johonkanen/efinix_soc_board/README.md

# efinix_soc_board

Linux-capable control card for an AC in/out lab power supply, based on the **Efinix Titanium Ti135N484I3** FPGA. The
FPGA's hardened quad-core RISC-V runs Linux, with 1 GB LPDDR4, Gigabit Ethernet and eMMC. The card plugs into the
power supply baseboard ([ac_psu_kicad](https://github.com/johonkanen/ac_psu_kicad)) in place of the earlier Ti60F225
and Agilex 5 cards.

Status: schematic in progress. See **[STATUS.md](STATUS.md)** for where the work stands and what comes next.

| | |
|---|---|
| [MIGRATION_PLAN.md](MIGRATION_PLAN.md) | plan and decisions |
| [TI135_PCB_NOTES.md](TI135_PCB_NOTES.md) | Ti135 PCB design rules (banks, sequencing, configuration, LPDDR4) |
| [MECHANICAL.md](MECHANICAL.md) | outline and baseboard connector positions |
| [POWER_BUDGET.md](POWER_BUDGET.md) | power estimate and regulators |

The KiCad 10 project in `kicad/` is generated by scripts (`tools/build_schematic.sh`), using
[proteus2kicad](https://github.com/johonkanen/proteus2kicad) as a submodule in `tools/p2k`.

## Board

<!-- board-plots:start -->
<!-- Generated by kicad-board-plots; edits between these markers are overwritten. -->

3D renders and copper layers of `kicad/ti135_card.kicad_pcb`, the layers in stack order without silkscreen. Plotted by [kicad-board-plots](https://github.com/johonkanen/kicad-board-plots) on each board change; the images live on the `renders` branch.

<table>
<tr>
<td align="center"><br><b>3D, top</b></td>
<td align="center"><br><b>3D, bottom (seen from below)</b></td>
</tr>
<tr>
<td align="center"><br><b>F.Cu: signal (top)</b></td>
<td align="center"><br><b>In1.Cu: GND plane</b></td>
</tr>
<tr>
<td align="center"><br><b>In2.Cu: signal, phy_avdd33 pour</b></td>
<td align="center"><br><b>In3.Cu: 1V1, VCORE, 3V3, GND planes</b></td>
</tr>
<tr>
<td align="center"><br><b>In4.Cu: 1V8, 0V85 planes</b></td>
<td align="center"><br><b>In5.Cu: signal</b></td>
</tr>
<tr>
<td align="center"><br><b>In6.Cu: GND plane</b></td>
<td align="center"><br><b>B.Cu: signal, 1V1, GND, Net-(U201-SW), 5V0, 1V8 and 9 more pours (bottom, seen from the top)</b></td>
</tr>
</table>

<!-- board-plots:end -->
