johonkanen/efinix_soc_board/NEXT_SESSION.md

# Next session plan (phases, 2026-10-27; phases 1–3 done)

**2026-11-01:** placement was since copied from the Agilex card and the planes reshaped; the current open list is
in `STATUS.md`, "Where we left off (2026-11-01)". The phase plan below predates that.

Written for an agent starting with a fresh context. Work **one phase at a time**: finish it, commit, push, update
this file and `STATUS.md`, then stop and report to the user, who reviews each phase before the next starts.

## Read first

- `STATUS.md`: what the card is, where everything stands, how to build.
- `HW_CHECKLIST_REVIEW.md`: Efinix's hardware checklist for this exact part (Ti135 N484, SPI x4) against the card.
- `TI135_PCB_NOTES.md`: device and layout rules (§6 LPDDR4: §6.3 routing rules, §6.5 stack-up, §6.7 BGA fan-out
  and decaps, §6.10 the 40 Ω routing and width fit).
- `KRT_LEARNING.md`: how to drive KiCadRoutingTools, its gotchas and possible bugs. Read before any routing.

## Rules (from the user; do not break)

- **Never modify `~/dev/agilex3_soc_control_card`** (another session owns it). Reading is fine. `tools/board_setup.py`
  copies the LPDDR4 rules from it; that is intended.
- **KiCad must be closed** before writing any file under `kicad/`. Check for `kicad/~ti135_card.kicad_pro.lck` and
  for board/schematic files newer than the last commit; if either, stop and ask.
- The user now edits the schematic **by hand** in KiCad: do NOT run `tools/build_schematic.sh` (it would overwrite
  the hand edits).
  A footprint change reaches the board with `tools/swap_footprint.py` (keeps nets, fields, schematic link).
- Efinix files (copyright) live in `reference/efinix/` (gitignored; only its README is in git).
- No silkscreen on this card beyond a few custom markings: ignore silkscreen DRC.
- Commit trailer (always):
  ```
  Co-Authored-By: Claude Opus 5.5 <noreply@anthropic.com>
  ```
  Push with plain `git push`. Ask the user before anything outward beyond that (orders, upstream bug reports).
- Keep `STATUS.md` and this file current at every stopping point.

## Decisions taken (user, 2026-10-27)

1. **LPDDR4 acceptance = the checklist's skew limits** (HW_CHECKLIST_REVIEW.md item 6): DQ/DM–DQS ≤ 75 ps,
   CK–DQS ≤ 350 ps, A/CKE/CS–CK ≤ 100 ps, die to die (package delays included). DQS P/N skew: aim ≤ 1.8 ps
   (user guide), report what is reached. Base: the routing on branch **`ddr-option2`** (DQ–DQS −24…+60 ps).
2. **U801 stays where it is.**
3. **Decoupling follows Efinix's table in full** (HW_CHECKLIST_REVIEW.md, "Decoupling").
4. One phase at a time, the user reviews each. The user may route parts of the memory by hand later.

## Tools (all in the repo)

| Task | Command |
|---|---|
| Build schematic / PCB checks | `tools/build_schematic.sh`; `tools/build_pcb.sh` (no `--rebuild`: that drops routing) |
| KiCad Python / CLI | `tools/p2k/bin/kipy script.py`; `tools/p2k/bin/kicad-cli`; `source tools/p2k/bin/kicad_env.sh` for `$KICAD_MOUNT` |
| KRT (router) | `~/dev/KiCadRoutingTools/.venv/bin/python -X utf8 ~/dev/KiCadRoutingTools/py_router/route.py ...`; always `KICAD_RIP_PREEXISTING=0` |
| DDR grade (refill, DRC, per-byte) | `tools/ddr/grade.sh NAME BOARD` → `work/grade/NAME/drc.rpt` |
| DDR timing / plan | `tools/p2k/bin/kipy tools/ddr/ddr_timing.py BOARD [--nets] [--plan FILE]` |
| Width fit, clearance repair | `tools/p2k/bin/kipy tools/ddr/widen.py IN OUT [--why]` (also nudges, splits at courtyards) |
| Meander top-up | `tools/ddr/polish.sh IN OUT` (`ONLY="ddr_dq9 ..."`); `tools/ddr/tune_meander.py` + `tune_apply.py` |
| Re-route a few DDR nets | `tools/ddr/reroute_nets.sh IN WORKDIR dq9 dm1` (`PAIR=1` for DQS pairs, `EXTRA="--rip-existing-nets ..."`) |
| Re-route bytes | `tools/ddr/byte_seq.sh` (`MODE=net NET_ORDER=far RIP_BYTES=..`); CA/CK: `tools/ddr/ca_tb_chain.sh` |
| Decaps on BGA via pairs | `tools/p2k/bin/kipy tools/place_bga_decaps.py IN OUT REF...` (smallest caps first) |
| Nearest free B.Cu spot | `tools/p2k/bin/kipy tools/place_free.py IN OUT REF[@X,Y[,ROT]]...` (bare REF: near its rail's U501 balls; used in phase 3) |
| Schematic → routed board | `tools/p2k/bin/kipy tools/add_parts.py IN OUT` (adds missing parts, syncs values/fields/pad nets; no copper touched) |
| Pictures | `tools/render_ddr.py BOARD OUT.png U501 U801`; `tools/render_board.py BOARD OUT.png` (KRT venv python) |
| IO routing sketch | `tools/io_sketch.sh IN WORKDIR` |
| Zone refill | `tools/p2k/bin/kipy work/grade/<any>/refill.py BOARD` (written by grade.sh) |
| JLC parts | `python3 -I tools/jlc/jlc_search.py "<keywords>"` |

Work on copies under `work/` (gitignored) and copy the result into `kicad/` only when it grades clean. DRC with
schematic parity must run on the board **in `kicad/`** (a copy elsewhere has no sub-sheets).

## Phase 1: LPDDR4 from `ddr-option2` onto main — **done 2026-10-27**

Result (on main, `kicad/ti135_card.kicad_pcb`):
- `tools/ddr/transplant.py` replaced main's LPDDR4 copper (2684 items, 139 vias) with option 2's (3569, 148 vias).
  Only clash: C528 (1 µF 0402, 0V85, B.Cu) sat on a `ddr_dq2` via; `place_bga_decaps.py C528` moved it 0.3 mm
  (+x). Nothing else changed outside the DDR copper (footprints, non-DDR tracks/vias, zones compared by script).
- `widen.py` changed nothing (option 2 was already fitted): **88 mm below the width minimum**, per net dq25 18.9,
  dm3 17.3, dq1 16.0, dq24 12.9, dm0 8.3, dq26 6.9, dm1 3.2, dq29 2.1, dq6 1.6, dq10 0.6 (KiCad: 199 `track_width`,
  capped; all `min`; one is dm3 below the 0.09 neck-down inside a BGA).
- DRC (`tools/build_pcb.sh`): schematic parity 0; non-DDR entries identical to main before the change; all DDR
  nets connected (615 unconnected items board-wide, same as before, all unrouted non-DDR). DDR: 4
  `skew_out_of_range` (DQS0/1/3, CK P/N), 2 `diff_pair_uncoupled_length_too_long` (DQS0 19.1 mm vs 12), 199
  `track_width`, 499 crosstalk-spacing warnings (`lpddr_xtalk_*`, warnings only), 1 `via_dangling` warning on
  ddr_ca5 (already on main).
- Timing (`ddr_timing.py --nets`, die to die): DQ/DM–DQS byte 0 +13.5…+57.1, byte 1 −23.9…+55.8, byte 2
  +7.2…+44.8, byte 3 +10.9…+60.4 ps (≤ 75 ✓); CK–DQS max 86 ps (DQS 338.9/226.6/240.3/194.3, CK 252.6; ≤ 350 ✓);
  CA/CKE/CS–CK −57.1…+47.0 ps (≤ 100 ✓). P/N skew: DQS 4.47 / 6.64 / 0.07 / 5.61 ps, CK 3.67 ps (phase 2).
  KiCad's own readout (`kicad_delays.sh`) agrees with the path model as before (0…+28 ps, shared CA nets more).
- Layers per byte: B0 In2 81 %, B1 F 39 % / In2 38 %, B2 In5 75 %, B3 B.Cu 76 %, CA In5 51 %.
- Gotcha: `widen.py` (and anything reading net classes through pcbnew) needs the `.kicad_pro`/`.kicad_dru` copied
  beside the board under `work/`; without them DQS is taken as single-ended and widened to 0.18 mm.

The original plan, for reference:

Main has newer placement (analog section, level shifters, 0201 decaps on via pairs under U501, hand moves) but
the older, untuned LPDDR4. `ddr-option2` has the better LPDDR4 on the older placement. Same U501/U801 poses.
This comes before the decoupling work because byte 3 runs on B.Cu under U501, where more decaps will go.

1. Write `tools/ddr/transplant.py IN_MAIN FROM_BOARD OUT`: remove every track and via of the LPDDR4 nets
   (`ddr_` in the name, not `DDR_CAL`) from main, copy those of the other board in (same net names, layers,
   widths), keep everything else. pcbnew SWIG: remove last (KRT_LEARNING.md).
2. Grade it (`tools/ddr/grade.sh`). Expect clashes where main's new parts sit on option-2 copper. The most likely
   are the 0201/0402 decaps under U501 (B.Cu, byte 3 runs there). Fix by moving the caps
   (`tools/place_bga_decaps.py` re-placement, or a nudge), not the DDR copper, where possible.
3. `tools/ddr/widen.py` (fit + clearance repair), `tools/pad_to_die.py`, grade, `ddr_timing.py --nets`.

Done when: all DDR nets connected; no DDR DRC errors except the known `skew_out_of_range` /
`diff_pair_uncoupled` on DQS/CK pairs and `track_width` (listed with mm per net); timing within decision 1
(report the numbers); rest of the board unchanged (DRC parity clean, no new non-DDR errors). Commit on main.

## Phase 2: LPDDR4 clean-up on main — **done 2026-10-27**

Result (on main, `kicad/ti135_card.kicad_pcb`; work in `work/p2/`, the chain b0a → t01 → e2 → f1 → pol1 → pol2b → g2 →
k2 → m1 → p_dqs0a → fin):
- **Width: 0 mm below the minimum** (`widen.py`), no `track_width` DRC error. Re-routed at width with
  `reroute_nets.sh` (`--escalation off`): byte 0 dq1/dq6/dm0 (byte mates *not* rippable), byte 1 dm1/dq10, byte 3
  dq24/25/26/29/dm3 (`CL=0.1`, byte 3 DQ/DM rippable, DQS3 not), then dq31 (left ripped by that step; `CL=0.1
  --grid-step 0.025`), dm0 again with In2 preferred (`--layer-costs 5 -1 1 -1 -1 5 -1 5`), dq10 again (a plain
  re-run: +5 ps instead of +65), DQS0 as a pair (`PAIR=1`). Meanders (`tune_meander.py`, hand-written plan, amp 0.5 /
  spacing 1.5) on dm0 and dq1. One 0.0889 mm piece of dqs0_P inside U801 set to the 0.09 neck-down minimum by hand.
- DRC (`tools/build_pcb.sh`): schematic parity 0; no DDR net open; non-DDR tracks/vias, footprints and zones
  identical to the phase 1 commit (script compare). DDR errors left: 3 `skew_out_of_range` (DQS1, DQS3, CK P/N),
  1 `diff_pair_uncoupled_length_too_long` (DQS1 12.27 mm vs 12), 395 crosstalk-spacing warnings, 1 `via_dangling`
  warning (ddr_ca5, as before). 499 unconnected items, all non-DDR (KiCad's report cap).
- Timing, die to die (decision 1), path model (`ddr_timing.py --nets`) / KiCad readout (`kicad_delays.sh`):

  | | path model | KiCad | limit |
  |---|---|---|---|
  | DQ/DM–DQS byte 0 | −9.7 … +64.8 | −15.6 … +51.4 | ±75 ✓ |
  | byte 1 | −23.9 … +55.8 | −7.7 … +73.8 (dq13, untouched) | ±75 ✓ |
  | byte 2 | +7.2 … +44.8 | +3.3 … +38.1 | ±75 ✓ |
  | byte 3 | +4.9 … +71.0 (dq24) | −9.4 … +57.5 | ±75 ✓ |
  | CK–DQS | ≤ 78.7 | ≤ 71 | ≤ 350 ✓ |
  | CA/CKE/CS–CK | −57.1 … +47.0 (unchanged) | | ±100 ✓ |
  | DQS P/N skew 0/1/2/3 | 0.53 / 6.64 / 0.07 / 5.61 | 0.01 / 3.37 / 0.38 / 5.82 | aim 1.8 |
  | CK P/N skew | 3.67 | 5.94 | aim 0.9 |

- **DQS1, DQS3 and CK skew not reached:** no straight run with room for a meander on the short legs (all
  amplitudes 0.35–1.0), and `PAIR=1` re-routes of DQS1/DQS3 failed to route (old copper kept). CK is
  trunk-and-branch (phase 4 re-routes it).
- **Cost: bytes 0 and 3 are less on one layer.** B0 In2 81 → 55 %, B3 B.Cu 76 → 31 % (F 37 %, In2 29 %): at the
  0.25 mm outer width B.Cu between U501's decaps has no room, so byte 3 moved to F/In2. Total DDR 1612 mm, 145 vias.
- Lessons: making the byte mates rippable re-routes them shorter (byte 0 down to −95 ps); keep them fixed. Preferring
  the byte's own inner layer gave dm0 a longer, matchable path. KRT is not deterministic: run 3+ variants per step.

The plan, for reference:

- Width: 88 mm below the minimum (`widen.py --why` lists it; per net in phase 1 above). Re-route those nets at width
  (`reroute_nets.sh`, `--escalation off`, allow ripping their byte's other nets), then re-check timing.
- DQS P/N skew (4.5 / 6.6 / 0.07 / 5.6 ps on option 2): try `polish.sh` with `ONLY` on the DQS legs, or a
  `reroute_nets.sh PAIR=1`; accept and report what remains if the room is not there.
- Keep decision 1 satisfied after every step (`ddr_timing.py --nets`).

Done when: no `track_width` DDR errors; timing within decision 1; DQS skews reported.

## Phase 3: checklist fixes (HW_CHECKLIST_REVIEW.md "To act on") — **done 2026-10-27**

Result (on main; schematic in the commit before, board in this one; work in `work/p3b/`, chain base → a1 → b2 → b3 →
b4 → … → b7):
- **Schematic** (all four items): R801 240R **0.1 %** (RT0402BRD07240RL, C852660); SSU_N `fpga_ssu_n` (U501 L4) →
  R622 10 k to 1V8; Efinix's decoupling table in full, **C5001–C5073** on sheet 05 (now A2; C501–C565 kept); a 47u per
  TLV62585 cell (C204 / C304 are table 47u's placed at the regulator, C314 / C333 / C344 new) and a **22p
  feed-forward across R1 on all five cells** (C205 / C305 / C315 / C334 / C345; data sheet SLVSDE5F §8.2.2.5: > 47 µF
  output needs one; user decision). Candidate parts in the old "Where it stopped" notes: 47u C16780, 100u C15008,
  10n C272853, 1n C505464, 22p C1555 (fields not set; BOM pass). `build_schematic.sh` now also fails on a duplicate
  reference.
- **Board:** `tools/add_parts.py` added the 84 parts (and synced R801's value/fields and U501.L4's net) without
  touching copper; all 84 are on B.Cu:
  - **0201 on rail/GND via pairs** (`place_bga_decaps.py`, 14): VCORE 10 (7 × 10n, 3 × 1n), 1V1 3 × 10n, 0V85 10n.
    Only rails with free pairs go in (1V8's 5 pairs were all taken; VCCA/VDDPLL/3V3 have none), and **C5053 (0V85)
    first**: after the VCORE caps its 17 pairs were all blocked by courtyards. Parts given to the script that find no
    pair go back to the staging point and block later spots (the a3 failure).
  - **Nearest free spot** (`place_free.py`, bare refs, smallest first): the other 26 0201s (1V8 0.2–2.5 mm from a
    1V8 ball; VCCA_BR 1.1–2.1, VCCA_TR 2.1–3.0, VDDPLL 2.3–2.8, **VCCA_BL 4.9–6.3 mm**: its one ball, R8, sits
    among the caps already under U501, the nearest free spots are north of it at y 72–75); the 20 0402s (1.0–3.7 mm); the 13 bulk 0805/1206 (3.5–6.5 mm, round the BGA's east, west and south
    edges).
  - Regulator cells (`place_free.py REF@x,y`): 22p 1.0–1.2 mm from each R1; 47u C314 / C344 in their cell's 22u row,
    C304 2.7 mm, C204 3.7 mm, C333 3.8 mm from the row (no room in line).
  - R622 4.6 mm from L4 (B.Cu, the nearest free spot).
- **Check:** `grade.sh` identical to phase 2 (0 DDR opens, 3 `skew_out_of_range`, 1 `diff_pair_uncoupled`, 395
  crosstalk warnings, 1612 mm / 145 vias, same layers per byte); 0 non-DDR errors. Tracks, vias and zone outlines
  identical to phase 2, no existing footprint moved (script compare). `build_pcb.sh`: **schematic parity 0**, the same
  DRC types and counts as phase 2 (395 clearance warnings, 3 skew, 1 uncoupled, 122 `via_dangling`, 1
  `lib_footprint_mismatch`, 499 unconnected = KiCad's cap). pcbnew's own count: **unconnected 615 → 734** (+119:
  the new caps, not yet tied to their rails; phase 5). ERC: the two known notes.
- The board in kicad/ is saved with the zones refilled (the grade copy).

To look at in KiCad: the VCCA_BL caps (C5060–C5063, 5–6 mm off), C204/C333 off their cell's row, the bulk caps at
the BGA's edges.

### The plan, for reference

1. **DDR_CAL**: R801 240 Ω **0.1 %** (sheet 08 generator; find an LCSC part with `jlc_search.py`).
2. **SSU_N** (U501 L4): 10 k pull-up to 1V8 (sheet 06 generator; net from the ball).
3. **Decoupling** to Efinix's table, per rail (the "Missing" column): add the 10 nF and 1 nF parts as 0201, the
   rest at the sizes in use (1 µF/4.7 µF 0402, 10 µF+ 0805 or larger). Generators: `tools/sheets/05_fpga_power.py`
   (`ROWS`; `C0201` exists in `_common.py`). Then rebuild the schematic and add the new parts to the board without
   `--rebuild` (that drops routing): build each new footprint the way `tools/make_board.py` does (library
   footprint, fields, schematic path, pad nets), or ask the user to run KiCad's "Update PCB from Schematic".
   Place them: 0201s on rail/GND via pairs under U501 (`place_bga_decaps.py`, smallest first), bulk at the BGA
   edge on B.Cu.
4. **47 µF at each regulator output** (the five TLV62585 cells): in the regulator sheet generators, placed in the
   cells on B.Cu next to the existing output caps; check the TLV62585 data sheet's output-capacitance limit first.

Done when: each item in HW_CHECKLIST_REVIEW.md "To act on" 1–4 is done or explained there; ERC as before
(two known notes); DRC parity clean; LPDDR4 untouched (grade.sh: same result as after phase 2).

## Phase 4: CK/CA/CKE/CS on one layer (checklist)

Today the CA trunk runs over In5/In2/F. Re-route CK/CA as trunk-and-branch on one layer (`ca_tb_chain.sh` with
`--layers` restricted; the T vias stay in U801's free columns), then match CA–CK within 100 ps (decision 1).
The bytes stay. Try a few runs (KRT is not deterministic) and keep the best.

Done when: ≥ 90 % of CA/CK copper on one layer, CA–CK within ±100 ps, CK P/N skew reported, no new DRC errors.

## Phase 5: rest of the routing

Starting point: `tools/io_sketch.sh` (185/198 nets in the sketch on branch `io-sketch`). Make it real:
eMMC (length-matched to its CLK), QSPI flash, RGMII (TX series resistors at the FPGA, RX at the PHY), MDI pairs to
J9 (100 Ω), 3V3 / 3V3_analog power, everything else. Then fix every hole-clearance hit and dangling stub.

Done when: 0 unconnected items (planes refilled), no DRC errors, LPDDR4 unchanged.

## Phase 6: return paths and stitching

- GND return vias within ±250 mil of every DDR layer change (DDR user guide); GND stitching around the board edge
  and between the planes; F/B GND pours where free.
- Check the ≥ 100 mil distance from the 0V85/1V1 switch nodes (B.Cu cells) to DDR traces (Efinix).

Done when: those checks are scripted and pass; DRC clean.

## Phase 7: review and fab outputs (user decides on ordering)

`/review-routed-board` skill; a last pass over HW_CHECKLIST_REVIEW.md; Gerbers, BOM and CPL with `tools/jlc`
(`fab_outputs.sh`), stock check for 5–10 boards. Do not order: hand the files to the user.

## Reference material

- Efinix dev boards imported to KiCad (`reference/efinix/devboards/`): Ti375 C529 is the closest (0.8 mm FPGA,
  one x32 LPDDR4 of the same package). Its plan: two bytes per inner layer, CA/CK alone on a third inner layer,
  big meanders in an open band between the parts (`tools/render_ddr.py ... U20 U23`).
- Branches: `ddr-option2` (LPDDR4 candidate), `io-sketch` (IO sketch); tag `ddr40-before-reroute` (the LPDDR4
  before option 2).

## Handing over to the next phase

At the end of each phase the agent's report ends with **the prompt for the next phase**, in a code block, ready for
the user to paste into a fresh session. Keep it in the same form as the one below (update the phase number, the
files to read and any decision the user made in the review), and replace the block here at the same time.

Next prompt (phase 4):

```
Read NEXT_SESSION.md, then the files it lists under "Read first"
(STATUS.md, HW_CHECKLIST_REVIEW.md, TI135_PCB_NOTES.md §6.3 and §6.10, KRT_LEARNING.md).

Do Phase 4 (CK/CA/CKE/CS on one layer) and its "done when" check.
Phase 3 is done: the board in kicad/ is the phase 2 LPDDR4 plus the 84 new parts
(placed on B.Cu, not yet routed to their rails). The data bytes stay as they are;
grade.sh's per-byte result must not change.
- Follow the "Rules" section strictly: never modify ~/dev/agilex3_soc_control_card;
  check that KiCad is closed (no kicad/~ti135_card.kicad_pro.lck) before writing under
  kicad/; schematics only through tools/sheets/*.py; work on copies under work/ and
  copy into kicad/ only when it grades clean.
- Use the existing tools from the "Tools" table before writing new ones.
- If a step needs a decision that NEXT_SESSION.md does not cover, stop and ask me
  instead of guessing.

When the phase is done (or blocked): commit with the trailer from the file, git push,
update NEXT_SESSION.md and STATUS.md, then stop and report:
- what was done, with the numbers from the "done when" check (DRC, timing),
- anything that did not meet the check and why,
- anything you want me to decide or review in KiCad,
- the prompt for the next phase (see "Handing over to the next phase").
```
