johonkanen/efinix_soc_board/reference/ti135n484_pinout.csv

ball | pad | bank
H10 | CDONE
G10 | CRESET_N
AB15 | DDR_A[0]
AA15 | DDR_A[1]
AA14 | DDR_A[2]
Y14 | DDR_A[3]
W14 | DDR_A[4]
W13 | DDR_A[5]
Y9 | DDR_CAL
AB13 | DDR_CK
AA13 | DDR_CK_N
AB11 | DDR_CKE[0]
AA10 | DDR_CKE[1]
AB9 | DDR_CS_N[0]
AA9 | DDR_CS_N[1]
AA8 | DDR_CS_N[2]
AA7 | DDR_CS_N[3]
W3 | DDR_DM[0]
AA3 | DDR_DM[1]
W18 | DDR_DM[2]
Y20 | DDR_DM[3]
U3 | DDR_DQ[0]
U2 | DDR_DQ[1]
U1 | DDR_DQ[2]
V3 | DDR_DQ[3]
Y2 | DDR_DQ[4]
AA1 | DDR_DQ[5]
AB2 | DDR_DQ[6]
AA2 | DDR_DQ[7]
U4 | DDR_DQ[8]
V5 | DDR_DQ[9]
W5 | DDR_DQ[10]
W4 | DDR_DQ[11]
AA5 | DDR_DQ[12]
AB5 | DDR_DQ[13]
AA6 | DDR_DQ[14]
AB7 | DDR_DQ[15]
AA16 | DDR_DQ[16]
Y16 | DDR_DQ[17]
AA17 | DDR_DQ[18]
AB17 | DDR_DQ[19]
V18 | DDR_DQ[20]
V17 | DDR_DQ[21]
V16 | DDR_DQ[22]
W16 | DDR_DQ[23]
AB19 | DDR_DQ[24]
AB21 | DDR_DQ[25]
AA20 | DDR_DQ[26]
AA19 | DDR_DQ[27]
W22 | DDR_DQ[28]
W21 | DDR_DQ[29]
W19 | DDR_DQ[30]
W20 | DDR_DQ[31]
W2 | DDR_DQS[0]
Y4 | DDR_DQS[1]
Y18 | DDR_DQS[2]
AA21 | DDR_DQS[3]
W1 | DDR_DQS_N[0]
AA4 | DDR_DQS_N[1]
AA18 | DDR_DQS_N[2]
AA22 | DDR_DQS_N[3]
AA12 | DDR_RST_N
A1 | GND
A4 | GND
A6 | GND
A8 | GND
A10 | GND
A12 | GND
A14 | GND
A16 | GND
A18 | GND
A20 | GND
A22 | GND
AB1 | GND
AB4 | GND
AB6 | GND
AB8 | GND
AB10 | GND
AB12 | GND
AB14 | GND
AB16 | GND
AB18 | GND
AB20 | GND
AB22 | GND
B3 | GND
B4 | GND
B6 | GND
B8 | GND
B10 | GND
B12 | GND
B14 | GND
B16 | GND
B18 | GND
B20 | GND
C3 | GND
C5 | GND
C7 | GND
C9 | GND
C11 | GND
C13 | GND
C15 | GND
C17 | GND
C19 | GND
C20 | GND
D1 | GND
D3 | GND
D20 | GND
D22 | GND
E3 | GND
E4 | GND
E5 | GND
E6 | GND
E7 | GND
E8 | GND
E9 | GND
E10 | GND
E12 | GND
E14 | GND
E16 | GND
E18 | GND
E19 | GND
F19 | GND
G1 | GND
G12 | GND
G14 | GND
G16 | GND
G18 | GND
G19 | GND
G21 | GND
H13 | GND
H15 | GND
H17 | GND
H18 | GND
J2 | GND
J10 | GND
J12 | GND
J14 | GND
J22 | GND
K8 | GND
K9 | GND
K11 | GND
K13 | GND
K15 | GND
K20 | GND
L10 | GND
L12 | GND
L14 | GND
M1 | GND
M9 | GND
M11 | GND
M13 | GND
M15 | GND
N10 | GND
N12 | GND
N14 | GND
P7 | GND
P9 | GND
P11 | GND
P13 | GND
P15 | GND
P22 | GND
R5 | GND
R10 | GND
R12 | GND
R14 | GND
R20 | GND
T1 | GND
T3 | GND
T7 | GND
T9 | GND
T11 | GND
T13 | GND
T15 | GND
T18 | GND
U17 | GND
U21 | GND
V2 | GND
V4 | GND
V6 | GND
V8 | GND
V10 | GND
V12 | GND
V14 | GND
V19 | GND
V22 | GND
Y1 | GND
Y5 | GND
Y7 | GND
Y13 | GND
Y15 | GND
Y17 | GND
Y19 | GND
Y21 | GND
P6 | GPIOB_N_00 | 4B
R2 | GPIOB_N_03 | 4B
P1 | GPIOB_N_04 | 4B
P3 | GPIOB_N_05 | 4B
M2 | GPIOB_N_06_CDI18 | 4B
T6 | GPIOB_N_07_CDI16 | 4B
K3 | GPIOB_N_08 | 4B
M5 | GPIOB_N_09 | 4B
N5 | GPIOB_N_11_CDI14 | 4B
N2 | GPIOB_N_12_CDI12 | 4B
L1 | GPIOB_N_13_CLK0_N | 4B
R4 | GPIOB_N_14_CLK1_N | 4B
M3 | GPIOB_N_15_CDI10_CLK2_N | 4B
J3 | GPIOB_N_16_CDI8_CLK3_N | 4B
L7 | GPIOB_N_17_TEST_N_CLK4_N | 4A
H2 | GPIOB_N_18_CLK5_N | 4A
J1 | GPIOB_N_19_CBSEL0 | 4A
L4 | GPIOB_N_20_SSU_N_CLK6_N | 4A
B1 | GPIOB_N_21_CLK7_N | 4A
F1 | GPIOB_N_22 | 4A
D2 | GPIOB_N_23_CDI6 | 4A
F2 | GPIOB_N_24_CDI4 | 4A
C1 | GPIOB_N_25_SSL_N | 4A
G3 | GPIOB_N_26_CDI2 | 4A
J4 | GPIOB_N_27_CDI0_CLK10_N | 4A
A2 | GPIOB_N_28_CSI_CLK11_N | 4A
N7 | GPIOB_P_00_PLLIN0 | 4B
R3 | GPIOB_P_03_PLLIN0 | 4B
N1 | GPIOB_P_04_EXTFB | 4B
P4 | GPIOB_P_05 | 4B
L2 | GPIOB_P_06_CDI19_PLLIN0 | 4B
R6 | GPIOB_P_07_CDI17_EXTFB | 4B
K2 | GPIOB_P_08 | 4B
L5 | GPIOB_P_09 | 4B
N6 | GPIOB_P_11_CDI15 | 4B
N3 | GPIOB_P_12_CDI13 | 4B
K1 | GPIOB_P_13_CLK0_P | 4B
P5 | GPIOB_P_14_CLK1_P | 4B
M4 | GPIOB_P_15_CDI11_CLK2_P | 4B
H3 | GPIOB_P_16_CDI9_CLK3_P | 4B
L6 | GPIOB_P_17_NSTATUS_CLK4_P | 4A
G2 | GPIOB_P_18_CLK5_P | 4A
H1 | GPIOB_P_19_CBSEL1 | 4A
K4 | GPIOB_P_20_EXTSPICLK_CLK6_P | 4A
B2 | GPIOB_P_21_CLK7_P | 4A
E1 | GPIOB_P_22_EXTFB | 4A
E2 | GPIOB_P_23_CDI7_PLLIN0 | 4A
F3 | GPIOB_P_24_CDI5_EXTFB | 4A
C2 | GPIOB_P_25_CDI3_PLLIN0 | 4A
G4 | GPIOB_P_26_CCK | 4A
J5 | GPIOB_P_27_CDI1_CLK10_P | 4A
A3 | GPIOB_P_28_CSO_CLK11_P | 4A
F4 | GPIOL_26_CLK24 | BL3
H6 | GPIOL_27_CLK25 | BL3
G6 | GPIOL_28 | BL3
H7 | GPIOL_31 | BL3
H9 | GPIOL_32_PLLIN1 | BL3
H8 | GPIOL_33 | BL3
F5 | GPIOL_34_PLLIN1 | BL3
M20 | GPIOR_78_PLLIN1 | TR1
N20 | GPIOR_79 | TR1
N21 | GPIOR_80_CLK12 | TR1
N22 | GPIOR_81_CLK13 | TR1
M22 | GPIOR_82 | TR1
L21 | GPIOR_83 | TR1
L22 | GPIOR_84 | TR1
M8 | GPIOR_127_CLK8 | BR0
K7 | GPIOR_128_CLK9 | BR0
K6 | GPIOR_129_PLLIN1 | BR0
L8 | GPIOR_130_PLLIN1 | BR0
J6 | GPIOR_131_PERST_Q0_N | BR0
H5 | GPIOR_132 | BR0
R16 | GPIOT_N_01_CLK27_N | 2A
N16 | GPIOT_N_02 | 2A
P18 | GPIOT_N_04_CLK31_N | 2A
P21 | GPIOT_N_17 | 2B
N18 | GPIOT_N_18 | 2B
M19 | GPIOT_N_19 | 2B
L17 | GPIOT_N_20 | 2B
R19 | GPIOT_N_21 | 2B
R18 | GPIOT_N_22_CLK16_N | 2B
T22 | GPIOT_N_23_CLK17_N | 2B
T21 | GPIOT_N_24_CLK18_N | 2B
R22 | GPIOT_N_25_CLK19_N | 2B
K18 | GPIOT_N_34 | 2C
K19 | GPIOT_N_35 | 2C
L20 | GPIOT_N_37_CDI22 | 2C
K17 | GPIOT_N_39_CLK15_N | 2C
T16 | GPIOT_P_00_CLK26_P | 2A
T17 | GPIOT_P_01_CLK27_P | 2A
N17 | GPIOT_P_02 | 2A
R17 | GPIOT_P_04_CLK31_P | 2A
P20 | GPIOT_P_17 | 2B
P19 | GPIOT_P_18 | 2B
M18 | GPIOT_P_19_EXTFB | 2B
M17 | GPIOT_P_20_PLLIN0 | 2B
T20 | GPIOT_P_21 | 2B
T19 | GPIOT_P_22_CLK16_P | 2B
U22 | GPIOT_P_23_CLK17_P | 2B
U20 | GPIOT_P_24_CLK18_P | 2B
R21 | GPIOT_P_25_CLK19_P | 2B
J17 | GPIOT_P_34_PLLIN0 | 2C
J19 | GPIOT_P_35 | 2C
L19 | GPIOT_P_37_CDI23_PLLIN0 | 2C
K16 | GPIOT_P_39_CLK15_P | 2C
H11 | JTAG_VCCIO_SEL
K21 | MIPI1_RXDN0
J20 | MIPI1_RXDN1
H20 | MIPI1_RXDN2
G22 | MIPI1_RXDN3
F20 | MIPI1_RXDN4
K22 | MIPI1_RXDP0
J21 | MIPI1_RXDP1
H21 | MIPI1_RXDP2
H22 | MIPI1_RXDP3
G20 | MIPI1_RXDP4
F21 | MIPI1_TXDN0
E21 | MIPI1_TXDN1
C21 | MIPI1_TXDN2
B22 | MIPI1_TXDN3
A21 | MIPI1_TXDN4
F22 | MIPI1_TXDP0
E22 | MIPI1_TXDP1
D21 | MIPI1_TXDP2
C22 | MIPI1_TXDP3
B21 | MIPI1_TXDP4
AA11 | NC
Y11 | NC
G13 | Q0_CAL_RES
F11 | Q0_REFCLK0_N
E11 | Q0_REFCLK0_P
F13 | Q0_REFCLK1_N
E13 | Q0_REFCLK1_P
B5 | Q0_RXDN0
B7 | Q0_RXDN1
B9 | Q0_RXDN2
B11 | Q0_RXDN3
A5 | Q0_RXDP0
A7 | Q0_RXDP1
A9 | Q0_RXDP2
A11 | Q0_RXDP3
D4 | Q0_TXDN0
D6 | Q0_TXDN1
D8 | Q0_TXDN2
D10 | Q0_TXDN3
C4 | Q0_TXDP0
C6 | Q0_TXDP1
C8 | Q0_TXDP2
C10 | Q0_TXDP3
G17 | Q1_CAL_RES
F15 | Q1_REFCLK0_N
E15 | Q1_REFCLK0_P
F17 | Q1_REFCLK1_N
E17 | Q1_REFCLK1_P
B13 | Q1_RXDN0
B15 | Q1_RXDN1
B17 | Q1_RXDN2
B19 | Q1_RXDN3
A13 | Q1_RXDP0
A15 | Q1_RXDP1
A17 | Q1_RXDP2
A19 | Q1_RXDP3
D12 | Q1_TXDN0
D14 | Q1_TXDN1
D16 | Q1_TXDN2
D18 | Q1_TXDN3
C12 | Q1_TXDP0
C14 | Q1_TXDP1
C16 | Q1_TXDP2
C18 | Q1_TXDP3
P16 | REF_RES_2A
L16 | REF_RES_2C
G5 | REF_RES_4A
M7 | REF_RES_4B
F8 | TCK
G9 | TDI
F6 | TDO
F7 | TMS
H12 | VCC
H14 | VCC
H16 | VCC
J9 | VCC
J11 | VCC
J13 | VCC
J15 | VCC
K10 | VCC
K12 | VCC
K14 | VCC
L9 | VCC
L11 | VCC
L13 | VCC
L15 | VCC
M10 | VCC
M12 | VCC
M14 | VCC
N9 | VCC
N11 | VCC
N13 | VCC
N15 | VCC
P10 | VCC
P12 | VCC
P14 | VCC
R9 | VCC
R11 | VCC
R13 | VCC
R15 | VCC
T10 | VCC
T12 | VCC
T14 | VCC
H19 | VCC18A_MIPI1_RX
E20 | VCC18A_MIPI1_TX
G11 | VCC_SERDES01
G15 | VCC_SERDES01
R8 | VCCA_BL
G8 | VCCA_BR
J16 | VCCA_TR
J8 | VCCAUX
M16 | VCCAUX
N8 | VCCAUX
U16 | VCCAUX
P17 | VCCIO2A
L18 | VCCIO2B
N19 | VCCIO2B
J18 | VCCIO2C
H4 | VCCIO4A
K5 | VCCIO4A
M6 | VCCIO4A
L3 | VCCIO4B
N4 | VCCIO4B
P2 | VCCIO4B
T4 | VCCIO4B
J7 | VCCIO33_BR0
G7 | VCCIO33_BR1_BL3
M21 | VCCIO33_TR1
U5 | VDD_PHY_DDR
U6 | VDD_PHY_DDR
U7 | VDD_PHY_DDR
U8 | VDD_PHY_DDR
U9 | VDD_PHY_DDR
U10 | VDD_PHY_DDR
U11 | VDD_PHY_DDR
U12 | VDD_PHY_DDR
U13 | VDD_PHY_DDR
U14 | VDD_PHY_DDR
U15 | VDD_PHY_DDR
V7 | VDD_PHY_DDR
V9 | VDD_PHY_DDR
V11 | VDD_PHY_DDR
V13 | VDD_PHY_DDR
P8 | VDD_SOC
R7 | VDD_SOC
T8 | VDD_SOC
D7 | VDDA_C_Q01
D9 | VDDA_C_Q01
D19 | VDDA_C_Q01
F18 | VDDA_C_Q01
D11 | VDDA_D_Q01
D13 | VDDA_D_Q01
D15 | VDDA_D_Q01
D17 | VDDA_D_Q01
F10 | VDDA_D_Q01
F12 | VDDA_D_Q01
F14 | VDDA_D_Q01
F16 | VDDA_D_Q01
D5 | VDDA_H_Q01
W11 | VDDPLL_MCB_TOP_PHY_DDR
W10 | VDDQ_CK_PHY_DDR
AB3 | VDDQ_PHY_DDR
R1 | VDDQ_PHY_DDR
T2 | VDDQ_PHY_DDR
T5 | VDDQ_PHY_DDR
U18 | VDDQ_PHY_DDR
U19 | VDDQ_PHY_DDR
V1 | VDDQ_PHY_DDR
V20 | VDDQ_PHY_DDR
V21 | VDDQ_PHY_DDR
W17 | VDDQ_PHY_DDR
Y3 | VDDQ_PHY_DDR
Y6 | VDDQ_PHY_DDR
Y8 | VDDQ_PHY_DDR
Y12 | VDDQ_PHY_DDR
Y22 | VDDQ_PHY_DDR
V15 | VDDQX_PHY_DDR
W6 | VDDQX_PHY_DDR
W7 | VDDQX_PHY_DDR
W8 | VDDQX_PHY_DDR
W9 | VDDQX_PHY_DDR
W12 | VDDQX_PHY_DDR
W15 | VDDQX_PHY_DDR
Y10 | VDDQX_PHY_DDR
F9 | VQPS
