johonkanen/efinix_soc_board/sim/lpddr4_si/results/results.csv

point | case | kind | net | rx | where | delay_ps | vmax_mV | vmin_mV | lim_lo_mV | lim_hi_mV | limits_ok | os_area_Vns | us_area_Vns | eh_mV | ew0_ps | vref_mV | ew_mask_ps | t_margin_ps | v_margin_mV | fdrv | fodt | modt | pdds | caodt | rate | w_in | w_out | diff_in | diff_out | corner | pkg | xt_layer | xt_w | xt_gap | part
r2800_typ_i0.18_o0.25 | r_dq4 | dq_read | ddr_dq4 | U2 | ball | 365.0 | 508.428589 | -126.45183700000001 | -300.0 | 1400.0000000000002 | True | 0.0 | 0.006820293584417097 | 345.5753612236979 | 153.99999999999997 | 196.82036839144928 | 106.0 | -111.85714285714286 | -108.27928555223757 | 40 | 60 | 60 | 40 | 40 | 2800.0 | 0.18 | 0.25 | 0.14/0.15 | 0.20/0.20 | typ | netlen |  |  |  | ra
r2800_typ_i0.18_o0.25 | r_dq4 | dq_read | ddr_dq4 | U2 | die | 497.00000000000006 | 472.823256 | -59.003361 | -300.0 | 1400.0000000000002 | True | 0.0 | 0.0060084557016131255 | 398.9617315633351 | 342.0 | 191.50098967998005 | 302.0 | 84.14285714285714 | 239.6941127576528 | 40 | 60 | 60 | 40 | 40 | 2800.0 | 0.18 | 0.25 | 0.14/0.15 | 0.20/0.20 | typ | netlen |  |  |  | ra
r2800_typ_i0.18_o0.25 | r_dq6 | dq_read | ddr_dq6 | U4 | ball | 322.99999999999994 | 514.385462 | -87.10853990000001 | -300.0 | 1400.0000000000002 | True | 0.0 | 0.004183621278297588 | 311.85884671687626 | 188.0 | 226.5279474879754 | 153.99999999999997 | -63.85714285714287 | -78.11881145247462 | 40 | 60 | 60 | 40 | 40 | 2800.0 | 0.18 | 0.25 | 0.14/0.15 | 0.20/0.20 | typ | netlen |  |  |  | ra
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
