johonkanen/efinix_soc_board/sim/lpddr4_si/results/validate_drivers.md

| driver model | fixture | edge | V start / end, IBIS (mV) | V start / end, KiCad (mV) | t20-80, IBIS (ps) | t20-80, KiCad (ps) |
|---|---|---|---|---|---|---|
| lpddr4_ocd_40p_40n | 20.0 ohm to GND | rising | 0 / 371 | 0 / 370 | 50.0 | 52.0 |
| lpddr4_ocd_40p_40n | 20.0 ohm to GND | falling | 371 / 0 | 370 / 0 | 47.0 | 47.0 |
| lpddr4_ocd_48p_48n | 24.0 ohm to GND | rising | 0 / 373 | 0 / 373 | 55.0 | 58.0 |
| lpddr4_ocd_48p_48n | 24.0 ohm to GND | falling | 373 / 0 | 373 / 0 | 51.0 | 54.0 |
| PD40_ODT40_VOH30 | 50.0 ohm to GND | rising | 0 / 399 | 0 / 399 | 47.0 | 35.0 |
| PD40_ODT40_VOH30 | 50.0 ohm to GND | falling | 400 / 0 | 399 / -0 | 35.0 | 38.0 |
| PD48_ODT40_VOH30 | 50.0 ohm to GND | rising | 0 / 399 | -0 / 399 | 30.0 | 36.0 |
| PD48_ODT40_VOH30 | 50.0 ohm to GND | falling | 400 / 0 | 399 / -0 | 32.0 | 32.0 |

| driver model | load | DC high, V-I tables (mV) | DC high, KiCad (mV) | diff (mV) |
|---|---|---|---|---|
| PD40_ODT40_VOH30 | 40 ohm to GND | 366 | 365 | -1 |
| PD48_ODT40_VOH30 | 40 ohm to GND | 366 | 365 | -1 |
| lpddr4_ocd_40p_40n | 60 ohm to GND | 678 | 677 | -2 |
| lpddr4_ocd_48p_48n | 60 ohm to GND | 632 | 630 | -2 |
| lpddr4_ocd_40p_40n | open | 1100 | 1098 | -2 |
| lpddr4_ocd_48p_48n | open | 1100 | 1098 | -2 |
| PD40_ODT40_VOH30 | open | 1045 | 883 | -162 |
| PD48_ODT40_VOH30 | open | 1045 | 866 | -179 |
