johonkanen/efinix_soc_board/sim/lpddr4_si/results/coupled_lengths.md

| victim | aggressor | layer | edge gap (mm) | coupled length (mm) |
|---|---|---|---|---|
| ddr_dqs2_N | ddr_dqs2_P | In2.Cu | 0.15-0.20 | 8.4 |
| ddr_dqs3_N | ddr_dqs3_P | In2.Cu | 0.15-0.20 | 0.7 |
| ddr_dqs0_P | ddr_dqs0_N | In2.Cu | 0.20-0.25 | 17.6 |
| ddr_ck_P | ddr_ck_N | In2.Cu | 0.20-0.25 | 14.4 |
| ddr_dqs3_N | ddr_dqs3_P | In2.Cu | 0.20-0.25 | 10.2 |
| ddr_dqs1_P | ddr_dqs1_N | In2.Cu | 0.20-0.25 | 6.0 |
| ddr_dq14 | ddr_dq10 | In5.Cu | 0.20-0.25 | 1.8 |
| ddr_dq12 | ddr_dq11 | In5.Cu | 0.20-0.25 | 1.8 |
| ddr_dq0 | ddr_dq6 | F.Cu | 0.20-0.25 | 0.8 |
| ddr_dq14 | ddr_dq9 | In5.Cu | 0.20-0.25 | 0.8 |
| ddr_dq13 | ddr_dq10 | In5.Cu | 0.25-0.30 | 1.5 |
| ddr_dq14 | ddr_dq9 | In5.Cu | 0.25-0.30 | 0.6 |
| ddr_dq31 | ddr_dq30 | In5.Cu | 0.30-0.35 | 5.2 |
| ddr_ca0 | ddr_ca1 | In2.Cu | 0.30-0.35 | 0.8 |
| ddr_dq31 | ddr_dq30 | In5.Cu | 0.35-0.40 | 4.0 |
| ddr_dq24 | ddr_dq30 | In5.Cu | 0.35-0.40 | 3.4 |

| victim | coupled length with edge gap < 0.25 mm, per layer and gap (mm) | total (mm) |
|---|---|---|
| ddr_dqs0_N | In2.Cu 0.20: 17.7 | 17.7 |
| ddr_dqs0_P | In2.Cu 0.20: 17.6 | 17.6 |
| ddr_ck_N | In2.Cu 0.20: 14.5 | 14.5 |
| ddr_ck_P | In2.Cu 0.20: 14.4 | 14.4 |
| ddr_dqs3_N | In2.Cu 0.15: 0.7, In2.Cu 0.20: 10.2 | 10.9 |
| ddr_dqs3_P | In2.Cu 0.15: 0.7, In2.Cu 0.20: 10.2 | 10.9 |
| ddr_dqs2_N | In2.Cu 0.15: 8.4 | 8.4 |
| ddr_dqs2_P | In2.Cu 0.15: 8.4 | 8.4 |
| ddr_dqs1_P | In2.Cu 0.20: 6.0 | 6.0 |
| ddr_dqs1_N | In2.Cu 0.20: 6.0 | 6.0 |
| ddr_dq14 | In5.Cu 0.20: 2.5 | 2.5 |
| ddr_dq11 | In5.Cu 0.20: 2.0 | 2.0 |
| ddr_dq10 | In5.Cu 0.20: 1.8 | 1.8 |
| ddr_dq12 | In5.Cu 0.20: 1.8 | 1.8 |
| ddr_dq9 | In5.Cu 0.20: 1.1 | 1.1 |
