johonkanen/efinix_soc_board/sim/lpddr4_si/results/check_routes.md

| net | KiCad whole net (ps) | extracted whole net (ps) | diff | pad-to-pad paths to U801 (ps) |
|---|---|---|---|---|
| ddr_ca0 | 333.37 | 332.61 | -0.76 | H2 306.7, R2 306.7 |
| ddr_ca1 | 330.33 | 329.57 | -0.76 | J2 307.6, P2 307.6 |
| ddr_ca2 | 333.94 | 333.19 | -0.75 | H9 306.6, R9 306.7 |
| ddr_ca3 | 333.47 | 332.79 | -0.68 | H10 306.7, R10 306.3 |
| ddr_ca4 | 333.39 | 332.64 | -0.75 | H11 306.7, R11 306.7 |
| ddr_ca5 | 331.19 | 330.44 | -0.75 | J11 308.6, P11 308.6 |
| ddr_ck_N | 332.74 | 332.66 | -0.08 | J9 305.4, P9 308.5 |
| ddr_ck_P | 331.28 | 331.12 | -0.16 | J8 304.3, P8 308.9 |
| ddr_cke0 | 332.44 | 331.69 | -0.75 | J4 307.9, P4 307.9 |
| ddr_cs0_n | 307.2 | 307.09 | -0.11 | H4 307.1 |
| ddr_cs2_n | 307.2 | 307.09 | -0.11 | R4 307.1 |
| ddr_dm0 | 281.78 | 281.67 | -0.11 | C3 281.7 |
| ddr_dm1 | 221.8 | 221.69 | -0.11 | C10 221.7 |
| ddr_dm2 | 225.65 | 225.59 | -0.06 | Y3 224.7 |
| ddr_dm3 | 216.1 | 215.99 | -0.11 | Y10 216.0 |
| ddr_dq0 | 284.5 | 284.50 | +0.00 | B2 284.5 |
| ddr_dq1 | 284.5 | 284.50 | +0.00 | C2 284.5 |
| ddr_dq2 | 284.5 | 284.50 | +0.00 | E2 284.5 |
| ddr_dq3 | 284.5 | 284.50 | +0.00 | F2 284.5 |
| ddr_dq4 | 284.5 | 284.50 | +0.00 | F4 284.5 |
| ddr_dq5 | 284.5 | 284.50 | +0.00 | E4 284.5 |
| ddr_dq6 | 284.5 | 284.50 | +0.00 | C4 284.5 |
| ddr_dq7 | 284.5 | 284.50 | +0.00 | B4 284.5 |
| ddr_dq8 | 221.8 | 221.69 | -0.11 | B11 221.7 |
| ddr_dq9 | 221.8 | 221.69 | -0.11 | C11 221.7 |
| ddr_dq10 | 221.8 | 221.69 | -0.11 | E11 221.7 |
| ddr_dq11 | 221.8 | 221.69 | -0.11 | F11 221.7 |
| ddr_dq12 | 220.84 | 220.73 | -0.11 | F9 220.7 |
| ddr_dq13 | 221.8 | 221.69 | -0.11 | E9 221.7 |
| ddr_dq14 | 220.07 | 219.96 | -0.11 | C9 220.0 |
| ddr_dq15 | 221.81 | 221.70 | -0.11 | B9 221.7 |
| ddr_dq16 | 225.7 | 225.70 | +0.00 | AA2 225.7 |
| ddr_dq17 | 225.7 | 225.70 | +0.00 | Y2 225.7 |
| ddr_dq18 | 225.7 | 225.70 | -0.00 | V2 225.7 |
| ddr_dq19 | 225.7 | 225.70 | +0.00 | U2 225.7 |
| ddr_dq20 | 225.7 | 225.70 | -0.00 | U4 225.7 |
| ddr_dq21 | 225.7 | 225.70 | +0.00 | V4 225.7 |
| ddr_dq22 | 225.7 | 225.70 | +0.00 | Y4 225.7 |
| ddr_dq23 | 225.7 | 225.70 | -0.00 | AA4 225.7 |
| ddr_dq24 | 216.1 | 215.99 | -0.11 | AA11 216.0 |
| ddr_dq25 | 216.1 | 215.99 | -0.11 | Y11 216.0 |
| ddr_dq26 | 216.02 | 215.99 | -0.03 | V11 215.2 |
| ddr_dq27 | 216.1 | 215.99 | -0.11 | U11 216.0 |
| ddr_dq28 | 216.1 | 215.99 | -0.11 | U9 216.0 |
| ddr_dq29 | 216.02 | 215.99 | -0.03 | V9 215.3 |
| ddr_dq30 | 216.1 | 215.99 | -0.11 | Y9 216.0 |
| ddr_dq31 | 219.01 | 218.91 | -0.10 | AA9 218.9 |
| ddr_dqs0_N | 274.5 | 274.39 | -0.11 | E3 274.4 |
| ddr_dqs0_P | 274.5 | 274.39 | -0.11 | D3 274.4 |
| ddr_dqs1_N | 211.65 | 211.54 | -0.11 | E10 211.5 |
| ddr_dqs1_P | 211.65 | 211.54 | -0.11 | D10 211.5 |
| ddr_dqs2_N | 215.72 | 215.61 | -0.11 | V3 215.6 |
| ddr_dqs2_P | 215.72 | 215.61 | -0.11 | W3 215.6 |
| ddr_dqs3_N | 206.06 | 205.96 | -0.10 | V10 206.0 |
| ddr_dqs3_P | 206.06 | 205.96 | -0.10 | W10 206.0 |
| ddr_rst_n | 215.29 | 215.18 | -0.11 | T11 215.2 |

worst |diff| 0.76 ps over 56 nets; in KiCad but not extracted: none
