johonkanen/efinix_soc_board/sim/lpddr4_si/results/results.md

# LPDDR4 IBIS results (generated by report.py)

Worst case over nets, receivers, and ball/die (DRAM side; the FPGA side is judged at the die). DRAM = Winbond W66CL2NQUAFJ **stand-in**. FPGA package: Efinix net-length delay as a 50.6 Ω line unless marked *pkg file*.

## 2800 MT/s, single-ended width sweep, typ, every width

### DQ/DM write (FPGA 40 Ω → DRAM ODT 60)

| inner / outer (mm) | eye height (mV) | eye width (ps) | margin V (mV) | margin t (ps) (vs today) | Vmax / Vmin (mV) | ±0.3 V |
|---|---|---|---|---|---|---|
| 0.15 / 0.25 | 619 | 303 | +414 | +171 (+0 %) | 857 / -103 | ok |
| 0.18 / 0.20 | 583 | 296 | +396 | +162 (-5 %) | 876 / -103 | ok |
| 0.12 / 0.25 | 616 | 306 | +393 | +166 (-3 %) | 863 / -104 | ok |
| 0.10 / 0.25 | 614 | 308 | +368 | +164 (-4 %) | 864 / -103 | ok |
| 0.09 / 0.25 | 603 | 305 | +333 | +160 (-6 %) | 867 / -100 | ok |
| 0.18 / 0.15 | 555 | 290 | +355 | +159 (-7 %) | 888 / -106 | ok |
| 0.18 / 0.12 | 518 | 286 | +309 | +159 (-7 %) | 889 / -109 | ok |
| 0.18 / 0.10 | 497 | 286 | +265 | +159 (-7 %) | 888 / -115 | ok |
| 0.18 / 0.09 | 477 | 287 | +254 | +157 (-8 %) | 890 / -118 | ok |
| 0.10 / 0.10 | 484 | 276 | +293 | +152 (-11 %) | 881 / -129 | ok |
| 0.09 / 0.09 | 475 | 273 | +275 | +151 (-12 %) | 887 / -129 | ok |

### DQ/DM read (DRAM PDDS 40 → FPGA ODT 60)

| inner / outer (mm) | eye height (mV) | eye width (ps) | margin V (mV) | margin t (ps) (vs today) | Vmax / Vmin (mV) | ±0.3 V |
|---|---|---|---|---|---|---|
| 0.18 / 0.25 | 383 | 316 | +240 | +67 (+0 %) | 474 / -59 | ok |
| 0.15 / 0.25 | 385 | 318 | +236 | +67 (+0 %) | 481 / -60 | ok |
| 0.18 / 0.20 | 384 | 316 | +230 | +67 (+0 %) | 484 / -59 | ok |
| 0.12 / 0.25 | 369 | 320 | +229 | +66 (-1 %) | 481 / -53 | ok |
| 0.10 / 0.25 | 348 | 320 | +202 | +68 (+1 %) | 481 / -50 | ok |
| 0.09 / 0.25 | 340 | 320 | +192 | +68 (+1 %) | 481 / -51 | ok |
| 0.18 / 0.15 | 363 | 317 | +193 | +67 (+0 %) | 487 / -59 | ok |
| 0.18 / 0.12 | 343 | 317 | +167 | +65 (-3 %) | 486 / -64 | ok |
| 0.18 / 0.10 | 320 | 316 | +146 | +63 (-6 %) | 487 / -68 | ok |
| 0.18 / 0.09 | 316 | 314 | +135 | +61 (-9 %) | 487 / -70 | ok |
| 0.10 / 0.10 | 323 | 320 | +146 | +64 (-4 %) | 491 / -65 | ok |
| 0.09 / 0.09 | 310 | 320 | +135 | +65 (-3 %) | 491 / -65 | ok |

### CA (T, CA ODT 40)

| inner / outer (mm) | eye height (mV) | eye width (ps) | margin V (mV) | margin t (ps) (vs today) | Vmax / Vmin (mV) | ±0.3 V |
|---|---|---|---|---|---|---|
| 0.18 / 0.25 | 333 | 684 | +101 | +416 (+0 %) | 465 / -87 | ok |
| 0.15 / 0.25 | 339 | 683 | +87 | +413 (-1 %) | 465 / -82 | ok |
| 0.18 / 0.20 | 335 | 684 | +101 | +416 (+0 %) | 465 / -87 | ok |
| 0.12 / 0.25 | 329 | 682 | +72 | +218 (-48 %) | 463 / -88 | ok |
| 0.10 / 0.25 | 312 | 681 | +61 | +212 (-49 %) | 461 / -90 | ok |
| 0.09 / 0.25 | 303 | 681 | +52 | +206 (-51 %) | 461 / -85 | ok |
| 0.18 / 0.15 | 337 | 684 | +101 | +416 (+0 %) | 465 / -87 | ok |
| 0.18 / 0.12 | 338 | 684 | +101 | +416 (+0 %) | 465 / -87 | ok |
| 0.18 / 0.10 | 338 | 684 | +101 | +416 (+0 %) | 465 / -87 | ok |
| 0.18 / 0.09 | 341 | 684 | +101 | +416 (+0 %) | 465 / -87 | ok |
| 0.10 / 0.10 | 312 | 681 | +61 | +211 (-49 %) | 461 / -90 | ok |
| 0.09 / 0.09 | 303 | 681 | +52 | +205 (-51 %) | 461 / -85 | ok |

### CS (point to point, ODT 40)

| inner / outer (mm) | eye height (mV) | eye width (ps) | margin V (mV) | margin t (ps) (vs today) | Vmax / Vmin (mV) | ±0.3 V |
|---|---|---|---|---|---|---|
| 0.18 / 0.25 | 558 | 688 | +312 | +454 (+0 %) | 700 / -90 | ok |
| 0.15 / 0.25 | 554 | 687 | +314 | +454 (+0 %) | 699 / -87 | ok |
| 0.18 / 0.20 | 561 | 687 | +311 | +454 (+0 %) | 701 / -90 | ok |
| 0.12 / 0.25 | 555 | 687 | +311 | +454 (+0 %) | 696 / -83 | ok |
| 0.10 / 0.25 | 555 | 687 | +308 | +453 (-0 %) | 707 / -74 | ok |
| 0.09 / 0.25 | 550 | 687 | +300 | +453 (-0 %) | 710 / -68 | ok |
| 0.18 / 0.15 | 566 | 687 | +310 | +454 (+0 %) | 701 / -89 | ok |
| 0.18 / 0.12 | 567 | 687 | +310 | +454 (+0 %) | 700 / -88 | ok |
| 0.18 / 0.10 | 567 | 688 | +309 | +454 (+0 %) | 700 / -88 | ok |
| 0.18 / 0.09 | 565 | 688 | +307 | +454 (+0 %) | 706 / -92 | ok |
| 0.10 / 0.10 | 549 | 688 | +303 | +453 (-0 %) | 710 / -74 | ok |
| 0.09 / 0.09 | 548 | 687 | +289 | +453 (-0 %) | 719 / -81 | ok |

### CKE (T, no ODT)

| inner / outer (mm) | eye height (mV) | eye width (ps) | margin V (mV) | margin t (ps) (vs today) | Vmax / Vmin (mV) | ±0.3 V |
|---|---|---|---|---|---|---|
| 0.18 / 0.25 | 923 | 643 | +589 | +395 (+0 %) | 1384 / -239 | ok |
| 0.15 / 0.25 | 917 | 641 | +613 | +393 (-1 %) | 1405 / -259 | **over** |
| 0.18 / 0.20 | 924 | 643 | +607 | +396 (+0 %) | 1389 / -239 | ok |
| 0.12 / 0.25 | 917 | 642 | +609 | +383 (-3 %) | 1427 / -282 | **over** |
| 0.10 / 0.25 | 921 | 645 | +589 | +383 (-3 %) | 1438 / -301 | **over** |
| 0.09 / 0.25 | 914 | 649 | +596 | +371 (-6 %) | 1451 / -334 | **over** |
| 0.18 / 0.15 | 926 | 645 | +634 | +399 (+1 %) | 1394 / -240 | ok |
| 0.18 / 0.12 | 928 | 646 | +647 | +400 (+1 %) | 1396 / -241 | ok |
| 0.18 / 0.10 | 930 | 647 | +653 | +401 (+2 %) | 1398 / -242 | ok |
| 0.18 / 0.09 | 932 | 649 | +656 | +402 (+2 %) | 1403 / -247 | **over** |
| 0.10 / 0.10 | 931 | 644 | +608 | +384 (-3 %) | 1458 / -305 | **over** |
| 0.09 / 0.09 | 916 | 648 | +617 | +384 (-3 %) | 1484 / -347 | **over** |

## 2800 MT/s, single-ended width sweep, worst of typ / min / max, key widths

### DQ/DM write (FPGA 40 Ω → DRAM ODT 60)

| inner / outer (mm) | eye height (mV) | eye width (ps) | margin V (mV) | margin t (ps) (vs today) | Vmax / Vmin (mV) | ±0.3 V |
|---|---|---|---|---|---|---|
| 0.10 / 0.10 | 459 | 276 | +257 | +151 (+0 %) | 974 / -129 | ok |
| 0.09 / 0.09 | 444 | 273 | +237 | +148 (-2 %) | 979 / -129 | ok |

### DQ/DM read (DRAM PDDS 40 → FPGA ODT 60)

| inner / outer (mm) | eye height (mV) | eye width (ps) | margin V (mV) | margin t (ps) (vs today) | Vmax / Vmin (mV) | ±0.3 V |
|---|---|---|---|---|---|---|
| 0.18 / 0.25 | 362 | 311 | +220 | +58 (+0 %) | 531 / -92 | ok |
| 0.10 / 0.10 | 300 | 306 | +136 | +51 (-12 %) | 546 / -100 | ok |
| 0.09 / 0.09 | 292 | 307 | +122 | +51 (-12 %) | 548 / -99 | ok |

### CA (T, CA ODT 40)

| inner / outer (mm) | eye height (mV) | eye width (ps) | margin V (mV) | margin t (ps) (vs today) | Vmax / Vmin (mV) | ±0.3 V |
|---|---|---|---|---|---|---|
| 0.18 / 0.25 | 313 | 680 | +66 | +240 (+0 %) | 493 / -97 | ok |
| 0.10 / 0.10 | 301 | 671 | +27 | +197 (-18 %) | 494 / -95 | ok |
| 0.09 / 0.09 | 298 | 670 | +17 | +194 (-19 %) | 497 / -86 | ok |

### CS (point to point, ODT 40)

| inner / outer (mm) | eye height (mV) | eye width (ps) | margin V (mV) | margin t (ps) (vs today) | Vmax / Vmin (mV) | ±0.3 V |
|---|---|---|---|---|---|---|
| 0.18 / 0.25 | 510 | 687 | +261 | +451 (+0 %) | 745 / -93 | ok |
| 0.10 / 0.10 | 496 | 686 | +258 | +448 (-1 %) | 759 / -79 | ok |
| 0.09 / 0.09 | 499 | 687 | +255 | +447 (-1 %) | 767 / -82 | ok |

### CKE (T, no ODT)

| inner / outer (mm) | eye height (mV) | eye width (ps) | margin V (mV) | margin t (ps) (vs today) | Vmax / Vmin (mV) | ±0.3 V |
|---|---|---|---|---|---|---|
| 0.18 / 0.25 | 861 | 601 | +546 | +332 (+0 %) | 1507 / -287 | **over** |
| 0.10 / 0.10 | 879 | 602 | +569 | +320 (-4 %) | 1567 / -348 | **over** |
| 0.09 / 0.09 | 888 | 601 | +576 | +314 (-5 %) | 1595 / -370 | **over** |

## 3200 MT/s, single-ended width sweep, typ, every width

### DQ/DM write (FPGA 40 Ω → DRAM ODT 60)

| inner / outer (mm) | eye height (mV) | eye width (ps) | margin V (mV) | margin t (ps) (vs today) | Vmax / Vmin (mV) | ±0.3 V |
|---|---|---|---|---|---|---|
| 0.18 / 0.25 | 603 | 248 | +359 | +125 (+0 %) | 858 / -109 | ok |
| 0.15 / 0.25 | 599 | 248 | +368 | +123 (-2 %) | 856 / -135 | ok |
| 0.18 / 0.20 | 565 | 243 | +336 | +121 (-3 %) | 863 / -106 | ok |
| 0.12 / 0.25 | 580 | 247 | +368 | +111 (-11 %) | 868 / -140 | ok |
| 0.10 / 0.25 | 563 | 247 | +331 | +92 (-26 %) | 871 / -133 | ok |
| 0.09 / 0.25 | 559 | 248 | +325 | +91 (-27 %) | 876 / -123 | ok |
| 0.18 / 0.15 | 524 | 240 | +333 | +104 (-17 %) | 873 / -124 | ok |
| 0.18 / 0.12 | 485 | 231 | +304 | +103 (-18 %) | 892 / -142 | ok |
| 0.18 / 0.10 | 460 | 220 | +270 | +100 (-20 %) | 891 / -138 | ok |
| 0.18 / 0.09 | 450 | 214 | +249 | +97 (-22 %) | 888 / -135 | ok |
| 0.10 / 0.10 | 468 | 211 | +285 | +95 (-24 %) | 888 / -146 | ok |
| 0.09 / 0.09 | 457 | 210 | +272 | +90 (-28 %) | 881 / -149 | ok |

### DQ/DM read (DRAM PDDS 40 → FPGA ODT 60)

| inner / outer (mm) | eye height (mV) | eye width (ps) | margin V (mV) | margin t (ps) (vs today) | Vmax / Vmin (mV) | ±0.3 V |
|---|---|---|---|---|---|---|
| 0.18 / 0.25 | 376 | 257 | +179 | +48 (+0 %) | 507 / -74 | ok |
| 0.15 / 0.25 | 356 | 256 | +173 | +47 (-2 %) | 499 / -74 | ok |
| 0.18 / 0.20 | 376 | 257 | +179 | +45 (-6 %) | 507 / -74 | ok |
| 0.12 / 0.25 | 346 | 257 | +171 | +48 (+0 %) | 496 / -78 | ok |
| 0.10 / 0.25 | 336 | 256 | +162 | +47 (-2 %) | 492 / -78 | ok |
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
|---|---|---|---|---|---|---|
| 0.18 / 0.25 | 359 | 253 | +167 | +39 (+0 %) | 543 / -298 | ok |
| 0.10 / 0.10 | 283 | 245 | +116 | +26 (-33 %) | 563 / -340 | **over** |
| 0.09 / 0.09 | 271 | 245 | +105 | -12 (-130 %) | 562 / -342 | **over** |

### CA (T, CA ODT 40)

| inner / outer (mm) | eye height (mV) | eye width (ps) | margin V (mV) | margin t (ps) (vs today) | Vmax / Vmin (mV) | ±0.3 V |
|---|---|---|---|---|---|---|
| 0.18 / 0.25 | 317 | 585 | +97 | +329 (+0 %) | 492 / -91 | ok |
| 0.10 / 0.10 | 288 | 581 | +74 | +75 (-77 %) | 493 / -87 | ok |
| 0.09 / 0.09 | 283 | 581 | +64 | +70 (-79 %) | 494 / -85 | ok |

### CS (point to point, ODT 40)

| inner / outer (mm) | eye height (mV) | eye width (ps) | margin V (mV) | margin t (ps) (vs today) | Vmax / Vmin (mV) | ±0.3 V |
|---|---|---|---|---|---|---|
| 0.18 / 0.25 | 513 | 616 | +244 | +390 (+0 %) | 774 / -81 | ok |
| 0.10 / 0.10 | 496 | 611 | +247 | +385 (-1 %) | 740 / -94 | ok |
| 0.09 / 0.09 | 489 | 610 | +248 | +384 (-2 %) | 746 / -91 | ok |

### CKE (T, no ODT)

| inner / outer (mm) | eye height (mV) | eye width (ps) | margin V (mV) | margin t (ps) (vs today) | Vmax / Vmin (mV) | ±0.3 V |
|---|---|---|---|---|---|---|
| 0.18 / 0.25 | 781 | 497 | +415 | +214 (+0 %) | 1624 / -326 | **over** |
| 0.10 / 0.10 | 783 | 409 | +437 | +180 (-16 %) | 1696 / -384 | **over** |
| 0.09 / 0.09 | 831 | 449 | +415 | +170 (-21 %) | 1703 / -368 | **over** |

## Drive / ODT settings (typ corner, DQ4 / CA1 / CS2 / CK)

| rate | width in/out | case | FPGA drv | FPGA ODT | DRAM ODT | PDDS | CA ODT | eye height (mV) | eye width (ps) | margin V (mV) | margin t (ps) (vs today) | Vmax / Vmin (mV) | ±0.3 V |
|---|---|---|---|---|---|---|---|---|---|---|---|---|---|
| 2800 | 0.18/0.25 | r_dq4 | 40.0 | 60.0 | 60.0 | 40.0 | 40.0 | 399 | 342 | +240 | +84 | 473 / -59 | ok |
| 2800 | 0.18/0.25 | ck_40 | 40.0 | 60.0 | 60.0 | 40.0 | 40.0 | 659 | 326 | +432 | +217 | 481 / -83 | ok |
| 2800 | 0.18/0.25 | ca1_40 | 40.0 | 60.0 | 60.0 | 40.0 | 40.0 | 349 | 684 | +101 | +416 | 456 / -87 | ok |
| 2800 | 0.18/0.25 | cs2_n_40 | 40.0 | 60.0 | 60.0 | 40.0 | 40.0 | 566 | 689 | +312 | +454 | 700 / -90 | ok |
| 2800 | 0.18/0.25 | cke0_40 | 40.0 | 60.0 | 60.0 | 40.0 | 40.0 | 923 | 643 | +589 | +395 | 1384 / -239 | ok |
| 2800 | 0.10/0.10 | w_dq4 | 40.0 | 60.0 | 60.0 | 40.0 | 40.0 | 657 | 308 | +483 | +170 | 847 / -86 | ok |
| 2800 | 0.10/0.10 | r_dq4 | 40.0 | 60.0 | 60.0 | 40.0 | 40.0 | 403 | 341 | +238 | +90 | 478 / -49 | ok |
| 2800 | 0.10/0.10 | ck_40 | 40.0 | 60.0 | 60.0 | 40.0 | 40.0 | 659 | 326 | +432 | +217 | 481 / -83 | ok |
| 2800 | 0.10/0.10 | ca1_40 | 40.0 | 60.0 | 60.0 | 40.0 | 40.0 | 312 | 681 | +61 | +224 | 461 / -65 | ok |
| 2800 | 0.10/0.10 | cs2_n_40 | 40.0 | 60.0 | 60.0 | 40.0 | 40.0 | 556 | 688 | +303 | +453 | 710 / -74 | ok |
| 2800 | 0.10/0.10 | cke0_40 | 40.0 | 60.0 | 60.0 | 40.0 | 40.0 | 931 | 644 | +608 | +384 | 1458 / -305 | **over** |
| 3200 | 0.18/0.25 | w_dq4 | 40.0 | 60.0 | 60.0 | 40.0 | 40.0 | 603 | 256 | +369 | +154 | 858 / -93 | ok |
| 3200 | 0.18/0.25 | r_dq4 | 40.0 | 60.0 | 60.0 | 40.0 | 40.0 | 376 | 259 | +179 | +50 | 507 / -74 | ok |
| 3200 | 0.18/0.25 | ck_40 | 40.0 | 60.0 | 60.0 | 40.0 | 40.0 | 656 | 264 | +394 | +176 | 487 / -106 | ok |
| 3200 | 0.18/0.25 | ca1_40 | 40.0 | 60.0 | 60.0 | 40.0 | 40.0 | 346 | 599 | +151 | +354 | 466 / -79 | ok |
| 3200 | 0.18/0.25 | cs2_n_40 | 40.0 | 60.0 | 60.0 | 40.0 | 40.0 | 556 | 616 | +286 | +394 | 714 / -80 | ok |
| 3200 | 0.18/0.25 | cke0_40 | 40.0 | 60.0 | 60.0 | 40.0 | 40.0 | 903 | 558 | +505 | +299 | 1448 / -284 | **over** |
| 3200 | 0.10/0.10 | w_dq4 | 40.0 | 60.0 | 60.0 | 40.0 | 40.0 | 563 | 252 | +360 | +149 | 847 / -97 | ok |
| 3200 | 0.10/0.10 | r_dq4 | 40.0 | 60.0 | 60.0 | 40.0 | 40.0 | 336 | 257 | +162 | +49 | 492 / -78 | ok |
| 3200 | 0.10/0.10 | ck_40 | 40.0 | 60.0 | 60.0 | 40.0 | 40.0 | 656 | 264 | +394 | +176 | 487 / -106 | ok |
| 3200 | 0.10/0.10 | ca1_40 | 40.0 | 60.0 | 60.0 | 40.0 | 40.0 | 320 | 596 | +96 | +108 | 462 / -74 | ok |
| 3200 | 0.10/0.10 | cs2_n_40 | 40.0 | 60.0 | 60.0 | 40.0 | 40.0 | 547 | 616 | +279 | +394 | 692 / -76 | ok |
| 3200 | 0.10/0.10 | cke0_40 | 40.0 | 60.0 | 60.0 | 40.0 | 40.0 | 863 | 486 | +514 | +252 | 1507 / -355 | **over** |

## FPGA package model: net-length line vs the vendor file's lumped pin RLC (typ)

| rate | width in/out | group | package | eye height (mV) | eye width (ps) | margin V (mV) | margin t (ps) (vs today) | Vmax / Vmin (mV) | ±0.3 V |
|---|---|---|---|---|---|---|---|---|---|
| 2800 | 0.18/0.25 | DQ/DM write | file | 642 | 335 | +441 | +206 | 796 / -72 | ok |
| 2800 | 0.18/0.25 | DQ/DM read | netlen | 383 | 316 | +240 | +67 | 474 / -59 | ok |
| 2800 | 0.18/0.25 | DQ/DM read | file | 387 | 333 | +216 | +81 | 459 / -68 | ok |
| 2800 | 0.18/0.25 | CA | netlen | 333 | 684 | +101 | +416 | 465 / -87 | ok |
| 2800 | 0.18/0.25 | CA | file | 344 | 687 | +122 | +415 | 452 / -74 | ok |
| 2800 | 0.10/0.10 | DQ/DM write | netlen | 484 | 276 | +293 | +152 | 881 / -129 | ok |
| 2800 | 0.10/0.10 | DQ/DM write | file | 585 | 321 | +326 | +171 | 853 / -86 | ok |
| 2800 | 0.10/0.10 | DQ/DM read | netlen | 323 | 320 | +146 | +64 | 491 / -65 | ok |
| 2800 | 0.10/0.10 | DQ/DM read | file | 353 | 328 | +140 | +71 | 459 / -56 | ok |
| 2800 | 0.10/0.10 | CA | netlen | 312 | 681 | +61 | +211 | 461 / -90 | ok |
| 2800 | 0.10/0.10 | CA | file | 320 | 686 | +79 | +243 | 431 / -55 | ok |
| 2800 | 0.09/0.09 | DQ/DM write | netlen | 475 | 273 | +275 | +151 | 887 / -129 | ok |
| 2800 | 0.09/0.09 | DQ/DM write | file | 565 | 320 | +317 | +166 | 857 / -84 | ok |
| 2800 | 0.09/0.09 | DQ/DM read | netlen | 310 | 320 | +135 | +65 | 491 / -65 | ok |
| 2800 | 0.09/0.09 | DQ/DM read | file | 347 | 328 | +135 | +72 | 460 / -55 | ok |
| 2800 | 0.09/0.09 | CA | netlen | 303 | 681 | +52 | +205 | 461 / -85 | ok |
| 2800 | 0.09/0.09 | CA | file | 311 | 686 | +69 | +224 | 430 / -48 | ok |
| 3200 | 0.18/0.25 | DQ/DM write | netlen | 603 | 248 | +359 | +125 | 858 / -109 | ok |
| 3200 | 0.18/0.25 | DQ/DM write | file | 616 | 258 | +381 | +167 | 809 / -89 | ok |
| 3200 | 0.18/0.25 | DQ/DM read | netlen | 376 | 257 | +179 | +48 | 507 / -74 | ok |
| 3200 | 0.18/0.25 | DQ/DM read | file | 387 | 263 | +213 | +58 | 459 / -68 | ok |
| 3200 | 0.18/0.25 | CA | netlen | 336 | 599 | +132 | +354 | 466 / -79 | ok |
| 3200 | 0.18/0.25 | CA | file | 341 | 603 | +116 | +361 | 448 / -75 | ok |
| 3200 | 0.10/0.10 | DQ/DM write | netlen | 468 | 211 | +285 | +95 | 888 / -146 | ok |
| 3200 | 0.10/0.10 | DQ/DM write | file | 497 | 258 | +278 | +111 | 843 / -95 | ok |
| 3200 | 0.10/0.10 | DQ/DM read | netlen | 298 | 251 | +139 | +38 | 492 / -81 | ok |
| 3200 | 0.10/0.10 | DQ/DM read | file | 316 | 258 | +134 | +49 | 468 / -54 | ok |
| 3200 | 0.10/0.10 | CA | netlen | 318 | 596 | +96 | +108 | 469 / -79 | ok |
| 3200 | 0.10/0.10 | CA | file | 315 | 602 | +87 | +357 | 440 / -61 | ok |
| 3200 | 0.09/0.09 | DQ/DM write | netlen | 457 | 210 | +272 | +90 | 881 / -149 | ok |
| 3200 | 0.09/0.09 | DQ/DM write | file | 473 | 258 | +268 | +107 | 845 / -94 | ok |
| 3200 | 0.09/0.09 | DQ/DM read | netlen | 286 | 251 | +131 | +38 | 495 / -82 | ok |
| 3200 | 0.09/0.09 | DQ/DM read | file | 309 | 258 | +123 | +48 | 468 / -55 | ok |
| 3200 | 0.09/0.09 | CA | netlen | 314 | 596 | +87 | +94 | 465 / -79 | ok |
| 3200 | 0.09/0.09 | CA | file | 310 | 602 | +77 | +355 | 441 / -63 | ok |

## Pair geometry (DQS, CK), SE at today's width

| rate | corner | inner w/gap | outer w/gap | group | eye height (mV) | eye width (ps) | margin V (mV) | margin t (ps) (vs today) | Vmax / Vmin (mV) | ±0.3 V |
|---|---|---|---|---|---|---|---|---|---|---|
| 2800 | typ | 0.14/0.15 | 0.20/0.20 | DQS read (pair) | 808 | 342 | +597 | +110 | 472 / -44 | ok |
| 2800 | typ | 0.14/0.15 | 0.20/0.20 | CK (pair, T, CK ODT 40) | 659 | 326 | +432 | +217 | 481 / -83 | ok |
| 2800 | typ | 0.10/0.13 | 0.10/0.10 | DQS write (pair) | 1334 | 336 | +1056 | +190 | 849 / -103 | ok |
| 2800 | typ | 0.10/0.13 | 0.10/0.10 | DQS read (pair) | 813 | 339 | +578 | +108 | 475 / -41 | ok |
| 2800 | typ | 0.10/0.13 | 0.10/0.10 | CK (pair, T, CK ODT 40) | 640 | 322 | +446 | +213 | 483 / -81 | ok |
| 2800 | typ | 0.10/0.10 | 0.12/0.10 | DQS write (pair) | 1348 | 336 | +1062 | +193 | 852 / -105 | ok |
| 2800 | typ | 0.10/0.10 | 0.12/0.10 | DQS read (pair) | 816 | 340 | +594 | +109 | 474 / -42 | ok |
| 2800 | typ | 0.10/0.10 | 0.12/0.10 | CK (pair, T, CK ODT 40) | 632 | 324 | +445 | +215 | 488 / -82 | ok |
| 2800 | typ | 0.09/0.20 | 0.10/0.15 | DQS write (pair) | 1312 | 335 | +1035 | +185 | 864 / -109 | ok |
| 2800 | typ | 0.09/0.20 | 0.10/0.15 | DQS read (pair) | 760 | 338 | +549 | +103 | 476 / -42 | ok |
| 2800 | typ | 0.09/0.20 | 0.10/0.15 | CK (pair, T, CK ODT 40) | 620 | 321 | +448 | +209 | 484 / -79 | ok |
| 2800 | min | 0.14/0.15 | 0.20/0.20 | DQS write (pair) | 1232 | 337 | +950 | +190 | 770 / -98 | ok |
| 2800 | min | 0.14/0.15 | 0.20/0.20 | DQS read (pair) | 777 | 341 | +577 | +109 | 456 / -45 | ok |
| 2800 | min | 0.14/0.15 | 0.20/0.20 | CK (pair, T, CK ODT 40) | 595 | 325 | +371 | +217 | 446 / -79 | ok |
| 2800 | min | 0.10/0.13 | 0.10/0.10 | DQS write (pair) | 1224 | 335 | +963 | +188 | 777 / -97 | ok |
| 2800 | min | 0.10/0.13 | 0.10/0.10 | DQS read (pair) | 789 | 340 | +569 | +108 | 458 / -41 | ok |
| 2800 | min | 0.10/0.13 | 0.10/0.10 | CK (pair, T, CK ODT 40) | 581 | 322 | +390 | +212 | 455 / -81 | ok |
| 2800 | min | 0.10/0.10 | 0.12/0.10 | DQS write (pair) | 1231 | 337 | +957 | +191 | 774 / -90 | ok |
| 2800 | min | 0.10/0.10 | 0.12/0.10 | DQS read (pair) | 793 | 340 | +576 | +108 | 457 / -42 | ok |
| 2800 | min | 0.10/0.10 | 0.12/0.10 | CK (pair, T, CK ODT 40) | 567 | 325 | +381 | +215 | 451 / -78 | ok |
| 2800 | min | 0.09/0.20 | 0.10/0.15 | DQS write (pair) | 1220 | 335 | +939 | +180 | 770 / -95 | ok |
| 2800 | min | 0.09/0.20 | 0.10/0.15 | DQS read (pair) | 736 | 338 | +538 | +103 | 459 / -40 | ok |
| 2800 | min | 0.09/0.20 | 0.10/0.15 | CK (pair, T, CK ODT 40) | 566 | 322 | +378 | +208 | 451 / -83 | ok |
| 3200 | typ | 0.14/0.15 | 0.20/0.20 | DQS write (pair) | 1284 | 259 | +1007 | +151 | 847 / -127 | ok |
| 3200 | typ | 0.14/0.15 | 0.20/0.20 | DQS read (pair) | 791 | 262 | +561 | +63 | 479 / -51 | ok |
| 3200 | typ | 0.14/0.15 | 0.20/0.20 | CK (pair, T, CK ODT 40) | 656 | 264 | +394 | +176 | 487 / -106 | ok |
| 3200 | typ | 0.10/0.13 | 0.10/0.10 | DQS write (pair) | 1267 | 258 | +985 | +148 | 866 / -124 | ok |
| 3200 | typ | 0.10/0.13 | 0.10/0.10 | DQS read (pair) | 800 | 261 | +560 | +62 | 477 / -45 | ok |
| 3200 | typ | 0.10/0.13 | 0.10/0.10 | CK (pair, T, CK ODT 40) | 637 | 265 | +385 | +176 | 487 / -102 | ok |
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
| outer | DIFF | 0.12 | 0.15 | 94.5 | 5.913 |
| outer | DIFF | 0.10 | 0.1 | 90.3 | 5.948 |
| outer | DIFF | 0.10 | 0.15 | 100.9 | 5.908 |
| outer | DIFF | 0.10 | 0.2 | 106.9 | 5.911 |
| outer | DIFF | 0.15 | 0.2 | 91.0 | 5.934 |
| outer | DIFF | 0.09 | 0.15 | 104.5 | 5.907 |
