johonkanen/efinix_soc_board/sim/lpddr4_si/results/results_small.md

# LPDDR4 IBIS results (generated by report.py)

Worst case over nets, receivers, and ball/die (DRAM side; the FPGA side is judged at the die). DRAM = Winbond W66CL2NQUAFJ **stand-in**. FPGA package: Efinix net-length delay as a 50.6 Ω line unless marked *pkg file*.

## 2800 MT/s, single-ended width sweep, typ, every width

### DQ/DM write (FPGA 40 Ω → DRAM ODT 60)

| inner / outer (mm) | eye height (mV) | eye width (ps) | margin V (mV) | margin t (ps) (vs today) | Vmax / Vmin (mV) | ±0.3 V |
|---|---|---|---|---|---|---|
| 0.18 / 0.25 | 616 | 315 | +429 | +176 (+0 %) | 802 / -78 | ok |
| 0.12 / 0.25 | 602 | 318 | +402 | +170 (-3 %) | 799 / -76 | ok |
| 0.10 / 0.25 | 582 | 321 | +369 | +164 (-7 %) | 802 / -81 | ok |
| 0.18 / 0.15 | 594 | 302 | +365 | +167 (-5 %) | 817 / -83 | ok |
| 0.18 / 0.10 | 539 | 297 | +295 | +163 (-7 %) | 827 / -92 | ok |
| 0.12 / 0.15 | 581 | 318 | +382 | +165 (-6 %) | 802 / -80 | ok |
| 0.10 / 0.10 | 528 | 284 | +308 | +159 (-10 %) | 824 / -94 | ok |
| 0.09 / 0.09 | 514 | 281 | +293 | +157 (-11 %) | 829 / -99 | ok |

### DQ/DM read (DRAM PDDS 40 → FPGA ODT 60)

| inner / outer (mm) | eye height (mV) | eye width (ps) | margin V (mV) | margin t (ps) (vs today) | Vmax / Vmin (mV) | ±0.3 V |
|---|---|---|---|---|---|---|
| 0.18 / 0.25 | 381 | 323 | +232 | +71 (+0 %) | 455 / -51 | ok |
| 0.12 / 0.25 | 353 | 324 | +213 | +69 (-3 %) | 456 / -45 | ok |
| 0.10 / 0.25 | 339 | 324 | +193 | +68 (-4 %) | 456 / -41 | ok |
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
| 0.18 / 0.10 | 545 | 619 | +294 | +396 (+0 %) | 662 / -65 | ok |
| 0.12 / 0.15 | 544 | 619 | +300 | +394 (-0 %) | 655 / -65 | ok |
| 0.10 / 0.10 | 542 | 618 | +293 | +394 (-0 %) | 648 / -62 | ok |
| 0.09 / 0.09 | 541 | 618 | +286 | +393 (-1 %) | 645 / -59 | ok |

### CKE (T, no ODT)

| inner / outer (mm) | eye height (mV) | eye width (ps) | margin V (mV) | margin t (ps) (vs today) | Vmax / Vmin (mV) | ±0.3 V |
|---|---|---|---|---|---|---|
| 0.18 / 0.25 | 823 | 579 | +458 | +288 (+0 %) | 1377 / -221 | ok |
| 0.12 / 0.25 | 816 | 576 | +468 | +292 (+2 %) | 1391 / -241 | ok |
| 0.10 / 0.25 | 830 | 580 | +474 | +292 (+2 %) | 1393 / -247 | ok |
| 0.18 / 0.15 | 845 | 582 | +487 | +294 (+2 %) | 1394 / -240 | ok |
| 0.18 / 0.10 | 867 | 576 | +516 | +304 (+6 %) | 1402 / -251 | **over** |
| 0.12 / 0.15 | 826 | 576 | +494 | +292 (+2 %) | 1416 / -270 | **over** |
| 0.10 / 0.10 | 837 | 570 | +513 | +267 (-7 %) | 1436 / -293 | **over** |

## 3200 MT/s, single-ended width sweep, worst of typ / min / max, key widths

### DQ/DM write (FPGA 40 Ω → DRAM ODT 60)

| inner / outer (mm) | eye height (mV) | eye width (ps) | margin V (mV) | margin t (ps) (vs today) | Vmax / Vmin (mV) | ±0.3 V |
|---|---|---|---|---|---|---|

### DQ/DM read (DRAM PDDS 40 → FPGA ODT 60)

| inner / outer (mm) | eye height (mV) | eye width (ps) | margin V (mV) | margin t (ps) (vs today) | Vmax / Vmin (mV) | ±0.3 V |
|---|---|---|---|---|---|---|

### CA (T, CA ODT 40)

| inner / outer (mm) | eye height (mV) | eye width (ps) | margin V (mV) | margin t (ps) (vs today) | Vmax / Vmin (mV) | ±0.3 V |
|---|---|---|---|---|---|---|

### CS (point to point, ODT 40)

| inner / outer (mm) | eye height (mV) | eye width (ps) | margin V (mV) | margin t (ps) (vs today) | Vmax / Vmin (mV) | ±0.3 V |
|---|---|---|---|---|---|---|

### CKE (T, no ODT)

| inner / outer (mm) | eye height (mV) | eye width (ps) | margin V (mV) | margin t (ps) (vs today) | Vmax / Vmin (mV) | ±0.3 V |
|---|---|---|---|---|---|---|

## Drive / ODT settings (typ corner, DQ4 / CA1 / CS2 / CK)

| rate | width in/out | case | FPGA drv | FPGA ODT | DRAM ODT | PDDS | CA ODT | eye height (mV) | eye width (ps) | margin V (mV) | margin t (ps) (vs today) | Vmax / Vmin (mV) | ±0.3 V |
|---|---|---|---|---|---|---|---|---|---|---|---|---|---|
| 2800 | 0.18/0.25 | w_dq4 | 40.0 | 60.0 | 60.0 | 40.0 | 40.0 | 661 | 315 | +468 | +176 | 802 / -78 | ok |
| 2800 | 0.18/0.25 | r_dq4 | 40.0 | 60.0 | 60.0 | 40.0 | 40.0 | 389 | 342 | +232 | +84 | 447 / -51 | ok |
| 2800 | 0.18/0.25 | ck_40 | 40.0 | 60.0 | 60.0 | 40.0 | 40.0 | 652 | 329 | +447 | +220 | 440 / -71 | ok |
| 2800 | 0.18/0.25 | ca1_40 | 40.0 | 60.0 | 60.0 | 40.0 | 40.0 | 343 | 685 | +112 | +413 | 425 / -67 | ok |
| 2800 | 0.18/0.25 | cs2_n_40 | 40.0 | 60.0 | 60.0 | 40.0 | 40.0 | 551 | 690 | +327 | +453 | 654 / -68 | ok |
| 2800 | 0.18/0.25 | cke0_40 | 40.0 | 60.0 | 60.0 | 40.0 | 40.0 | 989 | 639 | +563 | +377 | 1311 / -162 | ok |
| 2800 | 0.10/0.10 | w_dq4 | 40.0 | 60.0 | 60.0 | 40.0 | 40.0 | 627 | 321 | +458 | +179 | 793 / -64 | ok |
| 2800 | 0.10/0.10 | r_dq4 | 40.0 | 60.0 | 60.0 | 40.0 | 40.0 | 386 | 341 | +228 | +86 | 456 / -41 | ok |
| 2800 | 0.10/0.10 | ck_40 | 40.0 | 60.0 | 60.0 | 40.0 | 40.0 | 652 | 329 | +447 | +220 | 440 / -71 | ok |
| 2800 | 0.10/0.10 | ca1_40 | 40.0 | 60.0 | 60.0 | 40.0 | 40.0 | 307 | 685 | +77 | +402 | 426 / -54 | ok |
| 2800 | 0.10/0.10 | cs2_n_40 | 40.0 | 60.0 | 60.0 | 40.0 | 40.0 | 543 | 689 | +323 | +453 | 656 / -65 | ok |
| 2800 | 0.10/0.10 | cke0_40 | 40.0 | 60.0 | 60.0 | 40.0 | 40.0 | 975 | 642 | +636 | +386 | 1377 / -233 | ok |
| 3200 | 0.18/0.25 | w_dq4 | 40.0 | 60.0 | 60.0 | 40.0 | 40.0 | 629 | 256 | +397 | +156 | 809 / -66 | ok |
| 3200 | 0.18/0.25 | r_dq4 | 40.0 | 60.0 | 60.0 | 40.0 | 40.0 | 362 | 261 | +172 | +51 | 476 / -64 | ok |
| 3200 | 0.18/0.25 | ck_40 | 40.0 | 60.0 | 60.0 | 40.0 | 40.0 | 648 | 265 | +385 | +176 | 462 / -98 | ok |
| 3200 | 0.18/0.25 | ca1_40 | 40.0 | 60.0 | 60.0 | 40.0 | 40.0 | 341 | 604 | +153 | +353 | 425 / -61 | ok |
| 3200 | 0.18/0.25 | cs2_n_40 | 40.0 | 60.0 | 60.0 | 40.0 | 40.0 | 545 | 619 | +295 | +395 | 662 / -66 | ok |
| 3200 | 0.18/0.25 | cke0_40 | 40.0 | 60.0 | 60.0 | 40.0 | 40.0 | 823 | 579 | +458 | +288 | 1377 / -221 | ok |
| 3200 | 0.10/0.10 | w_dq4 | 40.0 | 60.0 | 60.0 | 40.0 | 40.0 | 593 | 250 | +387 | +148 | 813 / -62 | ok |
| 3200 | 0.10/0.10 | r_dq4 | 40.0 | 60.0 | 60.0 | 40.0 | 40.0 | 335 | 259 | +157 | +50 | 457 / -53 | ok |
| 3200 | 0.10/0.10 | ck_40 | 40.0 | 60.0 | 60.0 | 40.0 | 40.0 | 648 | 265 | +385 | +176 | 462 / -98 | ok |
| 3200 | 0.10/0.10 | ca1_40 | 40.0 | 60.0 | 60.0 | 40.0 | 40.0 | 322 | 602 | +123 | +350 | 422 / -60 | ok |
| 3200 | 0.10/0.10 | cs2_n_40 | 40.0 | 60.0 | 60.0 | 40.0 | 40.0 | 542 | 619 | +293 | +394 | 648 / -62 | ok |
| 3200 | 0.10/0.10 | cke0_40 | 40.0 | 60.0 | 60.0 | 40.0 | 40.0 | 837 | 570 | +513 | +267 | 1436 / -293 | **over** |

## FPGA package model: net-length line vs the vendor file's lumped pin RLC (typ)

| rate | width in/out | group | package | eye height (mV) | eye width (ps) | margin V (mV) | margin t (ps) (vs today) | Vmax / Vmin (mV) | ±0.3 V |
|---|---|---|---|---|---|---|---|---|---|
| 2800 | 0.18/0.25 | DQ/DM write | netlen | 616 | 315 | +429 | +176 | 802 / -78 | ok |
| 2800 | 0.18/0.25 | DQ/DM read | netlen | 381 | 323 | +232 | +71 | 455 / -51 | ok |
| 2800 | 0.18/0.25 | CA | netlen | 342 | 685 | +112 | +413 | 429 / -67 | ok |
| 2800 | 0.10/0.10 | DQ/DM write | netlen | 528 | 284 | +308 | +159 | 824 / -94 | ok |
| 2800 | 0.10/0.10 | DQ/DM read | netlen | 312 | 322 | +137 | +66 | 462 / -56 | ok |
| 2800 | 0.10/0.10 | CA | netlen | 307 | 685 | +77 | +226 | 426 / -62 | ok |
| 2800 | 0.09/0.09 | DQ/DM write | netlen | 514 | 281 | +293 | +157 | 829 / -99 | ok |
| 2800 | 0.09/0.09 | DQ/DM read | netlen | 300 | 322 | +130 | +66 | 463 / -57 | ok |
| 2800 | 0.09/0.09 | CA | netlen | 299 | 684 | +71 | +220 | 424 / -62 | ok |
| 3200 | 0.18/0.25 | DQ/DM write | netlen | 601 | 249 | +397 | +155 | 809 / -93 | ok |
| 3200 | 0.18/0.25 | DQ/DM read | netlen | 362 | 259 | +172 | +49 | 476 / -64 | ok |
| 3200 | 0.18/0.25 | CA | netlen | 339 | 604 | +150 | +353 | 427 / -61 | ok |
| 3200 | 0.10/0.10 | DQ/DM write | netlen | 480 | 241 | +264 | +104 | 828 / -113 | ok |
| 3200 | 0.10/0.10 | DQ/DM read | netlen | 292 | 255 | +132 | +42 | 463 / -66 | ok |
| 3200 | 0.10/0.10 | CA | netlen | 322 | 602 | +109 | +350 | 427 / -60 | ok |
| 3200 | 0.09/0.09 | DQ/DM write | netlen | 469 | 234 | +252 | +100 | 827 / -118 | ok |
| 3200 | 0.09/0.09 | DQ/DM read | netlen | 282 | 254 | +122 | +41 | 465 / -68 | ok |
| 3200 | 0.09/0.09 | CA | netlen | 312 | 602 | +101 | +350 | 424 / -59 | ok |

## Pair geometry (DQS, CK), SE at today's width

| rate | corner | inner w/gap | outer w/gap | group | eye height (mV) | eye width (ps) | margin V (mV) | margin t (ps) (vs today) | Vmax / Vmin (mV) | ±0.3 V |
|---|---|---|---|---|---|---|---|---|---|---|
| 2800 | typ | 0.14/0.15 | 0.20/0.20 | DQS write (pair) | 1331 | 337 | +1032 | +240 | 779 / -69 | ok |
| 2800 | typ | 0.14/0.15 | 0.20/0.20 | DQS read (pair) | 802 | 342 | +612 | +114 | 445 / -29 | ok |
| 2800 | typ | 0.14/0.15 | 0.20/0.20 | CK (pair, T, CK ODT 40) | 652 | 329 | +447 | +220 | 440 / -71 | ok |
| 2800 | typ | 0.10/0.13 | 0.10/0.10 | DQS write (pair) | 1300 | 339 | +1053 | +241 | 786 / -70 | ok |
| 2800 | typ | 0.10/0.13 | 0.10/0.10 | DQS read (pair) | 794 | 342 | +590 | +114 | 448 / -30 | ok |
| 2800 | typ | 0.10/0.13 | 0.10/0.10 | CK (pair, T, CK ODT 40) | 655 | 327 | +463 | +216 | 445 / -68 | ok |
| 2800 | typ | 0.10/0.10 | 0.12/0.10 | DQS write (pair) | 1321 | 338 | +1043 | +241 | 782 / -68 | ok |
| 2800 | typ | 0.10/0.10 | 0.12/0.10 | DQS read (pair) | 799 | 342 | +608 | +114 | 446 / -30 | ok |
| 2800 | typ | 0.10/0.10 | 0.12/0.10 | CK (pair, T, CK ODT 40) | 660 | 329 | +453 | +218 | 445 / -67 | ok |
| 2800 | typ | 0.09/0.20 | 0.10/0.15 | DQS write (pair) | 1245 | 339 | +1007 | +236 | 798 / -74 | ok |
| 2800 | typ | 0.09/0.20 | 0.10/0.15 | DQS read (pair) | 719 | 341 | +548 | +111 | 454 / -34 | ok |
| 2800 | typ | 0.09/0.20 | 0.10/0.15 | CK (pair, T, CK ODT 40) | 653 | 327 | +460 | +212 | 441 / -72 | ok |
| 3200 | typ | 0.14/0.15 | 0.20/0.20 | DQS write (pair) | 1309 | 260 | +1015 | +176 | 787 / -78 | ok |
| 3200 | typ | 0.14/0.15 | 0.20/0.20 | DQS read (pair) | 787 | 264 | +549 | +65 | 449 / -34 | ok |
| 3200 | typ | 0.14/0.15 | 0.20/0.20 | CK (pair, T, CK ODT 40) | 648 | 265 | +385 | +176 | 462 / -98 | ok |
| 3200 | typ | 0.10/0.13 | 0.10/0.10 | DQS write (pair) | 1305 | 261 | +994 | +177 | 799 / -86 | ok |
| 3200 | typ | 0.10/0.13 | 0.10/0.10 | DQS read (pair) | 753 | 264 | +541 | +64 | 450 / -34 | ok |
| 3200 | typ | 0.10/0.13 | 0.10/0.10 | CK (pair, T, CK ODT 40) | 647 | 263 | +393 | +173 | 452 / -94 | ok |
| 3200 | typ | 0.10/0.10 | 0.12/0.10 | DQS write (pair) | 1313 | 260 | +1014 | +177 | 791 / -81 | ok |
| 3200 | typ | 0.10/0.10 | 0.12/0.10 | DQS read (pair) | 782 | 264 | +549 | +64 | 449 / -33 | ok |
| 3200 | typ | 0.10/0.10 | 0.12/0.10 | CK (pair, T, CK ODT 40) | 647 | 264 | +384 | +175 | 458 / -96 | ok |
| 3200 | typ | 0.09/0.20 | 0.10/0.15 | DQS write (pair) | 1254 | 262 | +931 | +168 | 809 / -90 | ok |
| 3200 | typ | 0.09/0.20 | 0.10/0.15 | DQS read (pair) | 715 | 263 | +513 | +64 | 450 / -37 | ok |
| 3200 | typ | 0.09/0.20 | 0.10/0.15 | CK (pair, T, CK ODT 40) | 647 | 259 | +388 | +169 | 444 / -85 | ok |

## Field solve (zsolve_widths.py)

| layer | kind | w (mm) | gap (mm) | Z (Ω) | ps/mm |
|---|---|---|---|---|---|
| inner | SE | 0.18 |  | 39.8 | 7.024 |
| inner | SE | 0.15 |  | 43.7 | 7.020 |
| inner | SE | 0.12 |  | 48.6 | 7.015 |
| inner | SE | 0.10 |  | 52.6 | 7.011 |
| inner | SE | 0.09 |  | 54.9 | 7.008 |
| outer | SE | 0.25 |  | 39.3 | 6.195 |
| outer | SE | 0.20 |  | 44.3 | 6.162 |
| outer | SE | 0.15 |  | 51.0 | 6.126 |
| outer | SE | 0.12 |  | 56.2 | 6.105 |
| outer | SE | 0.10 |  | 60.4 | 6.092 |
| outer | SE | 0.09 |  | 62.7 | 6.085 |
| inner | DIFF | 0.14 | 0.15 | 80.6 | 6.996 |
| inner | DIFF | 0.12 | 0.12 | 82.7 | 6.988 |
| inner | DIFF | 0.10 | 0.1 | 85.4 | 6.980 |
| inner | DIFF | 0.10 | 0.13 | 90.3 | 6.985 |
| inner | DIFF | 0.10 | 0.15 | 92.8 | 6.988 |
| inner | DIFF | 0.10 | 0.2 | 97.2 | 6.993 |
| inner | DIFF | 0.09 | 0.15 | 96.6 | 6.985 |
| inner | DIFF | 0.09 | 0.2 | 101.3 | 6.991 |
| inner | DIFF | 0.11 | 0.11 | 84.1 | 6.984 |
| inner | DIFF | 0.12 | 0.2 | 90.0 | 6.998 |
| outer | DIFF | 0.20 | 0.2 | 79.6 | 5.963 |
| outer | DIFF | 0.15 | 0.12 | 82.2 | 5.933 |
| outer | DIFF | 0.12 | 0.1 | 85.0 | 5.947 |
| outer | DIFF | 0.12 | 0.15 | 94.5 | 5.913 |
| outer | DIFF | 0.10 | 0.1 | 90.3 | 5.948 |
| outer | DIFF | 0.10 | 0.15 | 100.9 | 5.908 |
| outer | DIFF | 0.10 | 0.2 | 106.9 | 5.911 |
| outer | DIFF | 0.15 | 0.2 | 91.0 | 5.934 |
| outer | DIFF | 0.09 | 0.15 | 104.5 | 5.907 |
