johonkanen/efinix_soc_board/kicad/ti135_card.kicad_pcb

## KiCad design kicad/ti135_card.kicad_pcb (2026-11-14)

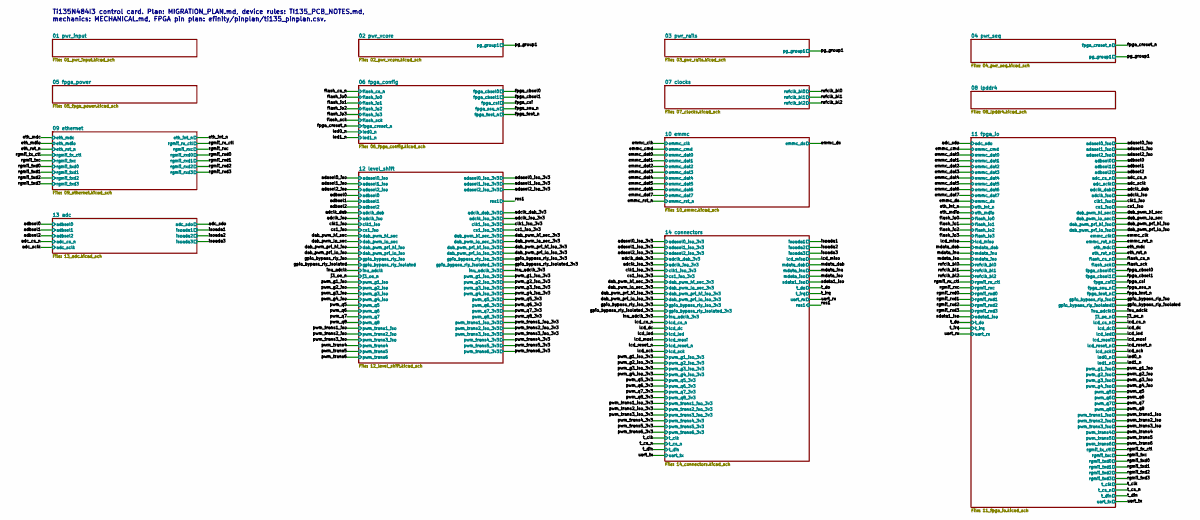
[picture p1: schematic ti135_card.kicad_sch, Ti135 control card]

Notes on the sheet:
Ti135N484I3 control card. Plan: MIGRATION_PLAN.md, device rules: TI135_PCB_NOTES.md, mechanics: MECHANICAL.md, FPGA pin plan: efinity/pinplan/ti135_pinplan.csv.

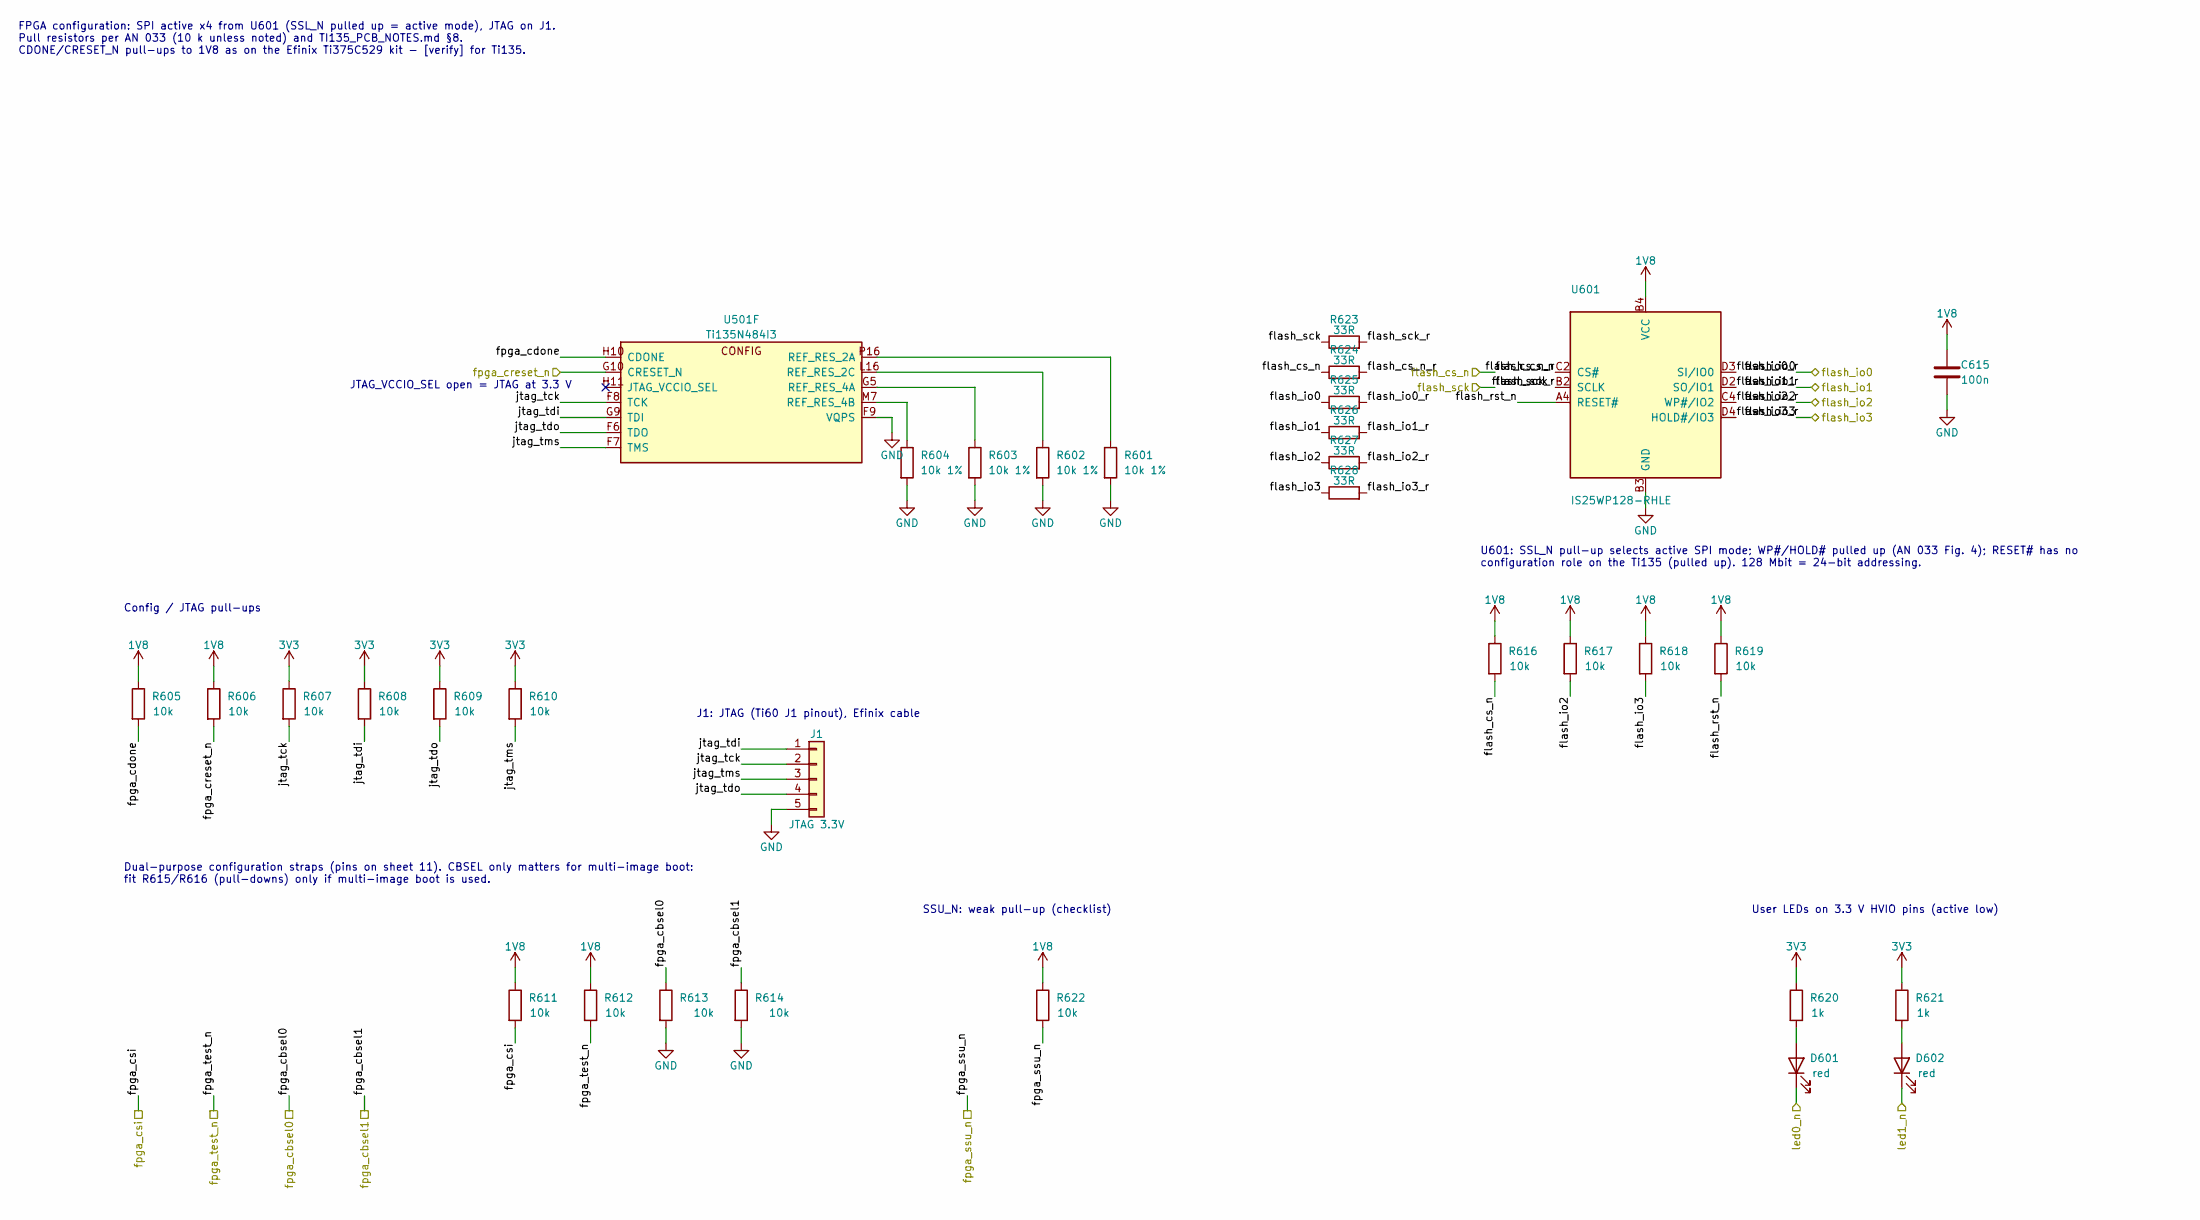
[picture p2: schematic 06_fpga_config.kicad_sch, Ti135 control card - fpga_config]

Parts:
C615: 100n; C_0201_0603Metric; LCSC C190183
D601, D602: red; LED_0603_1608Metric; LCSC C2286
J1: JTAG 3.3V; PinHeader_1x05_P2.54mm_Vertical; LCSC C492404
R601: 10k 1%; R_0201_0603Metric; LCSC C106225
R602, R603, R604: 10k 1%; R_0402_1005Metric; LCSC C25744
R605, R606, R607, R608, R609, R610, R611, R612, R613, R614, R616, R617, R618, R619, R622: 10k; R_0201_0603Metric; LCSC C473048
R620, R621: 1k; R_0402_1005Metric; LCSC C11702
R623, R624, R625, R626, R627, R628: 33R; R_0201_0603Metric; LCSC C320843
U501: Ti135N484I3; LFBGA-484_18x18mm_Layout22x22_P0.8mm
U601: IS25WP128-RHLE; MX25U25645G_CSP24_6x8mm_P1.0mm; LCSC C1349419

Connections:
1V8: C615.1, R605.1, R606.1, R611.1, R612.1, R616.1, R617.1, R618.1, R619.1, R622.1, U601.B4 (VCC); also elsewhere on the board
3V3: R607.1, R608.1, R609.1, R610.1, R620.1, R621.1; also elsewhere on the board
/06 fpga_config/flash_cs_n_r: R624.2, U601.C2 (CS#)
/06 fpga_config/flash_io0_r: R625.2, U601.D3 (SI/IO0)
/06 fpga_config/flash_io1_r: R626.2, U601.D2 (SO/IO1)
/06 fpga_config/flash_io2_r: R627.2, U601.C4 (WP#/IO2)
/06 fpga_config/flash_io3_r: R628.2, U601.D4 (HOLD#/IO3)
/06 fpga_config/flash_rst_n: R619.2, U601.A4 (RESET#)
/06 fpga_config/flash_sck_r: R623.2, U601.B2 (SCLK)
/06 fpga_config/fpga_cdone: R605.2, U501.H10 (CDONE)
/06 fpga_config/jtag_tck: J1.2, R607.2, U501.F8 (TCK)
/06 fpga_config/jtag_tdi: J1.1, R608.2, U501.G9 (TDI)
/06 fpga_config/jtag_tdo: J1.4, R609.2, U501.F6 (TDO)
/06 fpga_config/jtag_tms: J1.3, R610.2, U501.F7 (TMS)
/flash_cs_n: R616.2, R624.1; also elsewhere on the board
/flash_io0: R625.1; also elsewhere on the board
/flash_io1: R626.1; also elsewhere on the board
/flash_io2: R617.2, R627.1; also elsewhere on the board
/flash_io3: R618.2, R628.1; also elsewhere on the board
/flash_sck: R623.1; also elsewhere on the board
/fpga_cbsel0: R613.1; also elsewhere on the board
/fpga_cbsel1: R614.1; also elsewhere on the board
/fpga_creset_n: R606.2, U501.G10 (CRESET_N); also elsewhere on the board
/fpga_csi: R611.2; also elsewhere on the board
/fpga_ssu_n: R622.2; also elsewhere on the board
/fpga_test_n: R612.2; also elsewhere on the board
/led0_n: D601.1 (K); also elsewhere on the board
/led1_n: D602.1 (K); also elsewhere on the board
GND: C615.2, J1.5, R601.2, R602.2, R603.2, R604.2, R613.2, R614.2, U501.F9 (VQPS), U601.B3 (GND); also elsewhere on the board
unnamed: D601.2 (A), R620.2
unnamed: D602.2 (A), R621.2
unnamed: R601.1, U501.P16 (REF_RES_2A)
unnamed: R602.1, U501.L16 (REF_RES_2C)
unnamed: R603.1, U501.G5 (REF_RES_4A)
unnamed: R604.1, U501.M7 (REF_RES_4B)

Notes on the sheet:
Config / JTAG pull-ups
User LEDs on 3.3 V HVIO pins (active low)
JTAG_VCCIO_SEL open = JTAG at 3.3 V
SSU_N: weak pull-up (checklist)
U601: SSL_N pull-up selects active SPI mode; WP#/HOLD# pulled up (AN 033 Fig. 4); RESET# has no configuration role on the Ti135 (pulled up). 128 Mbit = 24-bit addressing.
J1: JTAG (Ti60 J1 pinout), Efinix cable
Dual-purpose configuration straps (pins on sheet 11). CBSEL only matters for multi-image boot: fit R615/R616 (pull-downs) only if multi-image boot is used.
FPGA configuration: SPI active x4 from U601 (SSL_N pulled up = active mode), JTAG on J1. Pull resistors per AN 033 (10 k unless noted) and TI135_PCB_NOTES.md §8. CDONE/CRESET_N pull-ups to 1V8 as on the Efinix Ti375C529 kit - [verify] for Ti135.

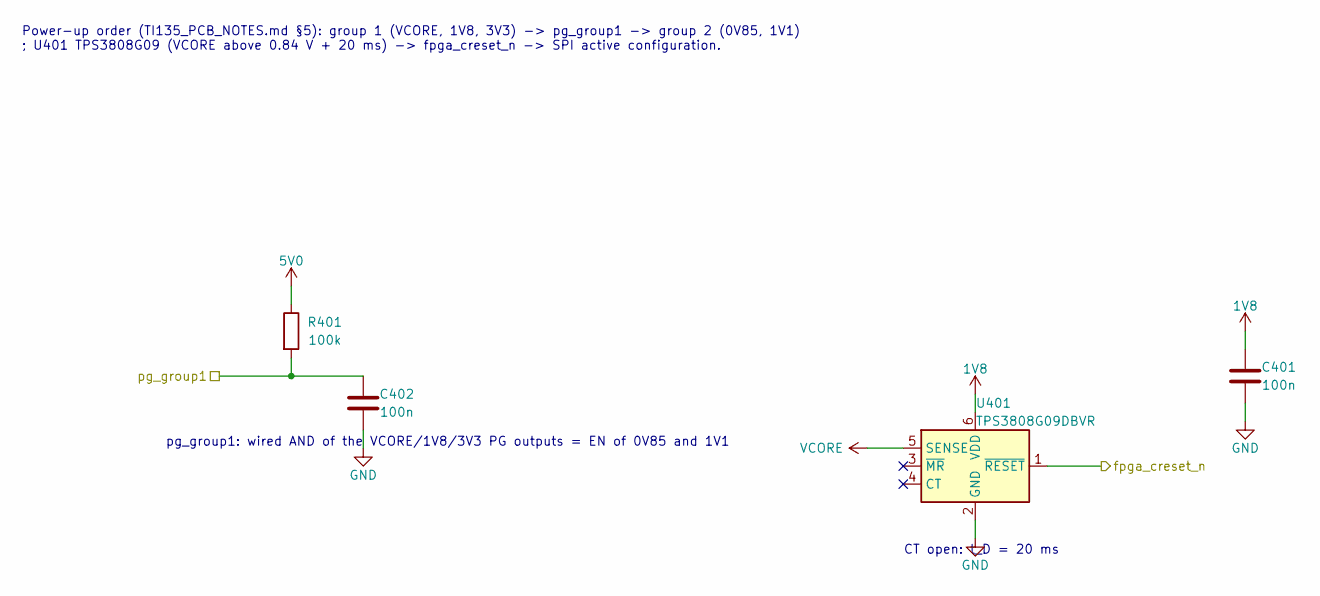
[picture p3: schematic 04_pwr_seq.kicad_sch, Ti135 control card - pwr_seq]

Parts:
C401, C402: 100n; C_0201_0603Metric; LCSC C190183
R401: 100k; R_0402_1005Metric; LCSC C25741
U401: TPS3808G09DBVR; SOT-23-6; LCSC C24584

Connections:
1V8: C401.1, U401.6 (VDD); also elsewhere on the board
5V0: R401.1; also elsewhere on the board
/fpga_creset_n: U401.1 (~RESET); also elsewhere on the board
/pg_group1: C402.1, R401.2; also elsewhere on the board
GND: C401.2, C402.2, U401.2 (GND); also elsewhere on the board
VCORE: U401.5 (SENSE); also elsewhere on the board

Notes on the sheet:
CT open: t_D = 20 ms
pg_group1: wired AND of the VCORE/1V8/3V3 PG outputs = EN of 0V85 and 1V1
Power-up order (TI135_PCB_NOTES.md §5): group 1 (VCORE, 1V8, 3V3) -> pg_group1 -> group 2 (0V85, 1V1) ; U401 TPS3808G09 (VCORE above 0.84 V + 20 ms) -> fpga_creset_n -> SPI active configuration.

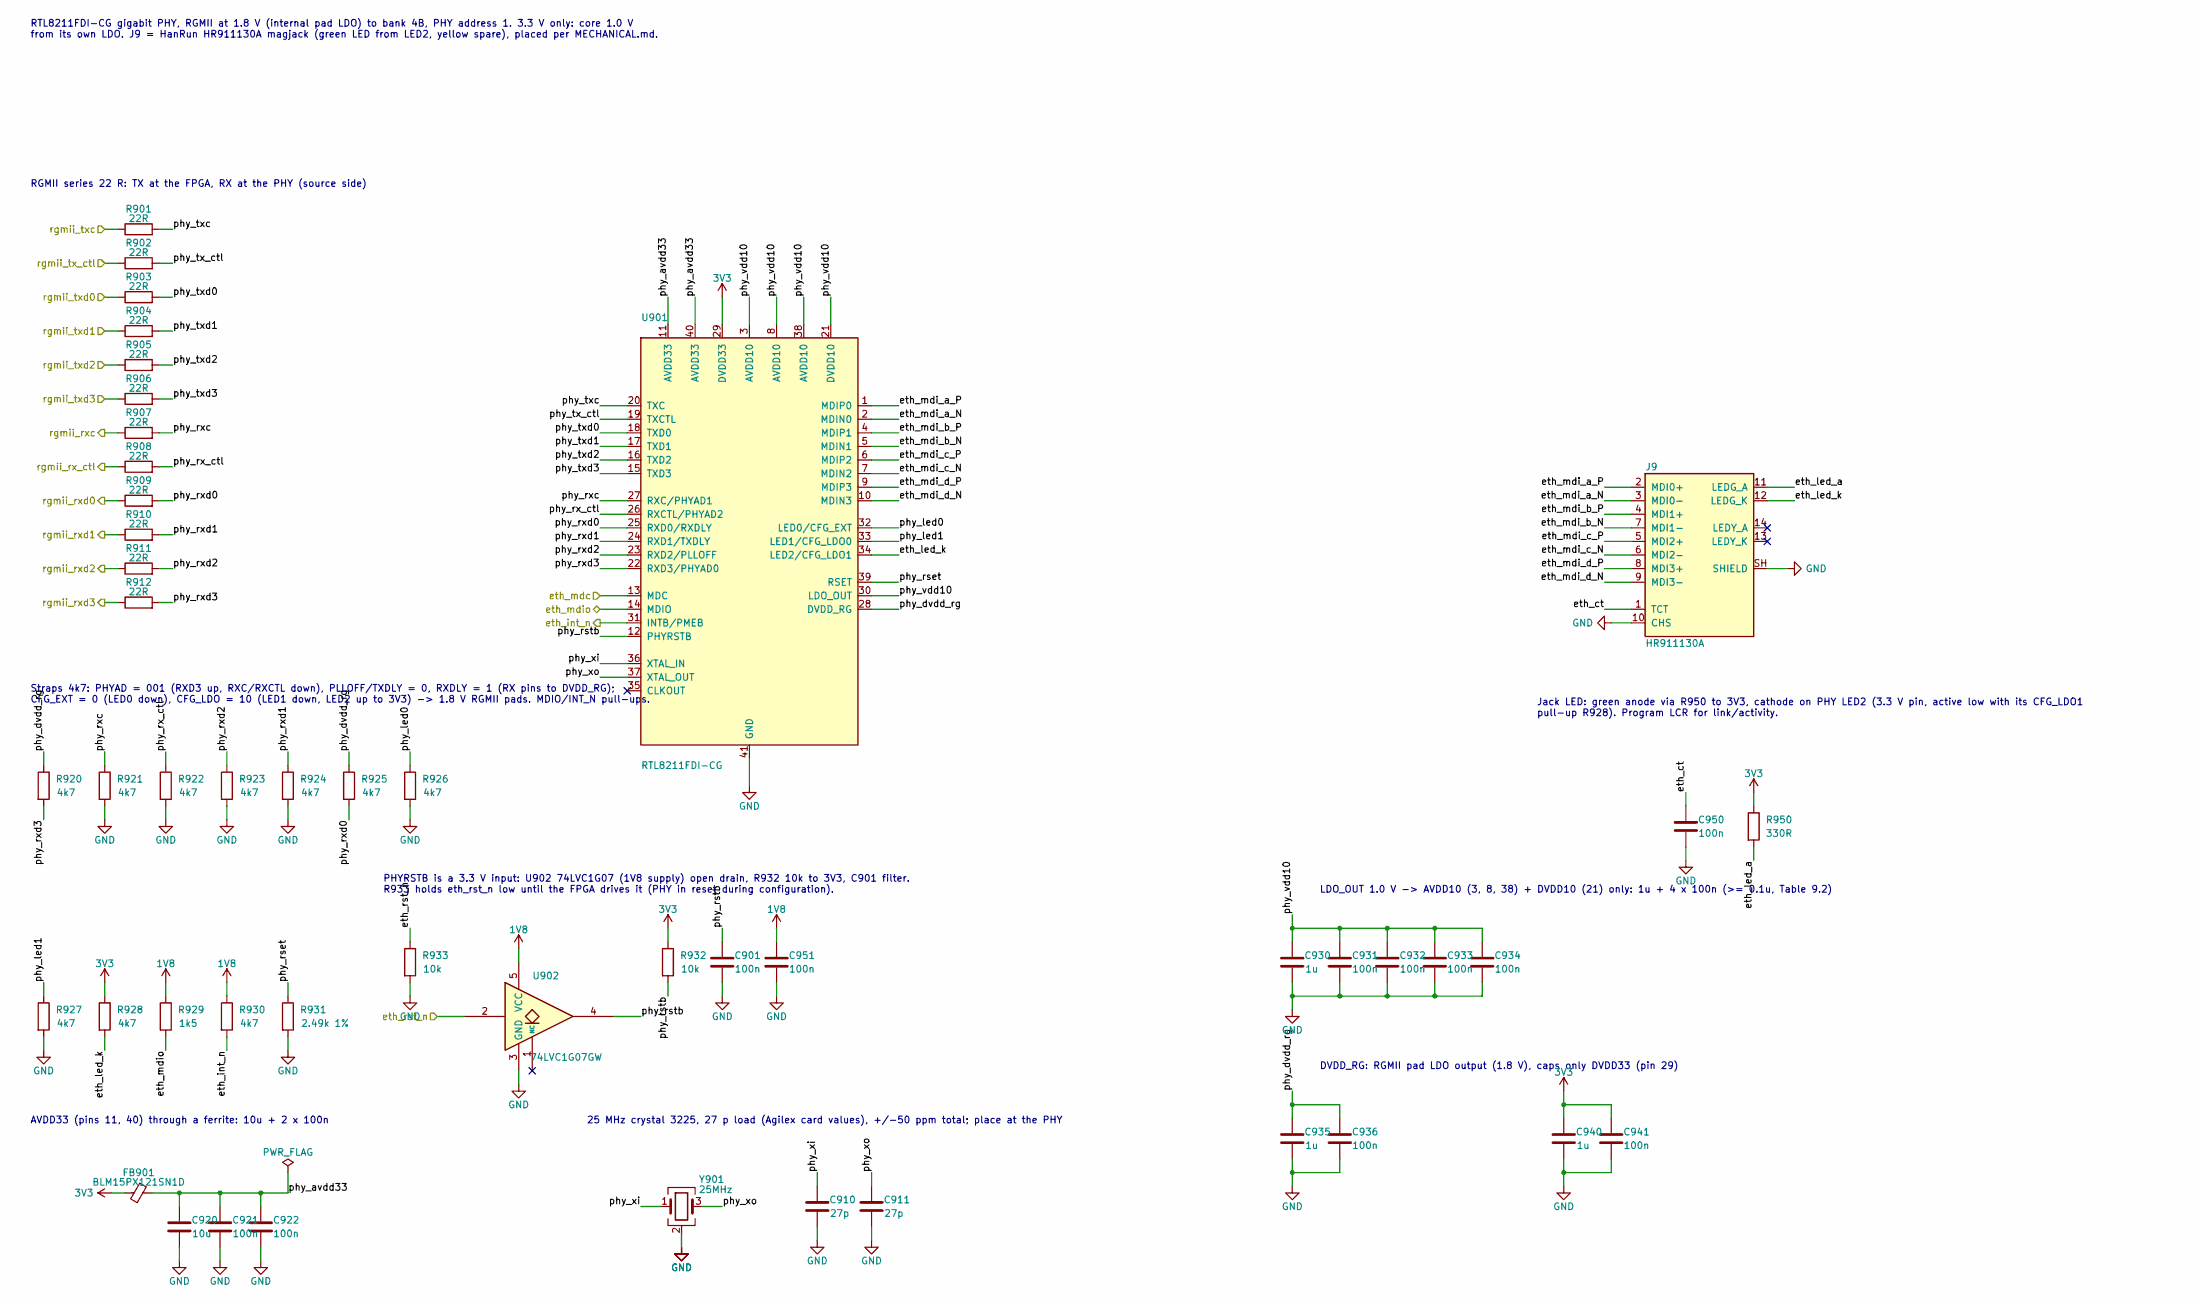
[picture p4: schematic 09_ethernet.kicad_sch, Ti135 control card - ethernet]

Parts:
C901, C950: 100n; C_0402_1005Metric; LCSC C1525
C910, C911: 27p; C_0402_1005Metric; LCSC C1557
C920: 10u; C_0805_2012Metric; LCSC C15850
C921, C922, C931, C932, C933, C934, C936, C941, C951: 100n; C_0201_0603Metric; LCSC C190183
C930, C935, C940: 1u; C_0201_0603Metric; LCSC C272877
FB901: BLM15PX121SN1D; L_0402_1005Metric; LCSC C88970
J9: HR911130A; RJ45_Hanrun_HR911130A_Horizontal; LCSC C54408
R901, R902, R903, R904, R905, R906: 22R; R_0402_1005Metric; LCSC C25092
R907, R908, R909, R910, R911, R912: 22R; R_0201_0603Metric; LCSC C155743
R920, R921, R922, R923, R924, R925: 4k7; R_0201_0603Metric; LCSC C270346
R926, R927, R928, R930: 4k7; R_0402_1005Metric; LCSC C25900
R929: 1k5; R_0402_1005Metric; LCSC C25867
R931: 2.49k 1%; R_0402_1005Metric; LCSC C25884
R932, R933: 10k; R_0402_1005Metric; LCSC C25744
R950: 330R; R_0402_1005Metric; LCSC C25104
U901: RTL8211FDI-CG; QFN-40-1EP_5x5mm_P0.4mm_EP3.6x3.6mm_ThermalVias; LCSC C692886
U902: 74LVC1G07GW; SOT-353_SC-70-5; LCSC C282345
Y901: 25MHz; Crystal_SMD_3225-4Pin_3.2x2.5mm; LCSC C70593

Connections:
1V8: C951.1, R929.1, R930.1, U902.5 (VCC); also elsewhere on the board
3V3: C940.1, C941.1, FB901.1, R928.1, R932.1, R950.1, U901.29 (DVDD33); also elsewhere on the board
/09 ethernet/eth_ct: C950.1, J9.1 (TCT)
/09 ethernet/eth_led_a: J9.11 (LEDG_A), R950.2
/09 ethernet/eth_led_k: J9.12 (LEDG_K), R928.2, U901.34 (LED2/CFG_LDO1)
/09 ethernet/eth_mdi_a_N: J9.3 (MDI0-), U901.2 (MDIN0)
/09 ethernet/eth_mdi_a_P: J9.2 (MDI0+), U901.1 (MDIP0)
/09 ethernet/eth_mdi_b_N: J9.7 (MDI1-), U901.5 (MDIN1)
/09 ethernet/eth_mdi_b_P: J9.4 (MDI1+), U901.4 (MDIP1)
/09 ethernet/eth_mdi_c_N: J9.6 (MDI2-), U901.7 (MDIN2)
/09 ethernet/eth_mdi_c_P: J9.5 (MDI2+), U901.6 (MDIP2)
/09 ethernet/eth_mdi_d_N: J9.9 (MDI3-), U901.10 (MDIN3)
/09 ethernet/eth_mdi_d_P: J9.8 (MDI3+), U901.9 (MDIP3)
/09 ethernet/phy_avdd33: C920.1, C921.1, C922.1, FB901.2, U901.11 (AVDD33), U901.40 (AVDD33)
/09 ethernet/phy_dvdd_rg: C935.1, C936.1, R920.1, R925.1, U901.28 (DVDD_RG)
/09 ethernet/phy_led0: R926.1, U901.32 (LED0/CFG_EXT)
/09 ethernet/phy_led1: R927.1, U901.33 (LED1/CFG_LDO0)
/09 ethernet/phy_rset: R931.1, U901.39 (RSET)
/09 ethernet/phy_rstb: C901.1, R932.2, U901.12 (PHYRSTB), U902.4
/09 ethernet/phy_rx_ctl: R908.2, R922.1, U901.26 (RXCTL/PHYAD2)
/09 ethernet/phy_rxc: R907.2, R921.1, U901.27 (RXC/PHYAD1)
/09 ethernet/phy_rxd0: R909.2, R925.2, U901.25 (RXD0/RXDLY)
/09 ethernet/phy_rxd1: R910.2, R924.1, U901.24 (RXD1/TXDLY)
/09 ethernet/phy_rxd2: R911.2, R923.1, U901.23 (RXD2/PLLOFF)
/09 ethernet/phy_rxd3: R912.2, R920.2, U901.22 (RXD3/PHYAD0)
/09 ethernet/phy_tx_ctl: R902.2, U901.19 (TXCTL)
/09 ethernet/phy_txc: R901.2, U901.20 (TXC)
/09 ethernet/phy_txd0: R903.2, U901.18 (TXD0)
/09 ethernet/phy_txd1: R904.2, U901.17 (TXD1)
/09 ethernet/phy_txd2: R905.2, U901.16 (TXD2)
/09 ethernet/phy_txd3: R906.2, U901.15 (TXD3)
/09 ethernet/phy_vdd10: C930.1, C931.1, C932.1, C933.1, C934.1, U901.3 (AVDD10), U901.8 (AVDD10), U901.21 (DVDD10), U901.30 (LDO_OUT), U901.38 (AVDD10)
/09 ethernet/phy_xi: C910.1, U901.36 (XTAL_IN), Y901.1
/09 ethernet/phy_xo: C911.1, U901.37 (XTAL_OUT), Y901.3
/eth_int_n: R930.2, U901.31 (INTB/PMEB); also elsewhere on the board
/eth_mdc: U901.13 (MDC); also elsewhere on the board
/eth_mdio: R929.2, U901.14 (MDIO); also elsewhere on the board
/eth_rst_n: R933.1, U902.2; also elsewhere on the board
/rgmii_rx_ctl: R908.1; also elsewhere on the board
/rgmii_rxc: R907.1; also elsewhere on the board
/rgmii_rxd0: R909.1; also elsewhere on the board
/rgmii_rxd1: R910.1; also elsewhere on the board
/rgmii_rxd2: R911.1; also elsewhere on the board
/rgmii_rxd3: R912.1; also elsewhere on the board
/rgmii_tx_ctl: R902.1; also elsewhere on the board
/rgmii_txc: R901.1; also elsewhere on the board
/rgmii_txd0: R903.1; also elsewhere on the board
/rgmii_txd1: R904.1; also elsewhere on the board
/rgmii_txd2: R905.1; also elsewhere on the board
/rgmii_txd3: R906.1; also elsewhere on the board
GND: C901.2, C910.2, C911.2, C920.2, C921.2, C922.2, C930.2, C931.2, C932.2, C933.2, C934.2, C935.2, C936.2, C940.2, C941.2, C950.2, C951.2, J9.10 (CHS), J9.SH (SHIELD), R921.2, R922.2, R923.2, R924.2, R926.2, R927.2, R931.2, R933.2, U901.41 (GND), U902.3 (GND), Y901.2 (G), Y901.4 (G); also elsewhere on the board

Notes on the sheet:
RGMII series 22 R: TX at the FPGA, RX at the PHY (source side)
LDO_OUT 1.0 V -> AVDD10 (3, 8, 38) + DVDD10 (21) only: 1u + 4 x 100n (>= 0.1u, Table 9.2)
PHYRSTB is a 3.3 V input: U902 74LVC1G07 (1V8 supply) open drain, R932 10k to 3V3, C901 filter. R933 holds eth_rst_n low until the FPGA drives it (PHY in reset during configuration).
DVDD_RG: RGMII pad LDO output (1.8 V), caps only
Jack LED: green anode via R950 to 3V3, cathode on PHY LED2 (3.3 V pin, active low with its CFG_LDO1 pull-up R928). Program LCR for link/activity.
Straps 4k7: PHYAD = 001 (RXD3 up, RXC/RXCTL down), PLLOFF/TXDLY = 0, RXDLY = 1 (RX pins to DVDD_RG); CFG_EXT = 0 (LED0 down), CFG_LDO = 10 (LED1 down, LED2 up to 3V3) -> 1.8 V RGMII pads. MDIO/INT_N pull-ups.
25 MHz crystal 3225, 27 p load (Agilex card values), +/-50 ppm total; place at the PHY
RTL8211FDI-CG gigabit PHY, RGMII at 1.8 V (internal pad LDO) to bank 4B, PHY address 1. 3.3 V only: core 1.0 V from its own LDO. J9 = HanRun HR911130A magjack (green LED from LED2, yellow spare), placed per MECHANICAL.md.
DVDD33 (pin 29)
AVDD33 (pins 11, 40) through a ferrite: 10u + 2 x 100n

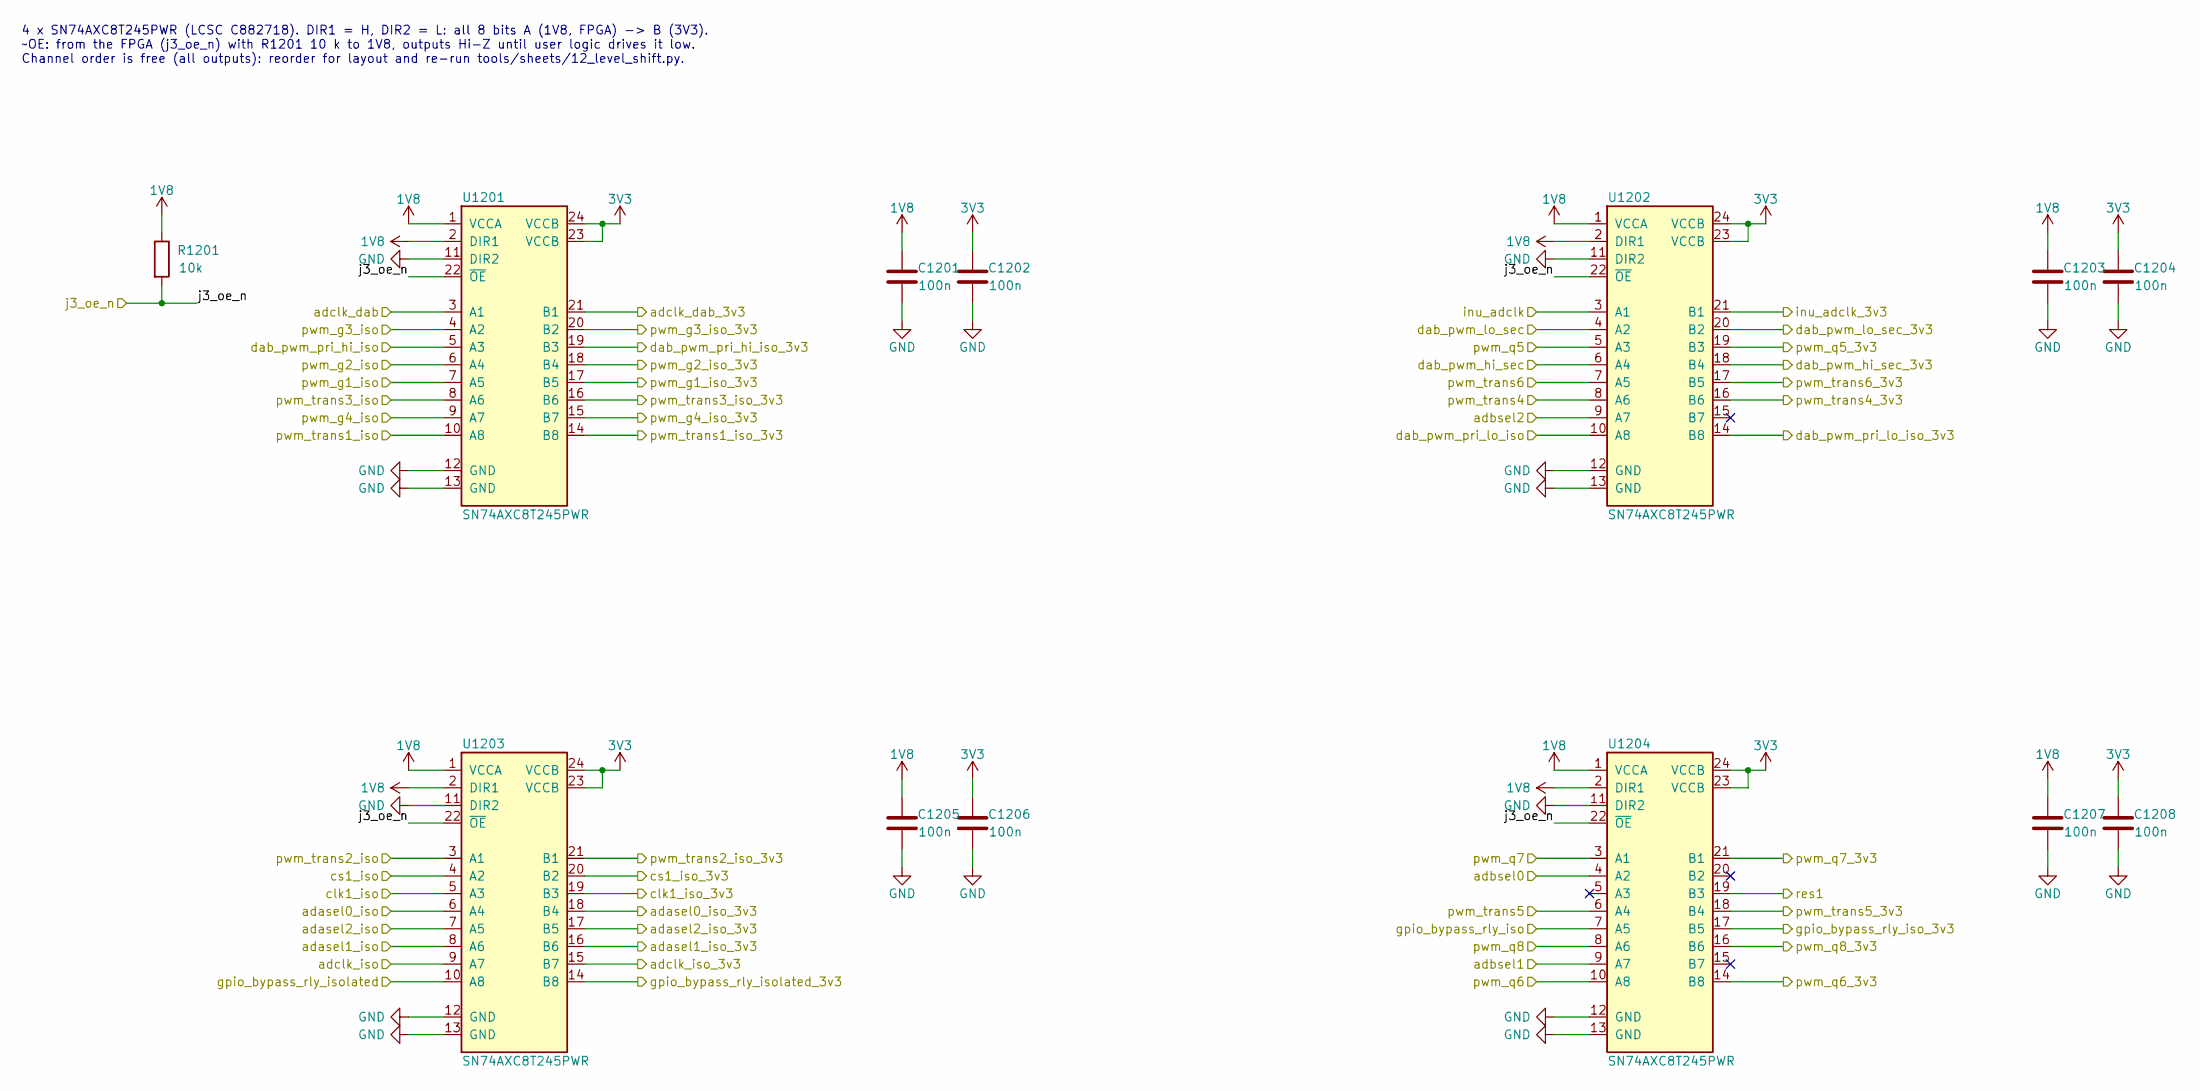
[picture p5: schematic 12_level_shift.kicad_sch, Ti135 control card - level_shift]

Parts:
C1201, C1202, C1203, C1204, C1205, C1206, C1207, C1208: 100n; C_0201_0603Metric; LCSC C190183
R1201: 10k; R_0402_1005Metric; LCSC C25744
U1201, U1202, U1203, U1204: SN74AXC8T245PWR; TSSOP-24_4.4x7.8mm_P0.65mm; LCSC C882718

Connections:
1V8: C1201.1, C1203.1, C1205.1, C1207.1, R1201.1, U1201.1 (VCCA), U1201.2 (DIR1), U1202.1 (VCCA), U1202.2 (DIR1), U1203.1 (VCCA), U1203.2 (DIR1), U1204.1 (VCCA), U1204.2 (DIR1); also elsewhere on the board
3V3: C1202.1, C1204.1, C1206.1, C1208.1, U1201.23 (VCCB), U1201.24 (VCCB), U1202.23 (VCCB), U1202.24 (VCCB), U1203.23 (VCCB), U1203.24 (VCCB), U1204.23 (VCCB), U1204.24 (VCCB); also elsewhere on the board
/adasel0_iso: U1203.6 (A4); also elsewhere on the board
/adasel0_iso_3v3: U1203.18 (B4); also elsewhere on the board
/adasel1_iso: U1203.8 (A6); also elsewhere on the board
/adasel1_iso_3v3: U1203.16 (B6); also elsewhere on the board
/adasel2_iso: U1203.7 (A5); also elsewhere on the board
/adasel2_iso_3v3: U1203.17 (B5); also elsewhere on the board
/adbsel0: U1204.4 (A2); also elsewhere on the board
/adbsel1: U1204.9 (A7); also elsewhere on the board
/adbsel2: U1202.9 (A7); also elsewhere on the board
/adclk_dab: U1201.3 (A1); also elsewhere on the board
/adclk_dab_3v3: U1201.21 (B1); also elsewhere on the board
/adclk_iso: U1203.9 (A7); also elsewhere on the board
/adclk_iso_3v3: U1203.15 (B7); also elsewhere on the board
/clk1_iso: U1203.5 (A3); also elsewhere on the board
/clk1_iso_3v3: U1203.19 (B3); also elsewhere on the board
/cs1_iso: U1203.4 (A2); also elsewhere on the board
/cs1_iso_3v3: U1203.20 (B2); also elsewhere on the board
/dab_pwm_hi_sec: U1202.6 (A4); also elsewhere on the board
/dab_pwm_hi_sec_3v3: U1202.18 (B4); also elsewhere on the board
/dab_pwm_lo_sec: U1202.4 (A2); also elsewhere on the board
/dab_pwm_lo_sec_3v3: U1202.20 (B2); also elsewhere on the board
/dab_pwm_pri_hi_iso: U1201.5 (A3); also elsewhere on the board
/dab_pwm_pri_hi_iso_3v3: U1201.19 (B3); also elsewhere on the board
/dab_pwm_pri_lo_iso: U1202.10 (A8); also elsewhere on the board
/dab_pwm_pri_lo_iso_3v3: U1202.14 (B8); also elsewhere on the board
/gpio_bypass_rly_iso: U1204.7 (A5); also elsewhere on the board
/gpio_bypass_rly_iso_3v3: U1204.17 (B5); also elsewhere on the board
/gpio_bypass_rly_isolated: U1203.10 (A8); also elsewhere on the board
/gpio_bypass_rly_isolated_3v3: U1203.14 (B8); also elsewhere on the board
/inu_adclk: U1202.3 (A1); also elsewhere on the board
/inu_adclk_3v3: U1202.21 (B1); also elsewhere on the board
/j3_oe_n: R1201.2, U1201.22 (~OE), U1202.22 (~OE), U1203.22 (~OE), U1204.22 (~OE); also elsewhere on the board
/pwm_g1_iso: U1201.7 (A5); also elsewhere on the board
/pwm_g1_iso_3v3: U1201.17 (B5); also elsewhere on the board
/pwm_g2_iso: U1201.6 (A4); also elsewhere on the board
/pwm_g2_iso_3v3: U1201.18 (B4); also elsewhere on the board
/pwm_g3_iso: U1201.4 (A2); also elsewhere on the board
/pwm_g3_iso_3v3: U1201.20 (B2); also elsewhere on the board
/pwm_g4_iso: U1201.9 (A7); also elsewhere on the board
/pwm_g4_iso_3v3: U1201.15 (B7); also elsewhere on the board
/pwm_q5: U1202.5 (A3); also elsewhere on the board
/pwm_q5_3v3: U1202.19 (B3); also elsewhere on the board
/pwm_q6: U1204.10 (A8); also elsewhere on the board
/pwm_q6_3v3: U1204.14 (B8); also elsewhere on the board
/pwm_q7: U1204.3 (A1); also elsewhere on the board
/pwm_q7_3v3: U1204.21 (B1); also elsewhere on the board
/pwm_q8: U1204.8 (A6); also elsewhere on the board
/pwm_q8_3v3: U1204.16 (B6); also elsewhere on the board
/pwm_trans1_iso: U1201.10 (A8); also elsewhere on the board
/pwm_trans1_iso_3v3: U1201.14 (B8); also elsewhere on the board
/pwm_trans2_iso: U1203.3 (A1); also elsewhere on the board
/pwm_trans2_iso_3v3: U1203.21 (B1); also elsewhere on the board
/pwm_trans3_iso: U1201.8 (A6); also elsewhere on the board
/pwm_trans3_iso_3v3: U1201.16 (B6); also elsewhere on the board
/pwm_trans4: U1202.8 (A6); also elsewhere on the board
/pwm_trans4_3v3: U1202.16 (B6); also elsewhere on the board
/pwm_trans5: U1204.6 (A4); also elsewhere on the board
/pwm_trans5_3v3: U1204.18 (B4); also elsewhere on the board
/pwm_trans6: U1202.7 (A5); also elsewhere on the board
/pwm_trans6_3v3: U1202.17 (B5); also elsewhere on the board
/res1: U1204.19 (B3); also elsewhere on the board
GND: C1201.2, C1202.2, C1203.2, C1204.2, C1205.2, C1206.2, C1207.2, C1208.2, U1201.11 (DIR2), U1201.12 (GND), U1201.13 (GND), U1202.11 (DIR2), U1202.12 (GND), U1202.13 (GND), U1203.11 (DIR2), U1203.12 (GND), U1203.13 (GND), U1204.11 (DIR2), U1204.12 (GND), U1204.13 (GND); also elsewhere on the board

Notes on the sheet:
4 x SN74AXC8T245PWR (LCSC C882718). DIR1 = H, DIR2 = L: all 8 bits A (1V8, FPGA) -> B (3V3). ~OE: from the FPGA (j3_oe_n) with R1201 10 k to 1V8, outputs Hi-Z until user logic drives it low. Channel order is free (all outputs): reorder for layout and re-run tools/sheets/12_level_shift.py.
