johonkanen/efinix_soc_board/kicad/ti135_card.kicad_pcb

## KiCad design kicad/ti135_card.kicad_pcb (continued)

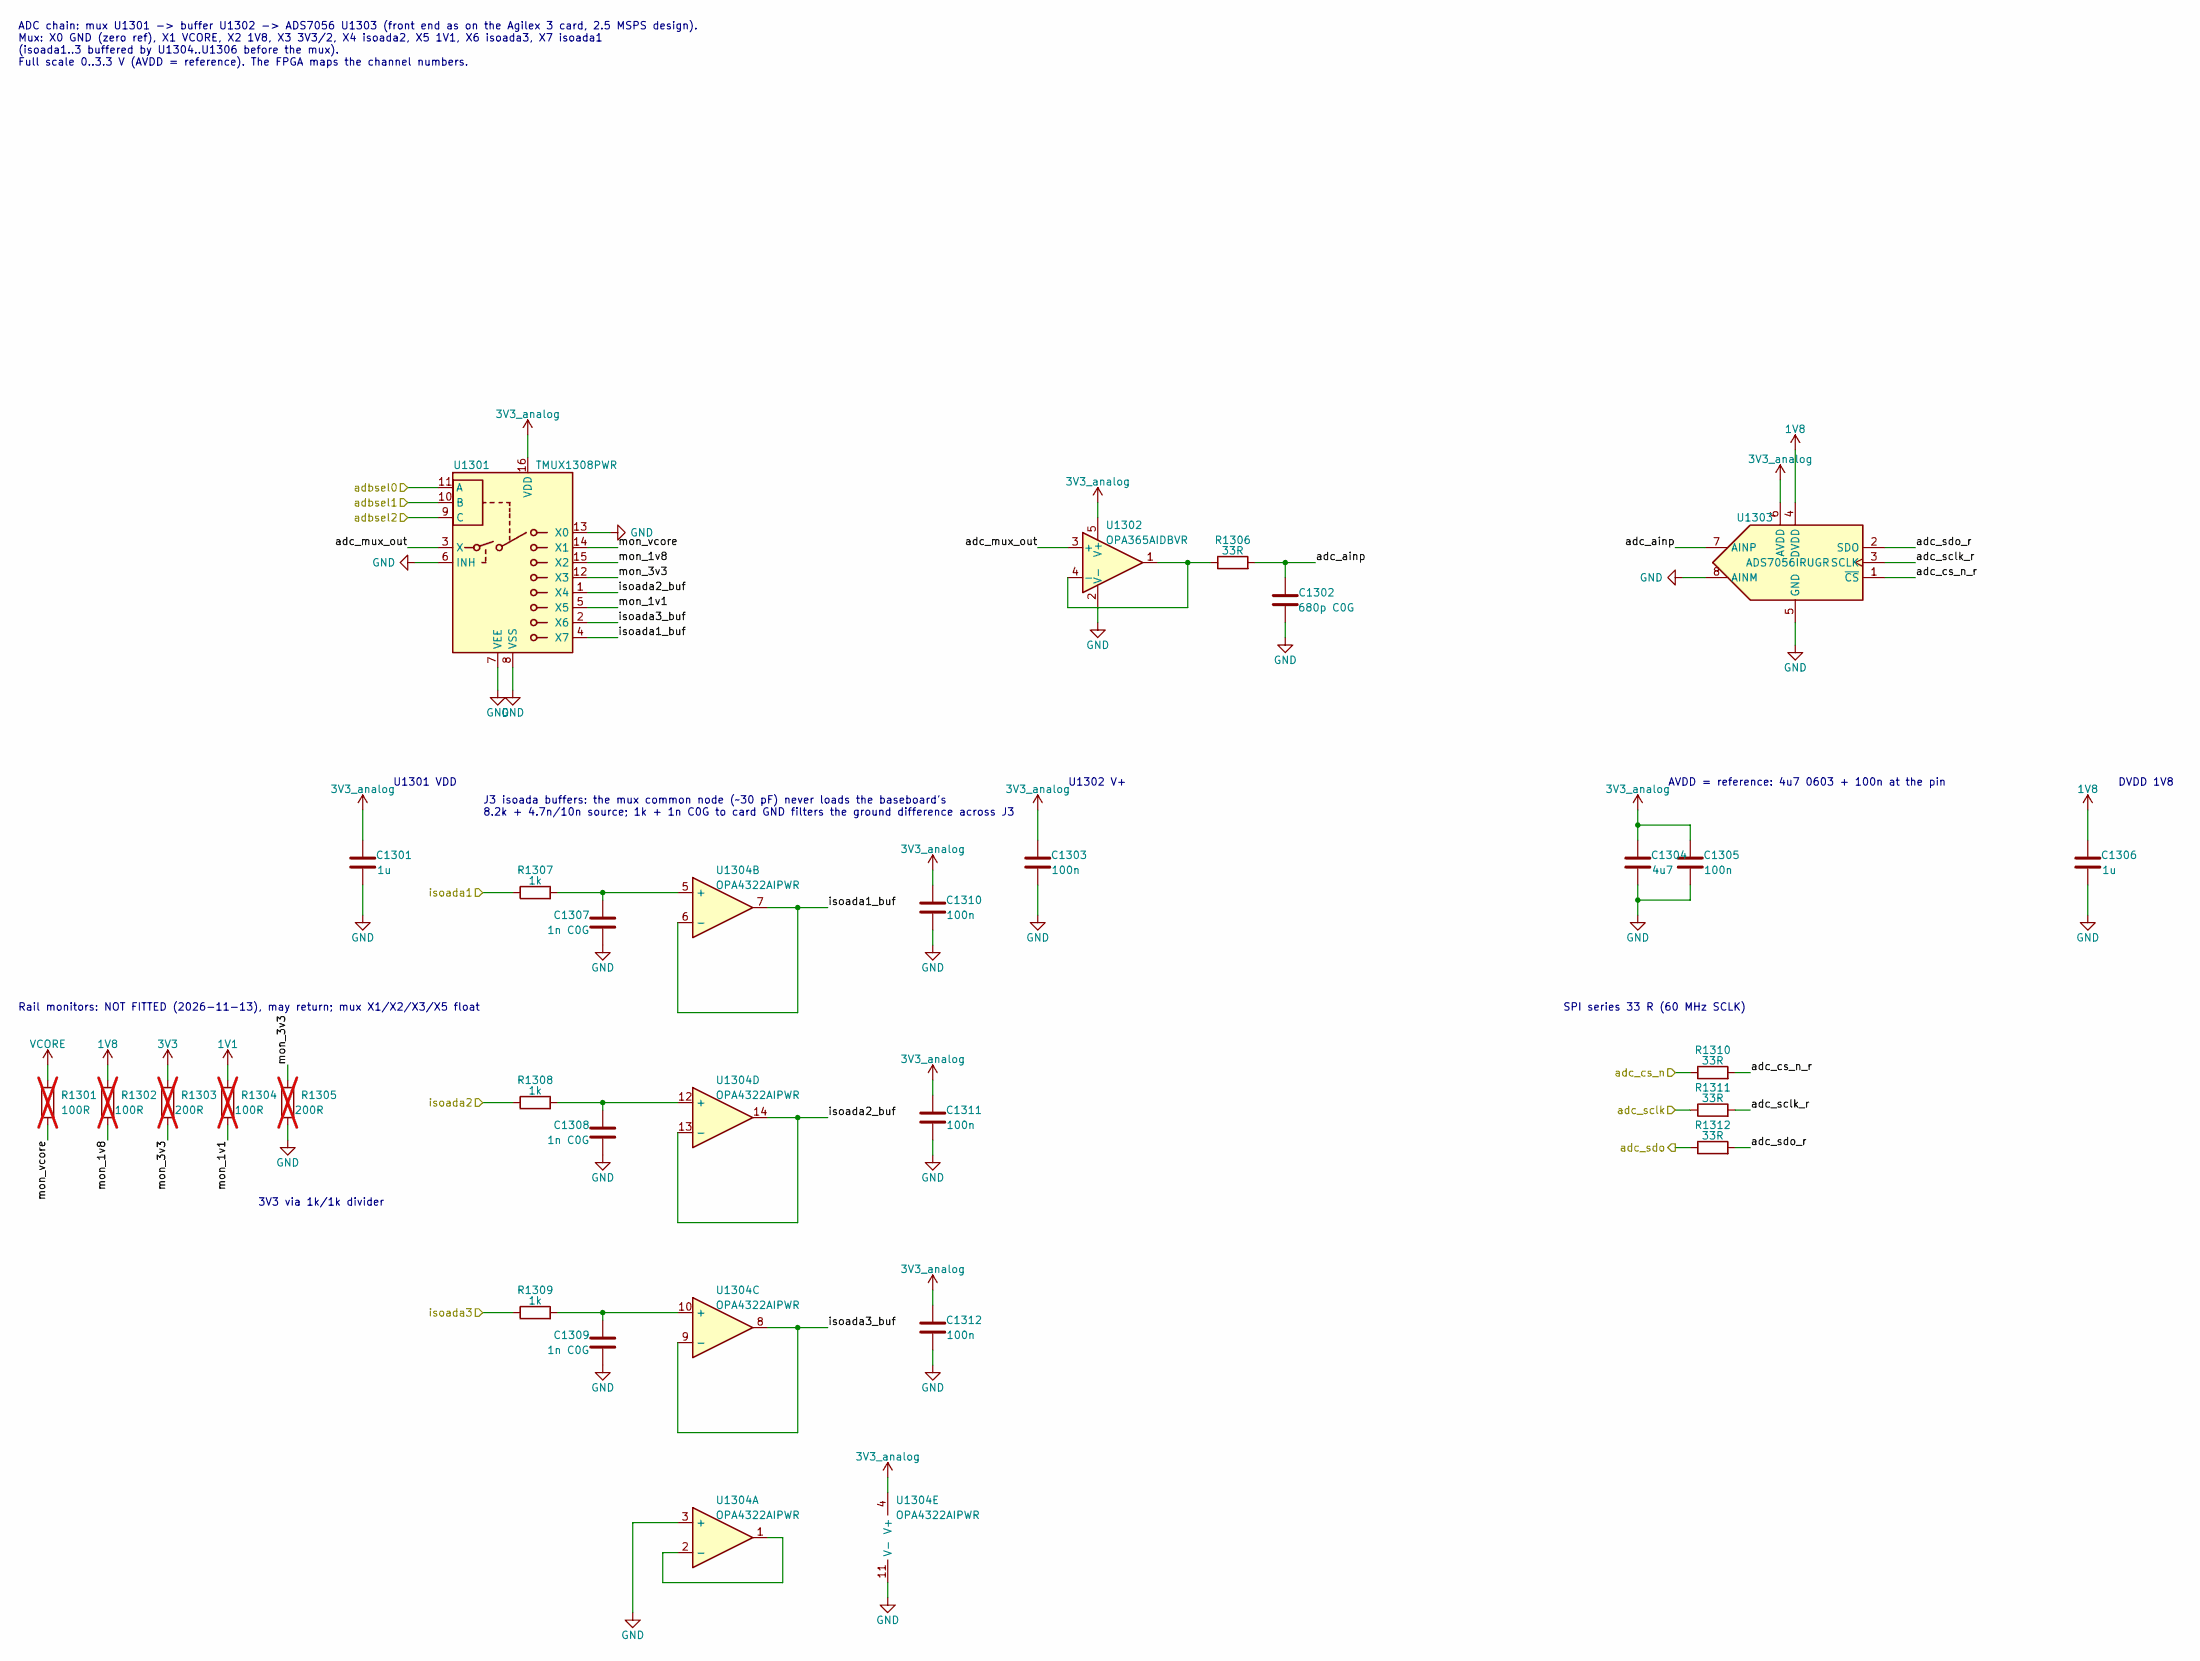
[picture p6: schematic 13_adc.kicad_sch, Ti135 control card - adc]

Parts:
C1301: 1u; C_0402_1005Metric; LCSC C52923
C1302: 680p C0G; C_0402_1005Metric; LCSC C126514
C1303, C1305, C1310, C1311, C1312: 100n; C_0402_1005Metric; LCSC C1525
C1304: 4u7; C_0603_1608Metric; LCSC C19666
C1306: 1u; C_0201_0603Metric; LCSC C272877
C1307, C1308, C1309: 1n C0G; C_0402_1005Metric; LCSC C76947
R1301, R1302, R1304: 100R; R_0402_1005Metric; LCSC C25076; not fitted
R1303, R1305: 200R; R_0402_1005Metric; LCSC C25087; not fitted
R1306, R1310, R1311, R1312: 33R; R_0402_1005Metric; LCSC C25105
R1307, R1308, R1309: 1k; R_0402_1005Metric; LCSC C11702
U1301: TMUX1308PWR; TSSOP-16_4.4x5mm_P0.65mm; LCSC C970231
U1302: OPA365AIDBVR; SOT-23-5; LCSC C96626
U1303: ADS7056IRUGR; ads7056; LCSC C2669798
U1304: OPA4322AIPWR; TSSOP-14_4.4x5mm_P0.65mm; LCSC C486027

Connections:
1V8: C1306.1, R1302.1, U1303.4 (DVDD); also elsewhere on the board
3V3_analog: C1301.1, C1303.1, C1304.1, C1305.1, C1310.1, C1311.1, C1312.1, U1301.16 (VDD), U1302.5 (V+), U1303.6 (AVDD), U1304.4 (V+); also elsewhere on the board
/13 adc/adc_ainp: C1302.1, R1306.2, U1303.7 (AINP)
/13 adc/adc_cs_n_r: R1310.2, U1303.1 (~CS)
/13 adc/adc_mux_out: U1301.3 (X), U1302.3 (+)
/13 adc/adc_sclk_r: R1311.2, U1303.3 (SCLK)
/13 adc/adc_sdo_r: R1312.2, U1303.2 (SDO)
/13 adc/isoada1_buf: U1301.4 (X7), U1304.6 (-), U1304.7
/13 adc/isoada2_buf: U1301.1 (X4), U1304.13 (-), U1304.14
/13 adc/isoada3_buf: U1301.2 (X6), U1304.8, U1304.9 (-)
/13 adc/mon_1v1: R1304.2, U1301.5 (X5)
/13 adc/mon_1v8: R1302.2, U1301.15 (X2)
/13 adc/mon_3v3: R1303.2, R1305.1, U1301.12 (X3)
/13 adc/mon_vcore: R1301.2, U1301.14 (X1)
/adbsel0: U1301.11 (A); also elsewhere on the board
/adbsel1: U1301.10 (B); also elsewhere on the board
/adbsel2: U1301.9 (C); also elsewhere on the board
/adc_cs_n: R1310.1; also elsewhere on the board
/adc_sclk: R1311.1; also elsewhere on the board
/adc_sdo: R1312.1; also elsewhere on the board
/isoada1: R1307.1; also elsewhere on the board
/isoada2: R1308.1; also elsewhere on the board
/isoada3: R1309.1; also elsewhere on the board
GND: C1301.2, C1302.2, C1303.2, C1304.2, C1305.2, C1306.2, C1307.2, C1308.2, C1309.2, C1310.2, C1311.2, C1312.2, R1305.2, U1301.6 (INH), U1301.7 (VEE), U1301.8 (VSS), U1301.13 (X0), U1302.2 (V-), U1303.5 (GND), U1303.8 (AINM), U1304.3 (+), U1304.11 (V-); also elsewhere on the board
unnamed: R1306.1, U1302.1, U1302.4 (-)
unnamed: U1304.1, U1304.2 (-)
unnamed: C1307.1, R1307.2, U1304.5 (+)
unnamed: C1309.1, R1309.2, U1304.10 (+)
unnamed: C1308.1, R1308.2, U1304.12 (+)

Notes on the sheet:
Rail monitors: NOT FITTED (2026-11-13), may return; mux X1/X2/X3/X5 float
U1301 VDD
DVDD 1V8
SPI series 33 R (60 MHz SCLK)
U1302 V+
3V3 via 1k/1k divider
ADC chain: mux U1301 -> buffer U1302 -> ADS7056 U1303 (front end as on the Agilex 3 card, 2.5 MSPS design). Mux: X0 GND (zero ref), X1 VCORE, X2 1V8, X3 3V3/2, X4 isoada2, X5 1V1, X6 isoada3, X7 isoada1 (isoada1..3 buffered by U1304..U1306 before the mux). Full scale 0..3.3 V (AVDD = reference). Th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
J3 isoada buffers: the mux common node (~30 pF) never loads the baseboard's 8.2k + 4.7n/10n source; 1k + 1n C0G to card GND filters the ground difference across J3
AVDD = reference: 4u7 0603 + 100n at the pin

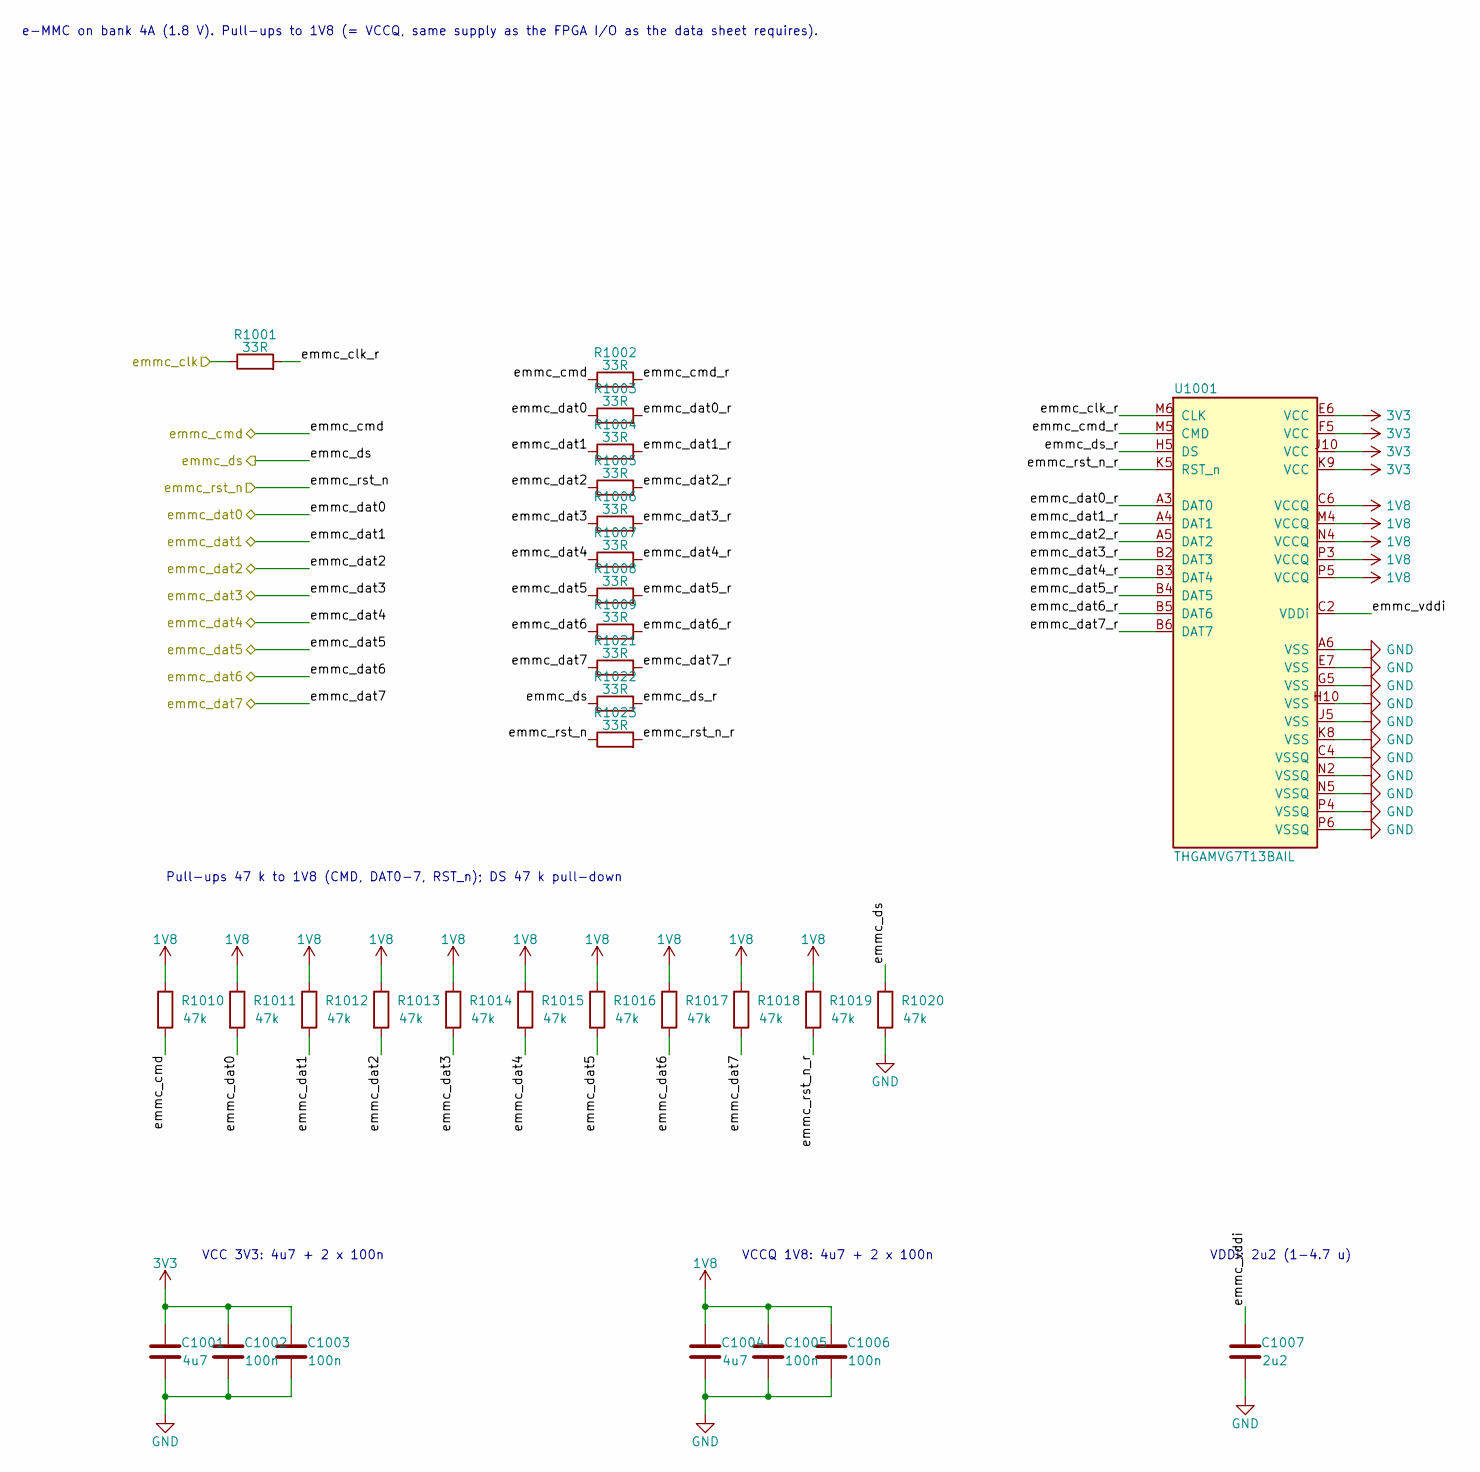
[picture p7: schematic 10_emmc.kicad_sch, Ti135 control card - emmc]

Parts:
C1001, C1004: 4u7; C_0201_0603Metric; LCSC C5969171
C1002, C1003, C1005, C1006: 100n; C_0201_0603Metric; LCSC C190183
C1007: 2u2; C_0201_0603Metric; LCSC C77762
R1001, R1002, R1003, R1004, R1005, R1006, R1007, R1008, R1009, R1021, R1022, R1023: 33R; R_0201_0603Metric; LCSC C320843
R1010, R1011, R1012, R1013, R1014, R1015, R1016, R1017, R1018, R1019, R1020: 47k; R_0201_0603Metric; LCSC C270345
U1001: THGAMVG7T13BAIL; LFBGA-153_11.5x13mm_Layout14x14_P0.5mm; LCSC C7599693

Connections:
1V8: C1004.1, C1005.1, C1006.1, R1010.1, R1011.1, R1012.1, R1013.1, R1014.1, R1015.1, R1016.1, R1017.1, R1018.1, R1019.1, U1001.C6 (VCCQ), U1001.M4 (VCCQ), U1001.N4 (VCCQ), U1001.P3 (VCCQ), U1001.P5 (VCCQ); also elsewhere on the board
3V3: C1001.1, C1002.1, C1003.1, U1001.E6 (VCC), U1001.F5 (VCC), U1001.J10 (VCC), U1001.K9 (VCC); also elsewhere on the board
/10 emmc/emmc_clk_r: R1001.2, U1001.M6 (CLK)
/10 emmc/emmc_cmd_r: R1002.2, U1001.M5 (CMD)
/10 emmc/emmc_dat0_r: R1003.2, U1001.A3 (DAT0)
/10 emmc/emmc_dat1_r: R1004.2, U1001.A4 (DAT1)
/10 emmc/emmc_dat2_r: R1005.2, U1001.A5 (DAT2)
/10 emmc/emmc_dat3_r: R1006.2, U1001.B2 (DAT3)
/10 emmc/emmc_dat4_r: R1007.2, U1001.B3 (DAT4)
/10 emmc/emmc_dat5_r: R1008.2, U1001.B4 (DAT5)
/10 emmc/emmc_dat6_r: R1009.2, U1001.B5 (DAT6)
/10 emmc/emmc_dat7_r: R1021.2, U1001.B6 (DAT7)
/10 emmc/emmc_ds_r: R1022.2, U1001.H5 (DS)
/10 emmc/emmc_rst_n_r: R1019.2, R1023.2, U1001.K5 (RST_n)
/10 emmc/emmc_vddi: C1007.1, U1001.C2 (VDDi)
/emmc_clk: R1001.1; also elsewhere on the board
/emmc_cmd: R1002.1, R1010.2; also elsewhere on the board
/emmc_dat0: R1003.1, R1011.2; also elsewhere on the board
/emmc_dat1: R1004.1, R1012.2; also elsewhere on the board
/emmc_dat2: R1005.1, R1013.2; also elsewhere on the board
/emmc_dat3: R1006.1, R1014.2; also elsewhere on the board
/emmc_dat4: R1007.1, R1015.2; also elsewhere on the board
/emmc_dat5: R1008.1, R1016.2; also elsewhere on the board
/emmc_dat6: R1009.1, R1017.2; also elsewhere on the board
/emmc_dat7: R1018.2, R1021.1; also elsewhere on the board
/emmc_ds: R1020.1, R1022.1; also elsewhere on the board
/emmc_rst_n: R1023.1; also elsewhere on the board
GND: C1001.2, C1002.2, C1003.2, C1004.2, C1005.2, C1006.2, C1007.2, R1020.2, U1001.A6 (VSS), U1001.C4 (VSSQ), U1001.E7 (VSS), U1001.G5 (VSS), U1001.H10 (VSS), U1001.J5 (VSS), U1001.K8 (VSS), U1001.N2 (VSSQ), U1001.N5 (VSSQ), U1001.P4 (VSSQ), U1001.P6 (VSSQ); also elsewhere on the board

Notes on the sheet:
VCCQ 1V8: 4u7 + 2 x 100n
Pull-ups 47 k to 1V8 (CMD, DAT0-7, RST_n); DS 47 k pull-down
VCC 3V3: 4u7 + 2 x 100n
e-MMC on bank 4A (1.8 V). Pull-ups to 1V8 (= VCCQ, same supply as the FPGA I/O as the data sheet requires).
VDDi: 2u2 (1-4.7 u)

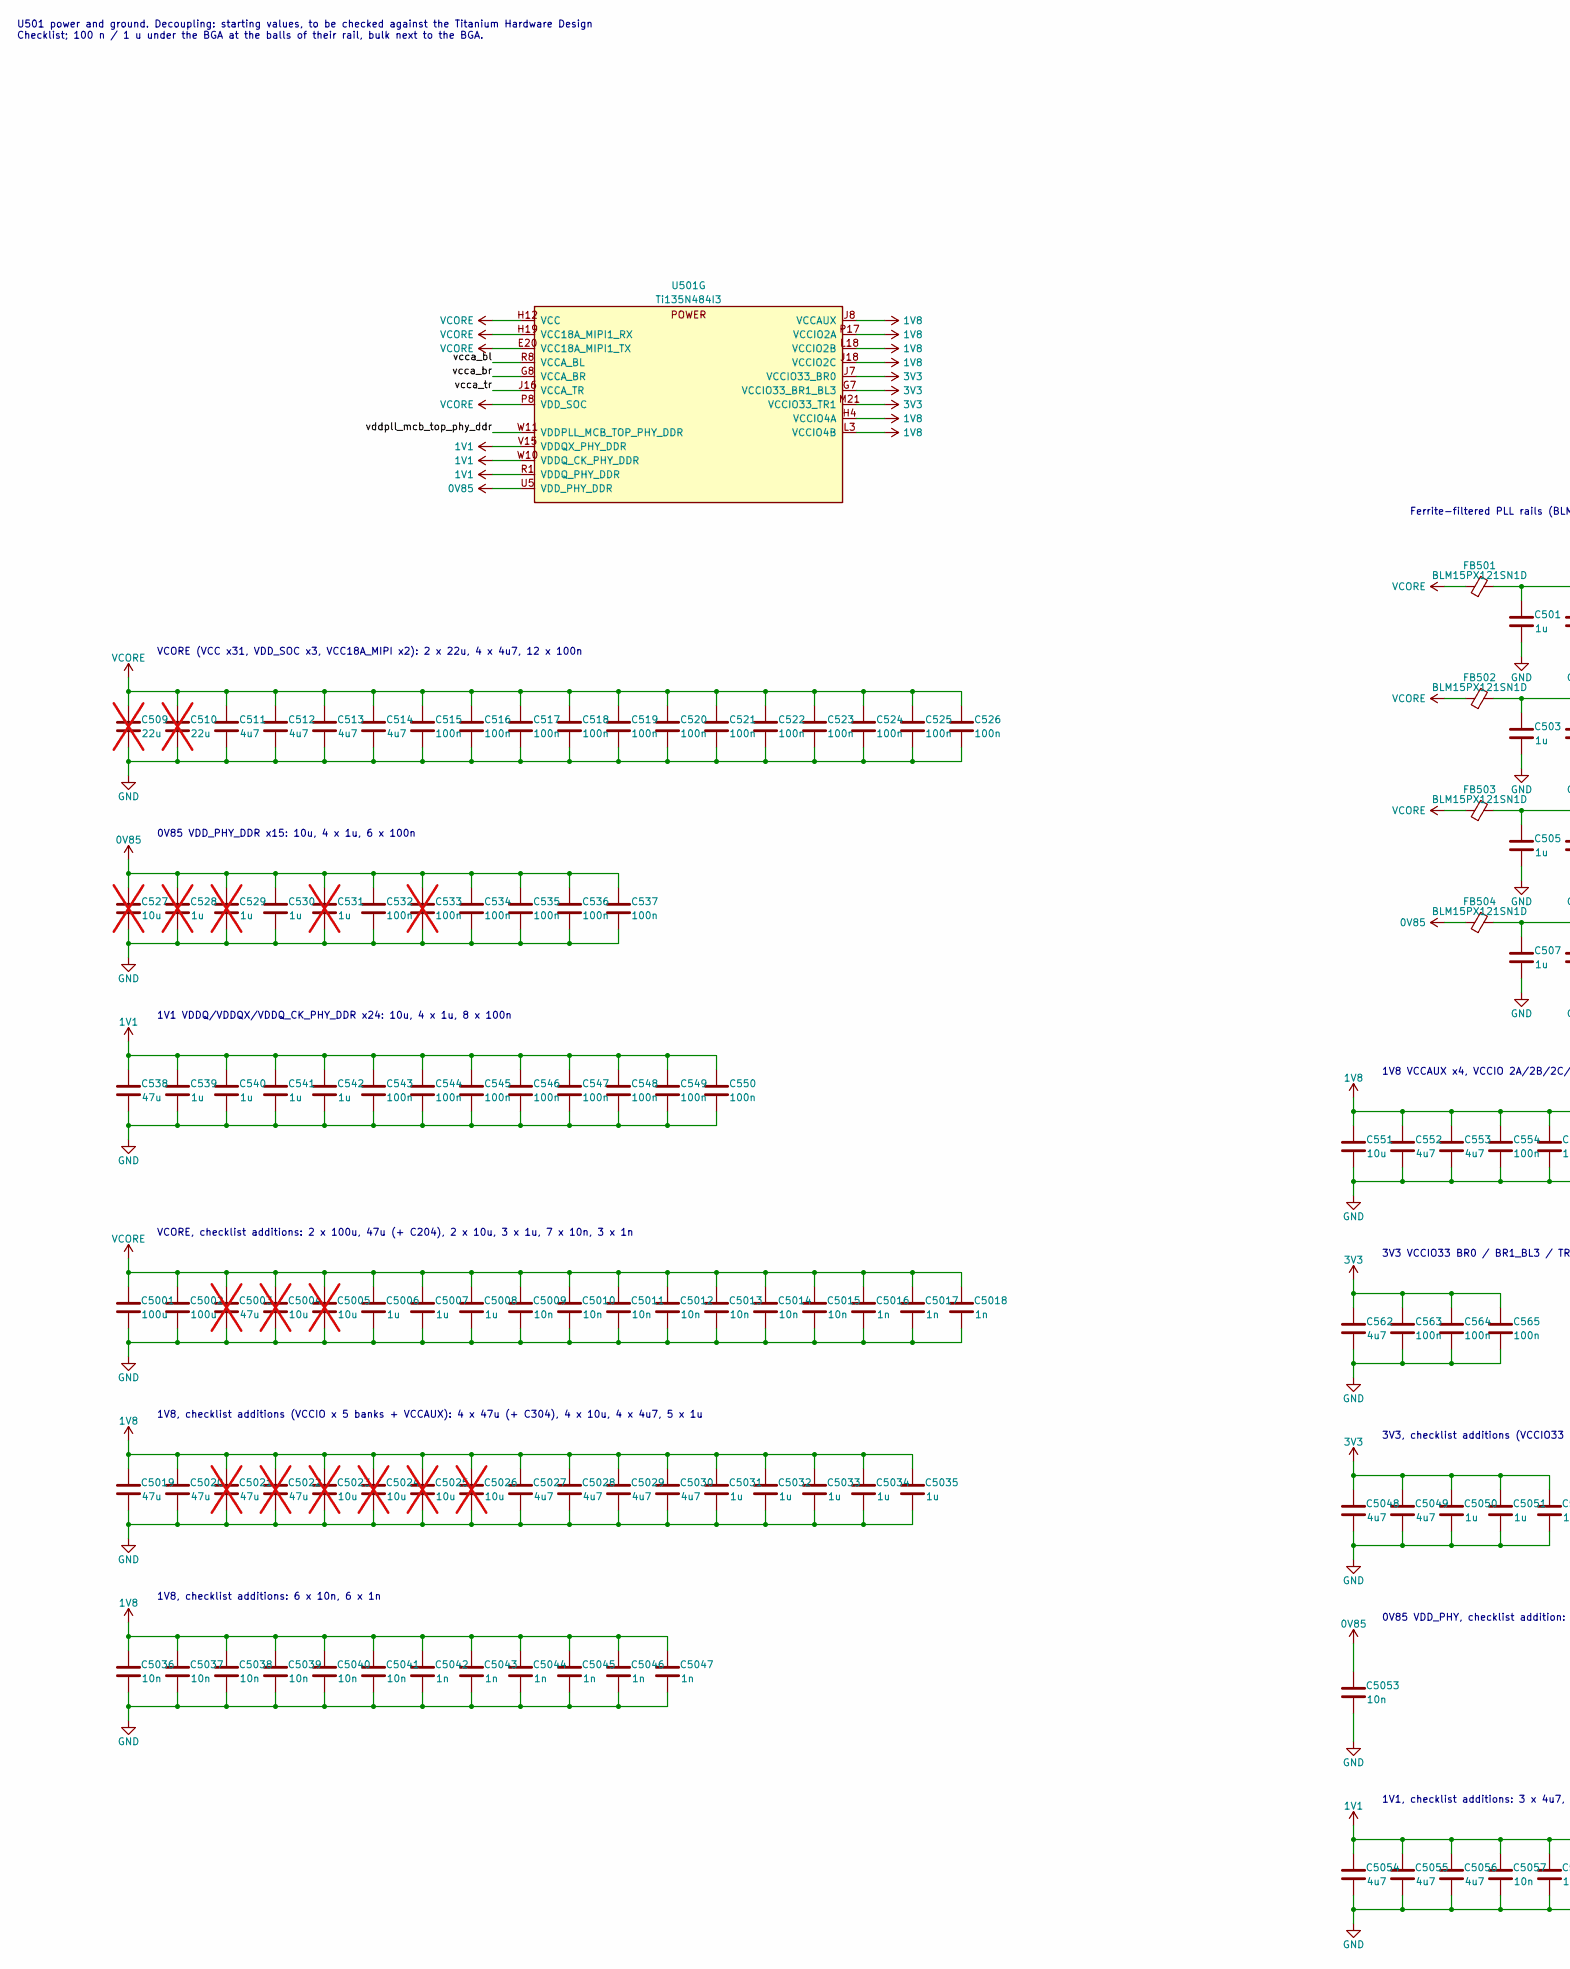
[picture p8: schematic 05_fpga_power.kicad_sch, Ti135 control card - fpga_power, part in row 1, column 1]

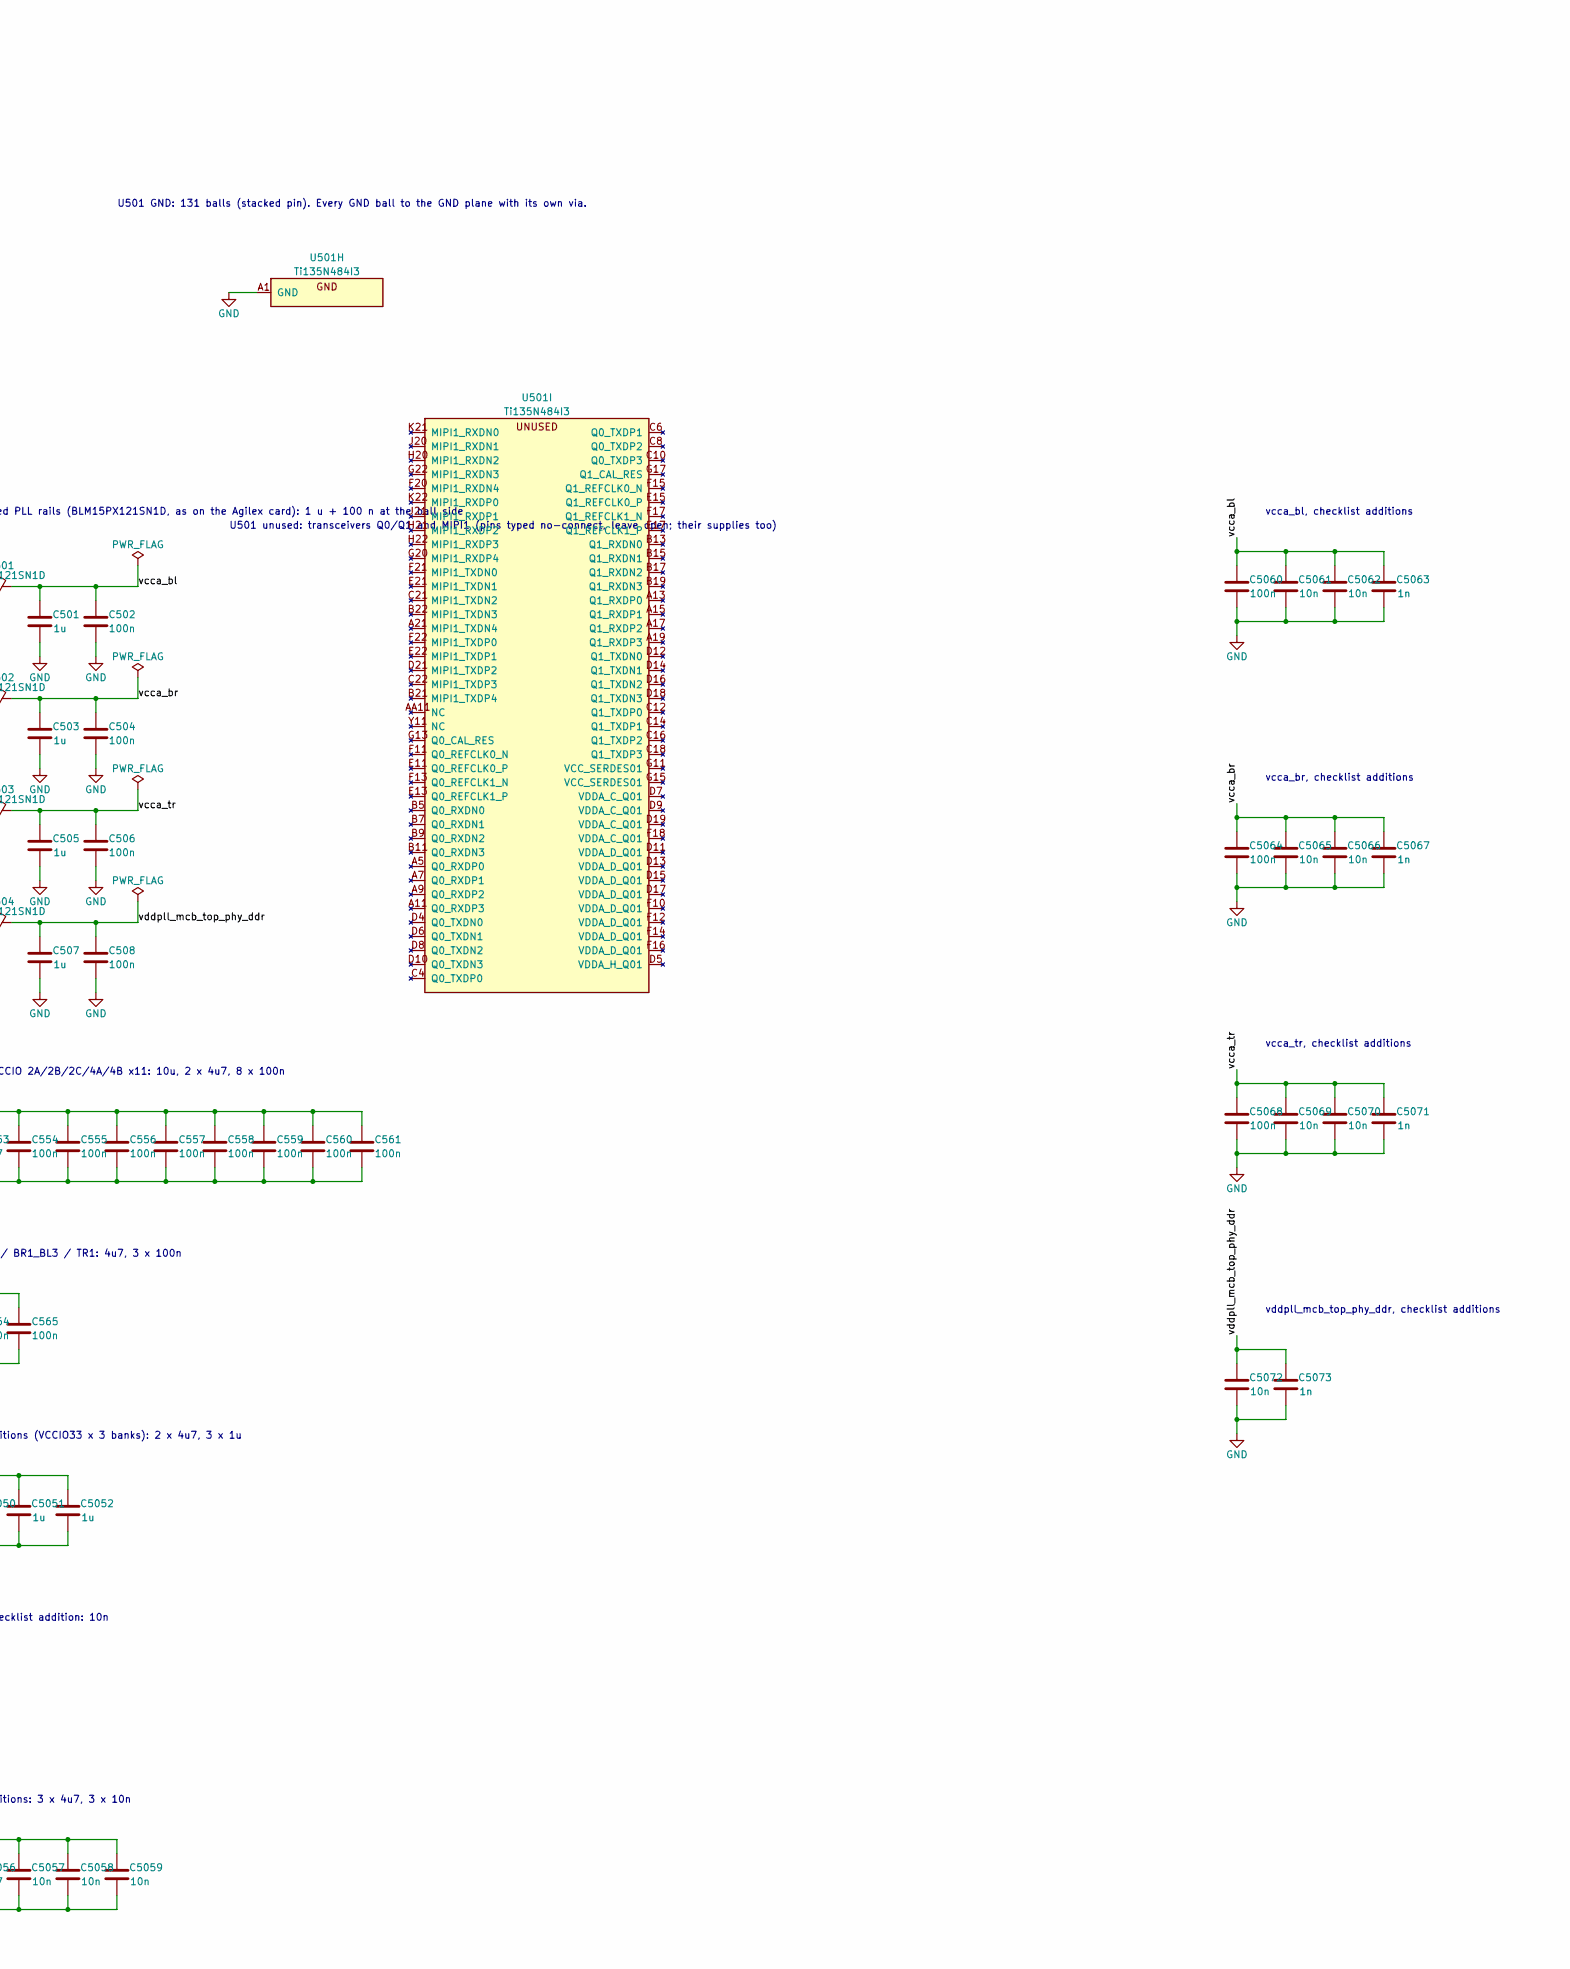
[picture p9: schematic 05_fpga_power.kicad_sch, Ti135 control card - fpga_power, part in row 1, column 2]

Parts:
C501, C503, C505, C507, C5033: 1u; C_0402_1005Metric; LCSC C52923
C502, C504, C506, C508: 100n; C_0402_1005Metric; LCSC C1525
C509, C510: 22u; C_0805_2012Metric; LCSC C45783; not fitted
C511, C512, C513, C514, C552, C553, C5027, C5028, C5029, C5030, C5048, C5049, C5054, C5055, C5056: 4u7; C_0201_0603Metric; LCSC C47117441
C515, C516, C517, C518, C519, C520, C521, C522, C523, C524, C525, C526, C532, C534, C535, C536, C537, C543, C544, C545, C546, C547, C548, C549, C550, C554, C555, C556, C557, C558, C559, C560, C561, C563, C564, C565, C5060, C5064, C5068: 100n; C_0201_0603Metric; LCSC C190183
C527, C5004, C5005, C5023, C5024, C5025, C5026: 10u; C_0805_2012Metric; LCSC C15850; not fitted
C528, C529, C531: 1u; C_0201_0603Metric; LCSC C272877; not fitted
C530, C539, C540, C541, C542, C5006, C5007, C5008, C5031, C5032, C5034, C5035, C5050, C5051, C5052: 1u; C_0201_0603Metric; LCSC C272877
C533: 100n; C_0201_0603Metric; LCSC C190183; not fitted
C538, C5019, C5020: 47u; C_0805_2012Metric; LCSC C16780
C551: 10u; C_0805_2012Metric; LCSC C15850
C562: 4u7; C_0402_1005Metric; LCSC C23733
C5001, C5002: 100u; C_1206_3216Metric; LCSC C15008
C5003, C5021, C5022: 47u; C_0805_2012Metric; LCSC C16780; not fitted
C5009, C5010, C5011, C5012, C5013, C5014, C5015, C5036, C5037, C5038, C5039, C5040, C5041, C5053, C5057, C5058, C5059, C5061, C5062, C5065, C5066, C5069, C5070, C5072: 10n; C_0201_0603Metric; LCSC C76941
C5016, C5017, C5018, C5042, C5043, C5044, C5045, C5046, C5047, C5063, C5067, C5071, C5073: 1n; C_0201_0603Metric; LCSC C66942
FB501, FB502, FB503, FB504: BLM15PX121SN1D; L_0402_1005Metric; LCSC C88970
U501: Ti135N484I3; LFBGA-484_18x18mm_Layout22x22_P0.8mm

Connections:
0V85: C527.1, C528.1, C529.1, C530.1, C531.1, C532.1, C533.1, C534.1, C535.1, C536.1, C537.1, C5053.1, FB504.1, U501.U5 (VDD_PHY_DDR), U501.U6 (VDD_PHY_DDR), U501.U7 (VDD_PHY_DDR), U501.U8 (VDD_PHY_DDR), U501.U9 (VDD_PHY_DDR), U501.U10 (VDD_PHY_DDR), U501.U11 (VDD_PHY_DDR), U501.U12 (VDD_PHY_DDR), U501.U13 (VDD_PHY_DDR), U501.U14 (VDD_PHY_DDR), U501.U15 (VDD_PHY_DDR), U501.V7 (VDD_PHY_DDR), U501.V9 (VDD_PHY_DDR), U501.V11 (VDD_PHY_DDR), U501.V13 (VDD_PHY_DDR); also elsewhere on the board
1V1: C538.1, C539.1, C540.1, C541.1, C542.1, C543.1, C544.1, C545.1, C546.1, C547.1, C548.1, C549.1, C550.1, C5054.1, C5055.1, C5056.1, C5057.1, C5058.1, C5059.1, U501.AB3 (VDDQ_PHY_DDR), U501.R1 (VDDQ_PHY_DDR), U501.T2 (VDDQ_PHY_DDR), U501.T5 (VDDQ_PHY_DDR), U501.U18 (VDDQ_PHY_DDR), U501.U19 (VDDQ_PHY_DDR), U501.V1 (VDDQ_PHY_DDR), U501.V15 (VDDQX_PHY_DDR), U501.V20 (VDDQ_PHY_DDR), U501.V21 (VDDQ_PHY_DDR), U501.W6 (VDDQX_PHY_DDR), U501.W7 (VDDQX_PHY_DDR), U501.W8 (VDDQX_PHY_DDR), U501.W9 (VDDQX_PHY_DDR), U501.W10 (VDDQ_CK_PHY_DDR), U501.W12 (VDDQX_PHY_DDR), U501.W15 (VDDQX_PHY_DDR), U501.W17 (VDDQ_PHY_DDR), U501.Y3 (VDDQ_PHY_DDR), U501.Y6 (VDDQ_PHY_DDR), U501.Y8 (VDDQ_PHY_DDR), U501.Y10 (VDDQX_PHY_DDR), U501.Y12 (VDDQ_PHY_DDR), U501.Y22 (VDDQ_PHY_DDR); also elsewhere on the board
1V8: C551.1, C552.1, C553.1, C554.1, C555.1, C556.1, C557.1, C558.1, C559.1, C560.1, C561.1, C5019.1, C5020.1, C5021.1, C5022.1, C5023.1, C5024.1, C5025.1, C5026.1, C5027.1, C5028.1, C5029.1, C5030.1, C5031.1, C5032.1, C5033.1, C5034.1, C5035.1, C5036.1, C5037.1, C5038.1, C5039.1, C5040.1, C5041.1, C5042.1, C5043.1, C5044.1, C5045.1, C5046.1, C5047.1, U501.H4 (VCCIO4A), U501.J8 (VCCAUX), U501.J18 (VCCIO2C), U501.K5 (VCCIO4A), U501.L3 (VCCIO4B), U501.L18 (VCCIO2B), U501.M6 (VCCIO4A), U501.M16 (VCCAUX), U501.N4 (VCCIO4B), U501.N8 (VCCAUX), U501.N19 (VCCIO2B), U501.P2 (VCCIO4B), U501.P17 (VCCIO2A), U501.T4 (VCCIO4B), U501.U16 (VCCAUX); also elsewhere on the board
3V3: C562.1, C563.1, C564.1, C565.1, C5048.1, C5049.1, C5050.1, C5051.1, C5052.1, U501.G7 (VCCIO33_BR1_BL3), U501.J7 (VCCIO33_BR0), U501.M21 (VCCIO33_TR1); also elsewhere on the board
/05 fpga_power/vcca_bl: C501.1, C502.1, C5060.1, C5061.1, C5062.1, C5063.1, FB501.2, U501.R8 (VCCA_BL)
/05 fpga_power/vcca_br: C503.1, C504.1, C5064.1, C5065.1, C5066.1, C5067.1, FB502.2, U501.G8 (VCCA_BR)
/05 fpga_power/vcca_tr: C505.1, C506.1, C5068.1, C5069.1, C5070.1, C5071.1, FB503.2, U501.J16 (VCCA_TR)
/05 fpga_power/vddpll_mcb_top_phy_ddr: C507.1, C508.1, C5072.1, C5073.1, FB504.2, U501.W11 (VDDPLL_MCB_TOP_PHY_DDR)
GND: C501.2, C502.2, C503.2, C504.2, C505.2, C506.2, C507.2, C508.2, C509.2, C510.2, C511.2, C512.2, C513.2, C514.2, C515.2, C516.2, C517.2, C518.2, C519.2, C520.2, C521.2, C522.2, C523.2, C524.2, C525.2, C526.2, C527.2, C528.2, C529.2, C530.2, C531.2, C532.2, C533.2, C534.2, C535.2, C536.2, C537.2, C538.2, C539.2, C540.2, C541.2, C542.2, C543.2, C544.2, C545.2, C546.2, C547.2, C548.2, C549.2, C550.2, C551.2, C552.2, C553.2, C554.2, C555.2, C556.2, C557.2, C558.2, C559.2, C560.2, C561.2, C562.2, C563.2, C564.2, C565.2, C5001.2, C5002.2, C5003.2, C5004.2, C5005.2, C5006.2, C5007.2, C5008.2, C5009.2, C5010.2, C5011.2, C5012.2, C5013.2, C5014.2, C5015.2, C5016.2, C5017.2, C5018.2, C5019.2, C5020.2, C5021.2, C5022.2, C5023.2, C5024.2, C5025.2, C5026.2, C5027.2, C5028.2, C5029.2, C5030.2, C5031.2, C5032.2, C5033.2, C5034.2, C5035.2, C5036.2, C5037.2, C5038.2, C5039.2, C5040.2, C5041.2, C5042.2, C5043.2, C5044.2, C5045.2, C5046.2, C5047.2, C5048.2, C5049.2, C5050.2, C5051.2, C5052.2, C5053.2, C5054.2, C5055.2, C5056.2, C5057.2, C5058.2, C5059.2, C5060.2, C5061.2, C5062.2, C5063.2, C5064.2, C5065.2, C5066.2, C5067.2, C5068.2, C5069.2, C5070.2, C5071.2, C5072.2, C5073.2, U501.A1 (GND), U501.A4 (GND), U501.A6 (GND), U501.A8 (GND), U501.A10 (GND), U501.A12 (GND), U501.A14 (GND), U501.A16 (GND), U501.A18 (GND), U501.A20 (GND), U501.A22 (GND), U501.AB1 (GND), U501.AB4 (GND), U501.AB6 (GND), U501.AB8 (GND), U501.AB10 (GND), U501.AB12 (GND), U501.AB14 (GND), U501.AB16 (GND), U501.AB18 (GND), U501.AB20 (GND), U501.AB22 (GND), U501.B3 (GND), U501.B4 (GND), U501.B6 (GND), U501.B8 (GND), U501.B10 (GND), U501.B12 (GND), U501.B14 (GND), U501.B16 (GND), U501.B18 (GND), U501.B20 (GND), U501.C3 (GND), U501.C5 (GND), U501.C7 (GND), U501.C9 (GND), U501.C11 (GND), U501.C13 (GND), U501.C15 (GND), U501.C17 (GND), U501.C19 (GND), U501.C20 (GND), U501.D1 (GND), U501.D3 (GND), U501.D20 (GND), U501.D22 (GND), U501.E3 (GND), U501.E4 (GND), U501.E5 (GND), U501.E6 (GND), U501.E7 (GND), U501.E8 (GND), U501.E9 (GND), U501.E10 (GND), U501.E12 (GND), U501.E14 (GND), U501.E16 (GND), U501.E18 (GND), U501.E19 (GND), U501.F19 (GND), U501.G1 (GND), U501.G12 (GND), U501.G14 (GND), U501.G16 (GND), U501.G18 (GND), U501.G19 (GND), U501.G21 (GND), U501.H13 (GND), U501.H15 (GND), U501.H17 (GND), U501.H18 (GND), U501.J2 (GND), U501.J10 (GND), U501.J12 (GND), U501.J14 (GND), U501.J22 (GND), U501.K8 (GND), U501.K9 (GND), U501.K11 (GND), U501.K13 (GND), U501.K15 (GND), U501.K20 (GND), U501.L10 (GND), U501.L12 (GND), U501.L14 (GND), U501.M1 (GND), U501.M9 (GND), U501.M11 (GND), U501.M13 (GND), U501.M15 (GND), U501.N10 (GND), U501.N12 (GND), U501.N14 (GND), U501.P7 (GND), U501.P9 (GND), U501.P11 (GND), U501.P13 (GND), U501.P15 (GND), U501.P22 (GND), U501.R5 (GND), U501.R10 (GND), U501.R12 (GND), U501.R14 (GND), U501.R20 (GND), U501.T1 (GND), U501.T3 (GND), U501.T7 (GND), U501.T9 (GND), U501.T11 (GND), U501.T13 (GND), U501.T15 (GND), U501.T18 (GND), U501.U17 (GND), U501.U21 (GND), U501.V2 (GND), U501.V4 (GND), U501.V6 (GND), U501.V8 (GND), U501.V10 (GND), U501.V12 (GND), U501.V14 (GND), U501.V19 (GND), U501.V22 (GND), U501.Y1 (GND), U501.Y5 (GND), U501.Y7 (GND), U501.Y13 (GND), U501.Y15 (GND), U501.Y17 (GND), U501.Y19 (GND), U501.Y21 (GND); also elsewhere on the board
VCORE: C509.1, C510.1, C511.1, C512.1, C513.1, C514.1, C515.1, C516.1, C517.1, C518.1, C519.1, C520.1, C521.1, C522.1, C523.1, C524.1, C525.1, C526.1, C5001.1, C5002.1, C5003.1, C5004.1, C5005.1, C5006.1, C5007.1, C5008.1, C5009.1, C5010.1, C5011.1, C5012.1, C5013.1, C5014.1, C5015.1, C5016.1, C5017.1, C5018.1, FB501.1, FB502.1, FB503.1, U501.E20 (VCC18A_MIPI1_TX), U501.H12 (VCC), U501.H14 (VCC), U501.H16 (VCC), U501.H19 (VCC18A_MIPI1_RX), U501.J9 (VCC), U501.J11 (VCC), U501.J13 (VCC), U501.J15 (VCC), U501.K10 (VCC), U501.K12 (VCC), U501.K14 (VCC), U501.L9 (VCC), U501.L11 (VCC), U501.L13 (VCC), U501.L15 (VCC), U501.M10 (VCC), U501.M12 (VCC), U501.M14 (VCC), U501.N9 (VCC), U501.N11 (VCC), U501.N13 (VCC), U501.N15 (VCC), U501.P8 (VDD_SOC), U501.P10 (VCC), U501.P12 (VCC), U501.P14 (VCC), U501.R7 (VDD_SOC), U501.R9 (VCC), U501.R11 (VCC), U501.R13 (VCC), U501.R15 (VCC), U501.T8 (VDD_SOC), U501.T10 (VCC), U501.T12 (VCC), U501.T14 (VCC); also elsewhere on the board

Notes on the sheet:
VCORE, checklist additions: 2 x 100u, 47u (+ C204), 2 x 10u, 3 x 1u, 7 x 10n, 3 x 1n
VCORE (VCC x31, VDD_SOC x3, VCC18A_MIPI x2): 2 x 22u, 4 x 4u7, 12 x 100n
0V85 VDD_PHY_DDR x15: 10u, 4 x 1u, 6 x 100n
3V3 VCCIO33 BR0 / BR1_BL3 / TR1: 4u7, 3 x 100n
1V8, checklist additions: 6 x 10n, 6 x 1n
U501 GND: 131 balls (stacked pin). Every GND ball to the GND plane with its own via.
1V8, checklist additions (VCCIO x 5 banks + VCCAUX): 4 x 47u (+ C304), 4 x 10u, 4 x 4u7, 5 x 1u
vddpll_mcb_top_phy_ddr, checklist additions
U501 power and ground. Decoupling: starting values, to be checked against the Titanium Hardware Design Checklist; 100 n / 1 u under the BGA at the balls of their rail, bulk next to the BGA.
vcca_br, checklist additions
1V8 VCCAUX x4, VCCIO 2A/2B/2C/4A/4B x11: 10u, 2 x 4u7, 8 x 100n
vcca_bl, checklist additions
U501 unused: transceivers Q0/Q1 and MIPI1 (pins typed no-connect, leave open; their supplies too)
3V3, checklist additions (VCCIO33 x 3 banks): 2 x 4u7, 3 x 1u
1V1, checklist additions: 3 x 4u7, 3 x 10n
1V1 VDDQ/VDDQX/VDDQ_CK_PHY_DDR x24: 10u, 4 x 1u, 8 x 100n
Ferrite-filtered PLL rails (BLM15PX121SN1D, as on the Agilex card): 1 u + 100 n at the ball side
0V85 VDD_PHY, checklist addition: 10n
vcca_tr, checklist additions
