johonkanen/efinix_soc_board/kicad/ti135_card.kicad_pcb

## KiCad design kicad/ti135_card.kicad_pcb (continued)

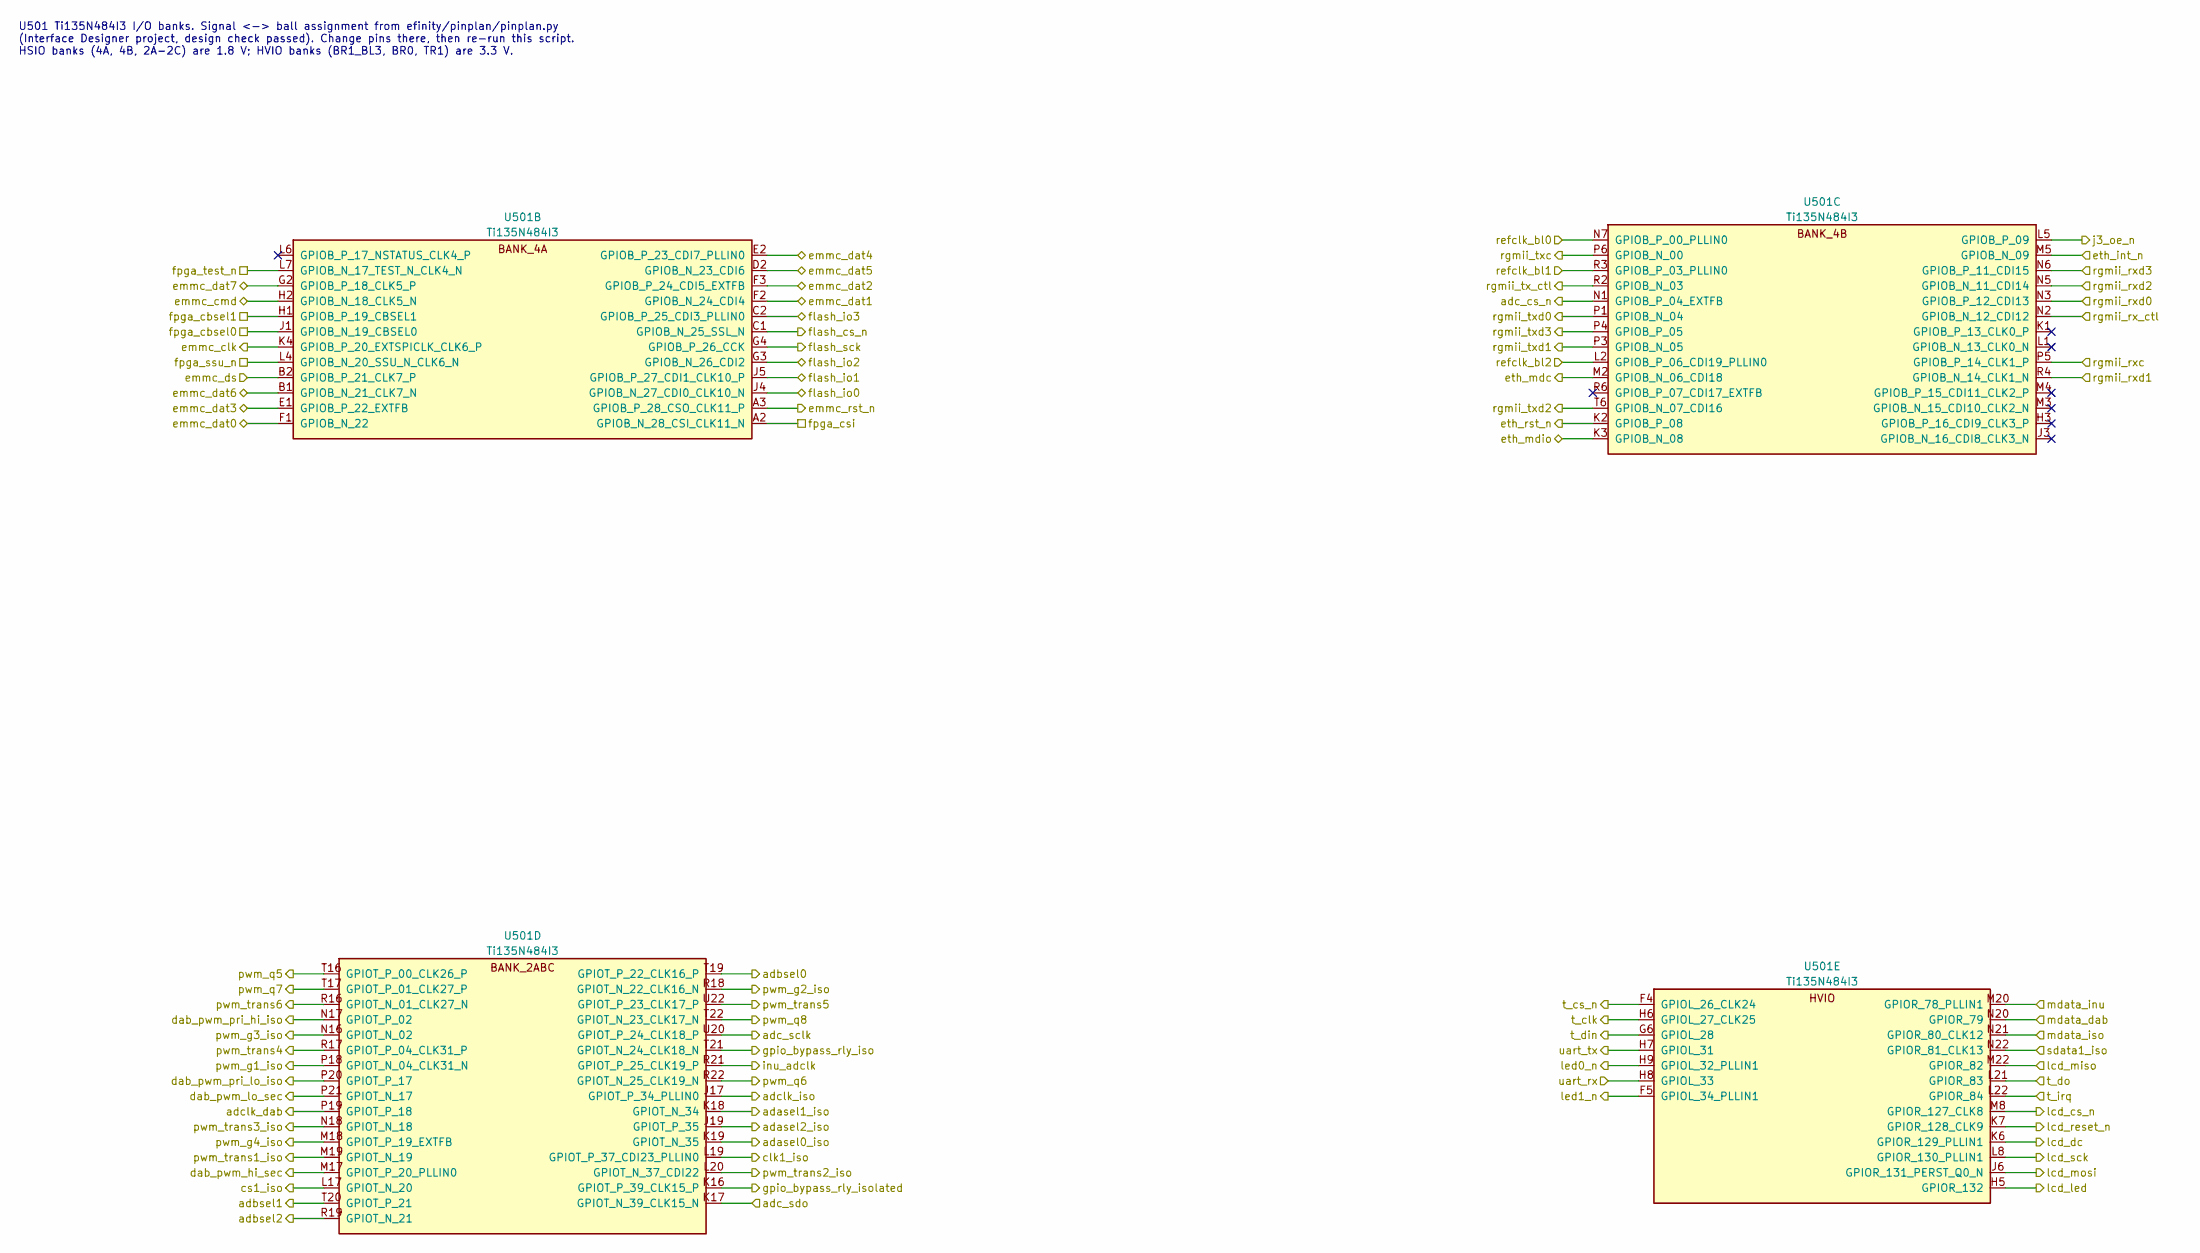
[picture p10: schematic 11_fpga_io.kicad_sch, Ti135 control card - fpga_io]

Parts:
U501: Ti135N484I3; LFBGA-484_18x18mm_Layout22x22_P0.8mm

Connections:
/adasel0_iso: U501.K19 (GPIOT_N_35); also elsewhere on the board
/adasel1_iso: U501.K18 (GPIOT_N_34); also elsewhere on the board
/adasel2_iso: U501.J19 (GPIOT_P_35); also elsewhere on the board
/adbsel0: U501.T19 (GPIOT_P_22_CLK16_P); also elsewhere on the board
/adbsel1: U501.T20 (GPIOT_P_21); also elsewhere on the board
/adbsel2: U501.R19 (GPIOT_N_21); also elsewhere on the board
/adc_cs_n: U501.N1 (GPIOB_P_04_EXTFB); also elsewhere on the board
/adc_sclk: U501.U20 (GPIOT_P_24_CLK18_P); also elsewhere on the board
/adc_sdo: U501.K17 (GPIOT_N_39_CLK15_N); also elsewhere on the board
/adclk_dab: U501.P19 (GPIOT_P_18); also elsewhere on the board
/adclk_iso: U501.J17 (GPIOT_P_34_PLLIN0); also elsewhere on the board
/clk1_iso: U501.L19 (GPIOT_P_37_CDI23_PLLIN0); also elsewhere on the board
/cs1_iso: U501.L17 (GPIOT_N_20); also elsewhere on the board
/dab_pwm_hi_sec: U501.M17 (GPIOT_P_20_PLLIN0); also elsewhere on the board
/dab_pwm_lo_sec: U501.P21 (GPIOT_N_17); also elsewhere on the board
/dab_pwm_pri_hi_iso: U501.N17 (GPIOT_P_02); also elsewhere on the board
/dab_pwm_pri_lo_iso: U501.P20 (GPIOT_P_17); also elsewhere on the board
/emmc_clk: U501.K4 (GPIOB_P_20_EXTSPICLK_CLK6_P); also elsewhere on the board
/emmc_cmd: U501.H2 (GPIOB_N_18_CLK5_N); also elsewhere on the board
/emmc_dat0: U501.F1 (GPIOB_N_22); also elsewhere on the board
/emmc_dat1: U501.F2 (GPIOB_N_24_CDI4); also elsewhere on the board
/emmc_dat2: U501.F3 (GPIOB_P_24_CDI5_EXTFB); also elsewhere on the board
/emmc_dat3: U501.E1 (GPIOB_P_22_EXTFB); also elsewhere on the board
/emmc_dat4: U501.E2 (GPIOB_P_23_CDI7_PLLIN0); also elsewhere on the board
/emmc_dat5: U501.D2 (GPIOB_N_23_CDI6); also elsewhere on the board
/emmc_dat6: U501.B1 (GPIOB_N_21_CLK7_N); also elsewhere on the board
/emmc_dat7: U501.G2 (GPIOB_P_18_CLK5_P); also elsewhere on the board
/emmc_ds: U501.B2 (GPIOB_P_21_CLK7_P); also elsewhere on the board
/emmc_rst_n: U501.A3 (GPIOB_P_28_CSO_CLK11_P); also elsewhere on the board
/eth_int_n: U501.M5 (GPIOB_N_09); also elsewhere on the board
/eth_mdc: U501.M2 (GPIOB_N_06_CDI18); also elsewhere on the board
/eth_mdio: U501.K3 (GPIOB_N_08); also elsewhere on the board
/eth_rst_n: U501.K2 (GPIOB_P_08); also elsewhere on the board
/flash_cs_n: U501.C1 (GPIOB_N_25_SSL_N); also elsewhere on the board
/flash_io0: U501.J4 (GPIOB_N_27_CDI0_CLK10_N); also elsewhere on the board
/flash_io1: U501.J5 (GPIOB_P_27_CDI1_CLK10_P); also elsewhere on the board
/flash_io2: U501.G3 (GPIOB_N_26_CDI2); also elsewhere on the board
/flash_io3: U501.C2 (GPIOB_P_25_CDI3_PLLIN0); also elsewhere on the board
/flash_sck: U501.G4 (GPIOB_P_26_CCK); also elsewhere on the board
/fpga_cbsel0: U501.J1 (GPIOB_N_19_CBSEL0); also elsewhere on the board
/fpga_cbsel1: U501.H1 (GPIOB_P_19_CBSEL1); also elsewhere on the board
/fpga_csi: U501.A2 (GPIOB_N_28_CSI_CLK11_N); also elsewhere on the board
/fpga_ssu_n: U501.L4 (GPIOB_N_20_SSU_N_CLK6_N); also elsewhere on the board
/fpga_test_n: U501.L7 (GPIOB_N_17_TEST_N_CLK4_N); also elsewhere on the board
/gpio_bypass_rly_iso: U501.T21 (GPIOT_N_24_CLK18_N); also elsewhere on the board
/gpio_bypass_rly_isolated: U501.K16 (GPIOT_P_39_CLK15_P); also elsewhere on the board
/inu_adclk: U501.R21 (GPIOT_P_25_CLK19_P); also elsewhere on the board
/j3_oe_n: U501.L5 (GPIOB_P_09); also elsewhere on the board
/lcd_cs_n: U501.M8 (GPIOR_127_CLK8); also elsewhere on the board
/lcd_dc: U501.K6 (GPIOR_129_PLLIN1); also elsewhere on the board
/lcd_led: U501.H5 (GPIOR_132); also elsewhere on the board
/lcd_miso: U501.M22 (GPIOR_82); also elsewhere on the board
/lcd_mosi: U501.J6 (GPIOR_131_PERST_Q0_N); also elsewhere on the board
/lcd_reset_n: U501.K7 (GPIOR_128_CLK9); also elsewhere on the board
/lcd_sck: U501.L8 (GPIOR_130_PLLIN1); also elsewhere on the board
/led0_n: U501.H9 (GPIOL_32_PLLIN1); also elsewhere on the board
/led1_n: U501.F5 (GPIOL_34_PLLIN1); also elsewhere on the board
/mdata_dab: U501.N20 (GPIOR_79); also elsewhere on the board
/mdata_inu: U501.M20 (GPIOR_78_PLLIN1); also elsewhere on the board
/mdata_iso: U501.N21 (GPIOR_80_CLK12); also elsewhere on the board
/pwm_g1_iso: U501.P18 (GPIOT_N_04_CLK31_N); also elsewhere on the board
/pwm_g2_iso: U501.R18 (GPIOT_N_22_CLK16_N); also elsewhere on the board
/pwm_g3_iso: U501.N16 (GPIOT_N_02); also elsewhere on the board
/pwm_g4_iso: U501.M18 (GPIOT_P_19_EXTFB); also elsewhere on the board
/pwm_q5: U501.T16 (GPIOT_P_00_CLK26_P); also elsewhere on the board
/pwm_q6: U501.R22 (GPIOT_N_25_CLK19_N); also elsewhere on the board
/pwm_q7: U501.T17 (GPIOT_P_01_CLK27_P); also elsewhere on the board
/pwm_q8: U501.T22 (GPIOT_N_23_CLK17_N); also elsewhere on the board
/pwm_trans1_iso: U501.M19 (GPIOT_N_19); also elsewhere on the board
/pwm_trans2_iso: U501.L20 (GPIOT_N_37_CDI22); also elsewhere on the board
/pwm_trans3_iso: U501.N18 (GPIOT_N_18); also elsewhere on the board
/pwm_trans4: U501.R17 (GPIOT_P_04_CLK31_P); also elsewhere on the board
/pwm_trans5: U501.U22 (GPIOT_P_23_CLK17_P); also elsewhere on the board
/pwm_trans6: U501.R16 (GPIOT_N_01_CLK27_N); also elsewhere on the board
/refclk_bl0: U501.N7 (GPIOB_P_00_PLLIN0); also elsewhere on the board
/refclk_bl1: U501.R3 (GPIOB_P_03_PLLIN0); also elsewhere on the board
/refclk_bl2: U501.L2 (GPIOB_P_06_CDI19_PLLIN0); also elsewhere on the board
/rgmii_rx_ctl: U501.N2 (GPIOB_N_12_CDI12); also elsewhere on the board
/rgmii_rxc: U501.P5 (GPIOB_P_14_CLK1_P); also elsewhere on the board
/rgmii_rxd0: U501.N3 (GPIOB_P_12_CDI13); also elsewhere on the board
/rgmii_rxd1: U501.R4 (GPIOB_N_14_CLK1_N); also elsewhere on the board
/rgmii_rxd2: U501.N5 (GPIOB_N_11_CDI14); also elsewhere on the board
/rgmii_rxd3: U501.N6 (GPIOB_P_11_CDI15); also elsewhere on the board
/rgmii_tx_ctl: U501.R2 (GPIOB_N_03); also elsewhere on the board
/rgmii_txc: U501.P6 (GPIOB_N_00); also elsewhere on the board
/rgmii_txd0: U501.P1 (GPIOB_N_04); also elsewhere on the board
/rgmii_txd1: U501.P3 (GPIOB_N_05); also elsewhere on the board
/rgmii_txd2: U501.T6 (GPIOB_N_07_CDI16); also elsewhere on the board
/rgmii_txd3: U501.P4 (GPIOB_P_05); also elsewhere on the board
/sdata1_iso: U501.N22 (GPIOR_81_CLK13); also elsewhere on the board
/t_clk: U501.H6 (GPIOL_27_CLK25); also elsewhere on the board
/t_cs_n: U501.F4 (GPIOL_26_CLK24); also elsewhere on the board
/t_din: U501.G6 (GPIOL_28); also elsewhere on the board
/t_do: U501.L21 (GPIOR_83); also elsewhere on the board
/t_irq: U501.L22 (GPIOR_84); also elsewhere on the board
/uart_rx: U501.H8 (GPIOL_33); also elsewhere on the board
/uart_tx: U501.H7 (GPIOL_31); also elsewhere on the board

Notes on the sheet:
U501 Ti135N484I3 I/O banks. Signal <-> ball assignment from efinity/pinplan/pinplan.py (Interface Designer project, design check passed). Change pins there, then re-run this script. HSIO banks (4A, 4B, 2A-2C) are 1.8 V; HVIO banks (BR1_BL3, BR0, TR1) are 3.3 V.

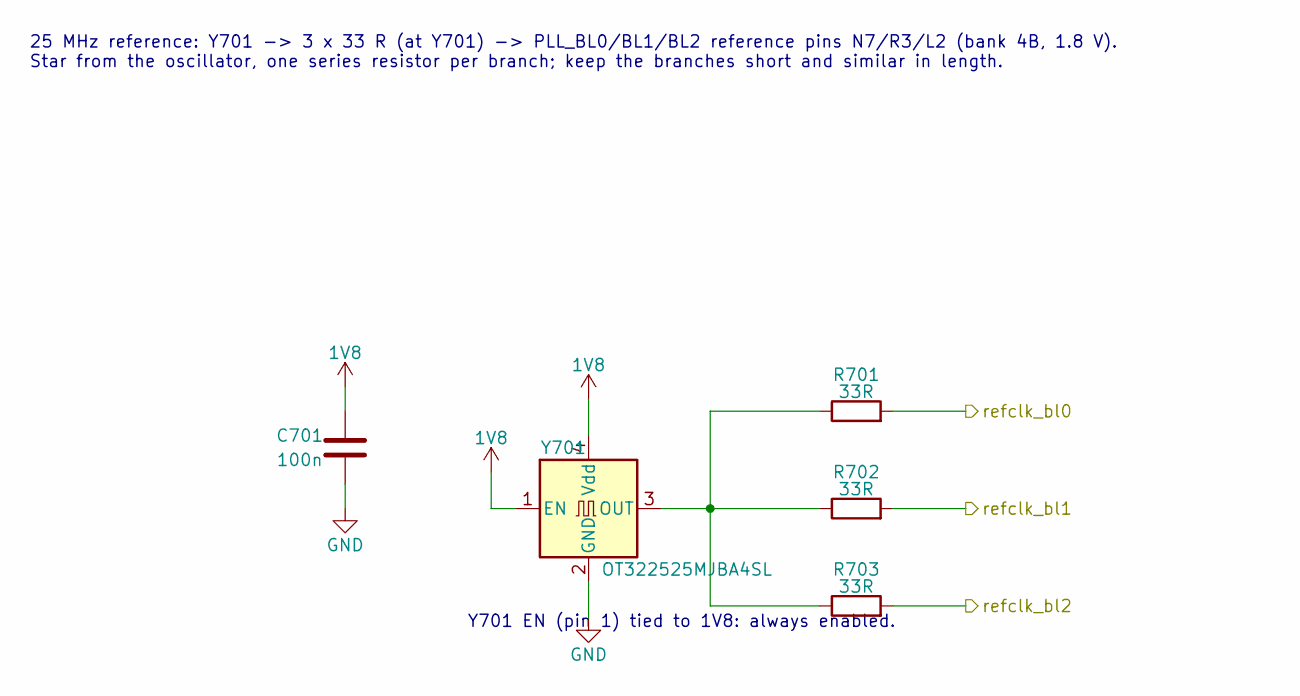
[picture p11: schematic 07_clocks.kicad_sch, Ti135 control card - clocks]

Parts:
C701: 100n; C_0201_0603Metric; LCSC C190183
R701, R702, R703: 33R; R_0402_1005Metric; LCSC C25105
Y701: OT322525MJBA4SL; Oscillator_SMD_SiT_PQFN-4Pin_3.2x2.5mm; LCSC C669088

Connections:
1V8: C701.1, Y701.1 (EN), Y701.4 (Vdd); also elsewhere on the board
/refclk_bl0: R701.2; also elsewhere on the board
/refclk_bl1: R702.2; also elsewhere on the board
/refclk_bl2: R703.2; also elsewhere on the board
GND: C701.2, Y701.2 (GND); also elsewhere on the board
unnamed: R701.1, R702.1, R703.1, Y701.3 (OUT)

Notes on the sheet:
25 MHz reference: Y701 -> 3 x 33 R (at Y701) -> PLL_BL0/BL1/BL2 reference pins N7/R3/L2 (bank 4B, 1.8 V). Star from the oscillator, one series resistor per branch; keep the branches short and similar in length.
Y701 EN (pin 1) tied to 1V8: always enabled.

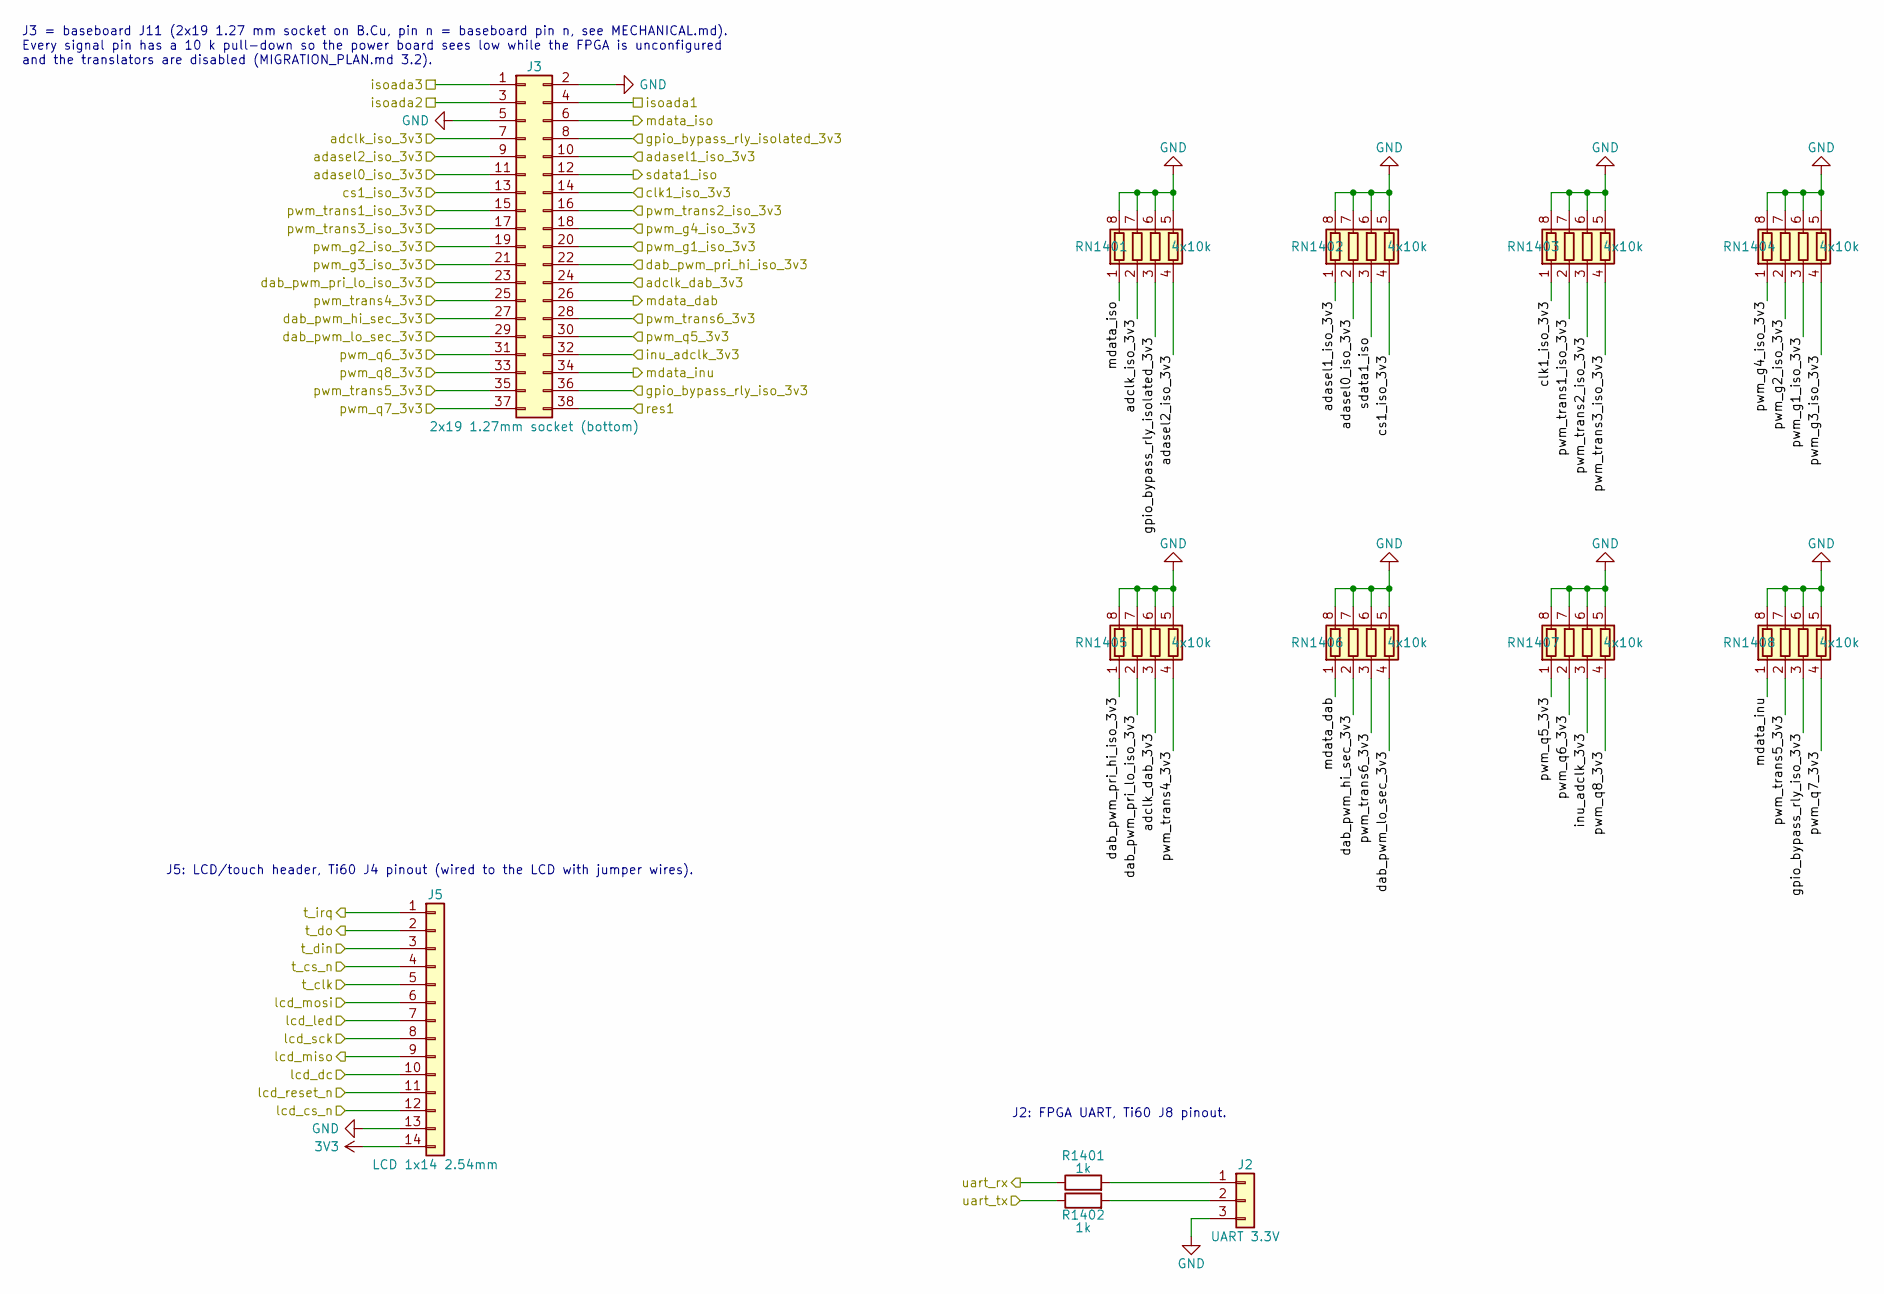
[picture p12: schematic 14_connectors.kicad_sch, Ti135 control card - connectors]

Parts:
J2: UART 3.3V; PinHeader_1x03_P2.54mm_Vertical; LCSC C2937625
J3: 2x19 1.27mm socket (bottom); PinSocket_2x19_P1.27mm_Vertical_Drill0.6; LCSC C27985219
J5: LCD 1x14 2.54mm; PinHeader_1x14_P2.54mm_Vertical; LCSC C22465874
R1401, R1402: 1k; R_0402_1005Metric; LCSC C11702
RN1401, RN1402, RN1403, RN1404, RN1405, RN1406, RN1407, RN1408: 4x10k; R_Array_Convex_4x0402; MPN 4D02WGJ0103TCE; LCSC C25725

Connections:
3V3: J5.14; also elsewhere on the board
/adasel0_iso_3v3: J3.11, RN1402.2 (R2.1); also elsewhere on the board
/adasel1_iso_3v3: J3.10, RN1402.1 (R1.1); also elsewhere on the board
/adasel2_iso_3v3: J3.9, RN1401.4 (R4.1); also elsewhere on the board
/adclk_dab_3v3: J3.24, RN1405.3 (R3.1); also elsewhere on the board
/adclk_iso_3v3: J3.7, RN1401.2 (R2.1); also elsewhere on the board
/clk1_iso_3v3: J3.14, RN1403.1 (R1.1); also elsewhere on the board
/cs1_iso_3v3: J3.13, RN1402.4 (R4.1); also elsewhere on the board
/dab_pwm_hi_sec_3v3: J3.27, RN1406.2 (R2.1); also elsewhere on the board
/dab_pwm_lo_sec_3v3: J3.29, RN1406.4 (R4.1); also elsewhere on the board
/dab_pwm_pri_hi_iso_3v3: J3.22, RN1405.1 (R1.1); also elsewhere on the board
/dab_pwm_pri_lo_iso_3v3: J3.23, RN1405.2 (R2.1); also elsewhere on the board
/gpio_bypass_rly_iso_3v3: J3.36, RN1408.3 (R3.1); also elsewhere on the board
/gpio_bypass_rly_isolated_3v3: J3.8, RN1401.3 (R3.1); also elsewhere on the board
/inu_adclk_3v3: J3.32, RN1407.3 (R3.1); also elsewhere on the board
/isoada1: J3.4; also elsewhere on the board
/isoada2: J3.3; also elsewhere on the board
/isoada3: J3.1; also elsewhere on the board
/lcd_cs_n: J5.12; also elsewhere on the board
/lcd_dc: J5.10; also elsewhere on the board
/lcd_led: J5.7; also elsewhere on the board
/lcd_miso: J5.9; also elsewhere on the board
/lcd_mosi: J5.6; also elsewhere on the board
/lcd_reset_n: J5.11; also elsewhere on the board
/lcd_sck: J5.8; also elsewhere on the board
/mdata_dab: J3.26, RN1406.1 (R1.1); also elsewhere on the board
/mdata_inu: J3.34, RN1408.1 (R1.1); also elsewhere on the board
/mdata_iso: J3.6, RN1401.1 (R1.1); also elsewhere on the board
/pwm_g1_iso_3v3: J3.20, RN1404.3 (R3.1); also elsewhere on the board
/pwm_g2_iso_3v3: J3.19, RN1404.2 (R2.1); also elsewhere on the board
/pwm_g3_iso_3v3: J3.21, RN1404.4 (R4.1); also elsewhere on the board
/pwm_g4_iso_3v3: J3.18, RN1404.1 (R1.1); also elsewhere on the board
/pwm_q5_3v3: J3.30, RN1407.1 (R1.1); also elsewhere on the board
/pwm_q6_3v3: J3.31, RN1407.2 (R2.1); also elsewhere on the board
/pwm_q7_3v3: J3.37, RN1408.4 (R4.1); also elsewhere on the board
/pwm_q8_3v3: J3.33, RN1407.4 (R4.1); also elsewhere on the board
/pwm_trans1_iso_3v3: J3.15, RN1403.2 (R2.1); also elsewhere on the board
/pwm_trans2_iso_3v3: J3.16, RN1403.3 (R3.1); also elsewhere on the board
/pwm_trans3_iso_3v3: J3.17, RN1403.4 (R4.1); also elsewhere on the board
/pwm_trans4_3v3: J3.25, RN1405.4 (R4.1); also elsewhere on the board
/pwm_trans5_3v3: J3.35, RN1408.2 (R2.1); also elsewhere on the board
/pwm_trans6_3v3: J3.28, RN1406.3 (R3.1); also elsewhere on the board
/res1: J3.38; also elsewhere on the board
/sdata1_iso: J3.12, RN1402.3 (R3.1); also elsewhere on the board
/t_clk: J5.5; also elsewhere on the board
/t_cs_n: J5.4; also elsewhere on the board
/t_din: J5.3; also elsewhere on the board
/t_do: J5.2; also elsewhere on the board
/t_irq: J5.1; also elsewhere on the board
/uart_rx: R1401.1; also elsewhere on the board
/uart_tx: R1402.1; also elsewhere on the board
GND: J2.3, J3.2, J3.5, J5.13, RN1401.5 (R4.2), RN1401.6 (R3.2), RN1401.7 (R2.2), RN1401.8 (R1.2), RN1402.5 (R4.2), RN1402.6 (R3.2), RN1402.7 (R2.2), RN1402.8 (R1.2), RN1403.5 (R4.2), RN1403.6 (R3.2), RN1403.7 (R2.2), RN1403.8 (R1.2), RN1404.5 (R4.2), RN1404.6 (R3.2), RN1404.7 (R2.2), RN1404.8 (R1.2), RN1405.5 (R4.2), RN1405.6 (R3.2), RN1405.7 (R2.2), RN1405.8 (R1.2), RN1406.5 (R4.2), RN1406.6 (R3.2), RN1406.7 (R2.2), RN1406.8 (R1.2), RN1407.5 (R4.2), RN1407.6 (R3.2), RN1407.7 (R2.2), RN1407.8 (R1.2), RN1408.5 (R4.2), RN1408.6 (R3.2), RN1408.7 (R2.2), RN1408.8 (R1.2); also elsewhere on the board
unnamed: J2.1, R1401.2
unnamed: J2.2, R1402.2

Notes on the sheet:
J5: LCD/touch header, Ti60 J4 pinout (wired to the LCD with jumper wires).
J3 = baseboard J11 (2x19 1.27 mm socket on B.Cu, pin n = baseboard pin n, see MECHANICAL.md). Every signal pin has a 10 k pull-down so the power board sees low while the FPGA is unconfigured and the translators are disabled (MIGRATION_PLAN.md 3.2).
J2: FPGA UART, Ti60 J8 pinout.

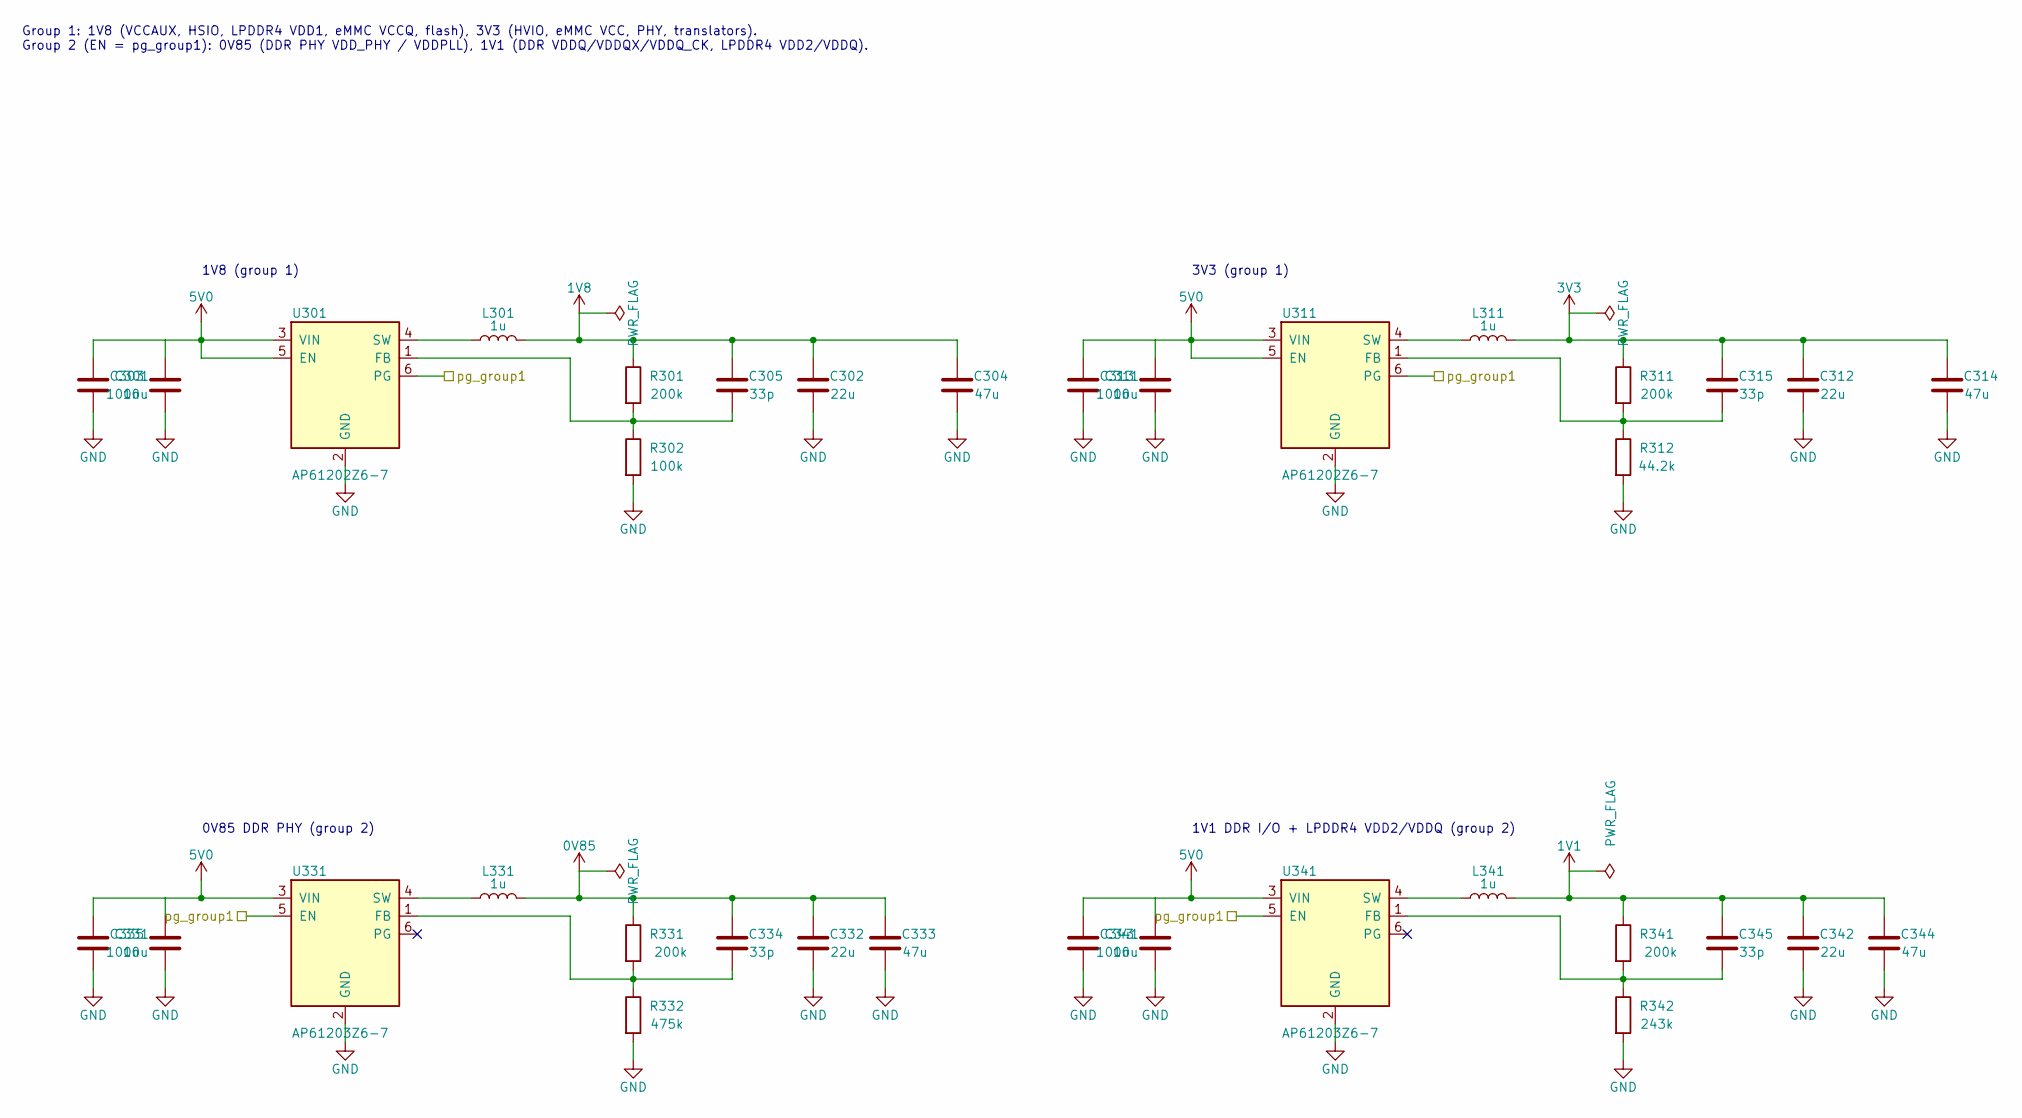
[picture p13: schematic 03_pwr_rails.kicad_sch, Ti135 control card - pwr_rails]

Parts:
C301, C311, C331, C341: 10u; C_0603_1608Metric; LCSC C109457
C302, C312, C332, C342: 22u; C_0603_1608Metric; LCSC C109447
C303, C313, C335, C343: 100n; C_0201_0603Metric; LCSC C190183
C304, C314, C333, C344: 47u; C_0805_2012Metric; LCSC C16780
C305, C315, C334, C345: 33p; C_0201_0603Metric; LCSC C277477
L301, L311, L331, L341: 1u; L_2520_FTC252012S; MPN FTC252012S1R0MBCA; LCSC C5832370
R301, R311, R331, R341: 200k; R_0201_0603Metric; LCSC C138163
R302: 100k; R_0201_0603Metric; LCSC C106224
R312: 44.2k; R_0201_0603Metric; LCSC C226551
R332: 475k; R_0201_0603Metric; LCSC C388079
R342: 243k; R_0201_0603Metric; LCSC C423644
U301, U311: AP61202Z6-7; SOT-563; LCSC C5188956
U331, U341: AP61203Z6-7; SOT-563; LCSC C5244557

Connections:
0V85: C332.1, C333.1, C334.1, L331.2, R331.1; also elsewhere on the board
1V1: C342.1, C344.1, C345.1, L341.2, R341.1; also elsewhere on the board
1V8: C302.1, C304.1, C305.1, L301.2, R301.1; also elsewhere on the board
3V3: C312.1, C314.1, C315.1, L311.2, R311.1; also elsewhere on the board
5V0: C301.1, C303.1, C311.1, C313.1, C331.1, C335.1, C341.1, C343.1, U301.3 (VIN), U301.5 (EN), U311.3 (VIN), U311.5 (EN), U331.3 (VIN), U341.3 (VIN); also elsewhere on the board
/pg_group1: U301.6 (PG), U311.6 (PG), U331.5 (EN), U341.5 (EN); also elsewhere on the board
GND: C301.2, C302.2, C303.2, C304.2, C311.2, C312.2, C313.2, C314.2, C331.2, C332.2, C333.2, C335.2, C341.2, C342.2, C343.2, C344.2, R302.2, R312.2, R332.2, R342.2, U301.2 (GND), U311.2 (GND), U331.2 (GND), U341.2 (GND); also elsewhere on the board
unnamed: C305.2, R301.2, R302.1, U301.1 (FB)
unnamed: L301.1, U301.4 (SW)
unnamed: C315.2, R311.2, R312.1, U311.1 (FB)
unnamed: L311.1, U311.4 (SW)
unnamed: C334.2, R331.2, R332.1, U331.1 (FB)
unnamed: L331.1, U331.4 (SW)
unnamed: C345.2, R341.2, R342.1, U341.1 (FB)
unnamed: L341.1, U341.4 (SW)

Notes on the sheet:
1V1 DDR I/O + LPDDR4 VDD2/VDDQ (group 2)
1V8 (group 1)
0V85 DDR PHY (group 2)
3V3 (group 1)
Group 1: 1V8 (VCCAUX, HSIO, LPDDR4 VDD1, eMMC VCCQ, flash), 3V3 (HVIO, eMMC VCC, PHY, translators). Group 2 (EN = pg_group1): 0V85 (DDR PHY VDD_PHY / VDDPLL), 1V1 (DDR VDDQ/VDDQX/VDDQ_CK, LPDDR4 VDD2/VDDQ).

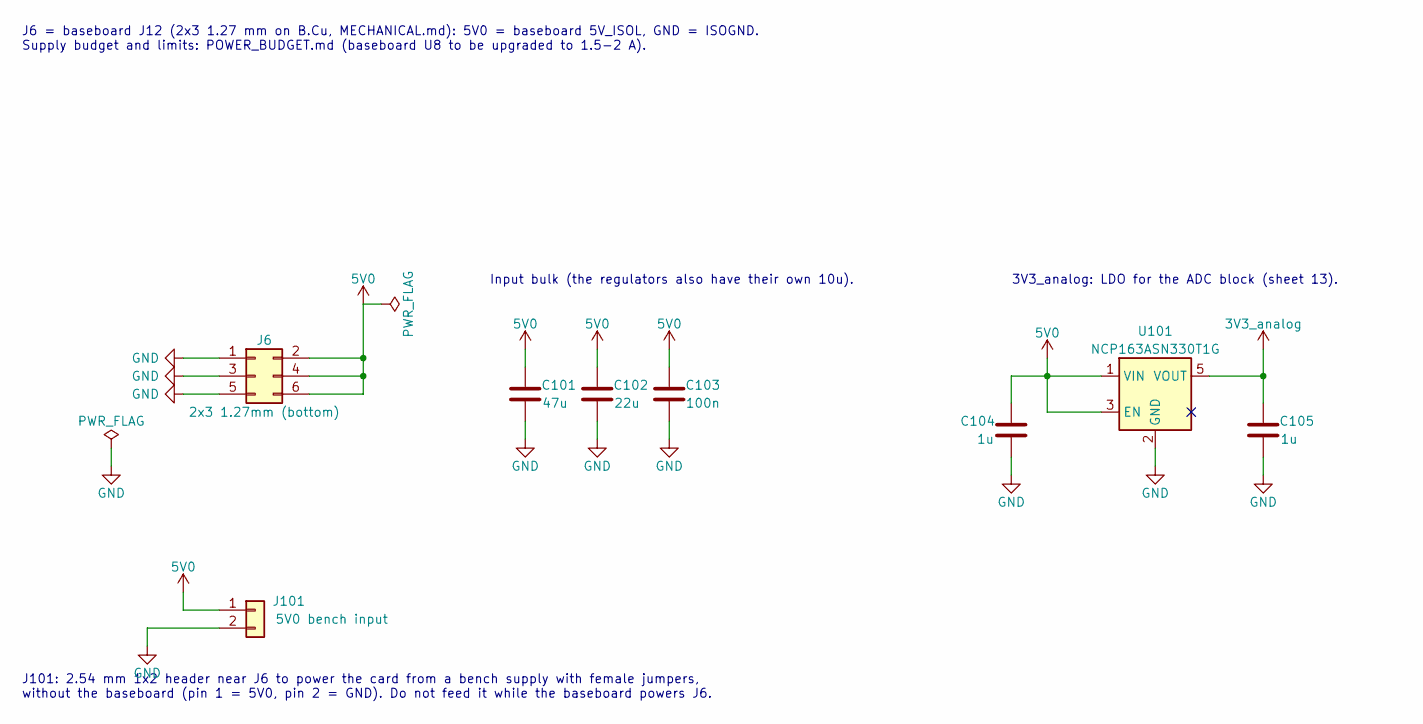
[picture p14: schematic 01_pwr_input.kicad_sch, Ti135 control card - pwr_input]

Parts:
C101: 47u; C_1206_3216Metric; LCSC C96123
C102: 22u; C_0805_2012Metric; LCSC C45783
C103: 100n; C_0402_1005Metric; LCSC C1525
C104, C105: 1u; C_0402_1005Metric; LCSC C52923
J6: 2x3 1.27mm (bottom); PinSocket_2x03_P1.27mm_Vertical; LCSC C22373841
J101: 5V0 bench input; PinHeader_1x02_P2.54mm_Vertical; LCSC C492401
U101: NCP163ASN330T1G; SOT-23-5; LCSC C603656

Connections:
3V3_analog: C105.1, U101.5 (VOUT); also elsewhere on the board
5V0: C101.1, C102.1, C103.1, C104.1, J6.2, J6.4, J6.6, J101.1, U101.1 (VIN), U101.3 (EN); also elsewhere on the board
GND: C101.2, C102.2, C103.2, C104.2, C105.2, J6.1, J6.3, J6.5, J101.2, U101.2 (GND); also elsewhere on the board

Notes on the sheet:
J101: 2.54 mm 1x2 header near J6 to power the card from a bench supply with female jumpers, without the baseboard (pin 1 = 5V0, pin 2 = GND). Do not feed it while the baseboard powers J6.
3V3_analog: LDO for the ADC block (sheet 13).
J6 = baseboard J12 (2x3 1.27 mm on B.Cu, MECHANICAL.md): 5V0 = baseboard 5V_ISOL, GND = ISOGND. Supply budget and limits: POWER_BUDGET.md (baseboard U8 to be upgraded to 1.5-2 A).
Input bulk (the regulators also have their own 10u).
