johonkanen/efinix_soc_board/kicad/ti135_card.kicad_pcb

## KiCad design kicad/ti135_card.kicad_pcb (continued)

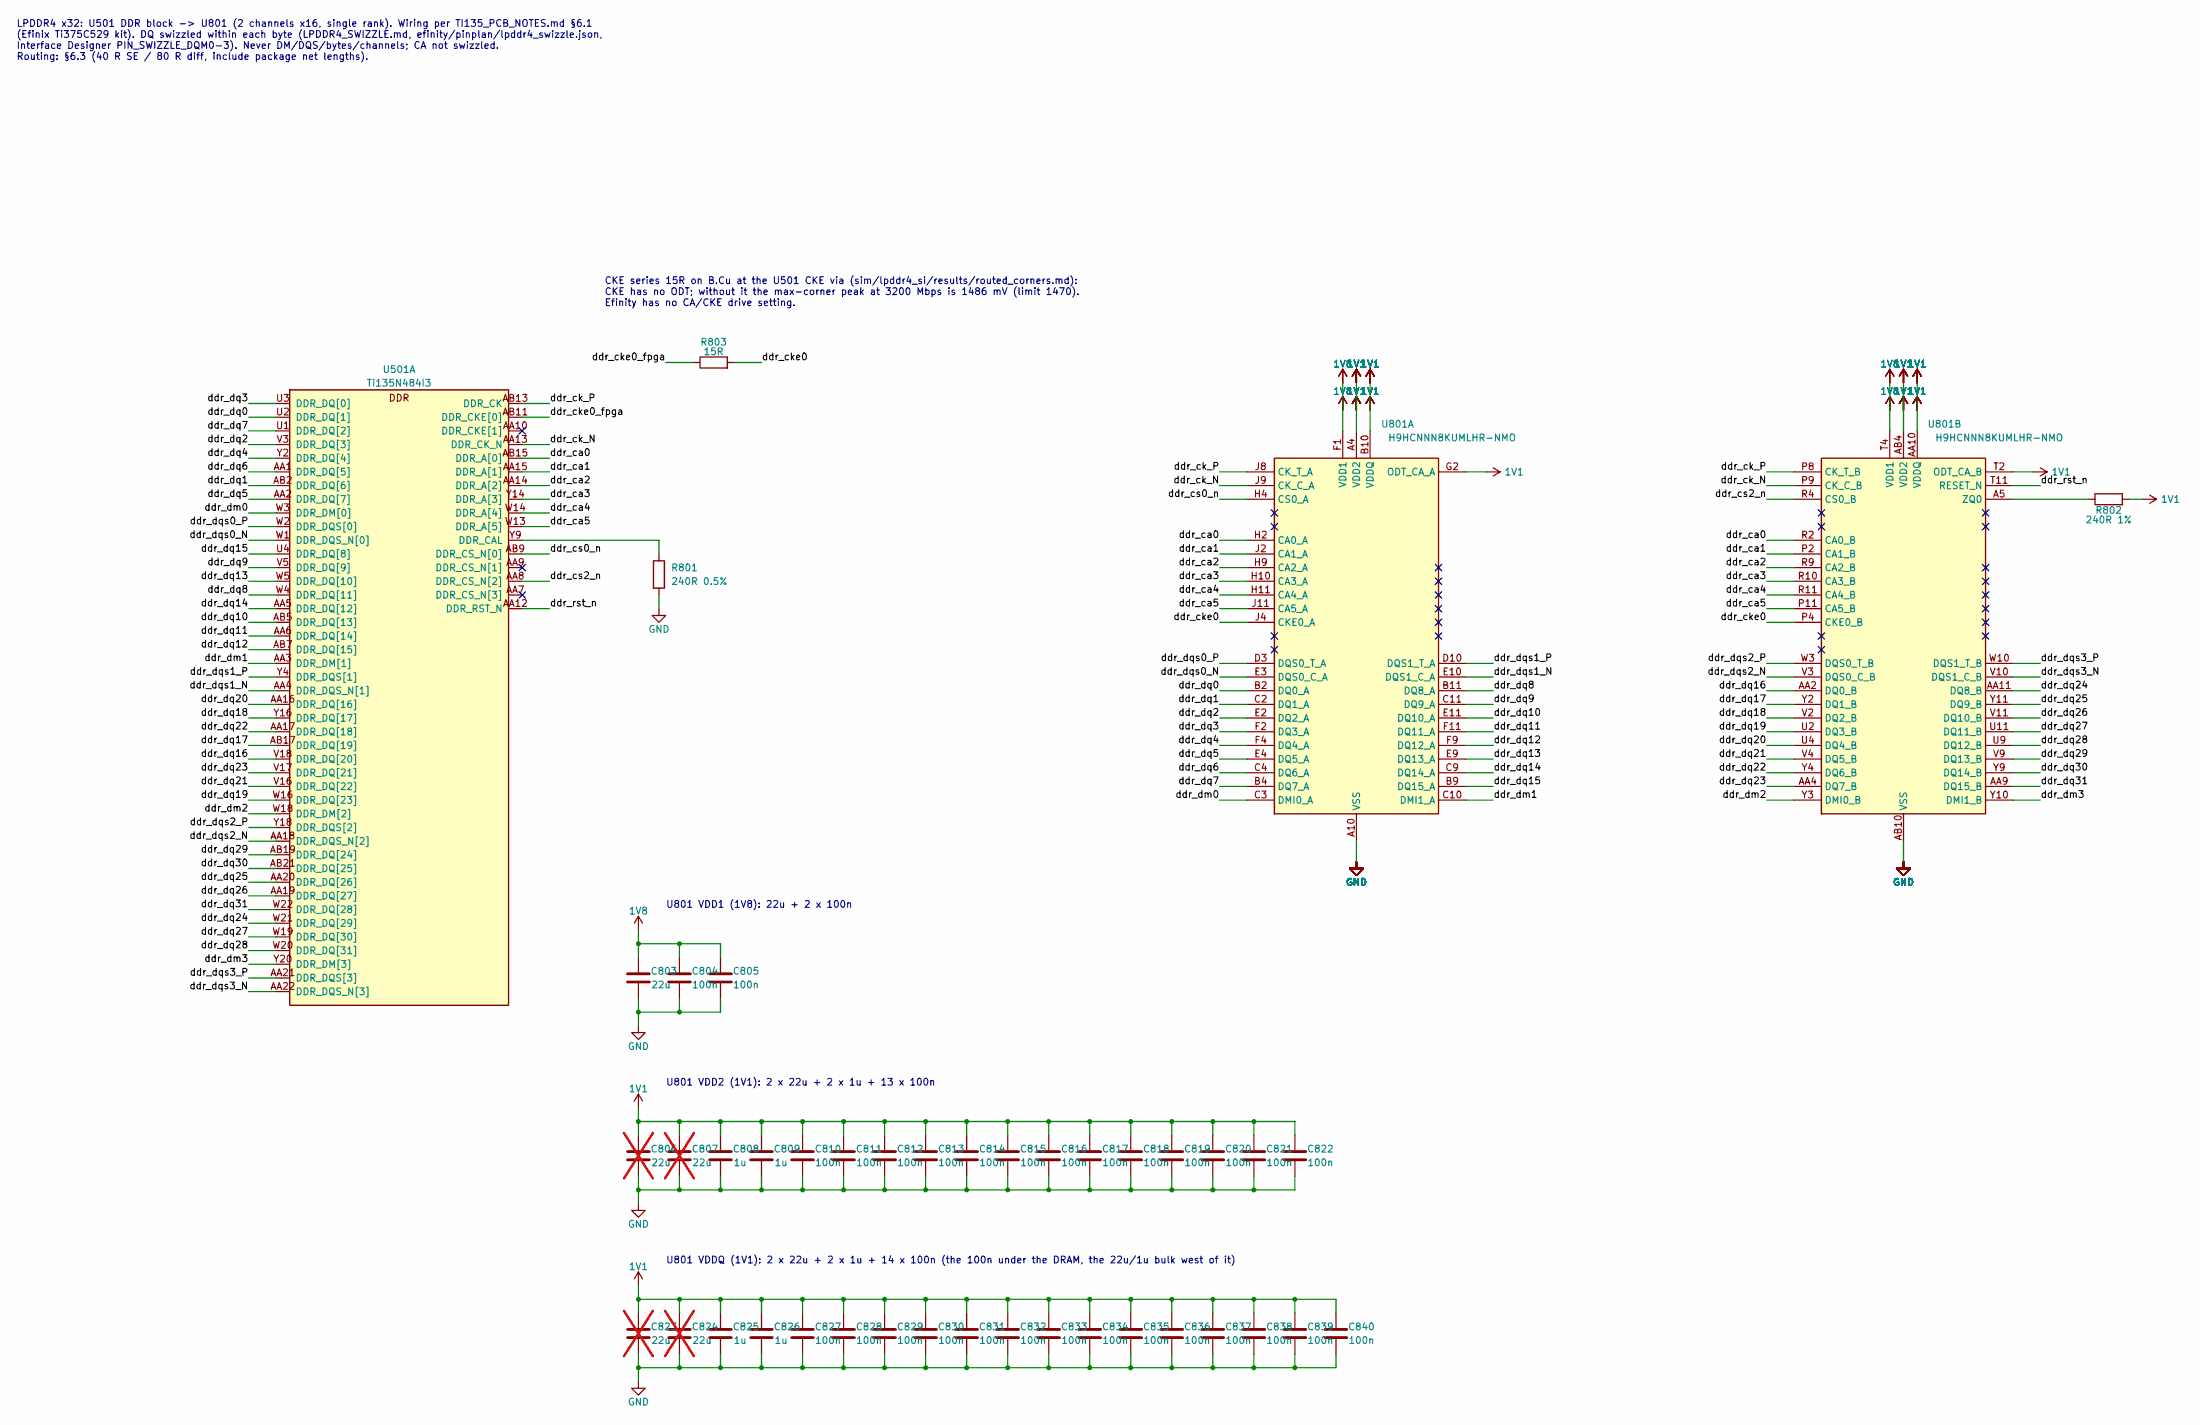
[picture p15: schematic 08_lpddr4.kicad_sch, Ti135 control card - lpddr4]

Parts:
C803: 22u; C_0402_1005Metric; LCSC C415703
C804, C805, C810, C811, C812, C813, C814, C815, C816, C817, C818, C819, C820, C821, C822, C827, C828, C829, C830, C831, C832, C833, C834, C835, C836, C837, C838, C839, C840: 100n; C_0201_0603Metric; LCSC C190183
C806, C807, C823, C824: 22u; C_0402_1005Metric; LCSC C415703; not fitted
C808, C809, C825, C826: 1u; C_0201_0603Metric; LCSC C272877
R801: 240R 0.5%; R_0201_0603Metric; MPN RC0201DR-07240RL; LCSC C851687
R802: 240R 1%; R_0402_1005Metric; LCSC C25094
R803: 15R; R_0402_1005Metric; LCSC C25083
U501: Ti135N484I3; LFBGA-484_18x18mm_Layout22x22_P0.8mm
U801: H9HCNNN8KUMLHR-NMO; BGA-200_10x15mm_Layout12x22_P0.8x0.65mm; LCSC C51891855

Connections:
1V1: C806.1, C807.1, C808.1, C809.1, C810.1, C811.1, C812.1, C813.1, C814.1, C815.1, C816.1, C817.1, C818.1, C819.1, C820.1, C821.1, C822.1, C823.1, C824.1, C825.1, C826.1, C827.1, C828.1, C829.1, C830.1, C831.1, C832.1, C833.1, C834.1, C835.1, C836.1, C837.1, C838.1, C839.1, C840.1, R802.2, U801.A4 (VDD2), U801.A9 (VDD2), U801.AA3 (VDDQ), U801.AA5 (VDDQ), U801.AA8 (VDDQ), U801.AA10 (VDDQ), U801.AB4 (VDD2), U801.AB9 (VDD2), U801.B3 (VDDQ), U801.B5 (VDDQ), U801.B8 (VDDQ), U801.B10 (VDDQ), U801.D1 (VDDQ), U801.D5 (VDDQ), U801.D8 (VDDQ), U801.D12 (VDDQ), U801.F3 (VDDQ), U801.F5 (VDD2), U801.F8 (VDD2), U801.F10 (VDDQ), U801.G2 (ODT_CA_A), U801.H1 (VDD2), U801.H5 (VDD2), U801.H8 (VDD2), U801.H12 (VDD2), U801.K1 (VDD2), U801.K3 (VDD2), U801.K10 (VDD2), U801.K12 (VDD2), U801.N1 (VDD2), U801.N3 (VDD2), U801.N10 (VDD2), U801.N12 (VDD2), U801.R1 (VDD2), U801.R5 (VDD2), U801.R8 (VDD2), U801.R12 (VDD2), U801.T2 (ODT_CA_B), U801.U3 (VDDQ), U801.U5 (VDD2), U801.U8 (VDD2), U801.U10 (VDDQ), U801.W1 (VDDQ), U801.W5 (VDDQ), U801.W8 (VDDQ), U801.W12 (VDDQ); also elsewhere on the board
1V8: C803.1, C804.1, C805.1, U801.F1 (VDD1), U801.F12 (VDD1), U801.G4 (VDD1), U801.G9 (VDD1), U801.T4 (VDD1), U801.T9 (VDD1), U801.U1 (VDD1), U801.U12 (VDD1); also elsewhere on the board
/08 lpddr4/ddr_ca0: U501.AB15 (DDR_A[0]), U801.H2 (CA0_A), U801.R2 (CA0_B)
/08 lpddr4/ddr_ca1: U501.AA15 (DDR_A[1]), U801.J2 (CA1_A), U801.P2 (CA1_B)
/08 lpddr4/ddr_ca2: U501.AA14 (DDR_A[2]), U801.H9 (CA2_A), U801.R9 (CA2_B)
/08 lpddr4/ddr_ca3: U501.Y14 (DDR_A[3]), U801.H10 (CA3_A), U801.R10 (CA3_B)
/08 lpddr4/ddr_ca4: U501.W14 (DDR_A[4]), U801.H11 (CA4_A), U801.R11 (CA4_B)
/08 lpddr4/ddr_ca5: U501.W13 (DDR_A[5]), U801.J11 (CA5_A), U801.P11 (CA5_B)
/08 lpddr4/ddr_ck_N: U501.AA13 (DDR_CK_N), U801.J9 (CK_C_A), U801.P9 (CK_C_B)
/08 lpddr4/ddr_ck_P: U501.AB13 (DDR_CK), U801.J8 (CK_T_A), U801.P8 (CK_T_B)
/08 lpddr4/ddr_cke0: R803.2, U801.J4 (CKE0_A), U801.P4 (CKE0_B)
/08 lpddr4/ddr_cke0_fpga: R803.1, U501.AB11 (DDR_CKE[0])
/08 lpddr4/ddr_cs0_n: U501.AB9 (DDR_CS_N[0]), U801.H4 (CS0_A)
/08 lpddr4/ddr_cs2_n: U501.AA8 (DDR_CS_N[2]), U801.R4 (CS0_B)
/08 lpddr4/ddr_dm0: U501.W3 (DDR_DM[0]), U801.C3 (DMI0_A)
/08 lpddr4/ddr_dm1: U501.AA3 (DDR_DM[1]), U801.C10 (DMI1_A)
/08 lpddr4/ddr_dm2: U501.W18 (DDR_DM[2]), U801.Y3 (DMI0_B)
/08 lpddr4/ddr_dm3: U501.Y20 (DDR_DM[3]), U801.Y10 (DMI1_B)
/08 lpddr4/ddr_dq0: U501.U2 (DDR_DQ[1]), U801.B2 (DQ0_A)
/08 lpddr4/ddr_dq1: U501.AB2 (DDR_DQ[6]), U801.C2 (DQ1_A)
/08 lpddr4/ddr_dq2: U501.V3 (DDR_DQ[3]), U801.E2 (DQ2_A)
/08 lpddr4/ddr_dq3: U501.U3 (DDR_DQ[0]), U801.F2 (DQ3_A)
/08 lpddr4/ddr_dq4: U501.Y2 (DDR_DQ[4]), U801.F4 (DQ4_A)
/08 lpddr4/ddr_dq5: U501.AA2 (DDR_DQ[7]), U801.E4 (DQ5_A)
/08 lpddr4/ddr_dq6: U501.AA1 (DDR_DQ[5]), U801.C4 (DQ6_A)
/08 lpddr4/ddr_dq7: U501.U1 (DDR_DQ[2]), U801.B4 (DQ7_A)
/08 lpddr4/ddr_dq8: U501.W4 (DDR_DQ[11]), U801.B11 (DQ8_A)
/08 lpddr4/ddr_dq9: U501.V5 (DDR_DQ[9]), U801.C11 (DQ9_A)
/08 lpddr4/ddr_dq10: U501.AB5 (DDR_DQ[13]), U801.E11 (DQ10_A)
/08 lpddr4/ddr_dq11: U501.AA6 (DDR_DQ[14]), U801.F11 (DQ11_A)
/08 lpddr4/ddr_dq12: U501.AB7 (DDR_DQ[15]), U801.F9 (DQ12_A)
/08 lpddr4/ddr_dq13: U501.W5 (DDR_DQ[10]), U801.E9 (DQ13_A)
/08 lpddr4/ddr_dq14: U501.AA5 (DDR_DQ[12]), U801.C9 (DQ14_A)
/08 lpddr4/ddr_dq15: U501.U4 (DDR_DQ[8]), U801.B9 (DQ15_A)
/08 lpddr4/ddr_dq16: U501.V18 (DDR_DQ[20]), U801.AA2 (DQ0_B)
/08 lpddr4/ddr_dq17: U501.AB17 (DDR_DQ[19]), U801.Y2 (DQ1_B)
/08 lpddr4/ddr_dq18: U501.Y16 (DDR_DQ[17]), U801.V2 (DQ2_B)
/08 lpddr4/ddr_dq19: U501.W16 (DDR_DQ[23]), U801.U2 (DQ3_B)
/08 lpddr4/ddr_dq20: U501.AA16 (DDR_DQ[16]), U801.U4 (DQ4_B)
/08 lpddr4/ddr_dq21: U501.V16 (DDR_DQ[22]), U801.V4 (DQ5_B)
/08 lpddr4/ddr_dq22: U501.AA17 (DDR_DQ[18]), U801.Y4 (DQ6_B)
/08 lpddr4/ddr_dq23: U501.V17 (DDR_DQ[21]), U801.AA4 (DQ7_B)
/08 lpddr4/ddr_dq24: U501.W21 (DDR_DQ[29]), U801.AA11 (DQ8_B)
/08 lpddr4/ddr_dq25: U501.AA20 (DDR_DQ[26]), U801.Y11 (DQ9_B)
/08 lpddr4/ddr_dq26: U501.AA19 (DDR_DQ[27]), U801.V11 (DQ10_B)
/08 lpddr4/ddr_dq27: U501.W19 (DDR_DQ[30]), U801.U11 (DQ11_B)
/08 lpddr4/ddr_dq28: U501.W20 (DDR_DQ[31]), U801.U9 (DQ12_B)
/08 lpddr4/ddr_dq29: U501.AB19 (DDR_DQ[24]), U801.V9 (DQ13_B)
/08 lpddr4/ddr_dq30: U501.AB21 (DDR_DQ[25]), U801.Y9 (DQ14_B)
/08 lpddr4/ddr_dq31: U501.W22 (DDR_DQ[28]), U801.AA9 (DQ15_B)
/08 lpddr4/ddr_dqs0_N: U501.W1 (DDR_DQS_N[0]), U801.E3 (DQS0_C_A)
/08 lpddr4/ddr_dqs0_P: U501.W2 (DDR_DQS[0]), U801.D3 (DQS0_T_A)
/08 lpddr4/ddr_dqs1_N: U501.AA4 (DDR_DQS_N[1]), U801.E10 (DQS1_C_A)
/08 lpddr4/ddr_dqs1_P: U501.Y4 (DDR_DQS[1]), U801.D10 (DQS1_T_A)
/08 lpddr4/ddr_dqs2_N: U501.AA18 (DDR_DQS_N[2]), U801.V3 (DQS0_C_B)
/08 lpddr4/ddr_dqs2_P: U501.Y18 (DDR_DQS[2]), U801.W3 (DQS0_T_B)
/08 lpddr4/ddr_dqs3_N: U501.AA22 (DDR_DQS_N[3]), U801.V10 (DQS1_C_B)
/08 lpddr4/ddr_dqs3_P: U501.AA21 (DDR_DQS[3]), U801.W10 (DQS1_T_B)
/08 lpddr4/ddr_rst_n: U501.AA12 (DDR_RST_N), U801.T11 (RESET_N)
GND: C803.2, C804.2, C805.2, C806.2, C807.2, C808.2, C809.2, C810.2, C811.2, C812.2, C813.2, C814.2, C815.2, C816.2, C817.2, C818.2, C819.2, C820.2, C821.2, C822.2, C823.2, C824.2, C825.2, C826.2, C827.2, C828.2, C829.2, C830.2, C831.2, C832.2, C833.2, C834.2, C835.2, C836.2, C837.2, C838.2, C839.2, C840.2, R801.2, U801.A3 (VSS), U801.A10 (VSS), U801.AB3 (VSS), U801.AB5 (VSS), U801.AB8 (VSS), U801.AB10 (VSS), U801.C1 (VSS), U801.C5 (VSS), U801.C8 (VSS), U801.C12 (VSS), U801.D2 (VSS), U801.D4 (VSS), U801.D9 (VSS), U801.D11 (VSS), U801.E1 (VSS), U801.E5 (VSS), U801.E8 (VSS), U801.E12 (VSS), U801.G1 (VSS), U801.G3 (VSS), U801.G5 (VSS), U801.G8 (VSS), U801.G10 (VSS), U801.G12 (VSS), U801.J1 (VSS), U801.J3 (VSS), U801.J10 (VSS), U801.J12 (VSS), U801.K2 (VSS), U801.K4 (VSS), U801.K9 (VSS), U801.K11 (VSS), U801.N2 (VSS), U801.N4 (VSS), U801.N9 (VSS), U801.N11 (VSS), U801.P1 (VSS), U801.P3 (VSS), U801.P10 (VSS), U801.P12 (VSS), U801.T1 (VSS), U801.T3 (VSS), U801.T5 (VSS), U801.T8 (VSS), U801.T10 (VSS), U801.T12 (VSS), U801.V1 (VSS), U801.V5 (VSS), U801.V8 (VSS), U801.V12 (VSS), U801.W2 (VSS), U801.W4 (VSS), U801.W9 (VSS), U801.W11 (VSS), U801.Y1 (VSS), U801.Y5 (VSS), U801.Y8 (VSS), U801.Y12 (VSS); also elsewhere on the board
unnamed: R801.1, U501.Y9 (DDR_CAL)
unnamed: R802.1, U801.A5 (ZQ0)

Notes on the sheet:
LPDDR4 x32: U501 DDR block -> U801 (2 channels x16, single rank). Wiring per TI135_PCB_NOTES.md §6.1 (Efinix Ti375C529 kit). DQ swizzled within each byte (LPDDR4_SWIZZLE.md, efinity/pinplan/lpddr4_swizzle.json, Interface Designer PIN_SWIZZLE_DQM0-3). Never DM/DQS/bytes/channels; CA not swizzled. Ro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
U801 VDD1 (1V8): 22u + 2 x 100n
U801 VDD2 (1V1): 2 x 22u + 2 x 1u + 13 x 100n
CKE series 15R on B.Cu at the U501 CKE via (sim/lpddr4_si/results/routed_corners.md): CKE has no ODT; without it the max-corner peak at 3200 Mbps is 1486 mV (limit 1470). Efinity has no CA/CKE drive setting.
U801 VDDQ (1V1): 2 x 22u + 2 x 1u + 14 x 100n (the 100n under the DRAM, the 22u/1u bulk west of it)

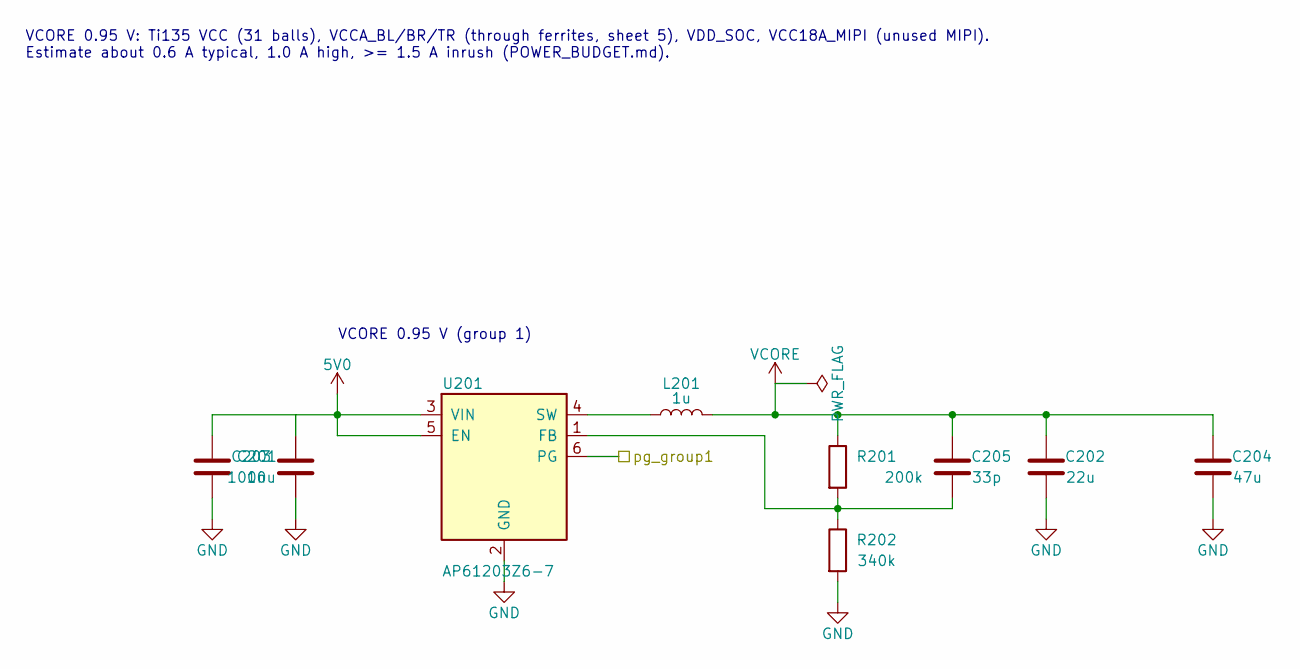
[picture p16: schematic 02_pwr_vcore.kicad_sch, Ti135 control card - pwr_vcore]

Parts:
C201: 10u; C_0603_1608Metric; LCSC C109457
C202: 22u; C_0603_1608Metric; LCSC C109447
C203: 100n; C_0201_0603Metric; LCSC C190183
C204: 47u; C_0805_2012Metric; LCSC C16780
C205: 33p; C_0201_0603Metric; LCSC C277477
L201: 1u; L_2520_FTC252012S; MPN FTC252012S1R0MBCA; LCSC C5832370
R201: 200k; R_0201_0603Metric; LCSC C138163
R202: 340k; R_0201_0603Metric; LCSC C423573
U201: AP61203Z6-7; SOT-563; LCSC C5244557

Connections:
5V0: C201.1, C203.1, U201.3 (VIN), U201.5 (EN); also elsewhere on the board
/pg_group1: U201.6 (PG); also elsewhere on the board
GND: C201.2, C202.2, C203.2, C204.2, R202.2, U201.2 (GND); also elsewhere on the board
unnamed: C205.2, R201.2, R202.1, U201.1 (FB)
unnamed: L201.1, U201.4 (SW)
VCORE: C202.1, C204.1, C205.1, L201.2, R201.1; also elsewhere on the board

Notes on the sheet:
VCORE 0.95 V: Ti135 VCC (31 balls), VCCA_BL/BR/TR (through ferrites, sheet 5), VDD_SOC, VCC18A_MIPI (unused MIPI). Estimate about 0.6 A typical, 1.0 A high, >= 1.5 A inrush (POWER_BUDGET.md).
VCORE 0.95 V (group 1)

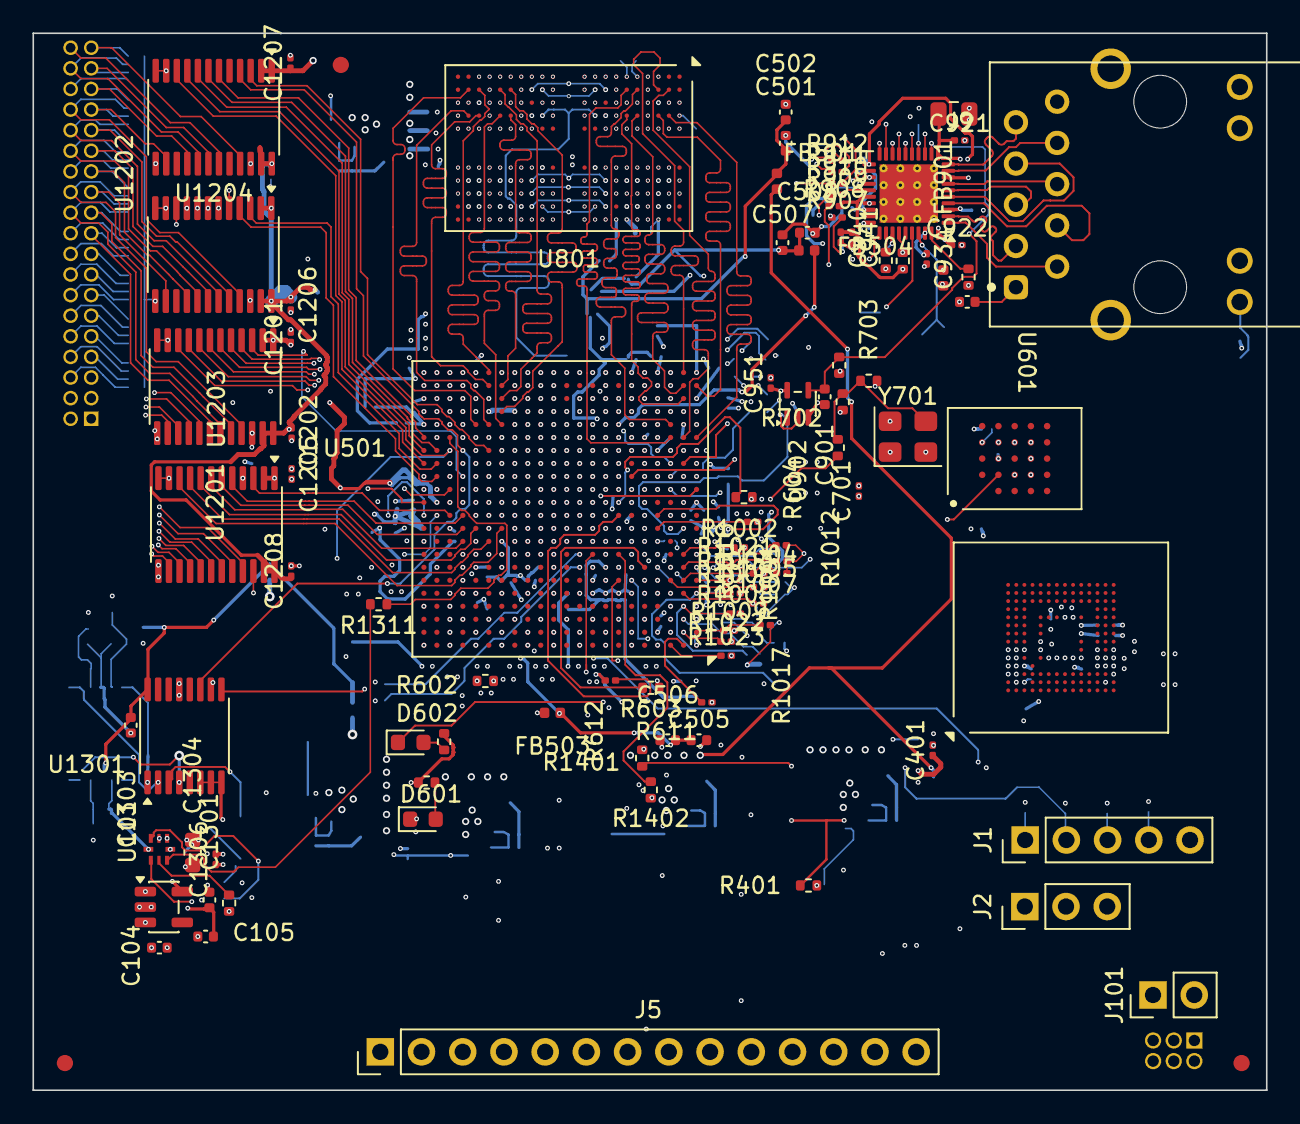
[picture p17: board ti135_card.kicad_pcb from above]

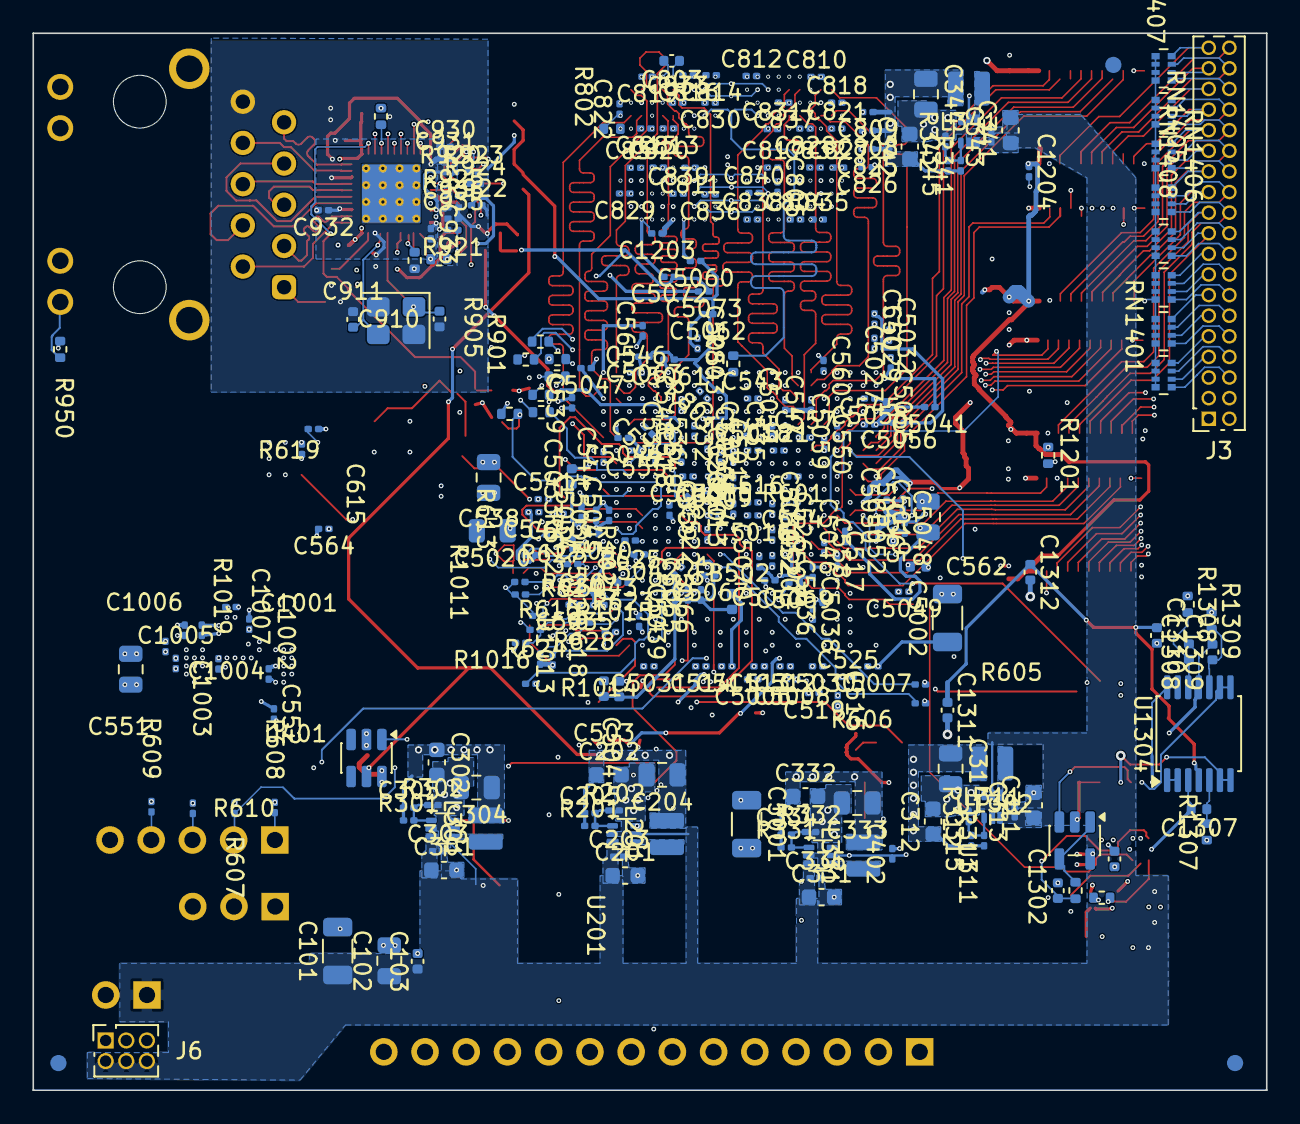
[picture p18: board ti135_card.kicad_pcb from below]

Board: 8 copper layers, 76.0 x 65.1 mm, 394 parts (296 on the bottom side), 291 nets.

Other parts of the board:
FID1, FID2, FID3, FID4, FID5, FID6: Fiducial; Fiducial_1mm_Mask2mm
