johonkanen/efinix_soc_board/sim/lpddr4_si/lpddr4_si.kicad_sch

## KiCad design sim/lpddr4_si/lpddr4_si.kicad_sch (2026-10-28)

Schematic: lpddr4_si.kicad_sch

Parts:
C1, C2, C5, C6, C9, C10, C11, C12, C15, C16, C17, C18, C21, C22, C23, C24, C25, C26, C27, C28, C29, C30, C31, C32, C33, C34, C35, C36, C37, C38, C39, C40, C41, C42, C43, C44, C45, C46, C47, C48, C49, C50, C51, C52, C53, C54, C55, C56, C57, C58, C59, C60, C61, C62, C63, C64, C65, C66, C67, C68, C69, C70, C71, C72, C73, C74, C75, C76, C77, C78, C79, C80, C81, C82, C83, C84, C85, C86, C87, C88, C89, C90, C93, C94, C97, C98, C101, C102, C105, C106, C109, C110, C113, C114, C117, C118, C121, C122, C125, C126, C129, C130, C135, C136, C137, C138, C139, C140, C145, C146, C147, C148, C153, C154, C155, C156, C157, C158, C163, C164, C169, C170, C171, C172, C173, C174, C175, C176, C177, C178, C181, C182, C183, C184, C185, C186, C187, C188, C189, C190: 200f
C3, C4, C7, C8, C13, C14, C19, C20, C91, C92, C95, C96, C99, C100, C103, C104, C107, C108, C111, C112, C115, C116, C119, C120, C123, C124, C127, C128, C131, C132, C133, C134, C141, C142, C143, C144, C149, C150, C151, C152, C159, C160, C161, C162, C165, C166, C167, C168, C179, C180, C191, C192, C193, C194: 175f
L1, L2, L3, L4, L7, L10, L11, L12, L13, L14, L15, L20, L21, L26, L31, L34, L37, L39, L41, L43, L45, L46, L47, L48, L74: 150p
L5, L8, L27, L28, L29, L30, L33, L36, L38, L40, L42, L44, L49, L50, L51, L52, L53, L54, L55, L56, L57, L58, L59, L60, L61, L62, L63, L64, L65, L66, L67, L68, L69, L70, L71, L72, L73, L75, L76, L77, L78, L79, L80, L81, L82, L83, L84, L85, L86, L87, L88, L89, L90, L91, L92, L93, L94, L95, L96, L97: 500p
L6, L9, L16, L17, L18, L19, L22, L23, L24, L25, L32, L35: 400p
TL1, TL10: TLINE 50.6R 91.4ps
TL2, TL6: TLINE 60.37R 33.6ps
TL3, TL5, TL7, TL9: TLINE 52.63R 84.0ps
TL4, TL8: TLINE 39.75R 94.8ps
TL11, TL22: TLINE 50.6R 108.5ps
TL12, TL14, TL17, TL19, TL124, TL126: TLINE 60.37R 1.5ps
TL13, TL18: TLINE 39.28R 6.1ps
TL15, TL20: TLINE 39.75R 206.2ps
TL16, TL21: TLINE 39.75R 17.1ps
TL23, TL34: TLINE 50.6R 79.6ps
TL24, TL26, TL29, TL31: TLINE 60.37R 3.9ps
TL25, TL30: TLINE 39.28R 206.8ps
TL27, TL32: TLINE 39.75R 16.0ps
TL28, TL33: TLINE 60.37R 3.1ps
TL35, TL56: TLINE 50.6R 69.6ps
TL36, TL38, TL46, TL48: TLINE 52.63R 9.9ps
TL37, TL47: TLINE 39.75R 23.0ps
TL39, TL49: TLINE 39.75R 4.9ps
TL40, TL50: TLINE 39.75R 47.8ps
TL41, TL51: TLINE 39.75R 20.4ps
TL42, TL52: TLINE 39.75R 31.3ps
TL43, TL45, TL53, TL55: TLINE 60.37R 2.9ps
TL44, TL54: TLINE 39.28R 4.9ps
TL57, TL66: TLINE 50.6R 63.6ps
TL58, TL60, TL61, TL62, TL64, TL65, TL171, TL173: TLINE 60.37R 11.0ps
TL59, TL63: TLINE 39.28R 128.8ps
TL67, TL78: TLINE 50.6R 36.5ps
TL68, TL73: TLINE 39.75R 39.2ps
TL69, TL74: TLINE 39.75R 156.9ps
TL70, TL72, TL75, TL77: TLINE 60.37R 9.0ps
TL71, TL76: TLINE 39.28R 16.2ps
TL79, TL88: TLINE 50.6R 63.2ps
TL80, TL84: TLINE 39.75R 57.7ps
TL81, TL85: TLINE 39.28R 86.6ps
TL82, TL86: TLINE 39.75R 6.5ps
TL83, TL87: TLINE 60.37R 18.6ps
TL89, TL98: TLINE 50.6R 54.4ps
TL90, TL92, TL94, TL96: TLINE 60.37R 6.5ps
TL91, TL95: TLINE 39.28R 137.5ps
TL93, TL97: TLINE 39.75R 11.5ps
TL99, TL113: TLINE 50.6R 87.7ps
TL100, TL102, TL107, TL109: TLINE 52.63R 21.8ps
TL101, TL108: TLINE 40.3R 194.4ps
TL103, TL114: TLINE 50.6R 88.1ps
TL104, TL106, TL110, TL112: TLINE 52.63R 19.1ps
TL105, TL111: TLINE 40.3R 198.8ps
TL115, TL117, TL121, TL122: TLINE 50.6R 71.2ps
TL116, TL119: TLINE 39.81R 112.1ps
TL118, TL120: TLINE 39.81R 117.5ps
TL123: TLINE 50.6R 89.5ps
TL125: TLINE 39.81R 20.3ps
TL127, TL129, TL134, TL136, TL144, TL146, TL151, TL153, TL161, TL163, TL168, TL170, TL176, TL178: TLINE 52.63R 21.0ps
TL128: TLINE 40.3R 154.2ps
TL130, TL131, TL141, TL142, TL148, TL149, TL199, TL200: TLINE 52.63R 11.1ps
TL132: TLINE 50.6R 89.3ps
TL133: TLINE 60.37R 10.9ps
TL135: TLINE 40.3R 99.7ps
TL137, TL139: TLINE 60.37R 13.9ps
TL138: TLINE 39.81R 15.3ps
TL140, TL147, TL157: TLINE 52.63R 1.8ps
TL143: TLINE 50.6R 59.7ps
TL145: TLINE 39.75R 319.7ps
TL150: TLINE 50.6R 50.7ps
TL152: TLINE 39.75R 304.4ps
TL154, TL156: TLINE 60.37R 6.1ps
TL155: TLINE 39.28R 2.1ps
TL158, TL159: TLINE 52.63R 15.7ps
TL160: TLINE 50.6R 35.7ps
TL162: TLINE 39.75R 86.1ps
TL164, TL165: TLINE 52.63R 21.3ps
TL166: TLINE 50.6R 66.0ps
TL167: TLINE 60.37R 24.7ps
TL169: TLINE 39.75R 275.6ps
TL172: TLINE 39.28R 1.2ps
TL174: TLINE 50.6R 60.9ps
TL175: TLINE 60.37R 37.2ps
TL177: TLINE 39.75R 200.5ps
TL179, TL181: TLINE 60.37R 3.6ps
TL180: TLINE 39.28R 10.8ps
TL182, TL184: TLINE 52.63R 5.2ps
TL183: TLINE 39.75R 40.9ps
TL185: TLINE 50.6R 54.1ps
TL186, TL188: TLINE 52.63R 10.2ps
TL187: TLINE 39.75R 30.4ps
TL189, TL191: TLINE 60.37R 6.0ps
TL190: TLINE 39.28R 10.4ps
TL192: TLINE 39.75R 21.9ps
TL193, TL195: TLINE 60.37R 13.4ps
TL194: TLINE 39.28R 4.7ps
TL196, TL198: TLINE 52.63R 3.1ps
TL197: TLINE 39.75R 13.1ps
U1, U5, U9, U13, U17, U21, U25, U29, U55, U58, U61, U64, U66, U68: lpddr4_ocd_40p_40n
U2, U6, U10, U14, U18, U22, U26, U30, U35, U36, U43, U44: ODT_60
U3, U7, U11, U15, U19, U23, U27, U31, U37, U38, U45, U46: PD40_ODT40_VOH30
U4, U8, U12, U16, U20, U24, U28, U32: lpddr4_odt_60
U33, U34, U41, U42, U49, U50: lpddr4_ocd_40p_40n_diff
U39, U40, U47, U48: lpddr4_odt_60_diff
U51, U52, U53, U54: CLK_ODT_40
U56, U57, U59, U60, U62, U63: CA_ODT_40
U65, U67: CS_ODT_40
U69, U70: CKE_INPUT

Connections:
GND: C1.2, C2.2, C3.2, C4.2, C5.2, C6.2, C7.2, C8.2, C9.2, C10.2, C11.2, C12.2, C13.2, C14.2, C15.2, C16.2, C17.2, C18.2, C19.2, C20.2, C21.2, C22.2, C23.2, C24.2, C25.2, C26.2, C27.2, C28.2, C29.2, C30.2, C31.2, C32.2, C33.2, C34.2, C35.2, C36.2, C37.2, C38.2, C39.2, C40.2, C41.2, C42.2, C43.2, C44.2, C45.2, C46.2, C47.2, C48.2, C49.2, C50.2, C51.2, C52.2, C53.2, C54.2, C55.2, C56.2, C57.2, C58.2, C59.2, C60.2, C61.2, C62.2, C63.2, C64.2, C65.2, C66.2, C67.2, C68.2, C69.2, C70.2, C71.2, C72.2, C73.2, C74.2, C75.2, C76.2, C77.2, C78.2, C79.2, C80.2, C81.2, C82.2, C83.2, C84.2, C85.2, C86.2, C87.2, C88.2, C89.2, C90.2, C91.2, C92.2, C93.2, C94.2, C95.2, C96.2, C97.2, C98.2, C99.2, C100.2, C101.2, C102.2, C103.2, C104.2, C105.2, C106.2, C107.2, C108.2, C109.2, C110.2, C111.2, C112.2, C113.2, C114.2, C115.2, C116.2, C117.2, C118.2, C119.2, C120.2, C121.2, C122.2, C123.2, C124.2, C125.2, C126.2, C127.2, C128.2, C129.2, C130.2, C131.2, C132.2, C133.2, C134.2, C135.2, C136.2, C137.2, C138.2, C139.2, C140.2, C141.2, C142.2, C143.2, C144.2, C145.2, C146.2, C147.2, C148.2, C149.2, C150.2, C151.2, C152.2, C153.2, C154.2, C155.2, C156.2, C157.2, C158.2, C159.2, C160.2, C161.2, C162.2, C163.2, C164.2, C165.2, C166.2, C167.2, C168.2, C169.2, C170.2, C171.2, C172.2, C173.2, C174.2, C175.2, C176.2, C177.2, C178.2, C179.2, C180.2, C181.2, C182.2, C183.2, C184.2, C185.2, C186.2, C187.2, C188.2, C189.2, C190.2, C191.2, C192.2, C193.2, C194.2, TL1.2, TL1.4, TL2.2, TL2.4, TL3.2, TL3.4, TL4.2, TL4.4, TL5.2, TL5.4, TL6.2, TL6.4, TL7.2, TL7.4, TL8.2, TL8.4, TL9.2, TL9.4, TL10.2, TL10.4, TL11.2, TL11.4, TL12.2, TL12.4, TL13.2, TL13.4, TL14.2, TL14.4, TL15.2, TL15.4, TL16.2, TL16.4, TL17.2, TL17.4, TL18.2, TL18.4, TL19.2, TL19.4, TL20.2, TL20.4, TL21.2, TL21.4, TL22.2, TL22.4, TL23.2, TL23.4, TL24.2, TL24.4, TL25.2, TL25.4, TL26.2, TL26.4, TL27.2, TL27.4, TL28.2, TL28.4, TL29.2, TL29.4, TL30.2, TL30.4, TL31.2, TL31.4, TL32.2, TL32.4, TL33.2, TL33.4, TL34.2, TL34.4, TL35.2, TL35.4, TL36.2, TL36.4, TL37.2, TL37.4, TL38.2, TL38.4, TL39.2, TL39.4, TL40.2, TL40.4, TL41.2, TL41.4, TL42.2, TL42.4, TL43.2, TL43.4, TL44.2, TL44.4, TL45.2, TL45.4, TL46.2, TL46.4, TL47.2, TL47.4, TL48.2, TL48.4, TL49.2, TL49.4, TL50.2, TL50.4, TL51.2, TL51.4, TL52.2, TL52.4, TL53.2, TL53.4, TL54.2, TL54.4, TL55.2, TL55.4, TL56.2, TL56.4, TL57.2, TL57.4, TL58.2, TL58.4, TL59.2, TL59.4, TL60.2, TL60.4, TL61.2, TL61.4, TL62.2, TL62.4, TL63.2, TL63.4, TL64.2, TL64.4, TL65.2, TL65.4, TL66.2, TL66.4, TL67.2, TL67.4, TL68.2, TL68.4, TL69.2, TL69.4, TL70.2, TL70.4, TL71.2, TL71.4, TL72.2, TL72.4, TL73.2, TL73.4, TL74.2, TL74.4, TL75.2, TL75.4, TL76.2, TL76.4, TL77.2, TL77.4, TL78.2, TL78.4, TL79.2, TL79.4, TL80.2, TL80.4, TL81.2, TL81.4, TL82.2, TL82.4, TL83.2, TL83.4, TL84.2, TL84.4, TL85.2, TL85.4, TL86.2, TL86.4, TL87.2, TL87.4, TL88.2, TL88.4, TL89.2, TL89.4, TL90.2, TL90.4, TL91.2, TL91.4, TL92.2, TL92.4, TL93.2, TL93.4, TL94.2, TL94.4, TL95.2, TL95.4, TL96.2, TL96.4, TL97.2, TL97.4, TL98.2, TL98.4, TL99.2, TL99.4, TL100.2, TL100.4, TL101.2, TL101.4, TL102.2, TL102.4, TL103.2, TL103.4, TL104.2, TL104.4, TL105.2, TL105.4, TL106.2, TL106.4, TL107.2, TL107.4, TL108.2, TL108.4, TL109.2, TL109.4, TL110.2, TL110.4, TL111.2, TL111.4, TL112.2, TL112.4, TL113.2, TL113.4, TL114.2, TL114.4, TL115.2, TL115.4, TL116.2, TL116.4, TL117.2, TL117.4, TL118.2, TL118.4, TL119.2, TL119.4, TL120.2, TL120.4, TL121.2, TL121.4, TL122.2, TL122.4, TL123.2, TL123.4, TL124.2, TL124.4, TL125.2, TL125.4, TL126.2, TL126.4, TL127.2, TL127.4, TL128.2, TL128.4, TL129.2, TL129.4, TL130.2, TL130.4, TL131.2, TL131.4, TL132.2, TL132.4, TL133.2, TL133.4, TL134.2, TL134.4, TL135.2, TL135.4, TL136.2, TL136.4, TL137.2, TL137.4, TL138.2, TL138.4, TL139.2, TL139.4, TL140.2, TL140.4, TL141.2, TL141.4, TL142.2, TL142.4, TL143.2, TL143.4, TL144.2, TL144.4, TL145.2, TL145.4, TL146.2, TL146.4, TL147.2, TL147.4, TL148.2, TL148.4, TL149.2, TL149.4, TL150.2, TL150.4, TL151.2, TL151.4, TL152.2, TL152.4, TL153.2, TL153.4, TL154.2, TL154.4, TL155.2, TL155.4, TL156.2, TL156.4, TL157.2, TL157.4, TL158.2, TL158.4, TL159.2, TL159.4, TL160.2, TL160.4, TL161.2, TL161.4, TL162.2, TL162.4, TL163.2, TL163.4, TL164.2, TL164.4, TL165.2, TL165.4, TL166.2, TL166.4, TL167.2, TL167.4, TL168.2, TL168.4, TL169.2, TL169.4, TL170.2, TL170.4, TL171.2, TL171.4, TL172.2, TL172.4, TL173.2, TL173.4, TL174.2, TL174.4, TL175.2, TL175.4, TL176.2, TL176.4, TL177.2, TL177.4, TL178.2, TL178.4, TL179.2, TL179.4, TL180.2, TL180.4, TL181.2, TL181.4, TL182.2, TL182.4, TL183.2, TL183.4, TL184.2, TL184.4, TL185.2, TL185.4, TL186.2, TL186.4, TL187.2, TL187.4, TL188.2, TL188.4, TL189.2, TL189.4, TL190.2, TL190.4, TL191.2, TL191.4, TL192.2, TL192.4, TL193.2, TL193.4, TL194.2, TL194.4, TL195.2, TL195.4, TL196.2, TL196.4, TL197.2, TL197.4, TL198.2, TL198.4, TL199.2, TL199.4, TL200.2, TL200.4, U1.1 (REF), U2.1 (REF), U3.1 (REF), U4.1 (REF), U5.1 (REF), U6.1 (REF), U7.1 (REF), U8.1 (REF), U9.1 (REF), U10.1 (REF), U11.1 (REF), U12.1 (REF), U13.1 (REF), U14.1 (REF), U15.1 (REF), U16.1 (REF), U17.1 (REF), U18.1 (REF), U19.1 (REF), U20.1 (REF), U21.1 (REF), U22.1 (REF), U23.1 (REF), U24.1 (REF), U25.1 (REF), U26.1 (REF), U27.1 (REF), U28.1 (REF), U29.1 (REF), U30.1 (REF), U31.1 (REF), U32.1 (REF), U33.1 (REF), U34.1 (REF), U35.1 (REF), U36.1 (REF), U37.1 (REF), U38.1 (REF), U39.1 (REF), U40.1 (REF), U41.1 (REF), U42.1 (REF), U43.1 (REF), U44.1 (REF), U45.1 (REF), U46.1 (REF), U47.1 (REF), U48.1 (REF), U49.1 (REF), U50.1 (REF), U51.1 (REF), U52.1 (REF), U53.1 (REF), U54.1 (REF), U55.1 (REF), U56.1 (REF), U57.1 (REF), U58.1 (REF), U59.1 (REF), U60.1 (REF), U61.1 (REF), U62.1 (REF), U63.1 (REF), U64.1 (REF), U65.1 (REF), U66.1 (REF), U67.1 (REF), U68.1 (REF), U69.1 (REF), U70.1 (REF)
ca1_40_1: C146.1, L73.2, TL144.1
ca1_40_2: C147.1, L74.1, TL146.3
ca1_40_3: TL144.3, TL145.1
ca1_40_4: TL145.3, TL146.1
ca1_40_5: C148.1, L74.2, TL147.1
ca1_40_6: C149.1, L75.1, TL148.3
ca1_40_7: C151.1, L76.1, TL149.3
ca1_40_fb: C145.1, L73.1, TL143.3
ca1_40_ma: C150.1, L75.2, U56.2
ca1_40_mb: C152.1, L76.2, U57.2
ca1_40_pkg: TL143.1, U55.2
ca1_40_t: TL147.3, TL148.1, TL149.1
ca2_40_1: C154.1, L77.2, TL151.1
ca2_40_2: C155.1, L78.1, TL153.3
ca2_40_3: TL151.3, TL152.1
ca2_40_4: TL152.3, TL153.1
ca2_40_5: C156.1, L78.2, TL154.1
ca2_40_6: C157.1, L79.1, TL156.3
ca2_40_7: TL154.3, TL155.1
ca2_40_8: TL155.3, TL156.1
ca2_40_9: C158.1, L79.2, TL157.1
ca2_40_10: C159.1, L80.1, TL158.3
ca2_40_11: C161.1, L81.1, TL159.3
ca2_40_fb: C153.1, L77.1, TL150.3
ca2_40_ma: C160.1, L80.2, U59.2
ca2_40_mb: C162.1, L81.2, U60.2
ca2_40_pkg: TL150.1, U58.2
ca2_40_t: TL157.3, TL158.1, TL159.1
ca4_40_1: C164.1, L82.2, TL161.1
ca4_40_2: TL161.3, TL162.1
ca4_40_3: TL162.3, TL163.1
ca4_40_4: C165.1, L83.1, TL164.3
ca4_40_5: C167.1, L84.1, TL165.3
ca4_40_fb: C163.1, L82.1, TL160.3
ca4_40_ma: C166.1, L83.2, U62.2
ca4_40_mb: C168.1, L84.2, U63.2
ca4_40_pkg: TL160.1, U61.2
ca4_40_t: TL163.3, TL164.1, TL165.1
ck_40n_1: C135.1, L68.1, TL133.3
ck_40n_2: C136.1, L68.2, TL134.1
ck_40n_3: C137.1, L69.1, TL136.3
ck_40n_4: TL134.3, TL135.1
ck_40n_5: TL135.3, TL136.1
ck_40n_6: C138.1, L69.2, TL137.1
ck_40n_7: C139.1, L70.1, TL139.3
ck_40n_8: TL137.3, TL138.1
ck_40n_9: TL138.3, TL139.1
ck_40n_10: C140.1, L70.2, TL140.1
ck_40n_11: C141.1, L71.1, TL141.3
ck_40n_12: C143.1, L72.1, TL142.3
ck_40n_fb: TL132.3, TL133.1
ck_40n_ma: C142.1, L71.2, U52.2
ck_40n_mb: C144.1, L72.2, U54.2
ck_40n_pkg: TL132.1, U50.2
ck_40n_t: TL140.3, TL141.1, TL142.1
ck_40p_1: C129.1, L65.1, TL126.3
ck_40p_2: TL124.3, TL125.1
ck_40p_3: TL125.3, TL126.1
ck_40p_4: C130.1, L65.2, TL127.1
ck_40p_5: TL127.3, TL128.1
ck_40p_6: TL128.3, TL129.1
ck_40p_7: C131.1, L66.1, TL130.3
ck_40p_8: C133.1, L67.1, TL131.3
ck_40p_fb: TL123.3, TL124.1
ck_40p_ma: C132.1, L66.2, U51.2
ck_40p_mb: C134.1, L67.2, U53.2
ck_40p_pkg: TL123.1, U49.2
ck_40p_t: TL129.3, TL130.1, TL131.1
cke0_40_1: C182.1, L91.2, TL186.1
cke0_40_2: C183.1, L92.1, TL188.3
cke0_40_3: TL186.3, TL187.1
cke0_40_4: TL187.3, TL188.1
cke0_40_5: C184.1, L92.2, TL189.1
cke0_40_6: C185.1, L93.1, TL191.3
cke0_40_7: TL189.3, TL190.1
cke0_40_8: TL190.3, TL191.1
cke0_40_9: C186.1, L93.2, TL192.1
cke0_40_10: C187.1, L94.1, TL192.3
cke0_40_11: C188.1, L94.2, TL193.1
cke0_40_12: C189.1, L95.1, TL195.3
cke0_40_13: TL193.3, TL194.1
cke0_40_14: TL194.3, TL195.1
cke0_40_15: C190.1, L95.2, TL196.1
cke0_40_16: TL196.3, TL197.1
cke0_40_17: TL197.3, TL198.1
cke0_40_18: C191.1, L96.1, TL199.3
cke0_40_19: C193.1, L97.1, TL200.3
cke0_40_fb: C181.1, L91.1, TL185.3
cke0_40_ma: C192.1, L96.2, U69.2
cke0_40_mb: C194.1, L97.2, U70.2
cke0_40_pkg: TL185.1, U68.2
cke0_40_t: TL198.3, TL199.1, TL200.1
cs0_n_40_1: C173.1, L87.1, TL175.3
cs0_n_40_2: C174.1, L87.2, TL176.1
cs0_n_40_3: C175.1, L88.1, TL178.3
cs0_n_40_4: TL176.3, TL177.1
cs0_n_40_5: TL177.3, TL178.1
cs0_n_40_6: C176.1, L88.2, TL179.1
cs0_n_40_7: C177.1, L89.1, TL181.3
cs0_n_40_8: TL179.3, TL180.1
cs0_n_40_9: TL180.3, TL181.1
cs0_n_40_10: C178.1, L89.2, TL182.1
cs0_n_40_11: C179.1, L90.1, TL184.3
cs0_n_40_12: TL182.3, TL183.1
cs0_n_40_13: TL183.3, TL184.1
cs0_n_40_fb: TL174.3, TL175.1
cs0_n_40_ma: C180.1, L90.2, U67.2
cs0_n_40_pkg: TL174.1, U66.2
cs2_n_40_1: C169.1, L85.1, TL167.3
cs2_n_40_2: C170.1, L85.2, TL168.1
cs2_n_40_3: C171.1, L86.1, TL170.3
cs2_n_40_4: TL168.3, TL169.1
cs2_n_40_5: TL169.3, TL170.1
cs2_n_40_6: C172.1, L86.2, TL171.1
cs2_n_40_7: TL171.3, TL172.1
cs2_n_40_8: TL172.3, TL173.1
cs2_n_40_fb: TL166.3, TL167.1
cs2_n_40_ma: TL173.3, U65.2
cs2_n_40_pkg: TL166.1, U64.2
r_dm3_1: C93.1, L47.1, TL96.3
r_dm3_2: TL94.3, TL95.1
r_dm3_3: TL95.3, TL96.1
r_dm3_4: C94.1, L47.2, TL97.1
r_dm3_5: C95.1, L48.1, TL97.3
r_dm3_fb: TL94.1, TL98.3
r_dm3_mb: C96.1, L48.2, U31.2
r_dm3_pkg: TL98.1, U32.2
r_dq1_1: C25.1, L13.1, TL31.3
r_dq1_2: TL29.3, TL30.1
r_dq1_3: TL30.3, TL31.1
r_dq1_4: C26.1, L13.2, TL32.1
r_dq1_5: C27.1, L14.1, TL32.3
r_dq1_6: C28.1, L14.2, TL33.1
r_dq1_fb: TL29.1, TL34.3
r_dq1_mb: TL33.3, U11.2
r_dq1_pkg: TL34.1, U12.2
r_dq4_1: C5.1, L3.1, TL6.3
r_dq4_2: C6.1, L3.2, TL7.1
r_dq4_3: C7.1, L4.1, TL9.3
r_dq4_4: TL7.3, TL8.1
r_dq4_5: TL8.3, TL9.1
r_dq4_fb: TL6.1, TL10.3
r_dq4_mb: C8.1, L4.2, U3.2
r_dq4_pkg: TL10.1, U4.2
r_dq6_1: C15.1, L8.1, TL19.3
r_dq6_2: TL17.3, TL18.1
r_dq6_3: TL18.3, TL19.1
r_dq6_4: C16.1, L8.2, TL20.1
r_dq6_5: C17.1, L9.1, TL20.3
r_dq6_6: C18.1, L9.2, TL21.1
r_dq6_7: C19.1, L10.1, TL21.3
r_dq6_fb: TL17.1, TL22.3
r_dq6_mb: C20.1, L10.2, U7.2
r_dq6_pkg: TL22.1, U8.2
r_dq10_1: C58.1, L29.2, TL62.1
r_dq10_2: C59.1, L30.1, TL64.3
r_dq10_3: TL62.3, TL63.1
r_dq10_4: TL63.3, TL64.1
r_dq10_5: C60.1, L30.2, TL65.1
r_dq10_fb: C57.1, L29.1, TL66.3
r_dq10_mb: TL65.3, U19.2
r_dq10_pkg: TL66.1, U20.2
r_dq11_1: C42.1, L21.2, TL46.1
r_dq11_2: C43.1, L22.1, TL48.3
r_dq11_3: TL46.3, TL47.1
r_dq11_4: TL47.3, TL48.1
r_dq11_5: C44.1, L22.2, TL49.1
r_dq11_6: C45.1, L23.1, TL49.3
r_dq11_7: C46.1, L23.2, TL50.1
r_dq11_8: C47.1, L24.1, TL50.3
r_dq11_9: C48.1, L24.2, TL51.1
r_dq11_10: C49.1, L25.1, TL51.3
r_dq11_11: C50.1, L25.2, TL52.1
r_dq11_12: C51.1, L26.1, TL52.3
r_dq11_13: C52.1, L26.2, TL53.1
r_dq11_14: TL53.3, TL54.1
r_dq11_15: TL54.3, TL55.1
r_dq11_fb: C41.1, L21.1, TL56.3
r_dq11_mb: TL55.3, U15.2
r_dq11_pkg: TL56.1, U16.2
r_dq23_1: C68.1, L34.2, TL73.1
r_dq23_2: C69.1, L35.1, TL73.3
r_dq23_3: C70.1, L35.2, TL74.1
r_dq23_4: C71.1, L36.1, TL74.3
r_dq23_5: C72.1, L36.2, TL75.1
r_dq23_6: TL75.3, TL76.1
r_dq23_7: TL76.3, TL77.1
r_dq23_fb: C67.1, L34.1, TL78.3
r_dq23_mb: TL77.3, U23.2
r_dq23_pkg: TL78.1, U24.2
r_dq27_1: C82.1, L41.2, TL84.1
r_dq27_2: C83.1, L42.1, TL84.3
r_dq27_3: C84.1, L42.2, TL85.1
r_dq27_4: C85.1, L43.1, TL85.3
r_dq27_5: C86.1, L43.2, TL86.1
r_dq27_6: C87.1, L44.1, TL86.3
r_dq27_7: C88.1, L44.2, TL87.1
r_dq27_fb: C81.1, L41.1, TL88.3
r_dq27_mb: TL87.3, U27.2
r_dq27_pkg: TL88.1, U28.2
r_dqs0n_1: C110.1, L55.2, TL110.1
r_dqs0n_2: C111.1, L56.1, TL112.3
r_dqs0n_3: TL110.3, TL111.1
r_dqs0n_4: TL111.3, TL112.1
r_dqs0n_fb: C109.1, L55.1, TL114.3
r_dqs0n_mb: C112.1, L56.2, U38.2
r_dqs0n_pkg: TL114.1, U40.2
r_dqs0p_1: C106.1, L53.2, TL107.1
r_dqs0p_2: C107.1, L54.1, TL109.3
r_dqs0p_3: TL107.3, TL108.1
r_dqs0p_4: TL108.3, TL109.1
r_dqs0p_fb: C105.1, L53.1, TL113.3
r_dqs0p_mb: C108.1, L54.2, U37.2
r_dqs0p_pkg: TL113.1, U39.2
r_dqs3n_1: C126.1, L63.2, TL120.1
r_dqs3n_2: C127.1, L64.1, TL120.3
r_dqs3n_fb: C125.1, L63.1, TL122.3
r_dqs3n_mb: C128.1, L64.2, U46.2
r_dqs3n_pkg: TL122.1, U48.2
r_dqs3p_1: C122.1, L61.2, TL119.1
r_dqs3p_2: C123.1, L62.1, TL119.3
r_dqs3p_fb: C121.1, L61.1, TL121.3
r_dqs3p_mb: C124.1, L62.2, U45.2
r_dqs3p_pkg: TL121.1, U47.2
w_dm3_1: C89.1, L45.1, TL92.3
w_dm3_2: TL90.3, TL91.1
w_dm3_3: TL91.3, TL92.1
w_dm3_4: C90.1, L45.2, TL93.1
w_dm3_5: C91.1, L46.1, TL93.3
w_dm3_fb: TL89.3, TL90.1
w_dm3_mb: C92.1, L46.2, U30.2
w_dm3_pkg: TL89.1, U29.2
w_dq1_1: C21.1, L11.1, TL26.3
w_dq1_2: TL24.3, TL25.1
w_dq1_3: TL25.3, TL26.1
w_dq1_4: C22.1, L11.2, TL27.1
w_dq1_5: C23.1, L12.1, TL27.3
w_dq1_6: C24.1, L12.2, TL28.1
w_dq1_fb: TL23.3, TL24.1
w_dq1_mb: TL28.3, U10.2
w_dq1_pkg: TL23.1, U9.2
w_dq4_1: C1.1, L1.1, TL2.3
w_dq4_2: C2.1, L1.2, TL3.1
w_dq4_3: C3.1, L2.1, TL5.3
w_dq4_4: TL3.3, TL4.1
w_dq4_5: TL4.3, TL5.1
w_dq4_fb: TL1.3, TL2.1
w_dq4_mb: C4.1, L2.2, U2.2
w_dq4_pkg: TL1.1, U1.2
w_dq6_1: C9.1, L5.1, TL14.3
w_dq6_2: TL12.3, TL13.1
w_dq6_3: TL13.3, TL14.1
w_dq6_4: C10.1, L5.2, TL15.1
w_dq6_5: C11.1, L6.1, TL15.3
w_dq6_6: C12.1, L6.2, TL16.1
w_dq6_7: C13.1, L7.1, TL16.3
w_dq6_fb: TL11.3, TL12.1
w_dq6_mb: C14.1, L7.2, U6.2
w_dq6_pkg: TL11.1, U5.2
w_dq10_1: C54.1, L27.2, TL58.1
w_dq10_2: C55.1, L28.1, TL60.3
w_dq10_3: TL58.3, TL59.1
w_dq10_4: TL59.3, TL60.1
w_dq10_5: C56.1, L28.2, TL61.1
w_dq10_fb: C53.1, L27.1, TL57.3
w_dq10_mb: TL61.3, U18.2
w_dq10_pkg: TL57.1, U17.2
w_dq11_1: C30.1, L15.2, TL36.1
w_dq11_2: C31.1, L16.1, TL38.3
w_dq11_3: TL36.3, TL37.1
w_dq11_4: TL37.3, TL38.1
w_dq11_5: C32.1, L16.2, TL39.1
w_dq11_6: C33.1, L17.1, TL39.3
w_dq11_7: C34.1, L17.2, TL40.1
w_dq11_8: C35.1, L18.1, TL40.3
w_dq11_9: C36.1, L18.2, TL41.1
w_dq11_10: C37.1, L19.1, TL41.3
w_dq11_11: C38.1, L19.2, TL42.1
w_dq11_12: C39.1, L20.1, TL42.3
w_dq11_13: C40.1, L20.2, TL43.1
w_dq11_14: TL43.3, TL44.1
w_dq11_15: TL44.3, TL45.1
w_dq11_fb: C29.1, L15.1, TL35.3
w_dq11_mb: TL45.3, U14.2
w_dq11_pkg: TL35.1, U13.2
w_dq23_1: C62.1, L31.2, TL68.1
w_dq23_2: C63.1, L32.1, TL68.3
w_dq23_3: C64.1, L32.2, TL69.1
w_dq23_4: C65.1, L33.1, TL69.3
w_dq23_5: C66.1, L33.2, TL70.1
w_dq23_6: TL70.3, TL71.1
w_dq23_7: TL71.3, TL72.1
w_dq23_fb: C61.1, L31.1, TL67.3
w_dq23_mb: TL72.3, U22.2
w_dq23_pkg: TL67.1, U21.2
w_dq27_1: C74.1, L37.2, TL80.1
w_dq27_2: C75.1, L38.1, TL80.3
w_dq27_3: C76.1, L38.2, TL81.1
w_dq27_4: C77.1, L39.1, TL81.3
w_dq27_5: C78.1, L39.2, TL82.1
w_dq27_6: C79.1, L40.1, TL82.3
w_dq27_7: C80.1, L40.2, TL83.1
w_dq27_fb: C73.1, L37.1, TL79.3
w_dq27_mb: TL83.3, U26.2
w_dq27_pkg: TL79.1, U25.2
w_dqs0n_1: C102.1, L51.2, TL104.1
w_dqs0n_2: C103.1, L52.1, TL106.3
w_dqs0n_3: TL104.3, TL105.1
w_dqs0n_4: TL105.3, TL106.1
w_dqs0n_fb: C101.1, L51.1, TL103.3
w_dqs0n_mb: C104.1, L52.2, U36.2
w_dqs0n_pkg: TL103.1, U34.2
w_dqs0p_1: C98.1, L49.2, TL100.1
w_dqs0p_2: C99.1, L50.1, TL102.3
w_dqs0p_3: TL100.3, TL101.1
w_dqs0p_4: TL101.3, TL102.1
w_dqs0p_fb: C97.1, L49.1, TL99.3
w_dqs0p_mb: C100.1, L50.2, U35.2
w_dqs0p_pkg: TL99.1, U33.2
w_dqs3n_1: C118.1, L59.2, TL118.1
w_dqs3n_2: C119.1, L60.1, TL118.3
w_dqs3n_fb: C117.1, L59.1, TL117.3
w_dqs3n_mb: C120.1, L60.2, U44.2
w_dqs3n_pkg: TL117.1, U42.2
w_dqs3p_1: C114.1, L57.2, TL116.1
w_dqs3p_2: C115.1, L58.1, TL116.3
w_dqs3p_fb: C113.1, L57.1, TL115.3
w_dqs3p_mb: C116.1, L58.2, U43.2
w_dqs3p_pkg: TL115.1, U41.2

Notes on the sheet:
LPDDR4 SI, generated by gen_sch.py: 2800 MT/s, inner 0.18 mm, outer 0.25 mm, pairs inner 0.14/0.15, outer 0.2/0.2, corner typ, package netlen. DRAM = Winbond W66CL2NQUAFJ stand-in.
w_dq4: ddr_dq4 write, FPGA 40 ohm -> DRAM ODT 60
r_dq4: ddr_dq4 read, DRAM PDDS 40 -> FPGA ODT 60
w_dq6: ddr_dq6 write, FPGA 40 ohm -> DRAM ODT 60
r_dq6: ddr_dq6 read, DRAM PDDS 40 -> FPGA ODT 60
w_dq1: ddr_dq1 write, FPGA 40 ohm -> DRAM ODT 60
r_dq1: ddr_dq1 read, DRAM PDDS 40 -> FPGA ODT 60
w_dq11: ddr_dq11 write, FPGA 40 ohm -> DRAM ODT 60
r_dq11: ddr_dq11 read, DRAM PDDS 40 -> FPGA ODT 60
w_dq10: ddr_dq10 write, FPGA 40 ohm -> DRAM ODT 60
r_dq10: ddr_dq10 read, DRAM PDDS 40 -> FPGA ODT 60
w_dq23: ddr_dq23 write, FPGA 40 ohm -> DRAM ODT 60
r_dq23: ddr_dq23 read, DRAM PDDS 40 -> FPGA ODT 60
w_dq27: ddr_dq27 write, FPGA 40 ohm -> DRAM ODT 60
r_dq27: ddr_dq27 read, DRAM PDDS 40 -> FPGA ODT 60
w_dm3: ddr_dm3 write, FPGA 40 ohm -> DRAM ODT 60
r_dm3: ddr_dm3 read, DRAM PDDS 40 -> FPGA ODT 60
w_dqs0: ddr_dqs0 write (pair), FPGA 40 ohm diff -> DRAM ODT 60
r_dqs0: ddr_dqs0 read (pair), DRAM PDDS 40 -> FPGA ODT 60 diff
w_dqs3: ddr_dqs3 write (pair), FPGA 40 ohm diff -> DRAM ODT 60
r_dqs3: ddr_dqs3 read (pair), DRAM PDDS 40 -> FPGA ODT 60 diff
ck_40: CK pair, T to both channels, FPGA 40 ohm diff, DRAM CK ODT 40
ca1_40: ddr_ca1, FPGA 40 ohm, T to both channels, DRAM CA_ODT_40
ca2_40: ddr_ca2, FPGA 40 ohm, T to both channels, DRAM CA_ODT_40
ca4_40: ddr_ca4, FPGA 40 ohm, T to both channels, DRAM CA_ODT_40
cs2_n_40: ddr_cs2_n, FPGA 40 ohm, point to point, DRAM CS_ODT_40
cs0_n_40: ddr_cs0_n, FPGA 40 ohm, point to point, DRAM CS_ODT_40
cke0_40: ddr_cke0, FPGA 40 ohm, T to both channels, DRAM CKE_INPUT
.tran 1p 102.0n .options method=gear maxord=2 reltol=1e-4
