johonkanen/efinix_soc_board/(commit log)

2026-10-24 Ti135 control card: plan, device notes, pin plan and schematic (11/14 sheets)
    - MIGRATION_PLAN.md, TI135_PCB_NOTES.md, MECHANICAL.md, POWER_BUDGET.md, STATUS.md (handoff)
    - Efinity Interface Designer pin plan (efinity/pinplan), design check passes
    - Scripted KiCad 10 project: generated symbol library incl. 9-unit Ti135N484I3,
    sheets 01-08, 11, 12, 14; ethernet, emmc and adc still to draw
    - proteus2kicad as submodule in tools/p2k
    [01_pwr_input.kicad_sch, 02_pwr_vcore.kicad_sch, 03_pwr_rails.kicad_sch, 04_pwr_seq.kicad_sch, 05_fpga_power.kicad_sch, 06_fpga_config.kicad_sch, 07_clocks.kicad_sch, 08_lpddr4.kicad_sch]
2026-10-25 Schematic complete: ethernet, emmc and adc sheets
    - 09 ethernet: KSZ9031RNX with the Agilex 5 values and straps, RGMII 22R series,
    ferrite-fed analog rails, magjack J9, jack LED via 74LVC1G06
    - 10 emmc: KIOXIA THGAMVG7T13BAIL, 47k pulls, CLK 10R, VCC 3V3 / VCCQ 1V8
    - 13 adc: Agilex 3 card front end (SN74LV4051A, OPA365, 33R + 680p C0G,
    ADS7056 with DVDD 1V8), rail monitors on the mux
    - attach/series_r/pull_r sheet helpers; STATUS.md updated
    ERC: only the two known notes; all 92 pin-plan signals reach their loads.
    [09_ethernet.kicad_sch, 10_emmc.kicad_sch, 13_adc.kicad_sch, ti135_card.kicad_sch]
2026-10-25 PCB setup: board outline, fixed connectors, stack-up and rules; HR911130A magjack
    - J9 magjack changed to HanRun HR911130A (C54408, 9124 orderable; RB1 had 0):
    generated footprint from the HanRun drawing, symbol, ethernet sheet updated,
    placed with the Ti60 jack's front face and centreline (MECHANICAL.md)
    - tools/make_board.py: board from the netlist, outline, aux origin = Ti60
    origin, J3/J6 bottom sockets and J9 checked against MECHANICAL.md pads,
    U501 rotated 180 deg, U801 north, rest staged by sheet
    - tools/board_setup.py: Agilex JLC08161H-3313 stack-up, LPDDR4/RGMII/power
    net classes, DRC rules (U501/U801), J3 edge exception
    - DRC: parity 0, no shorts; only unrouted nets and ed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
    [09_ethernet.kicad_sch, ti135_card.kicad_pcb]
2026-10-25 Placement with KiCadRoutingTools; Ethernet PHY changed to RTL8211FDI-CG
    - Sheet 09 redone for the RTL8211FDI-CG (C692886; the KSZ9031 had 16 orderable, and the
    Agilex 5 card makes the same change). It runs from 3V3 only, with an internal 1.0 V core LDO
    and RGMII pads at 1.8 V from its pad LDO; all nine straps are fitted. PHYRSTB is a 3.3 V
    input, so it is driven through a 74LVC1G07 open drain. The jack LED is driven straight
    from LED2.
    - The 1V2 buck (U321) is removed. Power budget and docs updated.
    - make_board sets pad pin functions/types, so the placer reads the Y701 oscillator correctly.
    - Placement: placement/ holds the inputs (groups, prep, intent fixes, judging chain). Seed 1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
    [03_pwr_rails.kicad_sch, 04_pwr_seq.kicad_sch, 09_ethernet.kicad_sch, ti135_card.kicad_pcb]
2026-10-25 Placement with power on the underside; LPDDR4 swizzle, 40/80 ohm rules, layer and plane plan
    - LPDDR4 DQ swizzle within each byte (crossings 125 -> 45). efinity/pinplan/lpddr4_swizzle.json
    is the one source for the schematic (sheet 08) and the Interface Designer PIN_SWIZZLE_DQM*
    (read back and checked). Write-up in LPDDR4_SWIZZLE.md; scorer in tools/lpddr4_swizzle_score.py.
    - Stack-up: a field solve (tools/zsolve.py) of JLC08161H-3313. Layer roles are now In1/In6 GND and
    In3/In4 planes, with signals on F/In2/In5/B. LPDDR4 widths follow the Efinix 40 ohm / 80 ohm
    guide (0.18 mm and 0.14/0.15 mm on In2/In5). Plane plan in TI135_PCB_NOTES.md section 6.6
    (KiCadRoutingTools recommend-st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
    [08_lpddr4.kicad_sch, ti135_card.kicad_pcb]
2026-10-25 Hand touch-ups: RGMII resistors, PHY crystal, DDR_CAL/ZQ placed by proximity claims; labels tidied
    The 60 parts around the PHY, the RGMII resistors and R801/R802 were re-placed with everything
    else locked and proximity claims to their pads (work/touch, place_simple --claim-weight 20):
    RX resistors within 1.5 mm of the PHY, Y901 2 mm from XTAL_IN, R801/R802 about 3 mm from
    DDR_CAL/ZQ. Reference labels tidied with beautify_labels (175 at 1.0 mm); 92 that have no
    legal spot are hidden. apply_placement.py gains --keep-locks.
    [ti135_card.kicad_pcb]
2026-10-25 Planes and via-in-pad BGA fan-out
    - Plane regions are drawn by script (tools/plane_regions.py -> placement/planes.json ->
    tools/apply_planes.py): In1/In6 GND; In3 1V1 north + VCORE corridor + GND; In4 1V8 with a
    0V85 island; B.Cu 5V0 region around J6 and the regulator inputs. Inside U501 each ball-grid
    cell goes to the nearest supply ball. 3V3 is routed rather than poured. route_planes' Voronoi
    split had cut VCORE off from its regulator.
    - Via-in-pad on every connected ball (tools/via_in_pad.py): U501 392 x 0.30/0.15 mm,
    U801 178 x 0.25/0.15 mm. All 334 plane balls lie inside their plane's fill.
    - Under-BGA decaps moved off the vias (place_fanout_clearance, 69 caps, no via nudges);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
    [ti135_card.kicad_pcb]
2026-10-25 Regulator cells: fix the bottom-side template mirror, draw the cell copper
    - On B.Cu the template fit had mirrored every cell relative to its pins: CIN at the GND pin,
    COUT on the VIN side. placement/sketches_B holds mirrored sketches (prep.sh now uses them).
    The 37 power parts were re-placed with everything else locked, and each cell was verified
    against TI Figure 24 in the regulator's own frame.
    - tools/buck_copper.py draws one cell layout through each cell's pad frame: SW, VIN, the GND
    strip with vias to In6, VOUT with vias to the rail plane, and FB. Every via is placed at the
    nearest site that clears foreign copper on all layers.
    - DRC clean, apart from routing and silk; all ce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
    [ti135_card.kicad_pcb]
2026-10-25 Docs and prep for the regulator cells: sketches_B in prep.sh, notes 6.8, plan step 12
    [ti135_card.kicad_pcb]
2026-10-25 U501 pad-to-die delays from the Efinix N484 package net-length table
    - tools/pad_to_die.py (run by tools/build_pcb.sh) sets KiCad pad-to-die length and delay
    on the 233 U501 balls listed in Efinix's Ti135_netlength-v0.5 (N484 sheet), so LPDDR4 length
    and time tuning measures die to die. Package delay spread is 20-37 ps per byte and 54 ps on
    CA/CK.
    - Vendor files (netlength xlsx/csv, BSDL v1.0, package STEP v1.1) are kept in reference/efinix/
    and gitignored (Efinix copyright); the README there says where to get them.
    [ti135_card.kicad_pcb]
2026-10-25 LPDDR4 first routing draft (work in progress) and session handoff
    - All 56 LPDDR4 nets connected by route.py on F/In2/In5/B (0.1 mm, free layer choice): 91 vias,
    1215 mm. Not clean: hole clearance (195), DDR-to-DDR clearance (76), widths not yet widened
    to 40 ohm (88) and DQS/CK pair rules (33). Every DRC error is in the DDR copper. Bytes span
    3-4 layers and lengths are not matched yet.
    - Tag pre-ddr-routing marks the last clean commit before this draft.
    - tools/ddr/: net lists, per-byte route stats, a layer renderer and the U801 pose study (the
    current -90 deg pose beat 180 deg in a routing trial: 56/56, 1215 mm against 55/56, 1463 mm).
    - STATUS.md: handoff with what was tried, the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
    [ti135_card.kicad_pcb]
2026-10-25 NEXT_SESSION.md: plan for the next session, including a learning run on KiCadRoutingTools' own LPDDR4 example
2026-10-26 NEXT_SESSION: bus router finished (42 lanes connected, 5 open, 72 vias, 1095 mm)
2026-10-26 KiCadRoutingTools learning run: haasoscope LPDDR4 chain reproduced, recipe run on our board
    KRT_LEARNING.md records the intended FPGA-LPDDR4 chain (bga_fanout pairs first on both BGAs,
    route_diff with time matching, route.py with auto byte-lane groups) and its results. On our board
    (tools/ddr/recipe_chain.sh): 56/56 connected, 3 coupled pairs, 0 copper-clearance errors once the
    planes are refilled (stale fill had produced 379 false errors), 103 near-miss hole clearances (route
    at 0.11 mm). NEXT_SESSION.md updated.
2026-10-26 DDR candidates graded alike (tools/ddr/grade.sh); recipe at 0.11 mm with matching pair-stub gap
2026-10-26 LPDDR4: candidate C (haasoscope recipe) on main; die-to-die timing check
    - kicad/ti135_card.kicad_pcb now carries the recipe routing at 0.11 mm: 56/56 connected, 0
    copper-clearance errors, 23 hole clearance, DQS0/DQS3/CK coupled.
    - tools/ddr/ddr_timing.py measures each DDR net die to die: the path from the U501 ball to each
    U801 ball, delay per layer from the field solve, vias, and U501 pad-to-die. It checks the
    result against Efinix §6.3.
    - On C the timing fails: CA-CK -57..+123 ps, the CA group spans 180 ps, DQS P/N skew up to
    39 ps, and some DQ are shorter than their DQS. The router's matching does not handle branched
    CA/CK nets, pairs that fell back to single nets, or DQS rout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
    [ti135_card.kicad_pcb]
2026-10-26 LPDDR4 CK/CA trunk-and-branch topology on main
    - tools/ddr/ca_trunk_branch.py and ca_tb_chain.sh: each shared CA/CKE/CK net becomes a trunk from
    U501 to a T via in U801's ball-free centre columns, plus two mirror-image branches in the
    channels between ball rows. The trunks are routed by KiCadRoutingTools as a point-to-point,
    time-matched group. DQ/DQS nets in the gap or in branch corridors are moved and re-routed.
    - Result: all DDR nets connected, no shorts or crossings, the two channels of every net equal.
    CA/CKE/CS-CK is -8.6..+36.8 ps (before: -57..+123 ps with 85 ps between channels) and CK P/N
    skew is 9 ps. Within Efinix's 100 ps budget, not yet the 30 mil length rule.
    - KRT_L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
    [ti135_card.kicad_pcb]
2026-10-26 NEXT_SESSION.md: plan for KiCad time-domain tuning, data-byte re-route, CK/CA final tuning, DDR DRC clean-up
2026-10-26 Fix pad-to-die delay units: KiCad stores die_delay in ps (IU_PER_PS = 1e6)
    tools/pad_to_die.py had stored the U501 package delays 1000x too small (it assumed fs per
    internal unit), so KiCad's own tuner and DRC saw them as about 0. The "KiCadRoutingTools reads ns
    as ps" finding was wrong: the router reads ps correctly, and the x1000 workaround in
    ca_trunk_branch.py was correcting this error. Fixed pad_to_die.py, ddr_timing.py and
    ca_trunk_branch.py; the board now stores e.g. (die_delay 94.8966). The CK/CA timing is unchanged.
    KRT_LEARNING.md and NEXT_SESSION.md corrected.
    [ti135_card.kicad_pcb]
2026-10-26 KiCad time-domain tuning for the LPDDR4: profiles, KiCad delay probe, per-net targets
    - tools/board_setup.py: tuning profiles LPDDR4 SE 40R / DIFF 80R (per-layer delays from the
    field solve, via 7.2 ps/mm) assigned to lpddr_dq/lpddr_ca/lpddr_diff. pcbnew's tuners and the
    length/skew DRC now work in ps, die to die.
    - tools/ddr/kicad_delays.sh: KiCad's own delay for every LPDDR4 net, via a probe ps length rule
    on a copy.
    - tools/ddr/ddr_timing.py --kicad: per-net tuner targets in KiCad's terms (a shared CA/CK net's
    second branch removed with the exact branch geometry). The KiCad readout is the reference.
    - TI135_PCB_NOTES.md section 6.9 and NEXT_SESSION.md updated.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
2026-10-26 LPDDR4 data bytes re-routed (tools/ddr/byte_chain.sh); tuner targets for the rest
    - tools/ddr/byte_chain.sh: rip DQ/DM/DQS, bga_fanout pairs first on both BGAs (pair-stub gap =
    clearance), route_diff DQS, then route.py DQ/DM in one time-matched group per byte including
    its DQS. tools/ddr/rip_nets.py is the generic rip.
    - On main: the inside-out ordering variant. All connected, nothing outside the DDR affected.
    KiCad-readout DQS P/N skew is 9.1/1.3/1.5/0.2 ps; DQ-DQS (path model) -12.7..81 / -1.8..68 /
    -20.9..79 / -0.9..47.5 ps. Hole clearance 8, pair gap 8.
    - Bus corridors, DQS as singles in the groups, and a horizontal DQS escape were tried and were
    no better. The limit is room fo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
    [ti135_card.kicad_pcb]
2026-10-26 LPDDR4 re-routed at 40 ohm and width-fitted (phase 4, part 1)
    - Widening the 0.1 mm routes in place failed: buses on a 0.21 mm pitch left 77 % of the length
    below the rule minimum. The LPDDR4 is now routed at the impedance width instead
    (tools/ddr/ddr40_chain.sh): byte_chain.sh and ca_tb_chain.sh take WOPT (--impedance 40),
    DQS at 0.14 mm.
    - tools/ddr/widen.py fits every DDR segment to the JLC rules. It splits segments at the BGA
    courtyard edge, clamps KRT's 0.272 mm F/B width (no solder mask in its model) to 0.25, and
    widens what clearance allows. Narrow copper outside the BGAs: 1444 -> 70 mm.
    - lpddr_bga_neckdown gets an explicit diff_pair_gap max. KiCad was carrying over 0.22 mm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
    [ti135_card.kicad_pcb]
2026-10-26 LPDDR4 narrow nets and hole hits cleared (phase 4, part 2)
    - tools/ddr/widen.py models the clearances exactly: 0.1 mm copper (every net class), 0.175 mm to
    via holes, 0.28 mm to PTH holes, round pads as circles. It fits in three steps: every segment
    to the minimum, a sideways nudge (polyline offset between anchors) for runs still narrow, then
    the target. --why names each narrow segment's blocker.
    - Clearance repair: any DDR segment that does not clear is nudged, inside the BGAs too. A DQS stub
    in U801's 0.8 mm channel goes to the 0.09 mm neck-down minimum first (at 0.1 mm the pair and
    both hole clearances fill the channel exactly). KRT's 0.0898 mm necks are raised to 0.09.
    Re-fit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
    [ti135_card.kicad_pcb]
2026-10-26 LPDDR4 width clean: R801 moved 10 um, cs2_n centred at 0.23 mm
    widen.py nudges in 0.5 um steps up to 20 um (then 5 um), keeps 0.2 um over each clearance, and
    evaluates a moved segment at its minimum width (the target pass re-widens). R801 (DDR_CAL, not yet
    routed) moved -10 um in x, giving the 0.431 mm opening cs2_n needs. DDR DRC: 0 width, 0 hole,
    0 edge; 4 pair skew and 3 uncoupled remain for phase 3.
    [ti135_card.kicad_pcb]
2026-10-26 Phase 3 tooling: delay plan, meander tuner on routed copper; tuning blocked on room
    - ddr_timing.py --nets (per-net DQ/DM vs DQS) and --plan FILE (ps each net must gain: CA/CK to
    the group's longest; per byte DQS to max(P, N, longest DQ - 58), DQ/DM to >= DQS + 8).
    - tools/ddr/tune_meander.py (KRT venv): KiCadRoutingTools' trombone generator on each net's
    same-layer chains outside the BGAs, clearance-checked per bump; tools/ddr/tune_apply.py
    (pcbnew) applies the edits by segment UUID.
    - reroute_nets.sh MATCH=1 (one time-matched group); byte_chain.sh RCL (routing clearance).
    - Finding: the plan needs 1453 ps (~220 mm) of meander; the tuner places 230-540 ps because the
    bundles are pac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
2026-10-26 KRT bug notes; net-by-net byte routing with meander-as-you-go (phase 3, option 2 in progress)
    - KRT_LEARNING.md: possible KiCadRoutingTools bugs (route_diff crash on an empty pair set; meander
    bumps refused next to a close but legal neighbour; default rip of pre-existing nets leaving
    opens) and library gotchas. Not reported upstream.
    - tools/ddr/byte_seq.sh: per byte DQS pair, then each DQ/DM routed alone and meandered to DQS +
    30 ps before the next (MODE=net), farthest ball pair first (NET_ORDER=far).
    - tune_meander.py: real courtyards (widen.py --split-only), amplitude ladder, KRT asked at a small
    clearance too with every new segment verified against the board's rules.
    - tools/ddr/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
2026-10-26 Analog section placed as on the Agilex card; J3 pull-down arrays on B.Cu beside J3
    tools/place_analog.py: the SN74LV4051A mux, OPA365 buffer, 33 R + 680 p kickback filter, ADS7056
    and NCP163 LDO take the Agilex card's positions relative to its J3 (read from
    ~/dev/agilex3_soc_control_card, not modified), shifted +1.0 mm in x to clear J1. Parts the Agilex
    card lacks (rail monitors, SPI series resistors east of the ADC, extra caps) go to the nearest free
    spot by the pin they serve; a relax pass clears courtyard touches. RN1401-RN1408 moved to B.Cu in a
    column beside J3, each level with the J3 pins it pulls down, signal pads towards J3.
    KiCad DRC: no new errors (courtyard, clearance, parity); mo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
    [ti135_card.kicad_pcb]
2026-10-26 Silkscreen DRC checks off: no reference silkscreen on this card
    board_setup.py sets silk_overlap, silk_over_copper and silk_edge_clearance to ignore (only a few
    custom markings will be on the card). Re-running it also picked up the Agilex card's DRU fix for
    the neck-down pair gap (max 5 mm instead of our 10 mm; same effect). The board file diff is zone-fill
    line wrapping only.
    [ti135_card.kicad_pcb]
2026-10-27 Level shifters placed by hand beside J3; analog block moved down
    U1201-U1204 in a column beside J3 (x ~142.7), decaps C1201/C1203/C1204/C1206 on B.Cu under them;
    the analog section and LDO moved down ~5.6 mm (hand placement). R1301 moved with the analog block
    to clear U1204. place_analog.py now needs --force, since a re-run would undo the hand placement.
    KiCad DRC: no courtyard, clearance or parity errors.
    [ti135_card.kicad_pcb]
2026-10-27 Hand placement (2026-10-27 morning), zones refilled
    Analog block, C503/C504, C551/C552, D601/D602, FB502/FB503, R1201 (now B.Cu) and others moved by
    hand in KiCad. Zones refilled (the new vias were inside stale fills: 7 hole clearance hits). KiCad
    DRC after refill: no new errors.
    [ti135_card.kicad_pcb]
2026-10-27 U501 100n decaps to 0201, placed straight on rail/GND via pairs
    - 05_fpga_power: the 37 x 100n are C_0201_0603Metric (e.g. GRM033R60J104KE19D / LCSC C76928,
    JLC extended, ample stock). On U501's 0.8 mm via-in-pad grid neither 0201 nor 0402 fits between
    the vias, but an 0201 sits with its pads on an adjacent rail/GND via pair: the shortest loop.
    - tools/swap_footprint.py: footprint swap on the board keeping nets, fields, schematic link.
    - tools/place_bga_decaps.py: each cap onto a pair of its own rail (pad 1 on the rail via), spread
    over the rail's pairs; clearance checked against vias (copper and hole), B.Cu tracks, pads and
    courtyards. VCORE 9/9, 0V85 5/5, 1V1 8/8, 1V8 5/7 on pairs;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
    [05_fpga_power.kicad_sch, ti135_card.kicad_pcb]
2026-10-27 reference/efinix: note the hardware checklist, DDR guide and imported Efinix dev-board layouts (files not in git)
2026-10-27 HW_CHECKLIST_REVIEW.md: Efinix Ti135 N484 hardware checklist against the card
    To act on: DDR_CAL resistor 0.1 % (R801 is 1 %), SSU_N weak pull-up, decoupling per the checklist
    table (no 10 nF / 1 nF parts, fewer bulk caps), 47 uF at each regulator output, DDR layer rules.
    The checklist's DDR skew limits (DQ-DQS <= 75 ps, CA-CK <= 100 ps) are met by ddr-option2.
    Everything else (power pins, VQPS, groups, configuration pins, JTAG, REF_RES, PLL refclk, HVIO
    limits) matches.
2026-10-27 tools/render_ddr.py: LPDDR4 routing per layer, coloured by byte lane (for comparing with Efinix dev boards)
2026-10-27 Phase 1: LPDDR4 from ddr-option2 transplanted onto main
    tools/ddr/transplant.py swaps the ddr_* copper; C528 moved 0.3 mm off a dq2 via.
    DQ-DQS -23.9..+60.4 ps, CK-DQS <= 86 ps, CA-CK -57.1..+47.0 ps (die to die); parity 0,
    non-DDR DRC unchanged; 88 mm below the DDR width minimum (phase 2).
    [ti135_card.kicad_pcb]
2026-10-27 Phase 2: LPDDR4 at the 40 ohm width everywhere, timing within the checklist
    Re-routed the ten narrow DDR nets at width (reroute_nets.sh, --escalation off),
    meandered dm0/dq1, re-routed DQS0 as a pair. 0 mm below the width minimum, no
    track_width errors; DQ/DM-DQS, CK-DQS and CA-CK within decision 1 by both the path
    model and KiCad's readout. DQS P/N 0.53/6.64/0.07/5.61 ps, CK 3.67 ps. Bytes 0 and 3
    less on one layer (B.Cu has no room at 0.25 mm). Rest of the board unchanged.
    [ti135_card.kicad_pcb]
2026-10-27 Phase 3 (half): checklist fixes in the schematic; board placement still to do
    - R801 240R 0.1 % (RT0402BRD07240RL, C852660); SSU_N (L4) 10 k pull-up R622 to 1V8.
    - Efinix decoupling table in full on sheet 05 (now A2): C5001-C5073 (0201 10n/1n/100n,
    0402 1u/4u7, 0805 10u/47u, 1206 100u).
    - Each TLV62585 cell: 47u output cap and a 22p feed-forward cap across R1 (data sheet:
    feed-forward needed above 47 uF; user decision).
    - build_schematic.sh fails on duplicate references (ERC misses them).
    - tools/add_parts.py: add missing schematic parts to a routed board; tools/place_free.py
    (untested): nearest free B.Cu spot.
    - kicad/ti135_card.kicad_pcb unchanged; placement in work/p3, see NEXT_SESS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
    [02_pwr_vcore.kicad_sch, 03_pwr_rails.kicad_sch, 05_fpga_power.kicad_sch, 06_fpga_config.kicad_sch, 08_lpddr4.kicad_sch, 11_fpga_io.kicad_sch, ti135_card.kicad_sch]
2026-10-27 Phase 3: the 84 new parts placed on the board; checklist items 1-4 done
    All on B.Cu: 14 0201s on rail/GND via pairs under U501 (place_bga_decaps.py),
    the rest at the nearest free spot to their rail's balls (place_free.py), the
    47u + 22p feed-forward in the regulator cells, R622 near L4. LPDDR4 copper
    untouched (grade.sh identical to phase 2), schematic parity 0, ERC unchanged.
    [ti135_card.kicad_pcb]
2026-10-28 Add kicad_ibis_simulation submodule (common KiCad + IBIS SI tools)
    tools/kicad_ibis_simulation: johonkanen/kicad_ibis_simulation at 783e057, the
    KiCad 10 + ngspice IBIS tool chain from the Agilex card. The LPDDR4 width study
    (sim/lpddr4_si, not committed yet) will be based on it.
2026-10-28 break out top row dq
    [08_lpddr4.kicad_sch, ti135_card.kicad_pcb]
2026-10-28 LPDDR4 hand routing: Agilex DRAM escape copied, byte lanes routed, DQ swizzle by hand
    - U801 decoupling = the Agilex U12 set (sheet 08: 29 x 100n 0201, 22u/1u 0402, LCSC from the
    Agilex card), placed at the Agilex positions on the same via pairs; R802 (ZQ) at R43's spot;
    CA/CKE T-branches on B.Cu copied (tools/ddr/copy_dram_escape.py)
    - LPDDR4 vias not on a BGA ball removed (T-branch centre vias kept)
    - Schematic: #PWR/#FLG references made unique per sheet (prefix = sheet number); the
    duplicates blocked Update PCB from Schematic
    - DQ swizzle now edited by hand in the schematic (bytes 0 and 2); efinity/pinplan/lpddr4_swizzle.json
    is not updated yet
    - Byte lanes routed by hand (work in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
    [01_pwr_input.kicad_sch, 02_pwr_vcore.kicad_sch, 03_pwr_rails.kicad_sch, 04_pwr_seq.kicad_sch, 05_fpga_power.kicad_sch, 06_fpga_config.kicad_sch, 07_clocks.kicad_sch, 08_lpddr4.kicad_sch]
2026-10-28 LPDDR4: third byte lane routed; DQ nets named after the DRAM pins
    - Byte 2 swizzle fixed in the schematic (U501 W16/Y16 labels), matching the copper;
    the two shorts at W16/Y16 are gone
    - ddr_dq<n> = DRAM DQ<n>_A (n 0-15) / DQ<n-16>_B (n 16-31); the swizzle shows only at the
    FPGA pins. Labels and board nets renamed (22 nets in bytes 1-3), copper unchanged
    - TI135_PCB_NOTES.md 6.1: naming note and FPGA ball -> DRAM bit table updated;
    efinity/pinplan/lpddr4_swizzle.json still holds the old map
    - Third byte lane routed by hand (work in progress: DRC clearance/width/skew still open)
    [08_lpddr4.kicad_sch, ti135_card.kicad_pcb]
2026-10-28 Efinity DQ swizzle matches the hand-routed schematic
    - efinity/pinplan/lpddr4_swizzle.json: bytes 0, 2, 3 from the current schematic (byte 1 unchanged)
    - pinplan.py (Efinity 2026.1): swizzle read back unchanged, design check passed, generated
    pinout matches the schematic on all 36 DQ/DM balls; ti135_pinplan.csv unchanged
    - TI135_PCB_NOTES.md 6.1: byte 3 row and the sync note updated
2026-10-28 Submodule kicad_ibis_simulation -> 8c4beae (fastnet fast sweeps, zsolve coupled pairs)
2026-10-28 sim/lpddr4_si: LPDDR4 IBIS trace-width study (KiCad 10 + ngspice), work in progress
    Ti135N484 (Efinix IBIS) <-> LPDDR4 (Winbond W66CL2NQUAFJ as stand-in for the SK hynix part),
    paths from the board, FPGA package from the Efinix RLC sheet, fast sweeps with
    tools/kicad_ibis_simulation (fastnet).
    - prep_models.py (models/ is git-ignored: vendor IBIS), gen_sch.py, run_si.py, report.py,
    board_paths.py, zsolve_widths.py, baseline schematic lpddr4_si.kicad_sch
    - results/: small sweep (typ, 2800/3200 MT/s: 0.10 mm costs ~10 % DQ margin at 2800,
    CKE should stay at today's width), field-solve table, CSV/markdown reports.
    results.csv/.md and results_quick.csv use the older package model (see READ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
    [lpddr4_si.kicad_sch, results.csv, results_first.csv, results_quick.csv, results_small.csv, zsolve.csv]
2026-10-28 LPDDR4: last byte lane routed; byte 1 DQ swizzle follows the layout
    Byte 1 (FPGA DDR_DQ[15:8] -> DQ[15:8]_A) re-swizzled by hand in the schematic;
    lpddr4_swizzle.json "1" = [7,1,5,0,6,2,3,4] (from the schematic netlist), Interface
    Designer PIN_SWIZZLE_DQM1 regenerated by pinplan.py (design check passed),
    TI135_PCB_NOTES byte 1 row updated. DRC: schematic parity 0, no clearance errors.
    [08_lpddr4.kicad_sch, ti135_card.kicad_pcb]
2026-10-28 sim/lpddr4_si: IBIS check of the hand-routed byte lanes (run_si.py --routed)
    Paths from the committed board (board_paths_routed.json): DQ/DM 0.10 mm, DQS
    0.10/0.20 inner. Worst DQ per byte, DM0, DQS0/2, typ, 2800/3200 MT/s: all pass;
    lowest margins at 3200: write 101 ps / 382 mV, read 51 ps / 144 mV (dq3).
    gen_sch.py --paths selects the DQ/DQS paths file.
    [results_routed.csv]
2026-10-29 J101 bench 5 V header, J3 0.9/0.6 mm pads, baseboard U8 2 A
    - J101 (sheet 01): 2.54 mm 1x2 header on F.Cu north-east of J6, pin 1 5V0 / pin 2 GND,
    to power the card with female jumpers without the baseboard. On the 5V0 B.Cu pour and
    the GND planes; nothing on the baseboard under its tails (MECHANICAL.md).
    - J3: project-local footprint ti135_card:PinSocket_2x19_P1.27mm_Vertical_Drill0.6
    (pads 0.9 mm, drill 0.6 mm, as on the Agilex card) so a 0.1 mm track fits between pins.
    - Baseboard U8 is now the Mornsun K7805-2000R3 (5 V / 2 A; ac_psu_kicad 732c9b1):
    POWER_BUDGET, STATUS and MECHANICAL updated; 20V_ISO_SEC still to be measured.
    - Board: also the routing in progress. DRC: schematic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
    [01_pwr_input.kicad_sch, 14_connectors.kicad_sch, ti135_card.kicad_pcb]
2026-10-29 Add CI board render (top/bottom PNGs as a workflow artifact)
2026-10-29 CI: plot signal layers (no silkscreen) to the renders branch; show them in README
2026-10-29 CI: plot all copper layers including power planes; README shows all eight
2026-10-29 Board plots via the shared kicad-board-plots workflow; README table is generated
2026-10-29 README: update board plot table
2026-10-29 README: board plot captions under each plot (kicad-board-plots v1 layout)
2026-10-29 Submodule kicad_ibis_simulation -> 2163ed6 (same tree as 8c4beae, history rewritten)
2026-10-29 LCSC numbers for all JLC parts; Y701 -> YXC OT322525MJBA4SL
    - tools/set_lcsc.py: one table (value, footprint) -> LCSC, fills empty LCSC fields in the
    sheets; 312 symbols. JLC basic parts where available, cap voltages checked per rail,
    VCORE divider 0.1 % (no 0.5 % in stock). Board fields synced with add_parts.py.
    - Y701: the SiT8924 has no JLC stock; now YXC OT322525MJBA4SL (C669088, 3225), EN tied
    to 1V8. R701/C701 moved 0.5 mm to clear its courtyard. Netlist change: Y701 pin 1 -> 1V8.
    - Only U501 (Ti135) is left without LCSC (global sourcing / consigned).
    - DRC: schematic parity 0.
    [01_pwr_input.kicad_sch, 02_pwr_vcore.kicad_sch, 03_pwr_rails.kicad_sch, 04_pwr_seq.kicad_sch, 05_fpga_power.kicad_sch, 06_fpga_config.kicad_sch, 07_clocks.kicad_sch, 08_lpddr4.kicad_sch]
2026-10-29 Y701: SiT PQFN 3.2x2.5 footprint (matches the YXC land pattern)
    YXC YSO110TR data sheet (OT322525MJBA4SL), 3225 recommended pattern: pads 1.3 x 1.2,
    gaps 0.8 / 0.7 mm. Oscillator_SMD_SiT_PQFN-4Pin_3.2x2.5mm has the same gaps and pad
    height (pads 1.4 x 1.2); the Abracon ASE one had a 0.55 mm gap and 1.1 mm pads.
    Data sheet also confirms pin 1 tri-state: high or floating = enabled (EN tied to 1V8).
    J3 HC-PM127-4.3H-2x19PZ drawing: 0.45 x 0.15 pins, recommended hole 0.6 mm (as J3 now).
    [07_clocks.kicad_sch, ti135_card.kicad_pcb]
2026-10-30 LPDDR4 delay targets as DRC length rules for pcbnew's tuner
    - tools/ddr/delay_rules.sh: KiCad delays -> ddr_timing.py --kicad --rules -> one length
    constraint (ps, die to die) per group in a generated block of kicad/ti135_card.kicad_dru.
    CA/CKE/CS to the group path +-2.5 ps, CK P/N and DQS P/N +-0.5 ps, DQ/DM DQS + 5..61 ps.
    Absolute targets: rerun after rerouting a net.
    - ddr_timing.py: the second branch of a shared CA/CK net is measured on the routed board
    (all copper minus the longest U501 -> U801 path, 22-27 ps) instead of the planned
    ca_trunk_branch.py geometry, which no longer matches the hand routing.
    - TI135_PCB_NOTES 6.9, tools/ddr/README.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
2026-10-30 LPDDR4: CA/CK group above the latest DQS; xtalk rule net names fixed
    - ddr_timing.py: the CA/CK group target is the larger of its longest path and the latest
    DQS + 5 ps (CK_OVER_DQS), so every DQS is shorter than CK (Efinix: write leveling only
    delays DQS). Byte 0 DQS 274.5 ps -> group 279.5 ps (CK - earliest DQS 98 ps, budget 350).
    Generated length rules regenerated.
    - lpddr_xtalk_group: DQS and reset net names updated from the old /IOBANK 3/ names to
    /08 lpddr4/ddr_dqs*_P/N and ddr_rst_n; the rule matched nothing before. The routing
    passes it at 0.3 mm (checked to fire on a 3 mm test copy).
    - TI135_PCB_NOTES 6.9.
2026-10-30 LPDDR4 DRC width rules to 0.1 mm (matches the hand routing)
    - lpddr_width: 0.09/0.1/0.11 mm on every LPDDR4 net class; lpddr_diff_gap 0.1/0.2/0.25 mm.
    Replaces the 40 ohm rules (0.18 inner / 0.25 outer, pairs 0.14/0.15 and 0.2/0.2).
    - 0.1 mm: 52.6 ohm inner / 60.4 ohm outer, pairs 0.10/0.20 inner 97 ohm. The IBIS check of
    the routed bytes passes (typ, 2800/3200 MT/s); CA/CK and min/max corners after delay matching.
    - track_width items 31 -> 12, all ddr_cke0 segments still at 0.18 (In2) / 0.25 (B.Cu).
    - TI135_PCB_NOTES 6.3.
2026-10-30 LPDDR4 delay matching (hand tuning) and tuner-terms length rules
    Board: hand delay tuning of the LPDDR4 (user). Bytes 2/3 and all DQS pairs matched;
    CA0/2/3/4 at the 306 ps group path. Still open: CKE0 +101, CS0/CS2 +27, CA1 +15,
    CK +4/+5, CA5 +3, dq1 +10; dq3 and dq14 too long (remove >= 22 / 46 ps).
    Rules (tools/ddr/delay_rules.sh regenerated):
    - pcbnew's tuner reads the pad-to-pad path, DRC's length check the whole net (CA5:
    tuner 302.5 ps, DRC 324.6 ps). Shared CA/CK nets now get min/opt as the path and a max
    that also allows the second branch; ddr_timing.py is the exact CA-CK check.
    - CA/CK group at 306.2 ps (the tuned CA path; DQS + 5 would be 279.5).
    - A DQ more than 61 ps over i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
    [ti135_card.kicad_pcb]
2026-10-31 ADC: buffer isoada1..3 before the mux (OPA365 followers)
    The baseboard now filters ISOADA1/2 with 8.2k + 4.7n and ISOADA3 with 8.2k + 10n. Fed straight into the
    SN74LV4051A, that source had to recharge the ~30 pF mux common node after every channel switch
    (tau 39/82 us), leaving a crosstalk error of about 8.2k x f_switch x 30 pF x dV.
    Each input now runs J3 -> 1k -> OPA365AIDBVR follower (U1304..U1306) -> mux, with 1n C0G to card GND at
    the + input (159 kHz, filters the ground difference across J3) and 100n decoupling. The mux labels are
    isoadaN_buf; the sheet pins keep their names. 1n C0G (C76947) added to set_lcsc.py.
    [13_adc.kicad_sch]
2026-10-31 LPDDR4: hand tuning continued, tuner stubs removed, CKE0 width rule
    - The user's further delay tuning (CKE0 tuned; dq1/dq3 now inside the DQS window).
    - Removed three stray stubs that fooled pcbnew's tuner: dq3 F.Cu 0.57 mm, dq14 In5 0.05 mm, ck_N In2 0.15 mm.
    - lpddr_cke_width: CKE0 at 0.12 mm on In2 (IBIS: lower over/undershoot than 0.1 mm, no ODT on CKE).
    - New footprints U1304-U1306, R1307-R1309, C1307-C1312 from the schematic update (still off board here).
    [ti135_card.kicad_pcb]
2026-10-31 ADC: isoada buffers placed and routed on B.Cu
    U1304-U1306 with their 1k + 1n C0G inputs and 100n decaps sit on B.Cu between J3 and the mux. ISOADA1-3 leave
    J3 pins 4/3/1 south, away from MDATA/ADCLK (pins 6/7). The buffered outputs reach mux X7/X6/X4 through vias under
    U1301's body; J3's order is the mux's reversed, so isoada2_buf and isoada3_buf cross on In5. 3V3_analog joins the
    three decaps on In2; its feed from the LDO is left open. DRC (zones refilled): no new items.
    [ti135_card.kicad_pcb]
2026-10-31 LPDDR4 SI: CKE0 width run (0.12 vs 0.10 mm, routed CKE path)
    run_si.py --cke: CKE0 at 2800/3200 Mbps, typ/min/max corners, In2 at 0.12 and 0.10 mm with the routed B.Cu
    breakout (board_paths_cke.json). gen_sch.py gets --ca-paths and --ca-neck-cap. Result: 0.12 mm is better at every
    typ/min point; at 3200 typ the 0.10 mm die peak exceeds the 1.40 V limit. The max corner is not usable (the Efinix
    driver settles above its [Voltage Range] max; drivers only validated at typ).
    [results_cke.csv]
2026-10-31 LPDDR4: dq14 retuned (hand)
    dq14 no longer carries extra copper: KiCad reads 205.1 ps (was 270.9), inside byte 1's DQS + 5..61 ps window.
    [ti135_card.kicad_pcb]
2026-10-31 LPDDR4 delay rules: green in DRC and the tuner means the Efinix checks pass
    - ddr_timing.py: vias use KiCad's model (stack-up height x the profile's 7.2 ps/mm: F->In2 1.8 ps, F->In5 9.4 ps,
    F->B 11.1 ps) instead of a flat 5.5 ps. The model now matches KiCad within ~1 ps on every point-to-point net; the
    byte 1/3 "DQ shorter than DQS" readings were the old via model.
    - Shared CA/CK/CKE nets: DRC sums the whole net, so each rule is the path target plus that net's second branch
    (+-2.5 ps, CK +-0.4 ps). Before, the rules were in path terms with a branch-wide max and DRC passed CA1 10 ps short.
    - Their tuning patterns (the tuner reads pad to pad) get the path target as an override: new
    too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
    [ti135_card.kicad_pcb]
2026-10-31 kicad_ibis_simulation: DELAY_RULES.md (delay-matching rules and tuning patterns)
2026-10-31 LPDDR4 delay rules: shared nets back to path terms; board restored with its patterns
    pcbnew's "Update all tuning patterns" ignored the path-target overrides on the shared CA/CK/CKE nets and tuned them
    to the whole-net rule (CKE0 330 ps, CK 327-328 ps against 306.5 ps), and the GUI session then lost every tuning
    pattern. Back to one rule that serves both: min/opt in path terms (what the tuner reads and the update aims at),
    max = path + tol + the net's second branch (DRC sums the whole net). Good = pattern green after an update and DRC
    green. Rules generated from the bc0a22b board (target 306.5 ps); pattern_targets.py and --patterns removed.
    The board is restored to bc0a22b (42 tuning pattern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
    [ti135_card.kicad_pcb]
2026-10-31 kicad_ibis_simulation: DELAY_RULES.md tuner set-up section
2026-10-31 LPDDR4 tuned: all delay windows and crosstalk spacing pass DRC
    Board (hand tuning with pcbnew tuning patterns, 52 patterns):
    - CA/CKE/CS vs CK -1.8..+0.8 ps (rule +-5.3), CK P/N 0.24 ps.
    - DQ - DQS: byte 0 +9.0..11.8, byte 1 +8.9..13.2, byte 2 +11.1..12.1, byte 3 +11.2..14.9 ps (window +5..+15).
    Byte 1's DQS raised to 211.8 ps (dq15 - 10) instead of shortening its long DQs.
    - Removed three in-pad vias on dq2/dq16/dq23 (F.Cu-only nets: the barrel was a stub).
    - DRC (zones refilled): no clearance, length or skew errors; all LPDDR4 nets connected.
    Rules and tools:
    - ddr_timing.py: per-net tuner offset on shared nets (tuner - path, read from each pattern's last_tuning_length:
    CA1 +11 ps, CK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
    [ti135_card.kicad_pcb]
2026-10-31 LPDDR4_IBIS_PLAN.md: plan for the routed-board IBIS simulation
2026-10-31 LPDDR4 SI step 1: driver validation at all corners, corner model files
    - run_si.py --validate typ|min|max [--corner-files]: each driver into its own V-t fixture (R_fixture read from the
    model) against the table of that corner, then the DC high level into the board's loads (60 ohm, 40 ohm, open)
    against the model's V-I tables.
    - KiCad's corner keywords (vcc=MIN/MAX ...) are exact only into the fixture: Efinix driver -21/+46 mV into 60 ohm,
    -72/+129 mV open (the 1.24 V max-corner CKE level). corner_models.py writes models/min|max/ (min/max column as
    typ); simulated at typ every Efinix level is within 3 mV at every load, edges within 1-7 ps.
    - Winbond stand-in: within 4 mV into the FPGA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
2026-10-31 LPDDR4 SI step 2: routed copper extraction, checked against KiCad
    extract_routes.py (adapted from the Agilex card's) dumps the 56 LPDDR4 nets as graphs (track pieces with layer,
    length and width; vias with their joined layers; pads with the U501 pad-to-die delay; netclass) plus the stack-up
    and tuning profiles. check_routes.py rebuilds each net's whole delay from the graph with KiCad's model: within
    0.76 ps of KiCad's DRC readout on every net (results/check_routes.md, with the pad-to-pad paths per U801 ball).
2026-10-31 LPDDR4 SI step 3: one-net routed netlists, measured
    routed_si.py builds one net's extracted copper (every piece with the Z0/ps-per-mm of its layer and width, vias as
    hubs, stubs and T branches as routed) between its IBIS buffers; min/max from the corner model files; .save only the
    probes; the .dat deleted after reading. Worst cases at min/3200: ddr_ca2 11 s 76 MB, ddr_cke0 12 s, ddr_dq1 8 s.
    CPU-bound: full corners on every net, about 516 netlists, about 26 min at -j 4.
2026-10-31 LPDDR4 SI step 4: typ sweep of every routed net passes at 2800 and 3200 Mbps
    routed_si.py: DQS/CK pairs (each leg its own copper at the pair's odd-mode Z0, 0.10/0.20 mm as routed), the sweep
    (one net or pair per netlist, -j workers, timeout and address-space cap per ngspice run, rows appended as each
    netlist finishes and skipped on a rerun, .dat deleted) and eye PNGs of the worst nets.
    Typ: 172 netlists in 7.7 min at -j 4, 0 failed; no negative margin, no over/undershoot limit exceeded. Tightest:
    DQ read timing 49 ps (3200, dq11), CA voltage margin 137 mV, CKE peak 1344 mV (limit 1400). results/routed_typ.md.
    [routed.csv]
2026-10-31 LPDDR4 SI step 5: min/max corners on every routed net
    344 netlists (min/max from the corner model files), 14 min, 0 failed. No negative eye margin at any corner or rate.
    One limit exceeded: CKE0 at max corner, 3200 Mbps peaks at 1486 mV vs 1470 mV (area within); 1417 mV at 2800. With
    the FPGA's 48 ohm drive on CKE it drops to 1342 / 1415 mV, eye still wide open. results/routed_corners.md.
    [routed.csv]
2026-10-31 LPDDR4 SI step 6: crosstalk from the board's coupled lengths
    coupled_lengths.py: besides each pair's own P/N, at most 2.5 mm at a 0.20-0.25 mm edge gap (dq14) and 9.2 mm at
    0.30-0.40 mm (dq30/dq31); CA/DQ cross on different layers with planes between. Three coupled lines (run_si.py --xtalk
    --xt layer,w,gap,len), the two board cases and a 10 mm bound, 2800/3200: at most 14 mV eye height, 10 mV V margin,
    8 ps t margin lost, 30 mV far-end noise on a quiet victim; every net still passes. ngspice's CPL element stopped
    every run, so the coupled section is now a lumped ladder of 0.25 mm sections from the same L/C matrices; the quiet
    victim threshold is 0.3 V (near-end noise reached 50+ mV). results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
    [results_xtalk_board.csv]
2026-10-31 LPDDR4 SI step 7: the checks can fail; final report
    bad_case.py (3200 Mbps): DQ write with the DRAM ODT off at max fails the over/undershoot limits; DQ read with the
    FPGA ODT off at max fails timing (-30 ps); all traces at 150 ohm and 4x long still pass with ODT (259 mV eye) and
    close the eye without it (-450 mV, 0 ps). Plots agree with the numbers.
    Report in sim/lpddr4_si/README.md: every routed LPDDR4 net passes at 2800 and 3200 Mbps, typ/min/max, crosstalk
    included, except CKE0 at max/3200 (16 mV over the peak limit): set the FPGA's CKE drive to 48 ohm.
2026-10-31 kicad_ibis_simulation: corner files, DC check and coupled-line ladder
2026-10-31 Efinity DQ drive 40 ohm; CKE fix is a series resistor, not a drive setting
    - pinplan.py: DQ_PD/PU_DRV_STRENGTH 40 ohm (Efinity default 34.3): the routed-board IBIS run used 40 ohm and the
    Efinix IBIS file has no 34.3 ohm driver. Pin plan regenerated; signal -> ball CSV unchanged.
    - Efinity's DDR block has no drive setting for CA/CK/CKE, so the "48 ohm CKE drive" in the SI report was wrong.
    Simulated instead: a series resistor at U501 on CKE (10 ohm: max/3200 peak 1291 mV vs 1470 mV limit, eye margins
    376 mV / 208 ps); table in routed_corners.md, report and plan corrected.
    [pinplan.py]
2026-10-31 CKE: 10 ohm series resistor R803 on B.Cu at the U501 CKE via
    Sheet 08: U501 AB11 -> ddr_cke0_fpga -> R803 (10R 0402, C25077) -> ddr_cke0 -> U801 J4/P4; lpddr_ca netclass
    pattern includes cke0_fpga. CKE has no ODT; at max corner / 3200 Mbps it peaked 16 mV over the overshoot limit,
    with the resistor 179 mV under it (sim/lpddr4_si/results/routed_corners.md). Board: R803 placed on B.Cu on the
    CKE via (user), CKE rerouted to it.
    [08_lpddr4.kicad_sch, ti135_card.kicad_pcb]
2026-10-31 LPDDR4 scripts follow CKE through R803; finer snap in ddr_timing
    - ddr_timing.py: SERIES (ddr_cke0 through R803 from ddr_cke0_fpga): the FPGA side (U501 pad-to-die + via, 65.2 ps)
    is added to CKE's path and left out of its rule, since KiCad's tuner/DRC see ddr_cke0 from R803 on. Pads on B.Cu
    join their vias at B.Cu. GROUP_SKIP keeps a net out of the group target. 5 um snap and join (0.02 mm merged the
    0.018 mm-apart ends of a tight meander on dqs1_N into a shortcut).
    - extract_routes.py / routed_si.py / check_routes.py: series parts in the extraction (pad layers), CKE simulated as
    ddr_cke0_fpga -> 10 ohm -> ddr_cke0; a via under two pads keeps both.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
2026-10-31 CKE retuned through R803; DQS1 skew fixed; CKE SI on the final routing
    - CKE rule from R803, shifted by the tuner's offset on the B.Cu routing (-23.0 ps): CKE 306.7 ps die to die,
    -1.0 ps vs CK. DQS1 P/N equal (211.8 ps), C5072/C5073 courtyards cleared (user). DRC clean.
    - CKE IBIS with R803 on the final routing passes at every corner: peak 1331 mV at max/2800 (139 mV margin),
    1448 mV at max/3200 (22 mV), eye margins >= 449 mV / 216 ps (results/routed_corners.md).
    [ti135_card.kicad_pcb]
2026-10-31 R803 15 ohm: CKE peak 1376 mV at max/3200 (94 mV under the limit)
    R803 (CKE series) 10R -> 15R, LCSC C25083. CKE rerun at typ/min/max on the
    final routing: all corners pass; peak margin at max 208 mV at 2800 and
    94 mV at 3200 (was 139 / 22 mV with 10 ohm).
    [08_lpddr4.kicad_sch, ti135_card.kicad_pcb]
2026-10-31 U501 I/O breakout stubs west/south/east from the pad vias
    70 unescaped I/O balls get a short stub from their pad via (L4 fpga_ssu_n,
    no via: from the pad on F.Cu) out past the ball field: 49 east, 16 south,
    5 west, on F.Cu/In2/In5/B.Cu, 0.1 mm (rgmii 0.12 mm), 45/90 degree moves
    in the channels between the vias, no new vias. Supplies (vcca_*, vddpll),
    DDR_CAL and CKE left alone. No new clearance errors in DRC.
    [ti135_card.kicad_pcb]
2026-10-31 Board plots workflow v1.1 with 3D renders
2026-10-31 3D models for the BGAs (U501, U801, U1001, U601)
    KiCad's library has no model for any of them (the footprints pointed at
    missing STEP files), so tools/gen_bga_3d.py writes simple VRML models
    (body, pin-1 dot, balls) to lib/3dmodels, from datasheet dimensions:
    Efinix N484 model, SK hynix 200-ball FBGA, Kioxia P-WFBGA153, ISSI 24-ball
    TFBGA (H). Linked as ${KIPRJMOD}/../lib/3dmodels so the CI render finds them.
    U501 and U1001 footprints copied into ti135_card.pretty (footprint fields
    updated on board, schematic, symbol lib); the U501 copy carries the board's
    pad-to-die delays, which clears its lib_footprint_mismatch. DRC parity clean.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
    [05_fpga_power.kicad_sch, 06_fpga_config.kicad_sch, 08_lpddr4.kicad_sch, 10_emmc.kicad_sch, 11_fpga_io.kicad_sch, ti135_card.kicad_pcb]
2026-11-01 Placement copied from the Agilex 3 card: power, JTAG/UART, PHY, eMMC, QSPI
    - U901 PHY (rotated 180 as on the Agilex card), U1001 eMMC, U601 QSPI, J1 JTAG, J2 UART at the
    Agilex positions; their passives matched by function, nudged where 0402 does not fit 0201 spots
    - buck cells moved rigidly with their tracks: VCORE exact, 1V1/3V3 near the Agilex spots,
    0V85 in the Agilex 1V2 spot, 1V8 next to VCORE (the Agilex spot is fenced by the isoada routes)
    - U401/R401/C401 moved out from under the eMMC
    - PHY pours copied (GND, phy_dvdd_rg, phy_vdd10 on B.Cu, phy_avdd33 on In2.Cu); B.Cu 5V0 now the
    Agilex flood plus the buck cells and the input parts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
    [ti135_card.kicad_pcb]
2026-11-01 Placement hand-tuned; power planes reshaped, 3V3 plane on In3
    - hand edits: U601, eMMC, J1/J2, J101 and power parts moved; schematic sheets saved by KiCad
    - In3 1V1: reach to the old regulator removed, extended left over the 1V1 buck and the LPDDR4 caps
    - In3 VCORE: reach to the right removed, extended south over the VCORE buck
    - In3 3V3 (new): left column, bottom strip and the right side (eMMC, JTAG, PHY), clear of the DDR area
    - In4 0V85: corridor south between the GND/VCORE ball columns to the 0V85 buck
    - all VCORE/1V1/0V85/1V8 vias land in their plane; DRC adds no violations
    [01_pwr_input.kicad_sch, 02_pwr_vcore.kicad_sch, 03_pwr_rails.kicad_sch, 04_pwr_seq.kicad_sch, 05_fpga_power.kicad_sch, 06_fpga_config.kicad_sch, 07_clocks.kicad_sch, 08_lpddr4.kicad_sch]
2026-11-01 5V0 to the 1V1 buck: In5 jumper under the isoada traces
    The 1V1 buck's piece of the B.Cu 5V0 flood was cut off from the main flood by the isoada2/isoada3
    routes. One 0.5 mm In5 track with a 0.6/0.3 via at each end joins them; DRC unchanged.
    [ti135_card.kicad_pcb]
2026-11-01 STATUS/NEXT_SESSION: handoff at the 2026-11-01 stop
    Where we left off after the Agilex placement copy, the plane reshape and the 5V0 jumper; open list for next
    time. NEXT_SESSION rules updated: schematics are hand-edited now, no session trailer.
2026-11-01 33R series resistors on the QSPI flash and eMMC lines; routing in progress
    - eMMC: R1001 (CLK) 10R -> 33R, new R1002 (CMD), R1003-R1009 + R1021 (DAT0-7), R1022 (DS)
    - flash: new R623 (SCK), R624 (CS#), R625-R628 (IO0-3)
    - each between the FPGA-side net (pull-ups stay there) and <net>_r to the memory; 0402, C25105;
    tools/add_series_r.py edits sheets 06/10 as text; ERC unchanged
    - board: the 16 resistors added (staged right of the outline), U601/U1001 pads on the _r nets; the
    routed flash traces still end on U601's pads (6 shorts until the resistors are put in)
    - user's flash routing in progress included
    - sim/flash_emmc_si: IBIS set-up (Efinix 1.8 V LVCMOS models, data-sheet memory loads)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
    [06_fpga_config.kicad_sch, 10_emmc.kicad_sch, ti135_card.kicad_pcb]
2026-11-02 0201 for the eMMC and QSPI flash terminations, bypass caps and pull-ups
    - 33R series resistors R1001-R1009, R1021, R1022, R623-R628: 0201, LCSC C320843
    - eMMC: C1002/3/5/6 100n C190183, C1001/C1004 4u7 C5969171, C1007 2u2 C77762,
    R1010-R1020 47k C270345 (UNI-ROYAL 0201WMF4702TEE)
    - Flash: C615 100n C190183, R616-R619 10k C473048
    - Footprints swapped in place (side, rotation, nets kept); DRC counts and parity unchanged
    - add_series_r.py generates 0201 parts
    - Board: routing in progress (hand edits)
    [06_fpga_config.kicad_sch, 10_emmc.kicad_sch, ti135_card.kicad_pcb]
2026-11-03 0201 for the FPGA config and JTAG pull resistors
    R605-R614, R622 (10k, incl. JTAG R607-R610 and DNP CBSEL R613/R614): 0201, LCSC C473048.
    Footprints swapped in place; DRC counts and parity unchanged.
    [06_fpga_config.kicad_sch, ti135_card.kicad_pcb]
2026-11-03 start routing emmc
    [ti135_card.kicad_pcb]
2026-11-04 ADC mux: NX3L4051PW with 1.8 V selects straight from the FPGA
    - U1301 SN74LV4051A -> NXP NX3L4051PW,118 (LCSC C2673441): same TSSOP16 pinout (pin 7 n.c., stays on GND),
    VIH 1.3 V at VCC 2.7-3.6 V, so adbsel0-2 drive it at 1.8 V without a translator
    - adbsel*_3v3 removed (root sheet, sheets 12/13); U1204 B5-B7 no-connect, A5-A7 stay on adbsel0-2
    - Board: U1301 fields and select pads updated; Description fields of the 0201-swapped parts restored
    from the schematic (schematic parity 0)
    - STATUS / MIGRATION_PLAN notes updated
    [12_level_shift.kicad_sch, 13_adc.kicad_sch, ti135_card.kicad_pcb, ti135_card.kicad_sch]
2026-11-04 ADC mux TMUX1308PWR; level-shifter breakouts copied from U1204
    - U1301 NX3L4051PW -> TI TMUX1308PWR (LCSC C970231): 4051 pinout (pin 7 n.c., stays on GND),
    on-capacitance 11 pF typ / 40 pF max (NX3L: 350 pF), Qinj -1 pC, VIH 1.15 V at 3.3 V so the
    1.8 V adbsel selects keep margin
    - U1201-U1203: U1204's breakout (pad stubs, under-body diagonals, via-in-pad power) copied by
    translation, nets taken from each chip's pads; old breakouts removed, decap links kept.
    U1201 and U1203 omit the pin 13 GND / pin 24 3V3 vias (isoada2 B.Cu trace, U1304/C1312 below)
    - Hand edits: sheets 06/10/12 (U1204 spare channels un-flagged for the I/O reorder), board routing
    - STATUS / MIGRATION_PLAN: mux notes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
    [06_fpga_config.kicad_sch, 10_emmc.kicad_sch, 12_level_shift.kicad_sch, 13_adc.kicad_sch, ti135_card.kicad_pcb]
2026-11-04 ADC mux settling simulation (WIP); STATUS handoff 2026-11-04
    - sim/adc_mux/adc_mux_sim.py: mux -> OPA365 -> 33R/680p -> ADS7056 sampler at 2.5 MSPS round-robin,
    run through KiCad's bundled libngspice; data-sheet mux models (TMUX1308 typ/max, NX3L4051,
    SN74LV4051A), TI OPA365 PSpice model fetched into the git-ignored models/ dir
    - .gitignore: sim/adc_mux/models/ and work/
    - STATUS.md: "Where we left off (2026-11-04)"
2026-11-04 Rail monitors 100R/200R from the ADC mux simulation; sim fixes; I/O reorder in progress
    - R1302/R1304 1k -> 100R (C25076), R1303/R1305 1k -> 200R (C25087): at the TMUX1308's max
    capacitance the 1k monitor sources left 38-74 LSB after a large channel step; at ~100R all
    channels settle to <= 2 LSB (GND 4 LSB, OPA365 near the rail)
    - adc_mux_sim.py: full-precision PWL times (4 digits rounded the 1 ns edges past 100 us and
    stalled the solver), save only v(csh) and free circuits (memory), new resistor values as
    default, old 1k values as scenario tmux1308_max_rmon1k
    - STATUS: sweep results table and conclusions
    - Hand edits in progress: sheets 12/14 level-shifter I/O reorder, board
    Co-Aut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
    [12_level_shift.kicad_sch, 13_adc.kicad_sch, 14_connectors.kicad_sch, ti135_card.kicad_pcb]
2026-11-05 Level-shifter channels follow the J3 routing; isoada buffers as one OPA4322 quad
    - Sheet 12: shifter channels reassigned so each J3 trace meets its stub (A/B labels moved
    together); spare channels' A inputs on adbsel0-2, B outputs no-connect; U1204 A5 (res1
    channel) left open. Root sheet: res1 sheet pins on the level_shift and connectors blocks.
    U1201 ch4-8 and U1203 are placeholders in J3 order until routed.
    - Board: pad nets updated, breakout copper follows; 15 short joins J3 trace -> stub
    (mdata_inu/mdata_dab left for hand routing, they are FPGA inputs)
    - Sheet 13: U1304-U1306 (3x OPA365) -> U1304 OPA4322AIPWR (LCSC C486027), units A-C in place,
    D spare follower (+ to GND), powe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
    [12_level_shift.kicad_sch, 13_adc.kicad_sch, ti135_card.kicad_pcb, ti135_card.kicad_sch]
2026-11-05 U1304 OPA4322 placed between the old op-amp spots; gate swap toward the input filters
    - U1304 at (8.95, 32.9) mm on B.Cu, C1310 moved next to its V+; old SOT-23 breakouts and the
    isoada3_buf via that landed on pad 14 removed (its In5 trace left for re-routing)
    - Gate swap: isoada1 -> unit B (by R1307), isoada3 stays C (by R1309), isoada2 -> unit D
    (toward R1308), spare follower -> unit A; + input nets renamed on the board, parity 0
    [13_adc.kicad_sch, ti135_card.kicad_pcb]
2026-11-05 start routing the io to connector
    [ti135_card.kicad_pcb]
2026-11-11 J3 I/O routed to the level shifters and FPGA; pin plan follows the routing
    FPGA balls for the J3 outputs, ADC SPI and mux selects reassigned to match the routed
    board (pinplan.py / ti135_pinplan.csv, sheets 11-13). eMMC series-resistor nets, U1304
    follower inputs and the 1V1 buck cell (U341) rerouted; 33 footprints moved.
    ADC mux sim: 300R / 500R rail-monitor scenarios.
    [03_pwr_rails.kicad_sch, 10_emmc.kicad_sch, 11_fpga_io.kicad_sch, 12_level_shift.kicad_sch, 13_adc.kicad_sch, ti135_card.kicad_pcb, ti135_card.kicad_sch, ti135_pinplan.csv]
2026-11-12 Ethernet PHY routed; PHY passives as 0201 on the Agilex card positions
    - RX series resistors, straps and PHY bypass caps converted to 0201 and
    placed on their Agilex card counterparts' positions (sheet 09 + board)
    - MDI pairs and PHY fan-out copied from the Agilex card
    - RGMII TX on In5, RX on In2/In5; MDC/MDIO/INT/LED on inner layers
    - tools/eth_place.py, eth_fanout.py, eth_route.sh, eth_finish.py
    reproduce the placement and routing from the unrouted board
    - Open: PHY supply pins to pours, refclk_bl0..2
    [09_ethernet.kicad_sch, ti135_card.kicad_pcb]
2026-11-12 FB501, FB502 and C5004 moved by hand; FB502 to B.Cu
    FB501 (VCORE ferrite) 1.6 mm west / 1.4 mm south, FB502 from F.Cu to B.Cu under U501,
    C5004 6 mm south. No copper changes.
    [ti135_card.kicad_pcb]
2026-11-12 Five TLV62585 cells rebuilt from one template; output edges face the plane entry
    One 6.9 x 8.5 mm cell for every rail (tools/buck_cell.py): L 1 uH 2520, CIN 10 u 0603 +
    100 n 0201 at VIN, COUT 47 u 0805 + 22 u 0603, 0201 divider (1 %) and feed-forward cap.
    VOUT bus with the plane vias on the output edge, one-piece GND with vias to In6, PG via
    in pad. Sheets 02/03 edited in place (tools/buck_cell_sch.py): the second 22 u of each
    cell is now its 100 n input cap, new C335 on 0V85.
    VCORE, 1V8, 0V85 face north, 3V3 and 1V1 east. U341 moved 2.25 mm east, the others at
    most 0.5 mm. In4 0V85 region widened over the cell's output vias. LPDDR4 caps C808, C809,
    C825, C826 tied to the 1V1 bus. No new D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
    [02_pwr_vcore.kicad_sch, 03_pwr_rails.kicad_sch, ti135_card.kicad_pcb]
2026-11-12 Rail decoupling: bypass caps to 0201, bulk counted per rail
    47 caps from 0402 to 0201 (1 u / 4.7 u on VCORE, 0V85, 1V1, 1V8; 1 u on 3V3; 100 n at the
    level shifters, U401, Y701, PHY). Nine of those under U501 moved onto free rail/GND via
    pairs. Bulk outside the regulator cells: VCORE 2 x 100 u, 1V8 2 x 47 u, 1V1 1 x 47 u (C538,
    was 10 u). 16 bulk caps removed from the board and marked DNP / not on board in the
    schematic (tools/decap_rework.py). Kept in 0402: the 4.7 u on 3V3 and C5033.
    No new DRC violations, schematic parity clean, opens 432 -> 399.
    [04_pwr_seq.kicad_sch, 05_fpga_power.kicad_sch, 07_clocks.kicad_sch, 08_lpddr4.kicad_sch, 09_ethernet.kicad_sch, 12_level_shift.kicad_sch, 13_adc.kicad_sch, ti135_card.kicad_pcb]
2026-11-12 pg_group1 and pg_all routed to the regulator cells
    route.py, 0.15 mm, In2/In5 preferred: pg_group1 from R401 to the PG vias of VCORE, 1V8,
    3V3 and the EN stubs of 0V85, 1V1; pg_all from the PG vias of 0V85, 1V1 to U401.
    9 new vias, no other net touched, no new DRC violations.
    [ti135_card.kicad_pcb]
2026-11-12 Rail decaps connected: 97 of 127 loose pads
    tools/decap_connect.py: via in pad (42), via beside the pad or between four balls under
    U501 (30), straight track to a via of the net (19), two-segment track (6). Every via
    checked against all layers and, for rail pads, placed on the rail's filled plane.
    No new DRC violations; opens 388 -> 296. The 30 pads left open are listed in STATUS.md.
    [ti135_card.kicad_pcb]
2026-11-12 Four loose 1V8 decaps moved next to their ball vias; the rest reconnected in place
    tools/decap_move.py: C5029, C5035, C5036, C5039 moved 2.8-6.6 mm to a 1V8 ball via of
    U501 with at most 1.6 mm of track. The other 18 candidates have no spot that keeps
    courtyards clear on the 0.8 mm grid; they stay and are reconnected where possible.
    No new DRC violations; opens 296 -> 288. Remaining 22 open pads listed in STATUS.md.
    [ti135_card.kicad_pcb]
2026-11-13 Surplus 0V85 decaps dropped; five more caps moved with a pad-spacing rule
    C528, C529, C531 (1u) and C533 (100n) exceed the checklist count on 0V85: DNP and
    not on board. tools/decap_move.py --pads allows courtyard overlap under U501 with
    0.2 mm pad-to-pad spacing and 45 degree placements; C530, C5032, C5038, C5043 and
    C5055 moved to their rail's ball vias. courtyards_overlap 6 -> 11 (accepted), no
    other new DRC violations; opens 288 -> 277. Remaining 11 open pads in STATUS.md.
    [05_fpga_power.kicad_sch, ti135_card.kicad_pcb]
2026-11-13 C5048, C5049 to 0201; C563 on 3V3 ball G7, C5048 at the 3V3 via west of U501
    The 4.7 u on 3V3 under U501 go to 0201 (C47117441) so the mover can try them. C563
    (100 n) takes G7 at 45 degrees, C5048 the 3V3 via shared with C5050/C5051/C565; C5049
    has no spot at J7 and is seated with its GND pad on ball via C7, 3V3 pad still open.
    GND pads of the VCCA_BR filter caps C5064-C5066 tied to E7/E8 (decap_connect --gnd).
    decap_move --pads: ground pad may tie to a neighbour's connected GND pad or get a new
    via where every layer is free. No new DRC violations; opens 277 -> 272.
    [05_fpga_power.kicad_sch, ti135_card.kicad_pcb]
2026-11-13 pg_all removed; C5049 at 3V3 ball J7, C556 moved to 1V8 ball N8
    pg_all (PG of 0V85 and 1V1 into ~MR of the TPS3808) is not needed: labels, sheet pins,
    86 mm of track and 5 vias removed (tools/drop_pg_all.py). The two PG pins and ~MR carry
    no-connect flags; U401 releases fpga_creset_n on VCORE + delay and no longer waits for
    group 2. C5049 sits at 45 degrees at J7 with its GND pad on K8, where C556 was; C556
    went to N8 with a new GND via. courtyards_overlap 11 -> 13 (accepted under U501), no
    other new DRC violations; opens 272 -> 271, 8 decap pads left open.
    [03_pwr_rails.kicad_sch, 04_pwr_seq.kicad_sch, ti135_card.kicad_pcb, ti135_card.kicad_sch]
2026-11-13 4.7 u and 1 u decaps moved from under U501 to the ring outside its body
    tools/decap_perimeter.py: 19 caps sit 0.7-3.7 mm outside the BGA body on B.Cu with a
    via in both pads, the rail via on its filled plane. 62 caps (100 n, 10 n, 1 n) stay
    under the part. C530 (0V85) landed 17 mm from its balls at the south edge: to review.
    No new DRC violations; courtyards_overlap 13 -> 11, opens 271 -> 269, 7 pads left open.
    [ti135_card.kicad_pcb]
2026-11-13 C530 back under U501 at its 0V85 ball via
    The ring outside the body only had a spot 17 mm from the 0V85 balls, so the 1 u goes
    back to (169.4, 76.4) at 45 degrees. DRC unchanged; 63 caps under the BGA, 18 outside.
    [ti135_card.kicad_pcb]
2026-11-13 35 short local nets routed: config flash, config pins, eMMC, ADC front end
    route.py with the Ethernet recipe's options (0.12 mm, F/B cheap). Old partial copper
    on these nets replaced. flash_cs_n_r, flash_io2_r, flash_io3_r failed and stay open.
    No new DRC violations; opens 269 -> 223.
    [ti135_card.kicad_pcb]
2026-11-13 43 long signal runs routed; all signal nets connected except three flash nets
    route.py, inner layers cheap: JTAG, config, LCD and touch to J5, eMMC data and strobe,
    ADC select and SPI, LEDs, reference clocks, UART, DDR_CAL, REF_RES_2A. flash_cs_n_r,
    flash_io2_r, flash_io3_r failed again and stay open. One new 0.57 mm dangling stub on
    j3_oe_n; no other new DRC violations. Opens 223 -> 174, the rest are supply pins.
    [ti135_card.kicad_pcb]
2026-11-13 R801 and R601 moved under U501 to their balls
    R801 (240R, DDR_CAL) sits on ball via Y9 with a new GND via beside pad 2; R601 (10k,
    REF_RES_2A) on a new via in ball P16 with pad 2 on GND ball via P15. Both on B.Cu; the
    15 mm and 14 mm runs are gone. decap_move --pads takes any part with one GND pad.
    No new DRC violations; opens 174 -> 172.
    [ti135_card.kicad_pcb]
2026-11-13 R801 and R601 to 0201 under U501
    R801 (DDR_CAL): 240R 0.5 % RC0201DR-07240RL (C851687) instead of 0.1 % 0402; no 0.1 %
    0201 in stock at JLCPCB, looser tolerance accepted (the Efinix checklist asks 0.1 %).
    R601 (REF_RES_2A): 10k 1 % RC0201FR-0710KL (C106225). Both re-seated at their balls.
    DRC unchanged, opens 172.
    [06_fpga_config.kicad_sch, 08_lpddr4.kicad_sch, ti135_card.kicad_pcb]
2026-11-13 Flash nets finished: four shorts removed, all signal nets connected
    Copper from before the 33R series resistors still ran /flash_cs_n, /flash_io2 and
    /flash_io3 into vias in the flash pads C2, C4, D4, shorting R624, R627, R628: vias and
    In2 ends removed, both sides of each resistor re-routed. The In2 run of /flash_sck
    crossed a via of emmc_dat1_r: segment replaced. shorting_items 4 -> 0, hole_clearance
    3 -> 0, solder_mask_bridge 3 -> 0; opens 172 -> 169, all supply pins.
    [ti135_card.kicad_pcb]
2026-11-13 5V0 pour on B.Cu shaped into a feeder
    tools/shape_5v0.py: trunk along the south edge from J101/J6 and C101-C103, fingers to
    the VIN pour of U301, U201, U331 and to the EN stubs of U301, U201, U311, a strip up
    the west side to U311 and U341, a tab under U101/C104. Solid on SMD pads, reliefs on
    through-hole. The cells keep their own VIN/GND/VOUT/SW pours. DRC unchanged, opens 169.
    [ti135_card.kicad_pcb]
2026-11-13 5V0 fully connected: vias in U101.1, U101.3, C104.1, R401.1 to the B.Cu pour
    tools/pour_vias.py ties F.Cu pads to a named pour with a 0.3/0.15 via in or beside the
    pad. No new DRC violations; opens 169 -> 165.
    [ti135_card.kicad_pcb]
2026-11-13 Supply pins connected, rail monitors DNP for now; one pad left open
    Rail monitors R1301-R1305 off the board and DNP in sheet 13 (tools/drop_monitors.py);
    they may return, the symbols and mon_* nets stay drawn. Supply pads: vias to the planes
    (decap_connect --all), VCCA / DDR PLL / PHY supplies and 3V3_analog routed at 0.2 mm on
    the signal layers, the remaining plane-net links routed with keep-outs around the PHY
    and the 5V0 strip, two stitching vias on the PHY GND pour. phy_rx_ctl was re-routed
    near U901 pins 28-30. Opens 165 -> 1 (U901 pin 29, 3V3); no new DRC violations.
    [13_adc.kicad_sch, ti135_card.kicad_pcb]
2026-11-13 U901 pin 29 connected: board has no open connections
    Via in the west tip of pad 29 down to the 3V3 plane, after removing a
    redundant phy_vdd10 loop on B.Cu below the pin. tools/phy_pin29.py holds
    the change.
    [ti135_card.kicad_pcb]
2026-11-13 Dangling vias and track stubs removed
    20 unused vias and 22 dead track segments deleted with
    tools/drop_dangling.py; two overshooting tracks (j3_oe_n at L5,
    jtag_tms at F7) trimmed onto their junction. DRC with parity shows only
    the 11 accepted courtyard overlaps, 0 unconnected.
    [ti135_card.kicad_pcb]
2026-11-13 2520 inductors to the FTC252012S data-sheet land pattern
    New project footprint ti135_card:L_2520_FTC252012S (pads 0.95 x 2.10 at
    +-0.825, 2.60 overall, 0.70 gap) on L201, L301, L311, L331, L341 in
    sheets 02, 03 and on the board. No copper moved. DRC with parity
    unchanged: 11 accepted courtyard overlaps, 0 unconnected.
    [02_pwr_vcore.kicad_sch, 03_pwr_rails.kicad_sch, ti135_card.kicad_pcb]
2026-11-13 Assembly fixes from the pre-order review
    - ads7056 footprint: origin moved to the package centre (it was 4.6 mm
    from the pads, so U1303 would have been placed beside its lands);
    courtyard and fab outline added. Copper unchanged.
    - tools/jlc: bottom-side rotation offset sign fixed (U1304 came out
    180 degrees wrong in the CPL).
    - U401: TPS3808G01DBVR (C19653, oversold) -> TPS3808G01DBVT (C702161).
    [04_pwr_seq.kicad_sch, ti135_card.kicad_pcb]
2026-11-13 tools/jlc -> 7955b00 (rotation fix on the published history); U1303 hand-soldered
    The previous commit pointed the submodule at a commit that was never
    pushed (the jlc-tools remote history had been rewritten).
2026-11-13 Regulators to AP61203 / AP61202, LPDDR4 to the -NMO part
    The five TLV62585 cells become Diodes AP61203Z6-7 (forced PWM: VCORE,
    0V85, 1V1) and AP61202Z6-7 (PFM: 1V8, 3V3), the parts already in stock.
    Same SOT-563, other pinout: the symbol is renumbered, the cell template
    in tools/buck_cell.py is redrawn as the mirror image of the old one, and
    the cells are re-placed within 1.2 mm (tools/ap61_cells.py,
    tools/ap61_layout.sh). Feedback per the data sheet: 200 k top, 33 pF,
    bottom 340 k / 475 k / 243 k / 100 k / 44.2 k. 5V0 feeder reshaped,
    pg_group1 re-routed. U801 is H9HCNNN8KUMLHR-NMO (C51891855).
    DRC with parity: 11 accepted courtyard overlaps, 0 unconnected.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
    [02_pwr_vcore.kicad_sch, 03_pwr_rails.kicad_sch, 08_lpddr4.kicad_sch, ti135_card.kicad_pcb]
2026-11-13 Supervisor to TPS3808G09, MDIO pull-up 1k5, C402 on pg_group1
    From the peripherals review:
    - U401: TPS3808G09DBVR (C24584), fixed 0.84 V threshold; SENSE sits
    directly on VCORE, where the G01 tripped at 0.405 V.
    - R929 (MDIO pull-up): 4k7 -> 1k5 (C25867).
    - C402 100 n from pg_group1 to GND on B.Cu at U331's EN stub: with
    R401 it holds group 2 off for about 2 ms while 5V0 ramps.
    DRC with parity: 11 accepted courtyard overlaps, 0 unconnected.
    [04_pwr_seq.kicad_sch, 09_ethernet.kicad_sch, ti135_card.kicad_pcb]
2026-11-14 Power-copper touch-ups, fiducials, eMMC delay rules
    - 5V0 pour thermal spokes 0.5 mm, via in U901 pin 21, 3V3 feeds
    widened to 0.3 mm, GND via beside C1208
    - fiducials FID1-FID6 (three per side)
    - eMMC net class and per-signal delay rules (target = DS, +-10 ps)
    generated by tools/emmc_delay_rules.py; nets still to be meandered
    - R613/R614 value 10k
    - checklist/status: baseboard fit accepted, no notch
    [06_fpga_config.kicad_sch, ti135_card.kicad_pcb]
2026-11-14 eMMC routing cleanup
    [02_pwr_vcore.kicad_sch, 03_pwr_rails.kicad_sch, 04_pwr_seq.kicad_sch, ti135_card.kicad_pcb]
2026-11-14 DRC cleanup after the eMMC rework, DS shortened
    - C333 moved 0.68 mm off the led0_n via
    - leftover routes and orphaned vias removed (emmc_dat6, flash_io1,
    flash_io3, 1V8/5V0 pull-up vias), jtag_tdi overshoot trimmed
    - eMMC delay rules regenerated (target 522.3 ps); --target option
    [ti135_card.kicad_pcb]
2026-11-14 Flash resistors moved to the FPGA, flash I/O rerouted
    - R623-R627 (33R) and pull-ups R616/R617 placed at the FPGA flash
    balls, R619 at the flash; flash nets rerouted on In2
    - DS routed direct, eMMC delay rules regenerated
    - tools/kicad_mcp.py: shell client for the KiCad MCP server
    - FLASH_REROUTE_BRIEF.md (agent brief), AGENTIC_PCB_ROUTING.md
    [ti135_card.kicad_pcb]
